B0z0dcl0wn/SignalSweep/README.md

<p align="center">
  SignalSweep: the app's Sweep, Survey and Settings tabs on a phone, a drone, a Flock probe and trackers in the live list
</p>

<p align="center">
  <strong>It beeps at the gear that's watching you.</strong><br>
  A pocket counter-surveillance scanner for cameras, body cams, drones, trackers and attack gear.<br>
  It tells you what's near by sound alone. No screen needed, no cloud, nothing to sign up for.
</p>

<p align="center">
  
  
  
</p>

<p align="center">
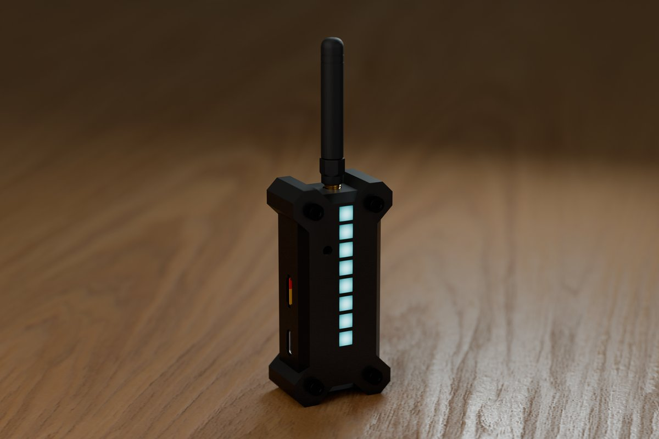
[picture p1: docs/img/hero-render.jpg]
Render of a SignalSweep in its black 3D-printed case standing on end on a wooden table, antenna up, LED bar lit cyan
  <br>
  <sub><b>Hardware</b> you carry · <b>open firmware</b> you flash from a browser · an <b>app</b> if you want one. It beeps without it.<br><i>Render from the production CAD; photos once the first batch is built.</i></sub>
</p>

> **But wait, there's more.** It decodes the drone **and where the pilot is
> standing**. It hunts a tracker by ear, beeping faster as you close in. It
> catches a fake-AirTag spam storm and **stops crying wolf**. It names your
> neighbour's pwnagotchi. And when you want it quiet, it stops advertising
> entirely, so the gear it's hunting can't hunt it back. One small board,
> flashed from a browser tab. No app store, no account, no cloud.

---

## Get one

|  | **SignalSweep** | **SignalSweep Kit** | **Build your own** |
|---|---|---|---|
| **What** | Assembled, flashed and tested, in a 3D-printed case. Plug in USB and go. | Every part plus the printed case. You put it together. | Bring a bare XIAO ESP32-C5. Flash it from your browser. |
| **Inside** | XIAO ESP32-C5, dual-band external antenna, buzzer, LED bar, microSD reader | Same parts, loose | Just the board. Add parts as you go |
| **Price** | $75 | $40 | About $13 for the board |
| **Status** | **[Reserve one](https://signalsweep.net)** | **[Reserve one](https://signalsweep.net)** | **[Available now](#build-your-own)** |

Kits and built units are at **[signalsweep.net](https://signalsweep.net)**: join the waitlist, no money down, US only for now. First batch is small.

## The app

<p align="center">
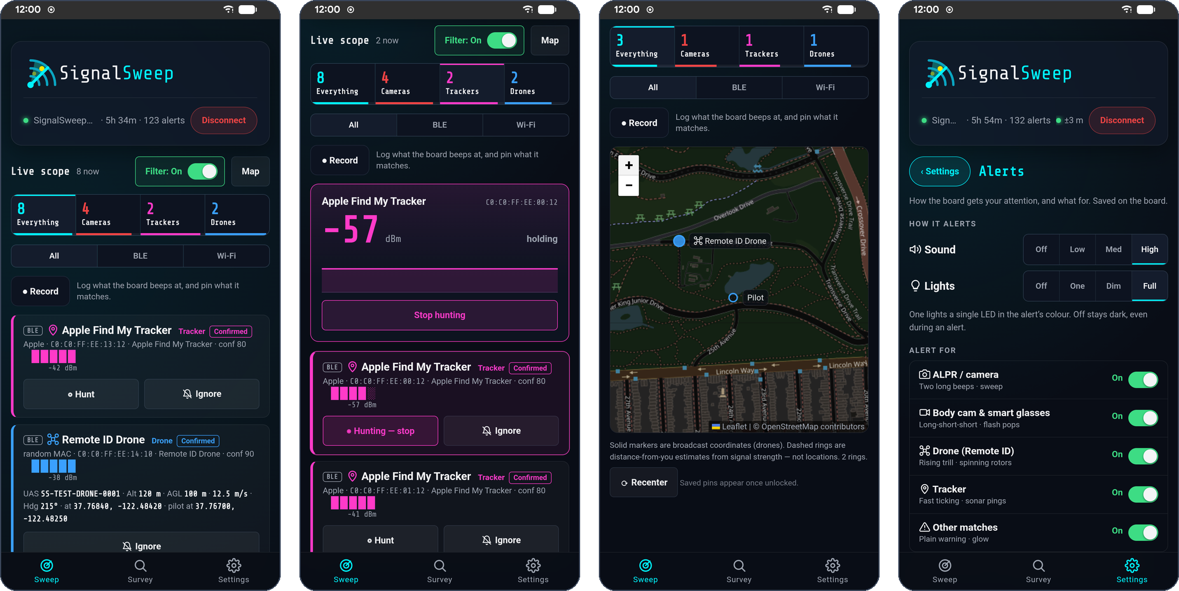
[picture p2: docs/img/strip.png]
The SignalSweep app: live scope, hunting a tracker, a drone and its pilot on the map, and the alert settings
  
</p>
<p align="center"><sub>Live scope · Hunt by ear · Drone + pilot · A sound per threat</sub></p>

One app, two ways to run it:

- **In your browser, nothing to install.** Open the
  **[web app](https://flash.signalsweep.net/app/)** in Chrome or Edge
  on a laptop or desktop and connect over Bluetooth or a USB cable.
- **On Android.** The same app as an APK, over Bluetooth or a USB cable. Grab
  it from [Releases](https://github.com/B0z0dcl0wn/SignalSweep/releases/latest)
  or let `install.py` put it on the phone.

And you don't need either one: the board beeps on its own.

## Getting started

### The fast way: flash it from your browser

<p align="center">
  
</p>

Chrome or Edge, a USB-C cable, one button. It works out which board is
plugged in (C5 or S3) and flashes the matching image. The app runs on the same
site at [`/app/`](https://flash.signalsweep.net/app/) and talks to the
board over Bluetooth, so a laptop needs nothing but the browser.

### The script: board and Android phone

```bash
git clone https://github.com/B0z0dcl0wn/SignalSweep.git
cd SignalSweep
pip install -U esptool pyserial

python install.py              # flash the board and install the app on the phone
python install.py --esp-only   # just the board
python install.py --apk-only   # just the phone
```

It downloads the latest release, checks every file's hash, asks which device if
more than one is plugged in, and makes you type the target's name back before
it writes a byte. The phone needs `adb` and USB debugging on. `--erase` wipes the board's saved settings
first, and `--help` has the rest.

## Hear it, don't read it

Every threat category has its own sound and its own light pattern, so the
device works face-down in a cupholder, a backpack or a jacket pocket.

| You hear | It means |
|---|---|
| 📷 Two long beeps | ALPR or camera |
| 🎥 Long, short, short | Body cam or smart glasses |
| 🛸 Rising trill | Drone broadcasting Remote ID |
| 📍 Fast ticking | Tracker: AirTag, Tile, SmartTag |

Mute any category you don't care about. It's still detected and listed, just quiet.

## What it does

**Detects**
- **Drones, in full.** ASTM F3411 Remote ID over Bluetooth, Wi-Fi beacons and Wi-Fi NAN: ID, altitude, speed, heading, and where the pilot is standing. Often before you hear the props.
- **Trackers.** Apple Find My, Google, Samsung and Tile. And when someone floods the area with fake ones, one row says what's going on. Tracker beeps are off out of the box, because in a crowd every passing AirTag sets it off. Turn them on in Settings > Alerts, and they stay on through a flood, because a real one hiding in the storm matters more than the noise.
- **Surveillance hardware.** Flock Safety gear when it's talking, Axon body cams, smart glasses, and anything else on a signature list you can edit from the app: OUI, company ID, name, service UUID or SSID. No recompile.
- **Cop-only gear, on sight.** Axon, Flock, SoundThinking (ShotSpotter), Genetec, Neology, WatchGuard Video and Digital Ally addresses beep on their own. Nobody but an agency buys that hardware, so hearing it is the news.
- **Attack gear** (opt-in). BLE popup spam, deauth bursts, Pineapple-style karma, Flipper Zero hints, and pwnagotchis by name.

**Built for the field**
- **Runs headless.** Battery bank, car USB port, or a phone on a cable. It scans and beeps with nothing connected.
- **Survives the plug-pull.** Mute, categories, hunt target, filter, name and rules all come back after a power cut. Yanking the cable is how you're supposed to use it.
- **Hunts by ear.** Lock one device and walk it down. The beeps speed up as you close in. Keyfob tags that advertise an alert service can be made to ring; the button only appears on those. (AirTags can't be rung by anything but their owner's phone.)
- **Both bands.** The C5 sweeps 2.4 and 5 GHz Wi-Fi, where a growing share of cameras and access points live. Every Wi-Fi row shows its band and channel, and a dual-band router is one row, not four.
- **Site Survey.** Park next to something suspicious, capture the raw air, and the app pulls out its signature. Snap a photo, and it's logged to an encrypted finds database you can export for DeFlock.
- **Ignore the neighbours.** Something you own keeps setting it off? Ignore that one device (fixed addresses only, up to 16). It stays listed, it just stops beeping, and the board remembers through a power cut.
- **Keeps a log.** What it beeped at and when, on its own flash and the SD card if one's fitted, for a drive with no phone along. You can turn it off. Never where.
- **Lights on your terms.** Off, one LED or the whole bar, three brightness levels and five themes, so a parked car doesn't glow like a beacon.

**Private by design**
- **Keeps its mouth shut.** Receive-only stops its Bluetooth advertising, so it isn't announcing itself to the gear it's hunting. It keeps listening and beeping.
- **No trail.** The app shows what's here right now and forgets it when you disconnect. Vendor names are looked up offline; no MAC ever leaves your phone.
- **Pins only when you say yes.** One device at a time, AES-GCM encrypted behind a PIN. Off by default, and detection never asks for the PIN.

## The full build

| Part | What you get |
|---|---|
| **Board** | Seeed Studio XIAO ESP32-C5 |
| **Radios** | Bluetooth LE + dual-band Wi-Fi (2.4 and 5 GHz), swept together, nonstop |
| **Antenna** | External dual-band, U.FL |
| **Alerts** | Passive buzzer (four patterns, three volumes) and an addressable LED bar |
| **Storage** | microSD for session logs and packet captures, plus an alert log on the board itself |
| **Power** | USB-C: a phone, a car port or any battery bank |
| **App** | Android (APK), or Chrome / Edge on a desktop |
| **Firmware** | Open source, GPL-3.0. Flashed and updated from a browser tab |

## What it won't do

> The only winning move is not to transmit.

No jamming. No deauth. No packet injection. No advert spoofing. No arbitrary
GATT writes. It's a receiver. Ringing a tracker is one fixed Immediate Alert
write, and its only parameter is a MAC.

No cloud, no telemetry, no accounts. The app keeps no history: what's in range
shows up, and it's wiped when you disconnect. The board logs what it beeped at
only if you switch that on, and never where. The one location anything keeps is
a pin you say yes to.

Listening to radio is legal in most places. Transmitting usually isn't, and this
barely does: a Bluetooth advert you can switch off, the scan requests that ask
nearby devices for their names, and the one write when you press Ring. Your
local law isn't everyone's. Go and read it.

---

## Build your own

### The shopping list

| Board | Hears | Price | How you flash it |
|---|---|---|---|
| Seeed Studio XIAO ESP32-C5 | 2.4 **and** 5 GHz | — | Web flasher, `install.py`, or source |
| [Seeed Studio XIAO ESP32-S3](https://www.seeedstudio.com/XIAO-ESP32S3-p-5627.html) | 2.4 GHz | ~$15 | Web flasher, `install.py`, or source |

Plus a USB-C cable. Both boards run the same detector and the same app; the C5
also sweeps the 5 GHz band, where a growing share of cameras and access points
live, and it can be told to watch one band or both.

Optional, and worth it: a **passive buzzer** and a **WS2812 LED bar** (it beeps
and blinks without them only if something else is listening). On the C5, use a
**dual-band U.FL antenna** so it hears 5 GHz as well as 2.4.
The C5 ships tuned to US Wi-Fi channels; elsewhere it still works, it just
skips channels 12–13.

Then flash it the same way as everyone else: see [Getting started](#getting-started).

## Getting your data off

The SD card stays in the case. Pull it over the cable instead: plug in, open the
[data pull page](https://flash.signalsweep.net/pull.html), hit
**Export**, pick a folder. You get `alerts.txt` (what it beeped at, readable),
`report.html` (the same, sortable), a `.pcap` per capture for Wireshark, and the
untouched originals in `raw/`. The page is one file, and its security policy
blocks all network access, so nothing leaves your machine. Don't trust hosted
pages? Same folder, no browser:

```bash
pip install pyserial
python pull.py              # same export into ./SignalSweep-<time>/
python pull.py --wipe       # then delete what copied intact (asks first)
python pull.py --phone      # also grab the app's files off the phone over adb
```

## Hardware and controls

The bare board works. A **passive buzzer** and a **WS2812 LED bar** are
add-ons — neither is required. Add a
**microSD card** and you get a richer session log (names, SSIDs, channels) and
captures started from the app over Bluetooth, no cable needed. Parts, pads
and pictures are in the **[Wiring Guide](firmware/WIRING.md)** and the
illustrated `firmware/wiring-diagram.html` page (one page, both boards).

| BOOT button | What it does |
|---|---|
| **Quick tap** | Gone quiet? Advertises for two minutes so the app can connect, then goes dark again. |
| **Hold 5 s** | Factory reset: settings and signatures wiped, then a reboot. Let go early to abort. |

## Contributing

SignalSweep is only as good as its signature list. Spotted a tracker, body cam
or ALPR it misses? Send a PR. See [CONTRIBUTING.md](CONTRIBUTING.md).

The deep end (threat model, serial protocol, building from source, and why
everything is the way it is) lives in
**[docs/README-full.md](docs/README-full.md)** and [CHANGELOG.md](CHANGELOG.md).

## Credits

- **[Colonel Panic](https://colonelpanic.tech)**: the
  [OUI Spy Unified Blue](https://github.com/colonelpanichacks/oui-spy-unified-blue)
  concept this hardware approach came from.
- **[OrdoOuroborous / @NitekryDPaul](https://github.com/nitekry)**: the Flock
  Safety OUI research the camera detection runs on.

Everyone else is in [CREDITS.md](CREDITS.md).

GPL-3.0-or-later. See [LICENSE](LICENSE). Some vendored components are Apache-2.0.

*Hack the planet.*
