B0z0dcl0wn/SignalSweep/docs/img/hero-pumpkin.jpg

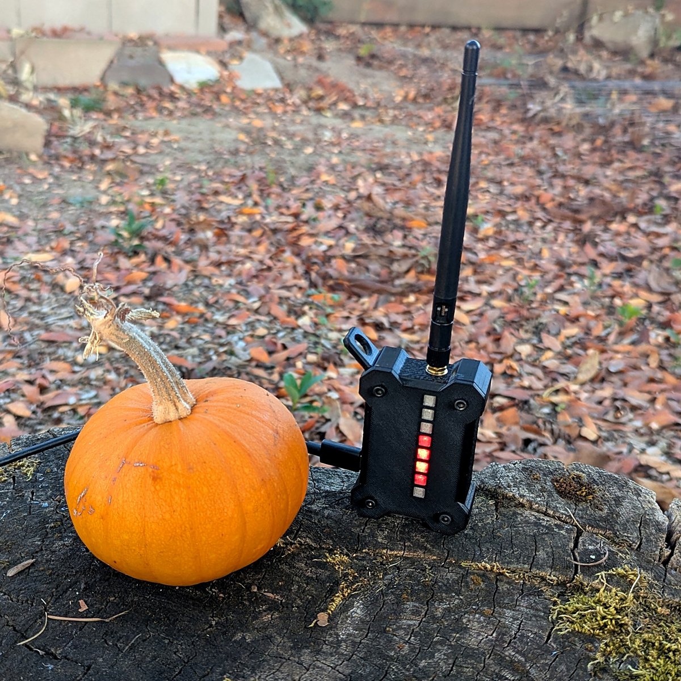
docs/img/hero-pumpkin.jpg
