B0z0dcl0wn/SignalSweep/hardware/case-v3/case-main.stl

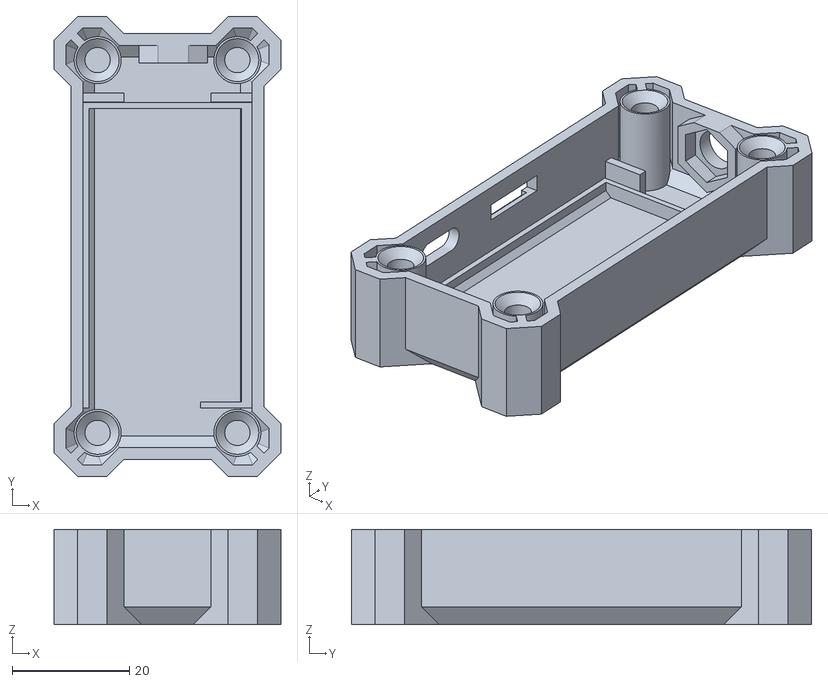
[picture p4: CAD file, 2026-11-04]
hardware/case-v3/case-main.stl
38.7 x 78.4 x 16.2
