B0z0dcl0wn/SignalSweep/hardware/case-v3/case-diffuser-57.stl

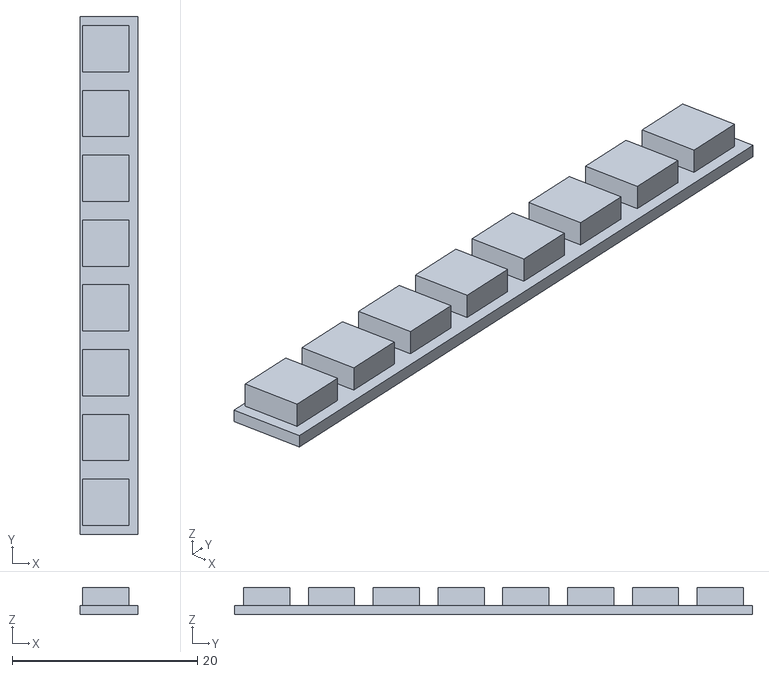
[picture p5: CAD file, 2026-11-13]
hardware/case-v3/case-diffuser-57.stl
6.30 x 56.0 x 2.95
