B0z0dcl0wn/SignalSweep/hardware/case-v3/case-lid-54.stl

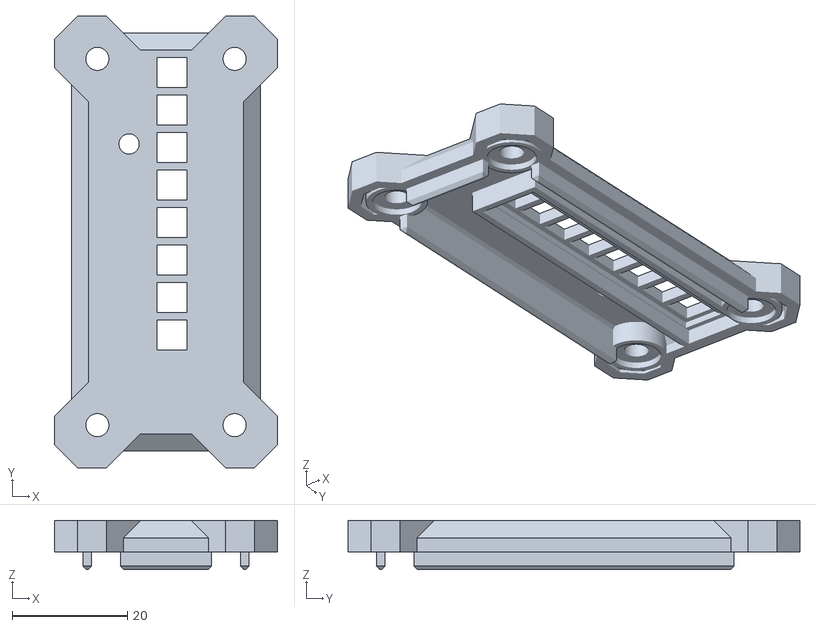
[picture p6: CAD file, 2026-11-13]
hardware/case-v3/case-lid-54.stl
38.7 x 78.4 x 8.50
