B0z0dcl0wn/SignalSweep/hardware/case-v1/Base.stl

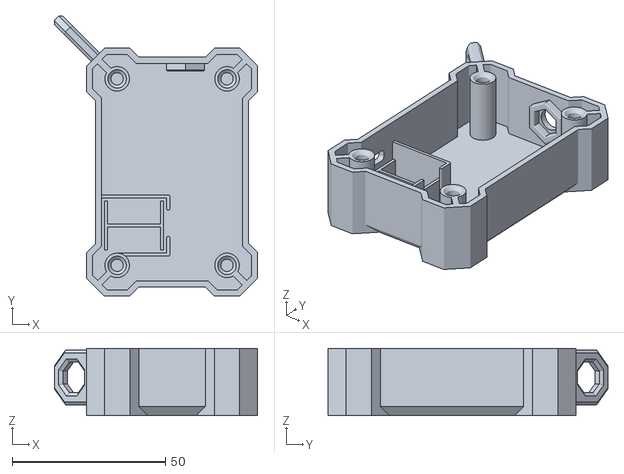
[picture p8: CAD file, 2026-10-17, an earlier design]
hardware/case-v1/Base.stl
66.4 x 91.4 x 22.0
