B0z0dcl0wn/SignalSweep/hardware/case-v1/LED Diffuser.stl

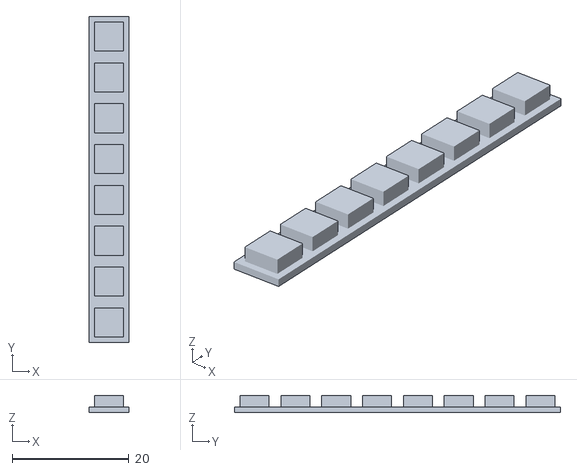
[picture p9: CAD file, 2026-10-17, an earlier design]
hardware/case-v1/LED Diffuser.stl
6.90 x 55.9 x 3.00
