B0z0dcl0wn/SignalSweep/hardware/case-v1/Lid.stl

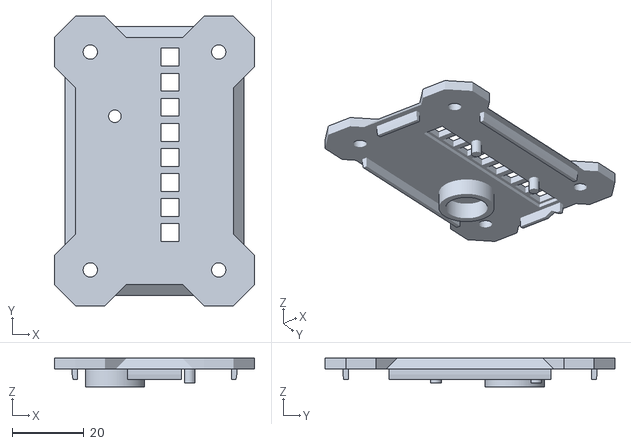
[picture p10: CAD file, 2026-10-17, an earlier design]
hardware/case-v1/Lid.stl
55.9 x 80.9 x 8.00
