B0z0dcl0wn/SignalSweep/firmware/wiring-diagram.html

SignalSweep · Hardware

# Wiring the detector

All you need is the board. A bare XIAO ESP32-S3 or ESP32-C5 with its U.FL antenna is a working detector: plug it into USB, connect the app, and it streams everything it hears. The buzzer, the LED bar and the microSD reader are optional add-ons. Both boards use the same pads and the same harness; only the GPIO numbers underneath differ, and the pin map lists both.

Seeed XIAO ESP32-S3 / ESP32-C5 · LED D1 · Buzzer D2 · microSD CS D3, MOSI D10, CLK D8, MISO D9

## Parts

Part | Needed? | What it adds | Without it
XIAO ESP32-S3 or ESP32-C5 + U.FL antenna (C5: dual-band) | REQUIRED | the detector | —
Passive buzzer | OPTIONAL | the headless "what is near" beep patterns, and Hunt's beeps | phone only
WS2812 8-LED bar | OPTIONAL | colour/animation per category, the hunt meter | phone only
microSD reader (3.3 V, 6 pins, no regulator) | OPTIONAL | a session log per boot and Site Survey captures on a card, started from the app | —
XIAO ESP32-C5 instead of the S3 | OPTIONAL | hears 5 GHz Wi-Fi too (same harness) | 2.4 GHz only

## Schematic

### Reading your board D# = GPIO#

- Seeed silk-screens the pads D0–D10; the firmware names the same pads by GPIO number. Wire by pad name and one harness fits both the S3 and the C5. The pin map below gives each pad's GPIO on both boards.
- One long edge has D0–D6; the other has 5V, GND, 3V3, D10, D9, D8, D7, with the power group next to the USB. The pad printed VUSB on the underside is the same 5V.

← scroll the drawing sideways →

Top view, USB-C up. Each XIAO pad carries one wire. Ground goes to the LED bar first; the buzzer − shares that bar pad, and the SD reader's ground comes off the bar's other GND pad. The SD reader's pins are drawn in the order printed on it.

5V · red5V pad → bar VCC

GND · blackXIAO → bar GND → SD GND

3V3 · white3V3 pad → SD 3v3 only

LED DATA · yellowD1 → bar IN

BUZZER · greenD2 → buzzer +

SD CS · blueD3 → SD CS

MOSI · yellowD10 → SD MOSI

CLK · greenD8 → SD CLK

MISO · blueSD MISO → D9

### ⚠ microSD reader: 3.3 V ONLY

Never connect this board to 5V. It has no regulator, and 5V can kill the card. Its 3v3 pin goes to the XIAO's 3V3 pad and nothing else.

## Power and ground

GND XIAO GND→bar GND pad 1═bar GND pad 2→SD GND The buzzer − also goes on bar GND pad 1, next to the wire from the XIAO. A bar pad is big enough for two wires; a XIAO pad is not. This assumes the common 4-pad bar (GND, IN, VCC, GND), whose two GND pads are joined on the bar. A 3-pad bar has one GND pad, which would need all three ground wires. No bar at all? Splice the buzzer − and SD GND wires together (solder + heat-shrink) and run one wire from the splice to the XIAO GND pad.

3V3 XIAO 3V3→SD 3v3 One wire. The SD reader is the only thing on 3V3.

5V XIAO 5V→LED bar VCC One wire. The LED bar is the only thing on 5V. Nothing on the SD reader goes to 5V.

→a wire you add═already joined inside the part. Skip any part you don't have.

## Pin map

XIAO pad | S3 | C5 | Net | Goes to | Part
D1 | GPIO2 | GPIO0 | Data | LED bar DIN (IN) | LED bar
D2 | GPIO3 | GPIO25 | Signal | buzzer + | buzzer
D3 | GPIO4 | GPIO7 | SPI chip select | SD CS | SD reader
D8 | GPIO7 | GPIO8 | SPI clock | SD CLK | SD reader
D9 | GPIO8 | GPIO9 | SPI MISO | from SD MISO (data into the XIAO) | SD reader
D10 | GPIO9 | GPIO10 | SPI MOSI | SD MOSI | SD reader
5V VUSB | — | — | Power | LED bar VCC | power
3V3 | — | — | Power | SD 3v3, the only 3V3 load | power
GND | — | — | Ground | LED bar GND pad 1 (buzzer − and SD GND continue from the bar) | power
BOOT | GPIO0 | GPIO28 | built in | tap = 2-minute advertising window · hold 5 s = factory reset | on the board

## Assembly

1. One wire per XIAO pad. The XIAO's holes are tiny: two wires shoved into one is how a joint cracks. So each XIAO pad gets exactly one wire. Where two wires have to meet (ground), they meet on a bigger LED-bar pad, never on the XIAO. Skip any part you don't have.
2. Antenna. Press the U.FL antenna onto the XIAO's small antenna socket until it clicks. No soldering. C5: use a dual-band antenna; the stock 2.4 GHz one throws away the 5 GHz the C5 is for.
3. LED bar (optional). Wire the IN end: the little arrows printed on the bar point away from it.
  - LED bar pad VCC → XIAO pad 5V
  - LED bar GND pad 1 (the GND beside IN) → XIAO pad GND
  - LED bar pad IN → XIAO pad D1.
4. Buzzer (optional). A small passive buzzer (<30 mA) runs straight off the pin.
  - Buzzer + → XIAO pad D2
  - Buzzer − → LED bar GND pad 1, next to the XIAO's ground wire (a bar pad takes two wires).
5. SD reader power (optional). 3.3 V ONLY. Never connect this board to 5V: it has no regulator and 5V can kill the card.
  - SD reader pin 3v3 → XIAO pad 3V3 (not 5V)
  - SD reader pin GND → LED bar GND pad 2 (the GND at the far end, beside VCC).
6. SD reader data (optional). Four wires, each to its own XIAO pad. Match by the label printed on the reader.
  - SD reader pin CS → XIAO pad D3
  - SD reader pin MOSI → XIAO pad D10
  - SD reader pin CLK → XIAO pad D8
  - SD reader pin MISO → XIAO pad D9: data comes back from the card on this one

Format the card FAT32; the board keeps its files in /SIGSWEEP/.

7. Check before you power it. Nothing on the SD reader touches 5V: follow its 3v3 wire and make sure it ends on the XIAO's 3V3 pad. Then count: one wire in each XIAO pad, and no stray strands bridging two pads.
8. Verify. Flash from the web flasher, or python flash.py --port COM3 (C5: python flash.py --board c5 --port COM5). On boot you get a short jingle and an LED blink (if fitted). Connect the app: Settings › Device identity › Clock shows the phone synced the time. Then trigger a match (an AirTag near it, or edit a signature): the bar flashes and the buzzer plays that category's pattern — ALPR / camera two long beeps, body cam long-short-short, drone a rising trill, tracker fast ticking.

## Watch for

### Power budget ≈480 mA

- 8× WS2812 at full white peaks near 480 mA. SignalSweep only flashes short colored bursts, so USB 5V is fine.
- An SD card adds a few mA idle and roughly 100 mA peaks on writes, all from the XIAO's 3V3. On a weak battery, budget for that.

### Gotchas clones

- SD reader on 5V kills the card. This reader has no regulator: 3V3 only.
- Other SD readers put their pins in a different order, and some want 5V (they have a regulator on board). The drawing is for the 6-pin 3v3, CS, MOSI, CLK, MISO, GND reader; with any other, match by label and check its power pin's marking.
- 3.3 V data into a 5 V-powered clone bar works over the short run to the bar. Keep the DIN wire short.
- Wrong end (wiring DOUT) lights nothing — flip to DIN.
- Active buzzer = one fixed pitch: you'll hear each pattern's rhythm but not its tones. Passive is the intended part.
- Two wires in one XIAO pad is how a joint cracks. Double up on a bar pad instead.
- C5: boots fine with the buzzer on D2. GPIO25 is sampled at power-up, but a passive buzzer straight to GND does not stop the XIAO C5 booting (bench-checked 2026-09-16 with the LED bar and buzzer wired as shown).
