B0z0dcl0wn/SignalSweep/firmware/wiring-diagram-c5.html

SignalSweep · Hardware

# Wiring the C5 detector

All you need is the board. A bare XIAO ESP32-C5 with its dual-band U.FL antenna is a working detector: plug it into USB, connect the app, and it streams everything it hears. The buzzer, the LED bar and the microSD reader are optional add-ons. The microSD wiring is final, but firmware support is coming: the board does not use the card yet.

Seeed XIAO ESP32-C5 · LED D1 / GPIO0 · Buzzer D2 / GPIO25 · microSD CS D3, MOSI D10, CLK D8, MISO D9

## Parts

Part | Needed? | What it adds | Without it
XIAO ESP32-C5 + dual-band U.FL antenna | REQUIRED | the detector | —
Passive buzzer | OPTIONAL | the headless "what is near" beep patterns, and Hunt's beeps | phone only
WS2812 8-LED bar | OPTIONAL | colour/animation per category, the hunt meter | phone only
microSD reader (3.3 V, 6 pins, no regulator) | OPTIONAL FIRMWARE SUPPORT COMING | (coming) alert log and Site Survey captures on a card | —
DS3231 clock module | OPTIONAL | not fitted on this build | the phone or PC sets the time at each connect

## Schematic

### Reading your board D# = GPIO#

- Seeed silk-screens the pads D0–D10; the firmware names the same pads by GPIO number. Wire by pad name and one harness fits both the S3 and the C5. On this board: D1 = GPIO0, D2 = GPIO25, D3 = GPIO7, D4 = GPIO23, D5 = GPIO24, D8 = GPIO8, D9 = GPIO9, D10 = GPIO10.
- One long edge has D0–D6; the other has 5V, GND, 3V3, D10, D9, D8, D7, with the power group next to the USB. The pad printed VUSB on the underside is the same 5V.

← scroll the drawing sideways →

Top view, USB-C up. Each XIAO pad carries one wire. Ground goes to the LED bar first; the buzzer − shares that bar pad, and the SD reader's ground comes off the bar's other GND pad. The SD reader's pins are drawn in the order printed on it.

5V5V pad → bar VCC

GNDXIAO → bar GND → SD GND

3V33V3 pad → SD 3v3 only

DATAD1 → bar IN

BUZZERD2 → buzzer +

CSD3 → SD CS

SPID10 → MOSI · D8 → CLK · MISO → D9

### ⚠ microSD reader: 3.3 V ONLY

Never connect this board to 5V. It has no regulator, and 5V can kill the card. Its 3v3 pin goes to the XIAO's 3V3 pad and nothing else.

### Optional clock (DS3231), not fitted parked

The phone or PC sets the time on every connect, which dates the log. D4 (SDA) / D5 (SCL) are reserved for it; leave them empty. See WIRING.md.

## Power and ground

GND XIAO GND→bar GND pad 1═bar GND pad 2→SD GND The buzzer − also goes on bar GND pad 1, next to the wire from the XIAO. A bar pad is big enough for two wires; a XIAO pad is not. This assumes the common 4-pad bar (GND, IN, VCC, GND), whose two GND pads are joined on the bar. A 3-pad bar has one GND pad, which would need all three ground wires. No bar at all? Splice the buzzer − and SD GND wires together (solder + heat-shrink) and run one wire from the splice to the XIAO GND pad.

3V3 XIAO 3V3→SD 3v3 One wire. The SD reader is the only thing on 3V3.

5V XIAO 5V→LED bar VCC One wire. The LED bar is the only thing on 5V. Nothing on the SD reader goes to 5V.

→a wire you add═already joined inside the part. Skip any part you don't have.

## Pin map

XIAO pad | Net | Goes to | Part
D1 GPIO0 | Data | LED bar DIN (IN) | LED bar
D2 GPIO25 | Signal | buzzer + | buzzer
D3 GPIO7 | SPI chip select | SD CS | SD reader
D4 GPIO23 | (I²C SDA) | nothing: reserved for the clock | not fitted
D5 GPIO24 | (I²C SCL) | nothing: reserved for the clock | not fitted
D8 GPIO8 | SPI clock | SD CLK | SD reader
D9 GPIO9 | SPI MISO | from SD MISO (data into the XIAO) | SD reader
D10 GPIO10 | SPI MOSI | SD MOSI | SD reader
5V VUSB | Power | LED bar VCC | power
3V3 | Power | SD 3v3, the only 3V3 load | power
GND | Ground | LED bar GND pad 1 (buzzer − and SD GND continue from the bar) | power
BOOT GPIO28 | built in | tap = 2-minute advertising window · hold 5 s = factory reset | on the board

## Assembly

1. One wire per XIAO pad. The XIAO's holes are tiny: two wires shoved into one is how a joint cracks. So each XIAO pad gets exactly one wire. Where two wires have to meet (ground), they meet on a bigger LED-bar pad, never on the XIAO. Skip any part you don't have.
2. Antenna. Swap the stock 2.4 GHz antenna for a dual-band U.FL one and press it onto the XIAO's antenna socket until it clicks. The C5's whole point is 5 GHz; the one in the box throws it away.
3. LED bar (optional). Wire the IN end: the little arrows printed on the bar point away from it.
  - LED bar pad VCC → XIAO pad 5V
  - LED bar GND pad 1 (the GND beside IN) → XIAO pad GND
  - LED bar pad IN → XIAO pad D1 (GPIO0). Optional: a 330–470 Ω resistor in this wire, right at the bar.
4. Buzzer (optional). A small passive buzzer (<30 mA) runs straight off the pin.
  - Buzzer + → XIAO pad D2 (GPIO25)
  - Buzzer − → LED bar GND pad 1, next to the XIAO's ground wire (a bar pad takes two wires).
5. SD reader power (optional). 3.3 V ONLY. Never connect this board to 5V: it has no regulator and 5V can kill the card.
  - SD reader pin 3v3 → XIAO pad 3V3 (not 5V)
  - SD reader pin GND → LED bar GND pad 2 (the GND at the far end, beside VCC).
6. SD reader data (optional). Four wires, each to its own XIAO pad. Match by the label printed on the reader.
  - SD reader pin CS → XIAO pad D3 (GPIO7)
  - SD reader pin MOSI → XIAO pad D10 (GPIO10)
  - SD reader pin CLK → XIAO pad D8 (GPIO8)
  - SD reader pin MISO → XIAO pad D9 (GPIO9): data comes back from the card on this one

The wiring is final; the firmware does not drive the card yet (support is coming), so a card in the slot does nothing for now. On the C5: if it won't start with the SD reader connected, unplug the CS wire (D3), power up, and tell us.

7. Check before you power it. Nothing on the SD reader touches 5V: follow its 3v3 wire and make sure it ends on the XIAO's 3V3 pad. Then count: one wire in each XIAO pad, no stray strands bridging two pads, and D4 / D5 left empty.
8. Verify. Flash from the web flasher, or python flash.py --board c5 --port COM5. On boot you get a short jingle and an LED blink (if fitted). With no clock fitted the serial log says [RTC] none fitted, waiting for a host, which is expected. Connect the app: Settings › Device identity › Clock shows the phone synced the time. Then trigger a match (an AirTag near it, or edit a signature): the bar flashes and the buzzer plays that category's pattern — ALPR / camera two long beeps, body cam long-short-short, drone a rising trill, tracker fast ticking. BOOT (GPIO28) is the onboard button: tap for a 2-minute advertising window, hold 5 s to factory-reset.

## Watch for

### Power budget ≈480 mA

- 8× WS2812 at full white peaks near 480 mA. SignalSweep only flashes short colored bursts, so USB 5V is fine.
- Add a 1000 µF cap across the bar's 5V↔GND to absorb inrush when all eight snap on.
- An SD card adds a few mA idle and roughly 100 mA peaks on writes, all from the XIAO's 3V3. On a weak battery, budget for that.

### Gotchas clones

- SD reader on 5V kills the card. This reader has no regulator: 3V3 only.
- Other SD readers put their pins in a different order, and some want 5V (they have a regulator on board). The drawing is for the 6-pin 3v3, CS, MOSI, CLK, MISO, GND reader; with any other, match by label and check its power pin's marking.
- 3.3 V data into a 5 V-powered clone bar usually works; if LED 1 flickers, add the 330–470 Ω series resistor at DIN.
- Wrong end (wiring DOUT) lights nothing — flip to DIN.
- Active buzzer = one fixed pitch: you'll hear each pattern's rhythm but not its tones. Passive is the intended part.
- Two wires in one XIAO pad is how a joint cracks. Double up on a bar pad instead.
- Boots fine with the buzzer on D2. GPIO25 is sampled at power-up, but a passive buzzer straight to GND does not stop the XIAO C5 booting (bench-checked 2026-09-16 with the LED bar and buzzer wired as shown). If a different buzzer ever does, feed it through a small NPN transistor or a 100 Ω+ series resistor.
- D3 (GPIO7) and the SD reader: not bench-checked yet. GPIO7 may be sampled at boot, and nobody has booted a C5 with the SD reader wired yet. If the C5 won't start with the SD reader connected, unplug the CS wire (D3), power up, and tell us.
