B0z0dcl0wn/SignalSweep/CHANGELOG.md

# Changelog

All notable changes to SignalSweep are recorded here.

## [Unreleased]

## [0.12.0] — 2026-11-12 — Dimmer switch

### Changed -- Signatures v23: a smartwatch is not a TASER, and fe6c needs a serial

From the 2026-11-09 upstream scan. Boards pick the new rules up on their next
boot.

**Fixes**

- **TASER company ID `0x034D` no longer flags cheap smartwatches.** IDO /
  VeryFit watches (IDW26, ID205...) send `0x034D` with their own address as the
  first six payload bytes, plus service `0x0AF0`, and the rule beeped at 70 on
  the ID alone. The matcher now drops a `0x034D` hit when the payload repeats
  the advertiser's address and the watch's `0x0AF0` service or an
  `ID<digits>` model name is present. Everything else keeps the 70. The check
  is a port of RF Sentinel's `isTaserIdSquatter()` (CIS-C0/RFSentinel 843c738,
  `SignatureEngine.kt:195-229`, GPL-3.0). It lives in `firmware/src/axon_checks.h`
  and is host-tested with their `DetectionTest.kt:56` watch ("IDW26" at
  `F4:FD:16:03:54:5B`) in `firmware/test/axon_checks_test.cpp`, which
  `selftest.js` runs. Because the check sits in the matcher, it also covers a
  pushed `0x034D` rule.
- **Axon `fe6c` beeps only on a serial.** "Axon Signal System" beeped on the bare
  UUID, which any phone app can advertise. The bare UUID now lists at 60, as
  "Axon service UUID (fe6c)". Only `fe6c` service data that carries an ASCII
  serial (a run of six or more uppercase letters and digits, the Signal trigger
  layout) beeps, as "Axon Signal trigger (fe6c serial)" at 70. AxonCadabra
  replays one captured trigger byte for byte, serial `X87002FP4`, so that serial
  is excluded explicitly: no Axon rule names it. With Attack on, it is reported
  as Hacking gear, "AxonCadabra (replayed Axon Signal)". The payload layout and
  the replay serial come from OVERWATCH (KaraZajac/OVERWATCH, BSD-3,
  `AxonSignatures.kt` and `HackerTargets.kt`).
- **`90:3A:E6` is Parrot, not ASTM.** The Wi-Fi Remote ID comment had the two
  OUIs backwards. `FA:0B:BC` is the ASD-STAN / ASTM OUI (as `odid_wifi.c`
  says), and `90:3A:E6` is Parrot's MA-L. The Parrot branch now also requires
  the Remote ID vendor type `0x0D`, so an unrelated Parrot vendor IE no longer
  scores as a drone. The Remote ID entry further down this file is corrected
  to match.

**Added**

- **Raven** `3101` and `3102` join the exact-match Raven UUID list at 60 (RF
  Sentinel 843c738 `SignatureEngine.kt:73`, GPL-3.0, crediting an
  all-cameras-are-beacons field capture).

**Reviewed and not added.** RF Sentinel ships about 110 more MAC prefixes we
lack: ALPR makers (Tattile, Quercus, Selea, Vitronic, Robot), police in-car
video, TETRA / P25 makers, tactical mesh radios, fleet gear, and more blocks
for vendors we already list. Every sub-block was re-checked against the IEEE
`mam.csv`, `oui36.csv` and `iab.csv`, and every one is registered to the vendor
it names. That proves who owns the block, not that the gear transmits Wi-Fi or
BLE, or that anyone has heard it. None has a field sighting. RF Sentinel itself
tags many of them "candidate". Most of the hardware is wired, or talks on its
own radio band, and Tattile alone is 48 blocks, several from the 1990s. A rule
set 60% larger, matched against every advert, for rules that would likely never
fire is the wrong trade, and a registry entry is not a detection. Any of them
can come back with a sighting.

Also not in v23: the Axon Fleet `axon<n>-5g` SSID and Meta `0x058E` +
`META_RB_GLASS` (both wait for a field capture); Cellebrite, GrayKey and
IMSI-catcher makers (skipped); the DJI DroneID IE `26:37:12`, the French
`6A:5C:35` beacon and the GhostLink BLE UUID (planned for v24).

**Bench-proven over the air** on the C5, from a Kali Pi sending crafted raw
HCI adverts and injected beacons, each case on its own address so a ratcheted
rule name can't leak between cases. Checked against the board's own alert log,
not just the counter. All ten came out as intended: the IDO-watch squatter
lists with no rule and logs nothing, while the same own-address payload without
a watch tell still beeps at 70 (the tell is load-bearing). A bare `fe6c` lists at
60, a serial beeps (100, Confirmed), and `X87002FP4` is silent with Attack off
and Hacking gear with it on. Parrot `90:3A:E6` decodes as a drone with type
`0x0D` and lists as nothing with `0x0E`, and the ASTM `FA:0B:BC` control still
decodes. Pushes stayed at 74 in 75 s.

### Changed -- Case v3 lids are named by LED stick length

- **`case-lid.stl` and `case-diffuser.stl` are now `case-lid-54` and
  `case-diffuser-54`, and a `-57` pair joins them.** Generic 8-LED WS2812
  sticks have no standard outline: three batches gave three boards (57 x 10.5
  at 7 mm pitch, 54 x 10 at 6.5 mm, and now 57.25 x 10.5 at 7 mm with the LEDs
  2.75 mm from the edge). Measure the stick you have and print the lid and
  diffuser that match its length; `case-main.stl` is unchanged (byte for byte)
  and takes either lid. A single lid for both was rejected because it would
  cost the diffuser its separator bars. The 57 pocket is 0.2 mm tighter than
  the 54's, after a jig printed with the 54's gaps came out loose on that stick.
  On the 57 the LEDs sit so close to the board edge that the diffuser's base
  is trimmed on that side (2.8 mm from the LED line, not 3.5) and the lid's
  slot stops flush with the pocket wall: the diffuser drops in through the
  stick pocket, and a full-width slot there would be an undercut that traps it.
- **The tube under the lid's buzzer hole is gone from both lids.** It made no
  audible difference; the hole through the top skin stays.

### Added -- The v3 case STLs

- **`hardware/case-v3/`** ships the printable case for the carrier v3 board
  (main body, lid, clear LED diffuser), next to the v1 case. Only the three
  STLs are published; the parametric source stays local. The body's corner
  posts take M3 heat-set inserts in a 4.3 mm bore, 10 mm deep, which seats them
  straight; close the lid with M3x10 screws (an M3x8 bites only ~2.5 mm). Print
  the lid top-down so it needs no supports. A short tube under the lid carries
  the buzzer to its hole, and the microSD slot is 2.8 mm tall so a card comes
  out by fingernail.

### Added -- Signatures v22: Fusus, a second Cradlepoint block, Luxottica Tristar

From the 2026-11-02 upstream review, every prefix checked against the IEEE
registry.

- **Fusus** `84:b3:86:5` and `7c:83:34:4` beep at 70 and sit under the Cameras
  tab. Fusus hubs feed real-time crime centers and no consumer owns one, the
  same test as Axon and SoundThinking. From OVERWATCH, which notes these are
  registry entries with no field sighting yet. Both are MA-M sub-blocks, so
  they match on nine hex digits only: the rest of each /24 belongs to others.
- **Cradlepoint** `00:e0:1c`, the second block registered to CradlePoint (via
  ouispy-detector), at the same weight as `00:30:44`.
- **Luxottica Tristar** `80:aa:1c` and `38:47:12`, the factory behind Ray-Ban /
  Oakley Meta glasses (via ouispy-detector), list at 60 under Smart glasses.
  The address proves the maker, not the product, so the rule says "device".

### Changed -- Brightness is its own setting

Lights was Off / One / Dim / Full, so how bright the bar was came bundled with
how much of it lit. Lights is now Off / One / Bar, and Brightness is a separate
row: Low (8/255, the old Dim), Med (20) and High (50, the old Full). Brightness
applies to every Lights option, One included; Night Ops still holds the bar at
Low, except under One. Because One now follows brightness, an old app that
picks Dim and then One gets a dim single LED, which it has no way to show.
With Night Ops and Lights on Bar, the note under Theme says the bar is held at
Low (at Dim on firmware with no `bri`), and on firmware with no `bri` the Lights
description names Dim and Full instead of Bar.
Requested in B0z0dcl0wn/SignalSweep#5.

Wire contract: `{"bri":0..2}` sets brightness only and is answered with
`CMD:CFG`. `{"led":2}` is Bar + Low and `{"led":3}` is Bar + High, so old apps'
Dim and Full act as before; `{"led":4}` is Bar at the current brightness, which
is what the new app sends (old firmware clamps it to Full). The reported `led`
stays 0..3 for old apps (Bar reports 2 at Low, 3 otherwise), and `bri` joins
`CMD:CFG` and the 1 Hz push (~8 B). The app shows the old four Lights buttons
and no Brightness row when the board reports no `bri`.

Persistence: new NVS key `bri` in `sweep-bz`, written with every Lights or
Brightness change; `led` stores Bar as 3. A board with no `bri` key loads a
stored Dim (2) as Bar + Low and Full (3) as Bar + High. `selftest.js` checks
that there are three levels and three Brightness buttons, and that the app
adopts `bri` from both frames.

Bench, both boards over a real Bluetooth link (2026-11-12): 14 of 14 `led`/`bri`
commands read back correctly from `CMD:CFG`, 60 of 60 pushes in a 60 s soak with
none torn, and no reboot. A board flashed over the old firmware loaded a stored
Dim as Bar + Low (S3) and a stored Full as Bar + High (C5), and Bar + Med and
One + Low both survived a reboot on the S3. On the bar, One looks much the same
at all three levels.

## [0.11.0] — 2026-10-30 — Quiet about trackers

### Changed -- A new board stays quiet about trackers and always keeps a log

Tracker beeps are now off on a new or factory-reset board (`beep_mask` default
`0x17`); turn them on in Settings > Alerts. In a crowd every passing AirTag
beeps, which is more noise than signal. Trackers are still detected
and listed, and the tag flood row goes quiet with them.

The flash alert log is now on by default. A new board with no SD card and no
Record tap used to record nothing, however much it beeped. It still logs only
what actually sounded, so a muted tracker leaves no record. A board that has
already saved its settings keeps them.

## [0.10.3] — 2026-10-27 — New address, same beeps

### Fixed -- The flasher showed version 0.9.1 between releases

The version ESP Web Tools shows in the install prompt was stamped into
`manifest.json` only on tagged releases. Every push to `main` republishes the
flasher with freshly built firmware, but kept the hand-typed version in
`site/manifest.json`, which had gone stale at 0.9.1, so the newest firmware
was offered as the oldest. CI now stamps `git describe --tags` on every run
(the checkout fetches tags for it): a release reads `0.10.3`, a build between
releases reads `0.10.2-9-g2a2965a`.

### Changed -- The flasher moves to flash.signalsweep.net

The web flasher and hosted app now live at `flash.signalsweep.net`, and the
landing page points hardware buyers at `signalsweep.net`. `site/assemble.sh`
writes the `CNAME` file into `_site/` on every build. The trap it avoids:
`gh-pages` is force-pushed each release, so a custom domain set only in the
repository settings would be wiped by the next push and the flasher would fall
back to the github.io address. GitHub redirects the old
`b0z0dcl0wn.github.io/SignalSweep/` links, so existing bookmarks and installer
copies keep working. What the redirect cannot carry is browser storage: it
belongs to the address, so pins, pin-prompt choices and the paired device saved
in the hosted web app stayed behind at github.io, where they can no longer be
reached, and Bluetooth must be paired again. The Android app is unaffected. The
README and the flasher header now link the kit and
built-unit waitlist at `signalsweep.net`.

### Changed -- Signatures v21: two more speed-camera makers, and the Flipper's colour

Sensys Traffic (`00:22:9f`, now Sensys Gatso) and Gatsometer (`00:18:29`)
make speed and red-light cameras and nothing a consumer buys, so both beep
and file under Cameras, like Redflex. Both prefixes are checked against the
IEEE registry; Sensys Traffic is not Sensys Networks, the US road-sensor
maker. Found reviewing RocketGod's wardrive-go. Boards pick them up on their
next boot.

A Flipper Zero advertises one service UUID per case colour, so its row now
says which: "Flipper Zero (black)" for `3081`, "(white)" for `3082`,
"(transparent)" for `3083` (Wall of Flippers and wardrive-go agree on the
mapping). Still Attack-only, still 80.

### Changed -- the app says when a card needs to be FAT32

A 64 GB card fresh from Windows reported plain "No card" on the first carrier
board. Windows formats anything over 32 GB as exFAT, and both Arduino cores
ship FatFs precompiled with `FF_FS_EXFAT 0` hard-coded in `ffconf.h`, so an
exFAT card fails the mount exactly like an empty slot. The board cannot tell
the two apart, so the Settings card status now says it: the card must be
FAT32, and cards over 32 GB come exFAT. Real exFAT support needs a rebuilt
framework or a different SD library, so reformat big cards FAT32 (guiformat
or the SD Association formatter) for now.

## [0.10.2] — 2026-10-21 — Out of sight, off the list

### Fixed -- the list let go of nothing you drove away from

Half a mile and five minutes past a "camera", it still sat near the top of the
list at the signal it had beside the car. The board reported every device it
was tracking until it pruned it at 2 minutes, carrying the last RSSI it heard,
and the app stamped each report "seen now", so its 8-second fade never fired.
Now the board stops reporting a device 30 seconds after it last heard it
(tracking still runs to 2 minutes, so a drive-by still beeps once) and sends
`age`, seconds since last heard, on anything older than 2 seconds. The app dates
each row from that: after 8 seconds a row dims, says "12 s ago" and sinks below
what is around you now, and at 30 seconds it is gone. The hunted row never
fades. Bench, C5 with the filter off: 61 devices over 50 s, oldest report 29 s.
`selftest.js` pins both halves.

### Changed -- Signatures v20: Flock name rules list instead of beeping

Hunting for more bugs like the driveway "Iteris" turned up the same flaw in
the Bluetooth name rules: `flock`, `pigvision` and `fs_` matched anywhere in a
device name and beeped on their own as an ALPR. `fs_` is three letters (the
Wi-Fi SSID path already learned that from a network called "Chiefs_Guest"), and
anyone can name a speaker "Flocker". Flock's Bluetooth names went quiet in
spring 2026, so the rules were all risk. `fs_` is gone (the `FS-<hex>` detector
from v18 covers the real form) and the other two list at 60 without beeping.
The bench emitter's Flock persona now lists rather than beeps.

### Fixed -- Bluetooth prefix rules matched random addresses

A car pulling out of a driveway beeped "ALPR": the C5 matched the Iteris
roadside-sensor prefix `00:14:7b` on a Bluetooth device at -60 dBm with no name
and no company ID, and it was gone on the way home. Bluetooth addresses are
mostly random, and a random address can start with any vendor's prefix by
chance, so every prefix rule (Axon, Flock, the police vendors) could do this.
Prefix rules now match public Bluetooth addresses only, the same rule the app's
vendor lookup already followed. Wi-Fi was never affected: a randomized Wi-Fi
address sets a bit no registered prefix has. Rules that match a company ID,
name or UUID are unchanged. `selftest.js` fails if the check goes.

### Changed -- Signatures v19: police gear from fourteen more projects

A second review, this time of fourteen detectors and attack tools we had not
watched before (alpr_detector, all-cameras-are-beacons, FlipDeFlock,
OVERWATCH, Flock-You, AirGuard, Bruce, GhostESP and others). Every MAC prefix
was checked against the IEEE's full registry, including the small MA-M, MA-S
and IAB sub-blocks most police vendors use, and every 16-bit UUID against the
Bluetooth SIG's member list. Boards pick the new defaults up on their next boot.

- **Removed `fe6d`.** We had it as an Axon UUID; the SIG registers it to the
  University of Tokyo. Axon keeps `fe6c`, `fc81`, `fe6b` and its company ID.
- **Removed the `feed` and `fd5a` UUID-list tracker rules.** Skullcandy
  headsets list FEED, and the built-in tracker detector already scores Tile and
  SmartTag service data at 80 (the bench Tile still lists at 80 without them).
- **Police body and in-car cameras (beep):** Utility Inc. (BodyWorn), VIEVU,
  Digital Barriers, Zepcam, PRO-VISION, L-3 Mobile-Vision.
- **Plate readers (beep, Cameras tab):** Redflex, ELSAG, Perceptics, Ekin, and
  Genetec's IAB block.
- **Traffic radar and lightbars (beep, All tab):** Stalker (Applied Concepts),
  Kustom Signals, Decatur, Federal Signal.
- **Listed without beeping (60):** Jenoptik, Kapsch, Elsag Datamat and Selex
  ES (their blocks also cover telecom, industrial and defence products); Havis
  and Gamber-Johnson patrol-car docks; Harris, EF Johnson, Tait, Sepura,
  Hytera and Codan radios (taxis and security firms buy them too); Skydio,
  Teal, AeroVironment and Shield AI drones; Motorola Solutions' Bluetooth
  company ID and its two SIG UUIDs; and `d8:1f:65`, a block the IEEE lists as
  "Private" that field captures tie to Axon body cams, named for exactly that.
- **Flock Raven's five service UUIDs are back, at 60.** They were dropped at v5
  when UUIDs were substring-matched and one hit beeped; matching is exact now.
- **Smart glasses:** the names Ray-Ban, RayNeo, Rokid and Spectacles, and the
  HeyCyan glasses SDK's 128-bit UUID (full match only: it shares Apple's
  notification service base), all listed without beeping.
- **Meta's `feb7` / `feb8` moved off the Cameras tab.** On the bench a
  neighbour's Quest 2 matched them and listed as smart glasses. They now list
  as "Meta device" under All.
- **Attack gear (Attack toggle only):** Bruce's other fixed APs (`BruceKarma`,
  `BruceShell`, `BRUCE-UDP`, `BruceSniffer`) and BLE names (`BruceSniffer`,
  `Bruce-Spammer`, `Bruce-Flooder`, `BRUCE-PN532-BLE`); GhostESP's portal APs
  `EvilPortal` and `EvilAP`.
- **The stored rule file drops empty fields.** Six empty strings per rule were
  half of the Settings > Signatures reply, which holds the Bluetooth link while
  it sends. With 181 rules it measured 16 KB, down from 24 KB with the empty
  fields kept, and smaller than v18's. The rules cost about 56 bytes of
  internal RAM each on the C5 (10 KB for all 181, measured).

### Changed -- Signatures v18: what the other detectors learned this month

A review of the projects we learn from (SquachWatch-CYD, OUI-Spy's new AXEOFF
mode, Fieldwatch, PorkChop, ESP32 Marauder), with every value checked against
the IEEE and Bluetooth SIG registries before it went in. Boards pick the new
defaults up on their next boot (the signature version is bumped).

- **Removed: Flipper Devices' company ID `0x0E29` and MAC block `0c:fa:22`.**
  SquachWatch-CYD flagged a user's BUSY Bar (Flipper's desk sign) as hacking
  gear: its Wi-Fi uses `0c:fa:22` and its unpaired advert carries `0x0E29`.
  Three real Flipper Zeros on their bench sent neither. A Zero is still caught
  by its three service UUIDs and its name; selftest fails if either value
  returns.
- **Axon over Bluetooth.** TASER International's company ID `0x034D` (beeps),
  Axon's other two SIG UUIDs `fc81` / `fe6b`, and a new built-in detector for
  the ASCII tag `BWCDEVICE` that Axon body cams put in their advert -- read
  both ways round, because in the field it rides inside a little-endian
  128-bit UUID. It survives address rotation, so it catches a body cam without
  Axon's OUI. Five owner-confirmed field captures (all-cameras-are-beacons).
- **More police body cams by name:** Utility's BodyWorn remote, Wolfcom,
  Reveal Media, Digital Ally FirstVu.
- **Flock:** a camera's own hotspot "Flock Camera net." (Flock-You issue #43),
  which the 12-character `Flock-XXXXXX` check never matched; the external
  battery's "FS Ext Battery" name; and a built-in detector for `FS-` plus 4-12
  hex digits, an accessory name seen at real Flock sites. That last one rests
  on a single source, so it lists without beeping.
- **Roadside Bluetooth sensors:** Iteris (BlueTOAD) `00:14:7b` and BLIP
  Systems (BlipTrack) `00:0e:a5`. They log every passing phone and car by
  address, and no consumer owns one, so they beep and sit on the Cameras tab.
- **Trackers:** Tile's third UUID `fd84`, Chipolo (`fe33`, `fe65`, company
  `0x08C3`), and `fcb2`, the cross-maker "unwanted tracker" UUID a tag
  announces when it is away from its owner.
- **UUID rules now match service data, not only the UUID list.** Most trackers
  put their UUID only in a service-data field, so a UUID rule never fired on
  them; Tile, Samsung and Google worked only because they have built-in
  detectors. Exact matching is unchanged.
- **Smart glasses:** real Ray-Ban Meta glasses send Meta Platforms' company ID
  `0x01AB` together with `fd5f` (two independent captures), so that pair is a
  rule now. Both are required, the same shape as the Luxottica rule; Quest
  headsets send a different Meta ID, which stays out. Meta's `feb7` / `feb8`
  list without beeping (any Meta hardware could carry them). Snap `fe45` and
  Vuzix `0x060C` beep -- those companies make no other hardware.
- **Attack gear:** PorkChop's web-remote AP default, `PORKCHOP`.

### Fixed -- A drone sending two IDs no longer flips its serial

- Remote ID allows more than one Basic ID, and EU drones commonly alternate
  the serial with a CAA registration. The decoder starts fresh for every frame,
  so the row took whichever ID arrived last: `uas_id`, and the brand read from
  it, flipped on every other frame. The row now keeps the best ID it has heard
  (serial, then registration, then anything else). Found while reading
  Marauder's Remote ID fixes; selftest pins it.

### Fixed -- `install.py` accepts ESP32-C5 module variants

- **`install.py` refused an ESP32-C5-N16R8 dev board** (issue #1): esptool
  reports the module variant as `ESP32-C5HR8`, and the chip check demanded the
  bare name `ESP32-C5` followed by a word break. The suffix is the package, not
  a different chip, so it is the same die and the same image. The check now
  accepts any suffix that does not start with a digit, so a genuinely different
  part such as the ESP32-S31 is still refused. `test_distribution.py` pins both.

### Added -- The v1 case STLs

- **`hardware/case-v1/`** ships the printable v1 case (base, lid, LED diffuser)
  for the XIAO board (issue #3). The rest of `hardware/` stays local. `*.stl` is
  marked binary in `.gitattributes`, because Windows line-ending normalisation
  rewrites `0D 0A` inside binary files on commit, the same damage that once
  corrupted every Android icon.

## [0.10.1] — 2026-10-17 — Drives all night

### Fixed -- The C5 no longer runs out of memory on a busy road

- **A C5 crashed on a drive about two minutes after power-up**: an alert
  sounded, then the 1 Hz task's alert-log write aborted creating the file
  lock (`lock_init_generic`). The file object it had just allocated sat in
  PSRAM, which a small allocation only falls back to once **internal** RAM is
  full. The cause was the tracked-device list: it had no limit, every device
  heard stays in it until it has been silent for two minutes, and each one
  costs about 50 B of internal RAM. On a road, with Bluetooth plus both Wi-Fi
  bands and phones probing on fresh random addresses, that adds up fast, and
  a C5 starts with only ~58 KB free.
- **Reproduced on the bench** with a flood of ~40 new fake devices a second
  (a bench-only emitter persona): 58 KB free at 100 devices fell to **0.2 KB**
  at 1,939, with serial output stalling. **The list is now capped at 400**
  (`WATCHERS_MAX_TARGETS`, both boards). A full list evicts the
  least-recently-heard device that matched nothing; the hunted target and any
  device with an unwritten log record are never evicted. Same flood with the
  cap: steady at 400 devices, 40-43 KB free, low point 26.3 KB, and a real
  Tile stayed listed in all 67 pushes while the flood churned around it. A
  quiet street holds about 100. `selftest.js` fails if any
  `trackedTargets.push_back` is not preceded by `makeRoomLocked()`.

### Fixed -- The S3's slow Bluetooth memory leak, and a crash when the scan pauses

- **The leak was NimBLE 1.4 holding devices that never sent a scan response.**
  With `setMaxResults(0)` a device is erased only after its callback fires, and
  for a scannable advert that waits for the scan response. One that never comes
  (weak, or rotating its address) stayed in the result vector for ever, because
  a scan that runs continuously never completes and never clears. Isolated by
  soaking one S3 per radio, then swapping the boards: the loss followed the
  radio, not the board (Bluetooth-only -1.2 and -1.9 KB/h, Wi-Fi-only flat),
  and NimBLE's own stored-device count climbed 5 -> 26 in 1.45 h, about 130 B
  each. **The S3 now scans in 30-second rounds**, restarted from NimBLE's
  round-end callback; the round's end clears the stuck devices on the host task.
  2.87 h soak of both S3s, Bluetooth only: +0.49 and -0.54 KB/h, stored-device
  count never above 12. A 1 Hz check restarts the scan if a round ever fails to,
  so a board cannot go Bluetooth-deaf in silence. The C5 (NimBLE 2.x) times
  those devices out itself and stays a continuous scan.
- **Trap: NimBLE's `stop()` deletes every stored device on the calling task.**
  With `maxResults == 0`, `stop()` runs `clearResults()` on whoever called it --
  `loop()` for a USB `CMD:BLE_SCAN:OFF`, the 1 Hz task for a Ring -- while the
  host task can be inside our scan callback reading one of those devices. A
  use-after-free: 300 scan off/on toggles over USB panicked an S3 on `main`
  about 8 times (`LoadProhibited` in `findAdvField`, `nimble_host`); with the
  fix, 0 of 300. Every start and stop now goes through `bleScanStart()` /
  `bleScanStop()` (`mode_manager.cpp`): stop raises the result limit first so
  nothing is deleted, and start clears the vector while nothing is scanning.
  `start(..., is_continue=false)` is not used -- 1.4 clears *after* the scan is
  already running, the same race in a smaller window. The C5 has the same
  `stop()` but a single core; it survived 300 toggles before the fix and 150
  after, and gets the same safe path.

### Fixed -- The Android splash icon is sharp

- **Android 12+ draws the launcher icon on its system splash, and ours is a
  raster PNG foreground, so the phone scaled it up and it looked fuzzy.** The
  splash now has its own vector drawable (`res/drawable/splash_icon.xml`, a copy
  of `assets/icon-foreground.svg`) via `windowSplashScreenAnimatedIcon`. The
  viewport is 1536 so the logo sits at the launcher's 16.7% inset, the same size
  as before. VectorDrawable has no blur, so the SVG's soft glow is not on the
  splash. The launcher icon itself is unchanged.

### Fixed -- Hunt is offered on any stable address, not just trackers

- **A field drive past a traffic stop listed an Axon body cam (public BLE
  address `00:25:df:…`, -92 dBm) with Ignore and no Hunt.** The app offered
  Hunt only on tracker rows, or on every row with the filter off, so whether
  the button appeared depended on the category and the filter switch rather
  than on whether the device could actually be walked down. The board never
  had that limit: `{"hunt":"<mac>"}` takes any MAC, BLE or Wi-Fi.
- **The test is now the address, the same `stableMac()` test Ignore uses**
  (public BLE, Wi-Fi with the locally-administered bit clear, BLE random
  static). Hunt follows one MAC, so it belongs wherever that MAC holds still.
  Trackers keep Hunt unconditionally (an AirTag away from its owner keeps its
  random address for about a day), and the filter-off "hunt anything" path is
  unchanged. A rotating random address still gets no Hunt. In-app checks
  `huntOnStableNonTracker` and `noHuntOnRotatingCam`.

### Added -- Attack-firmware default SSIDs (signatures v17)

- **Five factory SSIDs from popular ESP32 attack firmware, each read from the
  project's own source rather than a write-up:** Bruce's `BruceNet`
  (`config.h`), GhostESP's `GhostNet` (its `apcred` reset), Marauder's updater
  `MarauderOTA`, the Rick Roll beacon-spam list both Marauder and Bruce ship
  (`01 Never gonna give you up`), and Bruce's joke-SSID spam line `Yell BRUCE
  for Password`. All 70, "Hacking gear", matched only while Attack is on, All
  tab only. A renamed AP is not caught -- these catch the operator who never
  changed the default.
- **Deliberately left out:** Marauder's Evil Portal `PORTAL` (a placeholder; the
  portal will not start until it is given a name, usually a cloned nearby
  network) and the rest of the joke-SSID lists ("FBI Surveillance Van",
  "Pretty Fly for a Wi-Fi"), which people really do name home routers.

### Fixed -- The hunt gauge no longer flashes red when a target comes back

- **Re-locking a hunt seeds the clicker with the sample just heard, not
  -90 dBm.** When a hunted target was heard again after silence,
  `watchersPeriodicTask()` called `setGeigerTargetLock(true, -90)`, overwriting
  the RSSI the scan callback had written a moment before -- a "very far away"
  flash before the real level. It now seeds from `huntLastRssi` when that sample
  is inside `HUNT_SILENCE_MS`, else -90. Bench (S3 hunting the C5, target taken
  off air 14 s and back, three times): seeds -32, -33 and -8 dBm against the
  next hunt frames' -8, -33 and -32; never -90. 60 of 60 pushes after.

## [0.10.0] — 2026-10-15 — Pin it where you saw it

### Fixed -- Tag flood no longer trips on passing AirTags

- **A tag flood only counts addresses heard at -80 dBm or stronger**
  (`TAGFLOOD_MIN_RSSI`, the same floor BLE popup spam uses). Every field capture
  we hold (178) was replayed through the firmware's own `attack_detectors.h`:
  8 drives tripped the Apple Find My flood on real AirTags in passing cars, each
  heard a couple of times at -81 to -99 dBm, which looks exactly like a
  throwaway fake. With the floor, none trips; at -85 one still does, so the
  margin is one 5 dB step. Weak adverts still count as hits, so a real tag at
  the edge of range never looks short-lived. A spammer close enough to matter
  is well above the floor; no capture of a real one exists yet, so the floor is
  a tuning knob (`-D` overrides it for a bench build).
- **BLE popup spam held:** 0 of the same 178 captures trip it (peak 2 distinct
  addresses against a threshold of 8). Not changed.

### Added -- "Yes, always" pins, and pins land where the device was seen

- **The pin prompt has a fourth answer, "Yes -- always for <category>".** Every
  later match of that kind is pinned without asking. Undo is a chip row in
  Settings > Recording, beside the "stop asking" chips; a category is in one
  list or neither.
- **The location is taken when the device is first seen**, not when you tap Yes.
  At driving speed a fix taken after the tap put the pin a block past the camera.
  Still one-shot (never a track), shared for 10 s across a burst of matches, held
  only with the waiting prompt and dropped on No or disconnect.
- **Record asks for the PIN up front when any category auto-pins**, because an
  auto-pin writes to the encrypted store with no prompt to unlock it. Skip it and
  that drive simply asks as before. A fix vaguer than 50 m never auto-pins; it
  goes to the normal prompt, which asks before saving it.

### Changed -- A fitted SD card logs every alert

The card log used to follow the "Log alerts on the board" switch, which is off by
default, so a drive with a card in could come home with no log at all. Now a
fitted card records every alert the buzzer sounds (same rules: a muted category
or a hunt logs nothing); the switch controls only the copy in the board's own
memory. Settings says so when the switch is off and a card is in.

### Fixed -- A new boot no longer appends to an old card log

The card log was named by boot number (`LOG<boot>.CSV`). The boot counter lives
in NVS and can be reset below the card's files (a factory reset, a reflash), and
then each new boot appended to an old file: LOG00063 held both Sep 26 and Oct 10.
A boot's first write now takes the next free number (highest `LOGnnnnn.CSV` + 1,
the same rule capture files use); the CSV's `boot` column still says which boot.
A card swapped mid-boot gets a fresh file too. Bench: power-on boot 97 wrote
LOG00127 (the card's highest was LOG00126), and a phone connecting later dated it
with `#anchor` in the already-open file.

### Added -- Site Survey says what card the board has

Survey now shows the board's card under the capture controls: `SD card · N GB
free`, `No SD card`, `SD card full` or `SD card error` (a dash when nothing is
connected). Opening the tab asks the board again (`CMD:CFG`), so a card pulled or
filled since you connected doesn't show stale.

### Changed -- Band tabs only filter the view

The Everything / Cameras / Trackers / Drones tabs used to send a preset beep
mask to the board and set which category asked to be pinned. Nothing on screen
said so: on a drive, tapping Everything quietly turned tracker beeps back on
after they had been muted in Alerts. Tabs now filter the list and the map and
do nothing else. **Settings > Alerts is the only beep control**, and the
"No -- stop asking about X" chips are the only pin filter (the Record bar says
"pinning everything" or "pinning all but ..."). The board's mask no longer
moves the tab either.

### Changed -- A tag flood no longer mutes trackers

The tag-flood detector (fake-tracker spam) used to hold every tracker beep of
that type while it was tripped. Driving trips it: real AirTags passed in traffic
are heard a few times and gone, exactly like fakes. A real tracker muted by a
false flood is the worse failure, so the flood now only shows its row
("Tag flood · Apple Find My · N fake"); trackers beep as usual. The pin prompt
still skips trackers while a flood row is live, or every fake would ask.

### Fixed -- Site Survey froze on its timer when the board went quiet

A field capture sat at a full countdown with no error until the app was
force-quit and the board power-cycled. Bench stress (back-to-back captures on
the C5) found two board failures that both stop the 1 Hz `{"cap"}` frames:

- **The open C5 BT-controller assert** (`bt.c:562`), 1 start in 11 on a phone.
  Decoded: `r_ble_ll_task` -> `r_ble_lll_recycle_sch_in_task` -> `r_ll_assert`,
  the controller failing to re-insert a preempted scan event into its schedule.
  All Espressif ROM/closed code; the board reboots and resumes detecting.
- **A hang at the end of a capture** (1 in 137): no output, USB not even read,
  dead until power was pulled. Nothing fired because the C5 core's task
  watchdog watches no task of ours.

Fixes:
- **App:** any 6 s gap in the capture frames ends the capture and says so
  ("The board stopped answering mid-capture. What reached the card is kept.").
  It cannot tell a reboot from a hang, so it does not claim either.
- **C5:** `loop()` is under a 30 s task watchdog. A hang now panics, writes a
  coredump naming where it stuck and reboots (bench: `CMD:HANG` in a
  `SWEEP_CRASH_TEST` build fires at 30.0 s, `reset` 6, reason recorded). The
  longest legitimate `loop()` block is a bulk reply, ~3 s. `selftest.js` pins it.

### Added -- Drone brand names and a tap-to-open Remote ID card

**First real drone in the field (2026-10-14).** All three bench detectors (S3,
C5 and an OUI-Spy board running tier1) picked up a DJI over **Wi-Fi beacon
Remote ID** on channel 6 at -75..-79 dBm, rated Confirmed / 90, and decoded its
serial, position, altitude, speed, heading and operator position. That is the
first time the Wi-Fi beacon decode path has been proven on a real aircraft
rather than our own bench transmitter.

- **Brand from the serial.** Remote ID serials are ANSI/CTA-2063-A: a 4-char
  ICAO maker code, one length character (1-9, A-F = 10-15), then that many
  characters. `droneMaker()` names the maker only when the length character
  matches the rest of the string, so a CAA registration or session ID can't
  pass as a serial. Shipped codes: `1581` DJI (proven by the field serial),
  `1748` Autel. ICAO publishes no open list, so a code is added when a real
  serial proves it. Fallback: a DJI OUI on the drone's public Wi-Fi MAC
  (`60:60:1F` and friends). The row title reads "DJI drone" instead of the
  `RID-<serial>` SSID.
- **More of the decode reaches the app.** The firmware now also sends
  `ua_type`, `rid_status` (ground / airborne / emergency / Remote ID failure),
  `href`, `vspeed`, `eu_cat`/`eu_class` and `op_loc` (operator position is
  take-off, live GPS or fixed). Drone rows only, and each field only when the
  drone sent a real value, so an idle push does not grow.
- **Tap a drone row to open it.** Closed: status, aircraft type, height, speed.
  Open: climb rate, heading, MSL altitude, serial, operator ID, self ID, EU
  class, drone and pilot positions, and the drone-to-pilot distance. Emergency
  and Remote ID failure show in red. Open rows are memory only and cleared on
  disconnect, like the radio groups.

### Fixed -- Drone height was labelled AGL when it was over take-off

ODID's Height field is measured from either the ground or the take-off point,
and the message says which (`HeightType`). DJI sends take-off. The app labelled
it "AGL" regardless, which is wrong for a drone that launched from a hill. It
now reads "up" unless the drone says ground, then "AGL". The firmware keeps the
`agl` key for older apps and adds `href` beside it.

## [0.9.1] — 2026-10-13 — One logo, one palette, everywhere

### Changed -- One brand everywhere: SignalSweep brand kit v1.0

The app, the web flasher, the data-pull page and its `report.html` now follow
the SignalSweep brand kit.

- **Logo.** The header's old radar-in-a-circle icon (a full circle with a hand
  reads as a clock) and the hand-typed two-colour "Signal**Sweep**" wordmarks
  are gone; the app, flasher and pull page show the kit's outlined lockup. New
  favicon (the small mark) and home-screen icon on the app and site, inlined as
  a `data:` URI in `pull.html`. New Android launcher icon and splash screen.
- **Colour.** Every page carries the same `--ss-*` token block, and `app.js`
  reads category colours from it instead of hard-coding hex (canvas and Leaflet
  resolve the token at draw time, since they cannot take `var()`). Drift fixed:
  body cam `#ff5a1a` is now `#ff7a1a` like everywhere else, the flasher's
  tracker purple is now the app's pink, every green is `#3ddc84`, the older
  cyans and the purple background glow are gone.
- **Type.** Share Tech Mono for headings, labels and readouts (MACs, dBm);
  paragraphs and controls keep the system font. The font ships *with* the app
  and site (`share-tech-mono.woff2`, OFL licence beside it, credited in
  `CREDITS.md`) and is inlined into `pull.html` -- never a hosted font service.
  `pull.html`'s CSP now allows `img-src data:` and `font-src data:` for that;
  `connect-src` and `default-src` stay `'none'`.
- **`report.html`** is dark-only now, in brand colours. Its light-mode palette
  needed a second, darker green the brand does not have.
- **Name.** Page titles read just "SignalSweep". Machine identifiers are
  unchanged on purpose: the Android app id (changing it would orphan every
  encrypted pin store), release asset names, export filenames, NVS namespaces
  and the default BLE name `SignalSweep` the app searches for.
- Dead CSS from the old mode-selector UI (mode cards, radar blip, status badge)
  was deleted along the way; nothing referenced it.
- **README and flasher, rewritten loud.** The README opens on a new banner (the
  lockup over the Sweep, Survey and Settings tabs, shot on the bench with the
  emitter, so every row is staged) and gains Site Survey, per-device Ignore,
  one-row dual-band routers and "cop-only gear beeps on sight". The flasher page
  had not moved since the C5 landed; it now covers the same ground, plus a
  "Straight answers" block that says plainly what it can't hear (a deployed
  Flock camera on LTE, an AirTag beside its owner).
- **Connect modal.** Its heading spelled "Connect SignalSweep" in a white-to-cyan
  gradient in the logo's own typeface, a home-made wordmark. It reads "Connect
  your board" in plain text now.
- **Fixed: a sliver of the hidden toast showed at the top of the screen.** It
  was parked at `-150%` of its own height from `top: 2rem`, which left its
  bottom edge and glow on screen at all times. A screenshot caught it.

### Changed -- Brand pass, round two: one token file, line icons, cyan for "selected"

- **One token file.** The app and the flasher now link the kit's
  `signalsweep.css` byte for byte instead of carrying their own copies;
  `pull.html` and `report.html` (which load nothing) inline it verbatim.
  `test_distribution.py` fails if any copy drifts, and fails on any raw hex
  colour in the app outside two deliberate exceptions: the LED theme swatches
  (the bar's own colours) and the easter egg's phosphor terminal. Neutrals the
  kit doesn't name are mixed from its tokens (`color-mix`), never new hex.
- **No emoji in the UI.** Settings, the Alerts rows, category labels on rows,
  the map, Survey, toasts and the flasher's beep list use one set of line
  icons in the bottom tab bar's style (an inline SVG sprite, `ico(name)` in
  `app.js`). A category icon takes its category colour; everything else is
  muted grey, cyan when active.
- **Green means live or success, nothing else.** Primary buttons and
  selections (the Survey duration, Capture, theme chips, segmented pickers, an
  active Hunt) are cyan. On/Off switches, the connection dot and "OK" badges
  stay green. The Wi-Fi radio badge was green for no reason; it's grey now.
- **Header logo.** It drew about 25px of artwork because the lockup SVG carries
  its own clear space; the box is 58px now, so the logo itself is 36px+.
- **Logo files ship exactly as the kit has them**, including the signed
  content credential each SVG carries (Anthropic's, recording that Claude
  made the file). `.gitattributes` marks `*.svg` `-text` so a line-ending
  conversion can't rewrite those bytes. `favicon-32.png` joins the SVG favicon.

### Added -- Self-test refuses hosted font services

`node app/selftest.js` now fails if the app (`index.html`, `app.js`,
`src/main.js`) or the site (`index.html`, `pull.html`) references Google
Fonts, Typekit or Bunny Fonts. A hosted font is a third-party request every
time the page opens -- the same reason vendor names are looked up offline --
and `pull.html`'s CSP (`default-src 'none'`) would block it anyway. The coming
brand pass uses Share Tech Mono, and the brand kit's own guidelines page loads
it from Google; the app ships the font as a local file instead. Proven by
planting a Google Fonts line in `pull.html`: the self-test failed and named the
file.

## [0.9.0] — 2026-10-13 — If no one but a cop owns it, it beeps

### Changed — Surveillance vendors beep on their address alone

Field evidence: driving past a traffic stop, the C5 listed two Axon access
points on 5 GHz (channels 153 and 157, -79/-81 dBm, two distinct addresses, no
recognised SSID) and stayed silent, exactly as the old cap of 60 told it to.
The cap existed because Axon makes more than body cams -- but Tasers, docks,
in-car Fleet gear and Signal units are police equipment too, and this device
exists to tell you the watchers are near.

Every registry vendor hint now goes through one test: **could an ordinary
person own this?**

- **Beep (70):** Axon (`00:25:df`), Flock's IEEE-registered block
  (`b4:1e:52`), SoundThinking/ShotSpotter (`d4:11:d6`), Genetec AutoVu/Sharp
  plate readers (category now "Genetec ALPR", so they sit on the Cameras tab),
  and new rules for Neology (plate and toll readers, `00:17:3d`), WatchGuard
  Video (police in-car and body cameras, `00:1d:96` -- not WatchGuard
  Technologies, the firewall company) and Digital Ally (police cameras,
  `00:23:bd`).
- **List, no beep (60):** Motorola Solutions (police radios, but also every
  hotel and security firm's two-way radios; consumer Motorola phones are a
  different registrant), Verkada, Avigilon Alta, Axis (business security
  cameras and door readers) and Ubicquia streetlight nodes. Two more Motorola
  Solutions and two more Axis prefixes from the IEEE registry.
- **Unchanged (30):** the 35 community Flock prefixes (they overlap consumer
  Wi-Fi modules, so the address alone proves nothing) and the fleet routers --
  Cradlepoint, Peplink, Sierra Wireless ride in buses and pharmacies as often
  as patrol cars.

Expect beeps passing a police station; the category toggles and per-device
Ignore still silence them. Most of this hardware is wired and we have not
heard it on the air; a registered prefix costs nothing if it never transmits.
Signature defaults are now v16, so boards already in the field pick it up on
the next flash. The self-test pins every vendor's weight and the tab its
category routes to.

### Removed — The DS3231 clock, and the optional resistor and capacitor

SignalSweep's hardware is the XIAO, a passive buzzer, a WS2812 LED bar and a microSD reader. The
clock module, the 330-470 ohm DIN resistor and the 1000 uF bar capacitor were never part of the
build, so they are gone from the wiring guide, the illustrated diagram and the README.

- **The DS3231 driver is gone; the phone's time push stays.** `rtc_clock.{h,cpp}` is now
  `host_time.{h,cpp}`: `hostTimeSet()` takes `{"time":N}` from the app on every connect, with the
  same 2026..2038 range guard, and the alert log and SD log are dated exactly as before. The board
  forgets the date at power off, as it always did with no clock fitted.
- **`CMD:CFG` no longer reports `rtc`.** `epoch` stays, and Settings > Device identity > Clock now
  reads "synced · time from the phone until power off" from it alone.
- **D4 and D5 are simply unused** instead of reserved for a clock.
- **The "C5 + SD reader on D3 not bench-checked" warning is gone**: C5 boards have run with the
  reader on D3 (GPIO7) since the SD work landed, and boot fine.

## [0.8.2] — 2026-10-09 — The list holds still under your thumb

### Fixed — Hunt landed on the wrong row with the filter off

Foxhunting your own gear (a Govee light, filter off, a quiet house) was a race: every 1 Hz push
rebuilt the whole list, and a push landing between touchdown and the click put the tap on whatever
row had just slid into that slot. The 5 dB bucketing from earlier stops rows swapping on jitter; it
cannot stop new rows arriving or old ones ageing out, and a city adds both every second.

- **The list freezes while a finger is on it, and for 3 s after the finger lifts or a scroll stops**
  (`listTouching`/`listHoldUntil`, `LIST_HOLD_MS`). Only the row rebuild is skipped: the band counts
  and the hunt panel above still update every push, and the board's beeps and LED meter never pass
  through the app at all, so the hunt stays as analog as it was.
- **A row button clears the hold before acting**, so Hunt, Ring, Ignore and expand redraw at once
  instead of waiting out the 3 s they just started.
- Known cost: while you are touching the list, the hunted row's own dBm and bars freeze with it. The
  fox panel above does not, and Hunt scrolls you up to it.

## [0.8.1] — 2026-10-08 — What the camera caught

### Fixed — eight things a screenshot caught

Shooting marketing screens on the bench rig (filter on, emitter cycling, phone on a mock location)
put the app under a camera for an afternoon, and the camera found eight things the eye had stopped
seeing. Each one is now pinned by `node app/selftest.js`.

- **The hunt panel offered "Make it ring" on an AirTag.** The row buttons have obeyed the firmware's
  `ring:1` flag for a long time; the panel's own button was unconditional. It is now hidden unless the
  hunted row carries `ring`, and "Stop hunting" takes the full width.
- **`conf 90` wrapped mid-number** ("conf 9" / "0") on almost every row: `.scope-sub` used
  `word-break:break-all` so long MACs could wrap. It is `overflow-wrap:anywhere` now (a MAC still
  breaks when it must), and `conf` is joined to its number with a no-break space.
- **A tag flood's own row sank under its fakes.** Ninety fake trackers at the same RSSI outsorted the
  `Tag flood:` row that explains them, so the alert count froze with no visible reason. Summary rows
  (any MAC with a space) now sort first; a hunted row still takes the very top.
- **Map markers had no labels, and their popups could not be opened.** `renderMap()` rebuilds the
  layers on every 1 Hz push, which closed any popup within a second. The drone, the pilot and you now
  carry permanent labels.
- **The map's attribution painted over the bottom tab bar.** Leaflet's controls are `z-index:1000`
  and the bar is 900; `#map` now has `isolation:isolate`, so everything Leaflet draws stays in its box.
- **The Android app said "Web Bluetooth API: Not Supported" under a working Bluetooth button.** It
  uses the native plugin, not Web Bluetooth. The row is "Bluetooth" and reads **Native BLE** there, the
  same way USB already read "Native USB host".
- **The map note wrapped "9 ring(s)." onto the Recenter button's line.** The prose and the button are
  on separate lines now, with a real plural.
- **"Ignored devices" sat flush against the theme chips** in Settings > Alerts; it has the spacing every
  other heading there has.

### Fixed — Disconnect no longer reboots a USB-connected board

- **Pressing Disconnect on a cable (Web Serial) connection rebooted the board** — the tick was the
  boot sound, and `CMD:CFG` showed `reset:11` (USB reset, not a crash) with the boot counter one
  higher. The browser opens the port with DTR and RTS asserted and the OS drops them one at a time
  on close; the in-between RTS-high/DTR-low state is the ESP32 USB-Serial-JTAG reset. `disconnectDevice()`
  now drops RTS, then DTR, through `port.setSignals()` before `port.close()`, so the close changes no
  lines. Verified on both boards in Chrome and Firefox, repeated connect/disconnect, no reboot. Opening
  the port still resets the board — a page cannot set the lines before the port opens.

### Fixed — saving signature rules over Bluetooth

- **Settings › Signatures › Edit as JSON › Send to device never worked over Bluetooth.** The app
  sent the whole rule set (~11 KB) as one GATT write, and one write carries one attribute value,
  512 bytes at most. Measured on the bench from a PC at MTU 517: the single write fails outright and
  the board keeps its old rules. Over the USB cable it always worked, because a byte stream has no
  such cap, which is how it hid.
- **Splitting the write alone is not enough:** the board routed every write as a complete command,
  so 62 split writes went through cleanly and each was dropped as broken JSON (also measured).
- Now the app sends any command over 180 bytes as a series of acknowledged writes (180 fits one
  packet at any MTU of 183 or more; short commands still go as one write), and the board's
  `onWrite` reassembles them up to the newline every app command already ends with. A reassembled
  line over 512 bytes is routed from `loop()` instead of the NimBLE host task — the same rule as
  `CMD:SIGS`, keeping a multi-KB parse and a LittleFS write off that task's small stack. A half-sent
  command is dropped on disconnect so it cannot prefix the next peer's, and a buffer that grows past
  64 KB with no newline is discarded.
- Bench (S3, real BLE link): an 11,035-byte rule set in 62 writes, 10.3 s from a Windows PC; read
  back over Bluetooth in 1.6 s with the new rule present; short commands still answered; no reboot.
- For scale: the stored rule file is ~16 KB of a 1.94 MB filesystem (the alert log claims up to
  1.6 MB of it), so flash leaves room for roughly 20 times today's rule set.

### Added — OUI-Spy's mode-selector AP is a default Hacking-gear rule

- **SSID prefix `oui-spy`, weight 70, category Hacking gear** (signature schema v12, so deployed
  boards pick it up on their next boot). Colonel Panic's OUI-Spy Unified Blue boots into a mode
  selector that raises a WPA2 AP named `oui-spy` on channel 1; with Attack detection on it now lists
  and beeps under All. Low-hanging fruit on purpose: plenty of boards run with the default name,
  and catching the lazy ones is still catching them.
- **The SSID is the only handle.** The selector picks a fresh random (locally administered) AP MAC
  every boot, so no OUI or address rule can hold it, and a board renamed from its own selector page,
  or switched into one of its modes (each brings up its own AP or BLE name), is not caught by this rule.
- **Its modes' default APs too (schema v13), same weight and category:** `snoopuntothem` (Detector),
  `foxhunter` (Foxhunter) and the prefix `ouispy-` (PCAP's `ouispy-pcap`, BLE Sniff's
  `ouispy-blesniff`). Its recovery AP, `oui-spy-recovery`, already falls under the selector rule.
  Two modes stay invisible by design and no rule can change that: Flock-You WiFi (the DeFlock
  wildcard-probe detector) runs Wi-Fi in listen-only mode with no AP, and Sky Spy only listens on
  Wi-Fi and scans BLE; the "DroneID" name it gives its BLE stack is never advertised.
- Bench-proven on the S3: the real board, untouched, detected at 70 / Likely with the filter on, one
  alert. Bench trap from the same run: resetting that board by toggling its serial port's RTS line
  brought it back printing "AP started: SUCCESS" while radiating nothing, as neither the detector nor
  a separate Wi-Fi scanner could hear it. Only its hardware reset button brought the AP back on the
  air. Use the button, or a phone Wi-Fi scanner as a witness, before blaming the detector.

## [0.8.0] — 2026-10-06 — Get your data off without opening the case

### Added — a data export page beside the flasher, and `pull.py`

- **The SD card stays in the case.** `pull.html`, linked from the flasher,
  talks to the board over the USB cable (Web Serial). Tick what you want (the
  alert log, captures, session logs; grouped, sortable, long groups folded
  shut), then **Export to a folder…** or **Save to Downloads**. You get
  `alerts.txt` (counts per kind, then every alert in your local time),
  `report.html` (the same, sortable and filterable, opens offline), a `.pcap`
  per capture for Wireshark (Wi-Fi frames, radiotap channel and dBm), and the
  untouched originals in `raw/`. A **? Help** guide says what lives on the
  board, how each store fills up, and what each exported file is.
- **Nothing leaves the machine.** The page is one file with a
  `default-src 'none'; connect-src 'none'` policy and loads nothing external;
  `report.html` carries the same policy. `test_distribution.py` fails if either
  goes.
- **`pull.py`** makes the same folder with no browser (needs only pyserial),
  plus `--wipe` (typed confirm, then skips any file that grew since it was
  copied), `--phone` (adb pull of the app's Documents files) and `--pcap`. It is
  self-contained on purpose, so it can be read top to bottom before it runs.
  The page carries `pull.py`'s report template byte for byte, and the test
  checks it.
- **Reports come from the board's flash alert log, not the card's session
  logs.** Both record the same alerts, so reading both would count everything
  twice. The session logs' extra columns (name, SSID, channel, maker) ship in
  `raw/`.
- **Both save routes, side by side, and every failure in the log box.** A
  folder keeps an export in one place; plain downloads are the fallback. A
  picker or write error is printed under the buttons instead of being
  swallowed.
- **"Drive log" is now "session log"** (one per power-on) in the app and docs:
  not every outing is a drive.

### Fixed — card downloads over USB, and pcaps Wireshark can read cleanly

- **`CMD:SD:GET` over USB sends 64 lines (48 KB) a page instead of 8**; BLE
  stays 8. Timing one page on the bench showed `sdRead()` taking 1.94 s of the
  2.6 s: every call reopened the file and re-walked the FAT chain to the
  offset, ~30 ms per 768-byte line. A page is now one `sdRead()`, sliced into
  lines: 0.8 s a page, and a 3.8 MB card pull went from 234 s to 74 s (~50 KB/s).
  Most of what remains is the 5 ms per-line yield. A short read before the end
  of the file now answers `read failed` instead of promising more. selftest
  pins the single read.
- **Trap: ESP32 promiscuous frames end in 4 bytes that are not a valid FCS.**
  Written to a pcap as-is, 2,864 beacons in one capture ran their IE chain 4
  bytes past the end, so Wireshark would show a malformed IE on nearly every
  frame. Both converters drop those 4 bytes on whole frames and record the true
  `orig_len` on truncated ones; all 637 whole beacons then parse exactly.
- **The hosted app's SD Download on a desktop browser** (no Capacitor
  filesystem) toasted "File storage unavailable"; it now saves as a normal
  download.

### Changed — the Alerts page: one Sound row, switches for categories, less to read

- **Sound and Volume are one row: `Off` / `Low` / `Med` / `High`.** They were
  two pickers for one question. Off mutes; tapping a level while muted sends
  the unmute first and then the level, so the board's level-preview chirp is
  heard. The mute and the volume are still separate on the board and on the
  wire (`{"buzzer":bool}`, `{"vol":0..2}`), so nothing persisted changes.
  Firmware that reports no volume gets `Off` / `On`.
- **Each category is a sliding On/Off switch**, the same control as the rest of
  Settings, replacing the per-row chip that read 🔊 💡 / 💡 / 🔊 / Silent / Off.
  The chip existed so a row never read "On" while nothing could alert. Sound
  and Lights are global, so that is now one line above the list, shown only
  when both are off: "Sound and lights are both off, so nothing will alert."
- **Theme moved below the categories** (cosmetic, set least often), and the
  intro and the "still detected and listed" note are one line each.
- **Layout trap:** the Sound picker shows two or four buttons depending on the
  firmware, so it is `grid-auto-flow:column` rather than a fixed column count;
  a fixed two-column grid wrapped the four buttons into a 2x2 block.

### Fixed — a crowd of AirPods is no longer BLE popup spam

- **The popup-spam rule now ignores adverts weaker than -80 dBm**
  (`ATTACK_BLESPAM_MIN_RSSI` in `attack_detectors.h`). The rule counts distinct
  random addresses sending Apple Proximity Pairing (`0x07`) or Nearby Action
  (`0x0F`) and fires at 8 inside 5 s. On a drive on 2026-10-01 it fired in
  traffic beside a supermarket lot: a capture taken minutes later holds 52 such
  addresses in ten minutes, peaking at 12 in one window. They were ordinary
  AirPods status beacons, each a different model and address, nearly all at
  -90 to -97 dBm. With the floor the same capture peaks at 5.
- **Why a signal floor and not "new addresses only".** Counting only addresses
  first heard inside the window still peaked at 11 on that capture: driving
  past a crowd makes real earbuds look exactly as throwaway as a spammer's
  addresses. Signal strength is the difference that survives — a transmitter
  far enough away to read -90 is not the one raising popups on the phone in
  your hand. Filtering on Apple-style private addresses also cleared the
  capture, and was not taken, because it trusts an address the attacker
  chooses.
- **Measured against every capture we hold (164):** only that one trips the old
  rule, none trips the new one. Bench, both boards, emitter's `blespam`
  persona at -25 to -39 dBm: fires in under 5 s. A temporary S3 build with the
  floor at -20 stayed silent for 45 s against the same emitter, so the gate is
  proven in both directions on hardware.
- **The floor is a tuning knob, fitted to one capture.** It is wrapped in
  `#ifndef` so a bench build can move it with `-D`. No capture of real popup
  spam at a distance exists yet; if a field run shows spam being missed, this
  is the number to revisit. The host tests cover it
  (`test_blespam_weak_adverts_ignored`): weak adverts are not counted and do
  not pad a count that near adverts are building.

## [0.7.1] — 2026-10-01 — Every toggle is a sliding switch that says what it is set to

### Changed — one toggle standard: the row names the thing, the switch shows its state

- **Every on/off control in the app is now a sliding switch: knob right and
  green is On, knob left and grey is Off, with the word beside it.** The old
  buttons each spoke their own dialect. Sweep's filter read `Matches only` /
  `All devices` (a state that looked like an action you were about to take),
  the radios read `Scanning` / `Paused`, and Receive-only showed the *action*
  (`Go quiet` / `Advertise`) next to a separate "Currently: advertising" line.
  Now: `Filter: On` (matches only) / `Filter: Off` on Sweep, and plain On / Off
  for Bluetooth LE, Wi-Fi, Attack-gear detection, Receive-only, the alert log
  and the pin prompt. The Receive-only confirm, with its Bluetooth "this
  connection will drop" warning, is unchanged.
- **Off is grey, never red.** Off is a normal choice; a red Off made
  Attack-gear detection look like an error at its default.
- **`Filter: On` means filtering.** The filter was labelled "Filter: On/Off"
  once before and dropped because On meant the filter was *off* (`foxhuntMode`
  true). The label is back with the sense the right way round, and with no
  board connected it shows a plain dash with no switch, because the board's
  filter state is unknown.
- **The switch is CSS on the same `<button>`, not a checkbox.** A native
  checkbox flips itself on tap whether or not the write lands, which is how the
  app and the board drifted apart before. These still paint only from what the
  board reports. A `.set-toggle` with neither `on` nor `off` stays a plain
  button (SD card Download / Delete).

## [0.7.0] — 2026-09-28 — A tag flood is one alert, the buzzer has a volume knob, and Flock's battery has a name

### Added — buzzer volume: Low / Med / High

- **A persisted volume, `{"vol":0..2}`, for every sound the board makes** —
  alerts, the hunt beeps, chirps, the siren. High is the default and is exactly
  the old sound; Low and Med are for a quiet drive, indoors, or a foxhunt next
  to people. Idea from SquachWatch-CYD's buzzer levels. Saved in `sweep-bz`/`vol`,
  echoed in `CMD:CFG` and the 1 Hz push (the board is the authority, like the LED
  mode), and picked in Settings > Alerts under Sound, which paints only from the
  board. Picking a level plays the connect chirp at the new level (not while
  hunting; the mute still wins). The mute stays its own control.
- **Volume is PWM duty, so the buzzer no longer goes through Arduino `tone()`.**
  On both cores `tone()` queues each note to a background task that re-attaches
  the LEDC channel and writes a fixed 50 % duty, so a quieter duty written after
  it just races that task. `buzzerTone()`/`buzzerOff()` now own the channel:
  attached once at boot, `ledcWriteTone()` for the pitch, then the level's duty
  from `VOL_DUTY[]` (20 / 90 / 512 of 1024). **Trap: `ledcWriteTone()` writes 50 %
  duty itself, so the volume write must come after it** — `selftest.js` pins the
  order and fails if `tone()`/`noTone()` reappear. Owning the channel also retires
  the old lazy-attach trap (`noTone()` on a never-attached channel logged an error
  every call, 561 in 4 s on a board booted muted): bench, both boards, booted
  muted and stepped through all three levels with zero LEDC errors.
- Bench (S3 + C5): Low and Med confirmed by ear against High on both boards; the
  level survives a reboot; setting it from the phone over Bluetooth (the NimBLE
  host task) repaints the picker with no reboot; 60 of 60 pushes in 60 s with the
  extra field. Volume and theme pitch are independent (duty vs frequency); a piezo
  is louder at some pitches than others, and that is accepted rather than
  calibrated per theme.

### Added — a fake-tracker flood is one alert, not a hundred

- **A tag spammer (fake AirTags, Google Find My, Samsung SmartTags or Tiles on a
  fresh throwaway address every burst) now collapses into one "Tag flood · <type>"
  Tracker row per type, instead of one beep per fake.** Idea from SquachWatch-CYD,
  whose field logs show 91 fake AirTags in 22 minutes and later 170 fake Google
  tags; reimplemented here, nothing copied. Always on, not behind the Attack
  toggle: the alert storm happens whether Attack is on or not.
- **The evidence is address lifetime, not payload.** A real tag keeps one address
  for about 15 minutes and adverts every ~2 s; a spammer's address is heard a
  couple of times and never again. An address that goes quiet for 30 s having been
  heard 3 times or fewer is one piece of evidence; 6 inside 5 minutes trips that
  type, and 5 minutes with no new evidence releases it. A real tag passes 3 adverts
  in a few seconds, so it never counts, however long it sits beside the board
  (host test: an hour at 2 s, zero evidence).
- **Trap: a flood faster than the 32-address ring must still trip.** Evicting an
  address from a full ring counts as evidence when it was heard 3 times or fewer;
  otherwise a fast enough spammer pushes every fake out before it goes quiet, and
  the detector never trips (host test: 100 addresses in 10 s).
- **Trap: date the evidence when the address went quiet, not when it was noticed.**
  The sweep is lazy -- it runs on the next advert of that type -- so the fakes
  still in the ring when a flood stops get swept by whatever comes next, maybe
  hours later. Dated "now", they re-tripped the gate and muted the first real tag
  to show up. The first bench run caught it live: the real Tile keychain on the
  bench kept the Tile flood refreshing for minutes after the spammer stopped.
  Evidence is now stamped at last-heard + 30 s, and one address counts once per
  window, or a weak real tag heard every ~40 s counts on every gap and two real
  tags trip a false flood (host tests for both).
- **While a type is flooded its fakes stay listed but never beep or log, the same
  way Ignore works.** Their once-per-appearance `alerted` flag stays clear, so a
  real tag still present when the flood ends sounds then. Only the flood row itself
  beeps (tracker pattern) and logs, once. The app follows suit: with Record on it
  offers no pin for the flood row, nor for trackers while a flood row is live, so
  170 fakes are not 170 prompts.
- **Rows with no single transmitter -- "Tag flood: <type>" and "BLE popup spam" --
  now reach the flash log and the SD card**, under the reserved address
  `02:00:00:00:00:00` (locally administered, so no vendor lookup), named by the
  row. Their "MAC" is a name, and the log's MAC parser dropped them, so the one
  beep a flood makes was missing from the record.
- **Bench, both boards:** a transmitter sending one fake per second across all four
  types tripped every type in about 80 s on the S3 and the C5. Before it trips, each
  fake still beeps once (about 9-10 per type, because an address has to go quiet for
  30 s before it counts; the spec's cuts are starting values, to be tuned from field
  logs). After that the alert count stayed flat for the rest of the flood. When the
  spammer stopped, each type released 5 minutes after its last evidence; the steady
  fake AirTag, silent while muted, then beeped exactly once. All four flood rows
  landed in the flash log, once each. One stationary fake AirTag for 5 minutes
  produced no flood row. The flood rows have no Hunt, Ring or Ignore buttons in the
  app, because they have no real address to act on.

### Added — Flock's solar battery by its own GATT services (signatures v11)

- **Two exact 128-bit UUID rules, "Flock battery (auth service)"
  `e8ccbb38-9532-46a8-9fe5-1814df172e6f` and "(safety service)"
  `20c944c1-add2-42d7-a638-967ee9a26ff6`, category Flock Safety, strength 80
  (beeps).** They come from the Flock camera firmware dump: the pole's Nordic
  battery pack hosts them. Flock's own 128-bit UUIDs, matched in full, so nothing
  else carries them. Expect them rarely: the camera holds the battery's link
  open, and a connected battery normally stops advertising, so only one whose
  link has dropped will show up. 0 in 173 captures so far.
- **The first 128-bit rules in the defaults, so the full-UUID path of the
  matcher was proven on hardware before shipping:** a temporary rule for the
  Nordic UART UUID each board advertises matched the other board on both the S3
  (NimBLE 1.4) and the C5 (NimBLE 2.x), confidence 80. selftest pins both rules
  at full length, since a truncated UUID would fall into the 16-bit branch.
- **Not taken from the same source:** Wi-Fi module vendors' OUIs (Lite-On, USI,
  Silicon Labs, Espressif), the Raven 0x3100–0x3500 range and a bare 10-digit
  serial as a name. We removed all three as false-positive sources before
  (signatures v2, v5, v7); a bare serial is what an iPhone's Nearby Info advert
  sends as its placeholder name.

## [0.6.0] — 2026-09-28 — It hears the attack gear, keeps a card, knows the time, and says why it crashed

Field note: the three attack detectors had one grocery-store false-positive
soak. Karma and BLE spam were clean at their first-cut thresholds; deauth was
raised to 30 after it, and 30 has been bench-tested but not re-soaked in the
field. Attack detection stays off by default.

### Added — attack detectors: deauth burst, karma/PineAP, BLE popup spam; pwnagotchi gzip on the C5

- **Three rate-based detectors join the Attack toggle: deauth bursts, karma/PineAP
  APs and BLE popup-spam floods.** All three are behind `{"attack":bool}` like the
  Flipper/Pineapple signature rules, category "Hacking gear" (generic beep, All tab
  only, never a camera tab), and share the once-per-appearance beep via
  `noteAlertForTarget`. Rows surface through a common `upsertAttackTarget()` and
  read "Deauth burst · N frames · ch X", "Karma AP · N SSIDs" and "BLE popup spam ·
  N MACs". Karma and BLE spam held their first-cut thresholds through a
  grocery-store false-positive soak (zero hits); deauth did not, see below.
- **Deauth: per-transmitter sliding window, 30 frames / 5 s, broadcast counts
  double.** The first cut was 10: a store soak (2026-09-28) logged 11 false
  alarms from ordinary access points at 11-24 frames per 5 s (clients being
  moved between radios), so it is 30 now, above that peak and still far below a
  real flood. The timestamp ring grew from 24 to 64 with it, and a
  `static_assert` keeps it larger than the threshold: a ring that can hold fewer
  timestamps than the threshold can never reach it, and the detector goes
  silently dead. Frames are bucketed by the transmitter's own MAC (802.11 addr2), not
  globally, so one flooding AP or attacker trips it without every other AP's
  ordinary deauths adding up against it. A broadcast deauth (addr1 =
  `ff:ff:ff:ff:ff:ff`) hits every associated client at once, so it is counted
  twice against the sender to reflect the larger blast radius of one frame.
- **Karma/PineAP: one BSSID answering probe responses for 4 or more distinct
  SSIDs inside 60 s.** A rogue AP impersonating whatever SSID a client asks for is
  the PineAP/karma signature; a legitimate AP only ever answers for its own SSID
  (or a small handful on multi-SSID hardware), so 4 distinct answers from one
  BSSID is already well past ordinary Wi-Fi. **Evil twin was deliberately not
  shipped** — the honest RF-only test for "is this AP impersonating a real one"
  doesn't exist without a second radio or a client-side view, and every
  discriminator we tried also fires on a legitimate mesh AP or a public hotspot
  answering the same SSID from several BSSIDs. Shipping a rule that alarms on
  ordinary infrastructure is worse than shipping nothing.
- **BLE popup spam: 8 or more distinct random MACs sending Apple Proximity-Pairing
  (0x07) or Nearby-Action (0x0F) adverts inside 5 s.** This is the Flipper-Zero
  "BLE spam" attack — the same popup-flood payload from a rotating cast of fake
  senders. **Public and static-address Apple gear is excluded (`!pubAddr`)** —
  the real devices sending these types constantly (an iPhone announcing a nearby
  action, an AirPods case) use stable addresses, and gating on address type alone
  (never payload count from one device) is what keeps a room full of real Apple
  hardware silent while a burst of fresh random MACs still trips it.
- **The decision logic is a pure header, `firmware/src/attack_detectors.h`, proven
  by host-side C++ tests before it ever runs on a board.** No ESP/Arduino headers,
  `<stdint.h>`/`<string.h>` only, so `firmware/test/attack_detectors_test.cpp`
  (`firmware/test/run.sh`, wired into `node app/selftest.js`) runs the exact same
  sliding-window and LRU-eviction code the firmware links, rather than a
  reimplementation that could silently drift from it. The window helper is
  `millis()`-wrap-safe by construction (`(uint32_t)(now - ts) <= windowMs`), the
  same form used everywhere else in this codebase that measures elapsed time
  against a free-running clock; the tests include a deliberate backward-time case
  to pin that. The per-transmitter/per-BSSID LRU keeps the actual burster's slot
  under sustained load rather than evicting it for a quieter but more recent MAC.
- **Thread ownership: deauth and karma state are touched only from the Wi-Fi
  promiscuous callback, BLE-spam state only from the BLE scan callback — both
  lock-free, no mutex in `attack_detectors.h` at all.** Only `upsertAttackTarget()`
  crosses into shared state, and it takes `watchersMutex` itself, the same rule
  every other write to `trackedTargets` follows.
- **The C5 pwnagotchi path now inflates a real gzip'd pwngrid advert, via a
  vendored MIT-licensed `tinfl`** (`firmware/src/vendor/miniz_tinfl.{h,c}`,
  inflate-only, `#if defined(CONFIG_IDF_TARGET_ESP32C5)` only). The C5's IDF 5.x
  ROM has no `rom/miniz.h` — that header only exists on the S3 — so the C5 could
  only ever detect an uncompressed test beacon while a real pwnagotchi (which
  gzips whenever it shrinks the payload) went silent. The S3 is untouched: it
  keeps using the existing ROM `tinfl_decompress`, no vendored code, no dep added.
- **A bench-only BLE-spam emitter persona (`blespam`) exists to prove the
  detector against something, and it never ships.** It lives under the gitignored
  `firmware/src/bench/emitter_main.cpp`, walled off from every real tier the same
  way the drone/Flock/AirTag personas are — it is not a re-introduction of the
  cut `ble_spoof` primitive, only a fake signal for the two-board bench rig.

- **Signatures v10 add eight "Hacking gear" rules, each weighted by what its
  signal proves.** The Flipper Zero case-colour service UUIDs
  (`3081`/`3082`/`3083` — its firmware's own constants) beep at 80. Its
  Bluetooth SIG company ID `0x0E29` and IEEE MA-L `0c:fa:22` — both
  registered to Flipper Devices, checked against the registries we ship —
  beep at 70; the MA-L is unproven on the air (a Flipper Zero reportedly uses
  a different, chip-derived BLE address), so it is a registry hint until a
  capture shows it. A name containing "flipper" lists at 60 without beeping: it is
  the default name, but anyone can type it, and a real Flipper also carries
  the UUID and beeps from that. The WiFi Pineapple's default management AP
  (`Pineapple_XXXX`) beeps at 70; the ESP deauther's default control AP
  (`pwned`) lists at 60, because "pwned…" is also a common joke network name.
  These strengths are a first cut and are expected to move after real-world
  use. Values via SquachWatch-CYD, no code taken.
- **The Attack toggle now gates every rule filed under "Hacking gear", on all
  three rule paths.** `ruleGatedOff()` skips such a rule in the BLE matcher,
  the Wi-Fi OUI loop and the SSID-prefix pass while Attack is off, read live:
  new matches start or stop on the next advert (a device already listed stays
  listed until it goes stale, as pwnagotchi rows always have). The rules still
  load, persist and show in Settings > Signatures. One switch, one meaning —
  "tell me about attack tools" — because Flippers are common hobby gear, and
  an always-on beep would cry wolf at every conference and makerspace. The
  pwnagotchi detector uses the same `HACKING_GEAR_CATEGORY` constant. An
  operator who renames a rule's category makes it always-on; that is their
  call.
- **`80:E1:26`/`80:E1:27` list, but never as "Flipper".** These prefixes,
  which circulate between detectors as Flipper's, are ST's STM32WB address
  derivation — reportedly what a real Flipper Zero uses, but shared with other
  STM32WB hardware. They are in no IEEE registration, so they ship as
  "STM32WB address (Flipper Zero uses this)" at 60: listed, no beep, Attack
  on only. `selftest.js` allowlists exactly these two unregistered prefixes,
  with the reason, and fails if either is renamed "Flipper…" or raised to beep.
- **What was deliberately left out.** ESP32 Marauder's Flipper company ID
  `0x0FBA` belongs to a headset maker; and
  Hak5's `02:13:37`/`02:C0:CA` are locally administered, so anyone can set
  them (the loader rejects such OUIs by design). `selftest.js` refuses
  `0x0FBA`, and now pins every default company-ID rule to `bt-company.txt`
  by name (Flipper, Luxottica, Snap) — the same guard the OUI rules already
  had against the IEEE registry.

### Added — crash report: coredump partition, breadcrumb, CMD:CFG (idea from SquachWatch-CYD)

- **A new 64 KB `coredump` partition (`0x600000`) carves out of the end of
  `app0`, which shrinks from `0x600000` to `0x5F0000`.** `nvs`, `otadata`,
  and the LittleFS partition (`0x610000`/`0x1F0000`) are untouched. Both
  frameworks already build with `CONFIG_ESP_COREDUMP_ENABLE_TO_FLASH` + ELF +
  CRC32 and task-watchdog panic — the partition was the only missing piece,
  so this ships the storage IDF was already trying to use. Upgrading rewrites
  the partition table (the web flasher, `install.py`, and `pio run -t upload`
  all write `partitions.bin` at `0x8000`); bench-measured 2026-09-26: both
  boards kept their BLE name, beep mask, LED/theme, all 73 v9 signature
  rules, and the S3's alert log (345 records) across the upgrade with no
  erase needed.
- **`crash_report.{h,cpp}` keeps two independent pictures of the last crash:
  a no-init breadcrumb, and IDF's own core dump summary.** The breadcrumb
  (`__NOINIT_ATTR`, not `RTC_NOINIT_ATTR` — that section can expand to
  nothing on the C5) holds uptime, internal free heap, and target count,
  written once a second from the detector's 1 Hz tick and re-armed at boot.
  A magic value gates whether it's believed: a power-on leaves the section
  random, so `crashReportInit()` only trusts it after a panic/watchdog reset
  (`esp_reset_reason()` 4-7) and only when the fields are individually
  plausible (a half-surviving image can carry the magic with garbage behind
  it). The magic is written last, after a compiler barrier, so a crash
  between the field writes and the magic write can never pass the check with
  a torn breadcrumb; the target count is also clamped on the write side, for
  the same reason. A crash before the first tick reports "no breadcrumb"
  rather than fabricating up=0/heap=0 as if they'd been measured. The dump
  summary (task, PC, backtrace, ELF SHA) is read only when
  `esp_core_dump_image_check()` passes, and never on an RTC-watchdog reset
  — that dump belongs to an older crash, since an RTC-watchdog reset writes
  no new one. Known gaps: a panic whose dump write itself fails leaves the
  previous valid image in place, which then gets reported as this crash's;
  the breadcrumb freezes during a Site Survey capture (the 1 Hz task deletes
  itself for the duration); and the `[CRASH]` USB line can be lost to the
  S3's USB re-enumeration at boot (it came through cleanly on the C5) — so
  `CMD:CFG`'s `crash` field, not the USB line, is the reliable witness.
- **The backtrace is architecture-shaped, not padded to look symmetric.**
  The S3 (Xtensa) gets up to 4 on-device backtrace frames (a leading frame
  equal to PC is skipped, and the array is empty if IDF flags the backtrace
  corrupted); the C5 (RISC-V) cannot backtrace on device at all, so it
  reports only the return address (`ra`) as one frame. On an `abort()` or a
  failed assert (the C5's `bt.c:562` Bluetooth panic is one) both PC and
  `ra` land inside IDF's `panic_abort`, so the C5 also reports the panic
  message the dump carries, as `reason` (IDF 5 only; absent on the S3):
  bench-measured, `CMD:ABORT` gave "abort() was called at PC 0x4200884d",
  and that address decodes to the calling line while the saved PC decodes
  to `panic_abort`. An illegal instruction carries no message. `CMD:CFG`'s `crash`
  object carries `task`, `pc`, `bt` (frames, possibly empty), and — only
  when the breadcrumb was trusted — `up`/`heap`/`tgt`; `dump` says whether a
  usable core dump exists, and `same` compares the dump's stored ELF SHA
  against the running image's, truncated to however many hex chars the dump
  actually kept (8 on the C5, 16 on the S3 — comparing a fixed 16 would call
  every C5 crash "different firmware"). `same` is omitted, not false, when
  the dump carries no SHA at all. The whole `crash` key is present in
  `CMD:CFG` only after a crashing boot, and only until the next normal boot;
  absent means either "didn't crash" or "firmware too old to report it" —
  the app never tries to tell those apart.
- **App: Settings > Device identity shows "Last crash (`<reset reason>`): …"
  with a Copy button.** The line names the reset reason in words (panic /
  interrupt watchdog / task watchdog / RTC watchdog), then the task and a
  human uptime/heap summary when the breadcrumb was trusted, falling back to
  "no details" rather than printing `NaN`/`undefined` when it wasn't; it
  flags "no core dump" or "(older firmware)" as appropriate. Copy puts the
  full JSON — including the board name — on the clipboard for
  `addr2line`/`esp-coredump` against the matching ELF. `lastCrash` belongs
  to one board: it's cleared in `clearLiveState()` on disconnect, the same
  rule as the ignore list, so a board swap can't paint board A's crash onto
  board B's Device page.
- **Bench trap: a store to NULL does not fault on the ESP32-C5** — nothing
  guards address 0 there, so the first `CMD:CRASH` test on the C5 silently
  did nothing while the identical test panicked the S3 cleanly. The bench
  hook is `__builtin_trap()` (an illegal instruction) instead, which crashes
  both. Bench results (2026-09-26): S3 `CMD:CRASH` → reset 4, `crash` in
  `CMD:CFG`, PC decodes with `xtensa-esp32s3-elf-addr2line` to
  `sweepCrashTest()` in `main.cpp`, backtrace `loop()` → `loopTask`, dump
  27.8 KB of 64 KB. C5 → reset 4, `[CRASH]` line seen, PC → `sweepCrashTest()`,
  `ra` → `loop()`, dump 13.4 KB of 64 KB. A normal reset (SW 3, USB 11,
  esptool 0) clears the report, and a build without
  `CONFIG_ESP_COREDUMP_ENABLE_TO_FLASH` simply ignores `CMD:CRASH`.
- **The bench hook is bench-only, deliberately: `-DSWEEP_CRASH_TEST` gates
  `CMD:CRASH` (USB-only, routed in `loop()`), and it never ships.**
  `selftest.js` strips the `#ifdef` blocks across the four sources that use
  it and fails if `CMD:CRASH` survives that strip or if `platformio.ini`
  sets the flag for a shipping env.
- **Reading a full backtrace off a real crash needs the flash, not just
  `CMD:CFG`.** `python -m esptool --chip esp32c5 --port COMx read-flash
  0x600000 0x10000 cd.bin` (esptool 5 on the C5 toolchain; the S3's
  esptool.py 4.x uses `read_flash` with an underscore), then
  `esp-coredump info_corefile -t raw -c cd.bin firmware.elf`. Erase
  `0x600000` (`erase-region 0x600000 0x10000`) after a bench crash test and
  before a soak, so a failed real crash later can't be mistaken for the old
  bench test's dump.
- Idea credit: SquachWatch-CYD (already listed in `CREDITS.md` — this adds
  the crash breadcrumb to that entry's list of borrowed ideas).

### Added — per-device Ignore (idea from SquachWatch-CYD)

- **A device can now be silenced individually, on the board, without touching
  the shared signature rule that matched it.** Muting a whole category (the
  beep mask) was the only lever before this — turning off Trackers to stop
  your own Tile from beeping also silences every planted AirTag you're
  actually looking for. Ignore is per-MAC instead: `{"ignore":mac}` /
  `{"unignore":mac}` add or remove one entry in a fixed 16-slot NVS list
  (`sweep-st`/`ignore`, `IGNORE_MAX` = 16, `IgnoreEntry` = 6-byte MAC + 1-byte
  `AlertCategory`, `static_assert`'d to 7 bytes because `restoreWatchersState()`
  uses that size to validate the stored blob's length before trusting it as a
  whole number of entries — a mismatched length is dropped rather than read
  as garbage MACs). An ignored device is still detected, still listed, and
  still reported over BLE; it just never beeps, flashes, counts toward
  `alerts`, or writes an alert-log record — the same "still watching, just not
  telling you" shape as the beep mask and Hunt.
- **The gate is `isIgnoredLocked()`, called from the top of
  `noteAlertForTarget()` after the `CONF_ALERT_MIN` threshold and before
  `noteAlert()`, and it must not set `alerted`.** A plain early return would
  burn the once-per-appearance flag the same way a muted category must not —
  un-ignoring a device that's still in range has to sound it immediately,
  not wait for it to go stale and reappear. Checking after the confidence
  threshold means a sub-threshold advert never pays for the MAC parse (a
  stdio-free hex-pair parse shared with `alert_log.cpp`'s `alertLogParseMac()`
  — never `sscanf`, whose several-hundred-byte stack frame has no business on
  the scan/promiscuous callback paths this runs on). Every read and mutation
  of the list (`isIgnoredLocked()`, `addIgnore()`, `removeIgnore()`,
  `getIgnoreJson()`) runs under `watchersMutex`; the NVS write in
  `persistIgnore()` takes a snapshot under that same lock and writes it after
  releasing it, so a USB command in `loop()` and a BLE command on the NimBLE
  host task can't race each other into flash. A 17th add is refused outright
  (`addIgnore()` returns -1) rather than evicting the oldest entry — a device
  you deliberately chose to silence must not silently start beeping again
  because something newer pushed it out.
- **`CMD:CFG`'s `ignore` array is present only when the board actually got its
  lock, never an authoritative empty list on a timeout.** This is the same
  rule as `buzzerEnabled`/`sdState`: a timed-out read must never be able to
  report a false state. `getIgnoreJson()` returns `false` (and adds nothing
  to the doc) on a 50 ms lock timeout instead of writing `"ignore":[]`, and
  the app treats an absent key as "unknown" and keeps whatever it last
  painted. `ignore_full:true` rides the same CFG reply, once, only on the add
  that hit the 17th-entry refusal, and is distinct from the lock-timeout
  code — the app must be able to tell "list is full" from "couldn't check."
  The list itself does **not** ride the 1 Hz push (CFG-only), so unlike
  `beep_mask`/`led`/`theme` it cannot self-heal from the next push if a reply
  is lost — a lock timeout just leaves the phone's copy stale until the next
  successful `CMD:CFG`.
- **App: the Ignore/Unignore button is offered only on a stable address** —
  `stableMac()`: a BLE public address, a Wi-Fi MAC with the locally-
  administered bit clear, or a BLE random *static* address (top two bits
  `11`, which a Tile keeps for days) — never a rotating private address,
  because an ignore that silently expires when the address rotates out from
  under it is a lie. The button lives in `actionRow()` alongside Hunt/Ring,
  independent of the tracker/foxhunt gate that controls those (Ignore is a
  per-device opt-out, not a foxhunt tool), and is painted only from the
  `CMD:CFG` echo — never optimistically on the tap, the same rule as the
  sound toggles. Tapping it goes through a deliberate `confirm()`, not a
  bare click, and an ignored row dims (`.scope-row.ignored:not(.hunted)`,
  ordered after the hunted-row rule so a hunted-and-ignored row still reads
  as hunted) with an "ignored" chip beside its name. Settings > Alerts lists
  every ignored device (`Ignored devices (n/16)`) as one button per entry
  (`<category> <mac> ✕`) that unignores on tap, usable even while the device
  is out of range, and `ignore_full` shows a toast.
- **`ignoredMacs` is cleared on disconnect, unlike `beep_mask`/`led`/`theme`.**
  Those three ride every 1 Hz push, so a lost write self-heals within a
  second against whichever board is now connected. The ignore list is
  `CMD:CFG`-only and may be legitimately omitted on a lock timeout, so it has
  no such self-correction — leaving it set across a disconnect risked
  painting board A's ignored devices onto board B the instant B's first CFG
  reply happened to omit the key. `onDeviceDisconnected()` now resets it
  alongside the rest of `clearLiveState()`'s live session data.
- Idea credit: SquachWatch-CYD (already listed in `CREDITS.md` from the
  signatures v9 / sigs-audit work — this reuses that entry rather than adding
  a second one).

### Fixed — Settings > Signatures loads over Bluetooth on the S3

- **A bulk reply now waits as long as the link needs, not 300 ms.** The rule
  list (~10 KB, about 20 notifications) arrived as exactly its first 12 x 512
  bytes -- the S3's mbuf pool -- and the app discarded it as torn, so the
  Signatures page sat on "Reading the rules..." over Bluetooth while working
  over USB and on the C5. Measured on the bench: the S3 on a phone link frees
  roughly one 512-byte notification every 300 ms, with single waits up to
  493 ms, so `notifyChunk()`'s 300 ms give-up fired on every bulk reply.
- **The short bound stays where it is needed.** On the NimBLE host task (a
  reply sent from inside the write callback) the wait can never be satisfied,
  because that task is the one that frees the pool; there it still gives up
  after 300 ms. Everywhere else it waits up to 2 s (about 4x the worst wait
  measured). `onWrite` records the host task so `notifyChunk()` can tell.
- Cost: a bulk reply holds the send lock for its whole transfer (~3 s for the
  rule list), so the 1 Hz push waits behind it -- delayed, not lost (57 of 60
  pushes in a 60 s soak with one rule-list load; 3 of 3 loads complete on
  both boards).

### Changed — signatures v9: per-rule strength, SSID prefixes, exact UUID matching

- **A rule can now carry its own `weight` (1-100), replacing the per-condition
  sum for that rule on both the BLE and Wi-Fi OUI paths.** Before this, every
  condition on a rule added its own fixed weight (`W_OUI`, `W_NAME`, etc.), so
  a rule that matched on OUI *and* name scored higher than one that only had
  an OUI to go on, with no way to say "this OUI alone is enough" or "this OUI
  alone is not." A registered-maker OUI with no other tell now lists at 60
  without ever beeping (`CONF_ALERT_MIN` is above it), while a rule the
  operator trusts can be set to beep on the OUI alone. Both `weight` and the
  new `ssid_prefix` (below) survive a rule set pushed from the app
  (`updateWatchersSignaturesJson()`). **On Wi-Fi, a rule's own `weight` only
  ever replaces the OUI/SSID-prefix weight when the rule has no other
  condition** (`mfg_id`/`device_name`/`service_uuid` are BLE-only fields the
  Wi-Fi callback cannot evaluate) — a rule stating one of those got its full
  `weight` from an OUI or SSID-prefix hit alone for a while, which is a
  partial match scoring as if every condition had matched; a rule with an
  `oui` is also now required to match on the SSID-prefix pass, not just the
  prefix.
- **`ssid_prefix` matches the start of a beacon or probe-response SSID, is
  case-sensitive, and is Wi-Fi only.** A rule that sets it is never checked
  against BLE. Default weight is `W_WIFI_SSID` (80) unless the rule overrides
  it. This is how the Axon body-cam pairing SSIDs (`AB2-`/`AB3-`/`AB4-`/
  `AXON-`) are detected — they're prefixes on a name that includes a random
  suffix, which a plain `device_name`/`ssid` exact match can't express.
- **Service UUIDs match exactly, never as a substring — the v5 Raven "3100"
  lesson.** `uuidMatches()` accepts a 4-hex rule against that 16-bit UUID or
  its Bluetooth SIG base 128-bit expansion, and a longer rule only against an
  equal full UUID. The old substring match meant a short UUID rule could fire
  on any longer UUID that happened to contain those hex digits anywhere in
  it — a false-positive class that looked like "this rule sometimes fires
  on the wrong device" with nothing wrong in the rule itself.
- **`SIG_SCHEMA_VERSION` bumped to 9.** New default rules: `b4:1e:52` (Flock
  Safety, now its own named rule rather than living only in the community
  `flockOuis[]` loop — it stays in the app's `FLOCK_OUIS` too, so the
  selftest parity pin covers literal "Flock Safety" rules as well),
  `d4:11:d6` (ShotSpotter/SoundThinking) and `00:25:df` ("Axon Enterprise
  device") list at weight 60 without beeping; the four Axon pairing SSID
  prefixes beep at 80; smart glasses score 70 under a new "Smart glasses"
  category — Ray-Ban/Oakley Meta requires Luxottica company ID `0x0D53` AND
  Meta's service UUID `fd5f` together (an upstream detector found either
  signal alone is a false-positive magnet: `fd5f` is plausibly on Meta's own
  Quest headsets too), Snap `0x03C2` alone stays as-is — routed to the
  body-cam alert pattern through the
  `glasses` keyword in both `alertCategoryFromName()` (firmware) and
  `categoryOf()` (app) — Meta's own `0x01AB`/`0x058E` are deliberately left
  out, because those are Quest headsets, not glasses anyone is wearing while
  walking around recording. Label-only (30, never beeps) additions: Motorola
  Solutions (five blocks), Verkada, Avigilon Alta, Axis (two blocks).
- **Trap: three of our own "Sierra Wireless" OUIs were never Sierra
  Wireless.** A registry check (below) turned up that the three prefixes
  filed under that name actually belong to Fiberblaze, Bitworks and an
  unregistered block; replaced with the six IEEE-registered "Sierra
  Wireless, ULC" blocks. Also annotated in the community list: `b8:35:32`
  is unregistered and `48:27:ea` is Samsung, not whatever it was assumed to
  be — both are now labelled honestly rather than silently wrong.
- **Every literal default OUI rule is now checked against the IEEE registry
  at build/test time.** `app/selftest.js` resolves each default rule's OUI in
  `app/public/oui.txt` and fails if the registrant doesn't match the rule's
  own name (24 rules covered, `OUI_OWNER`). This is what caught the Sierra
  Wireless mislabelling above, and it's the mechanism intended to keep the
  next hand-added rule from drifting the same way — a wrong vendor name on
  a real OUI is worse than no name, because it tells the operator the wrong
  thing about hardware they're standing next to.
- Credit: the idea of grading a signature by its registered owner, the Axon
  pairing SSIDs and the smart-glasses IDs came from SquachWatch-CYD (see
  `CREDITS.md`) — re-verified against the registries rather than taken as
  code, which is what surfaced two of *their* Axon OUIs being wrong (one
  unregistered, one a module maker's block) as well as our own Sierra
  mistake.
- Settings > Signatures now shows both new fields per rule: "SSID starts
  `<prefix>`" in place of the old exact-SSID line, and a strength readable on
  every rule, not only ones with an explicit `weight` — `ruleStrength()`
  computes it the same way the firmware would (explicit `weight`, else 80 for
  `ssid_prefix`, else the summed per-condition weights, capped 100), labelled
  "strength N (beeps)" / "(listed, no beep)" / "(label only)" for the
  70/60/below-60 bands, so the 60-vs-80 distinction above is readable on the
  phone instead of only in the JSON.
- `#beep-bodycam` in Settings > Alerts is relabelled "Body cam & smart
  glasses" to match the new category routing.

### Added — an optional SD card: a richer log, and captures without the cable

- **A microSD reader is now an optional accessory, like the buzzer, LED bar
  and RTC.** `sd_store.{h,cpp}` probes SPI (`SPI.begin(D8, D9, D10, D3)`,
  `SD.begin(D3, SPI, 4000000)`) once in `setup()`, after `alertLogInit()` and
  `rtcInit()`; absent means `SD_NONE` and nothing else changes. `CMD:CFG`
  gains `sd` (0 none, 1 ok, 2 error, 3 full) and `sd_free` (MB); neither
  rides the 1 Hz push. Everything lives in `/SIGSWEEP/`.
- **Trap: card files are 8.3 upper-case names, not because the core can't do
  long names.** Long-filename support is on in both cores
  (`CONFIG_FATFS_LFN_STACK`), but a long name silently failed to write on
  the first card we tried (a Raspberry Pi-partitioned SDHC) — no error, the
  file just never appeared. `LOGnnnnn.CSV` / `CAPnnnnn.SSC`, validated
  against `^[A-Z0-9]{1,8}\.[A-Z0-9]{1,3}$` and always resolved inside
  `/SIGSWEEP/`, sidesteps it entirely.
- **Trap: card I/O never runs on the NimBLE host task, and capture start
  moved off it too.** `processIncomingCommand()` already can't afford a
  >few-hundred-byte local or a bulk reply (see the two traps below it in
  this file); a card write is tens of milliseconds on top of that. `CMD:SD:*`
  only set flags in the router; `bleSerialTick()` (from `loop()`) does the
  actual mount, list, read and delete. `requestCapture()` had the same
  problem one layer up — starting a capture stops the detector, allocates
  PSRAM rings and spawns an 8192-byte-stack drain task, all far too heavy for
  the host task — so `CMD:CAP:START` (BLE or USB) now only queues the
  request, and `captureTick()` in `loop()` starts it. `sdState()`/`sdFreeMB()`
  are the one deliberate exception: they're lock-free single-word reads so
  `CMD:CFG` can read them from the host task without ever waiting behind a
  slow card write.
- **The card log is a CSV, one file per boot, with no coordinate column —
  ever.** `boot,secs,utc,mac,category,rule,name,ssid,channel,role,vendor_id,
  confidence,rssi`. It's the same events as the flash alert log (what the
  buzzer sounded, respecting `beep_mask`; hunt and the easter egg suppress it
  the same way), just with room for the fields the flash log's fixed 16
  bytes can't hold. No user position, no drone or operator position — a
  drone within about a kilometre is close enough to be the user's position,
  and this device's whole point is not logging where it's been. `utc` is
  blank until the board's clock is known, then dated from an `#anchor,<epoch>`
  line appended when the time arrives, the same idea as the flash log's
  epoch anchor. **The flash log is unchanged** — the card is additive only;
  every existing behaviour with no card fitted stays exactly as it was.
- **Captures can now be started from the app with no cable.**
  `CMD:CAP:START:<secs>:SD` writes to `/SIGSWEEP/CAPnnnnn.SSC` in exactly
  today's `.sscap` format (the same `#SSCAP v1 ...` header and base64 record
  stream), so `analyze-capture.py` and the app's analyzer read a card
  capture unchanged. A BLE-started capture needs a card — there is no BLE
  bulk-stream fallback, the same reasoning that keeps `CMD:LOG:READ` off the
  router. A card pulled or filled mid-capture stops the capture, keeps what
  was written and resumes the detector; the error frame is terminal (no
  trailing `done`), so an app watching for the finish doesn't quietly delete
  a good partial file. **Trap: FatFs writes a file's size to its directory
  entry only on sync or close,** so an unsynced capture read back as 0 bytes
  after a power cut or a pull however much had been written; the drain task
  now calls `sdStreamSync()` once a second (the data itself stays batched),
  which is what makes "keeps the partial file" true. The file being written
  is not readable or deletable until it closes: `CMD:SD:GET` answers
  `{"sdget":{"err":"busy"}}` and `CMD:SD:RM` `{"sdrm":{"err":"busy"}}`.
  A link lost mid card-capture tells you the board is still capturing,
  rather than claiming the capture stopped.
- **Never format a card, never delete a file on its own, never retry a
  failing card in a loop.** A write failure marks the card errored (or full)
  and every later call is refused until the next probe. It is "full" only
  if the card still reports a real size with no room left: a pulled card
  reads a total of 0, and calling that full sent people looking for space
  on a card that was gone, so it reports an error and `sd_free` keeps the
  last value the card gave. Getting a card back
  after an error is a deliberate re-probe (a fresh `CMD:SD:LS`, or a capture
  about to start), never automatic background retrying.
- Settings > Recording gets an SD card block: status, a file list (newest
  first), download (a BLE download of a large capture warns first — USB is
  fast, BLE is not) and delete. Downloaded captures land in the Survey list
  like any other `.sscap`; a downloaded log keeps the card's boot number in
  its name. Site Survey's Investigate offers "save to card instead" on USB
  when a card is present. A delete that fails answers on its own key,
  `{"sdrm":{"err":...}}` (bad name, busy, no such file, card error), and
  the app says so; a successful one answers with a fresh listing.
- **Trap: a card download trusts no page it can't add up.** BLE
  notifications are unacknowledged, so one `SDF:` line lost or garbled left
  a silent hole while the `next` offset carried on. Each `CMD:SD:GET` page
  now counts the bytes that actually decoded; if they don't equal
  `next - offset` the page is thrown away and asked for again (three tries,
  then "try USB"), and the file is saved only when the total equals the
  size the board reported. A page whose done frame never arrives is the
  same case: after 5 s the page is asked for again, not failed.
- **Root cause: BLE notifications were dropped silently in our own host,
  and sending now waits for room.** Link-layer delivery is reliable once a
  notification is queued; the loss was before that. `notify()` in
  NimBLE-Arduino (1.4.3 on the S3, 2.5.1 on the C5) ignores a failed mbuf
  allocation, and the S3's pool is 12 blocks, held by anything the
  controller can't take yet. A bulk reply beside the 1 Hz push emptied it
  and the rest of the burst vanished with no error. Pacing did not fix it:
  at 25 ms per line, a 3.9 KB log download on the phone still lost lines
  and every done frame. `sendBleSerial()` now sends each chunk with
  `ble_hs_mbuf_from_flat()` + `ble_gattc_notify_custom()`. On a full pool
  (`BLE_HS_ENOMEM`/`BLE_HS_EBUSY`) it waits 5 ms and resends the same
  chunk, for up to 300 ms. If it gives up, it drops the rest of that
  message, because a torn message is useless. Over BLE, a card or log line
  is sized to fit one notification (`(MTU-8)/4*3` raw bytes, clamped to
  48–768; whole 16-byte records for the log), so a lost line is lost whole.
  A card page is 8 lines, and USB lines stay 768 B. The done frame echoes
  its request offset (`"off"`), and the app ignores a header or done frame
  that belongs to a request it has already replaced. This is also the
  likely cause of the long-standing "an oversized push is lost" limitation.
  Measured so far: USB only (60 of 60 pushes in 60 s, a USB capture
  streams). BLE delivery with the fix is not yet measured on a phone, so
  that limitation stands until it is.
- **Fixed: the line size must also cap at the BLE attribute maximum (512
  bytes), not just the MTU.** At MTU 517 the raw formula produced a 513-byte
  `SDF:` line, one byte over what a single notification can ever carry, so
  the trailing `\n` went out as its own bare notification and a push landing
  in that gap tore the page; the line size now clamps to `min(MTU-3, 512)`
  before deriving the base64 length.
- `CMD:SD:GET` answers `{"sdget":{"err":"busy"}}` while a USB capture runs,
  because that stream owns the port. The capture's `CAP:` lines, its
  status frames and the `[ALERT]` line now go through the USB line mutex
  too.
- **Fixed: a pulled card listed as a healthy empty one** ("29.7 GB free,
  no files"). A failed open of the card's own directory (or of a file when
  the directory has gone too) now marks the card failed, and `CMD:SD:LS`
  re-probes once after a listing that failed, so a missing card reports
  "no card".
- **Trap: a torn message glues onto the next one unless the reassembler
  resyncs.** A push that lost a chunk had no newline, so the app's line
  buffer joined it to the reply after it and threw both away. Over BLE every
  message starts on a fresh notification, so a notification that opens a
  known message now drops the stale partial first (counted as a lost
  update). BLE only: a USB byte stream splits anywhere.
- **Trap: the USB mirror interleaved lines across tasks.** The 1 Hz push
  landed inside a 1 KB `SDF:` line, and a USB download came back 72 bytes
  long with the push's letters decoded as file data. Replies, the push and
  the hunt frame now write the USB mirror through one mutex
  (`sendUsbLine()`).
- **Bench-measured, not yet proven with a real phone in hand:** a 30 GB
  FAT32 card mounts in ~13 ms; SPI at 4 MHz writes ~360 KB/s; the capture
  drain task (8192-byte stack) had 5764 bytes free at the SD stop path. The
  BLE download-time estimate in the app is a guess pending a real timed
  download, the C5 hasn't been bench-tested with a card yet (its CS pad is
  D3/GPIO7, a boot-strapping pin — untested whether a reader on it changes
  boot behaviour), and whether a BLE-started capture holds the phone's GATT
  link on the one shared radio for the whole capture is still open.
- **Trap found during bring-up: a card inserted or disturbed while the board
  was already powered answered nothing to `CMD0`** (`Card Failed! cmd: 0x00`)
  until a full power cycle — a soft reset or reflash was not enough. If a
  freshly reinserted card doesn't mount, power-cycle the board before
  suspecting the wiring or the card.

### Added — an optional clock, and dates on the alert log

- **A DS3231 RTC is now an optional accessory, like the buzzer and LED bar.**
  `rtc_clock.{h,cpp}` probes I2C address `0x68` on D4/D5 (SDA/SCL, the same
  pads on both boards) once in `setup()`; absent means today's behaviour
  unchanged. `CMD:CFG` reports `rtc` (0 absent, 1 ok, 2 fitted but its
  oscillator stopped — the coin cell died, present but untrusted) and `epoch`
  (the board's current UTC, 0 until something has set it). Neither rides the
  1 Hz push.
- **The host is always the authority.** The app sends `{"time":<unix seconds>}`
  on every connect, and the board simply overwrites its system clock and the
  RTC — no comparison, no "whichever is newer." The one guard is a range
  check (2026-01-01..2038-01-19 UTC): a phone with a dead clock must not
  stamp 1970 over a good RTC. The upper bound is 2038, not some later year —
  the S3 Arduino toolchain builds with a 32-bit `time_t`, so anything past
  2038-01-19T03:14:07Z wraps in `settimeofday`/`mktime`/`gmtime_r` regardless
  of what the wire epoch holds. `rtcSetEpoch()` rejects anything outside that
  window and leaves the clock untouched.
- **Trap: the time push rides every `CMD:CFG` retry, not just the first.**
  Opening a USB port resets the board, so a single `{"time"}` sent once can
  land mid-boot and vanish with nothing to show for it. `requestConfig()`
  now queues `{"time":...}` immediately before `CMD:CFG` on each of its three
  retries (400 ms / 1.5 s / 4 s) — the CFG reply itself proves whichever push
  landed.
- **Trap: the board keeps UTC only, on purpose.** TZ is never set, so
  `mktime()` on the DS3231's registers is UTC by construction; the app
  renders local time from the epoch it already gets. If anything ever calls
  `setenv("TZ", ...)` the RTC read needs a `timegm`-equivalent instead.
- **The alert log gets real dates without changing its 16-byte record.**
  `alert_log.cpp` now writes one 8-byte anchor per boot to `/log/epochs.bin`
  (`boot` u16, pad, `epoch` u32) — `epoch_at_secs0 = time(nullptr) -
  secsSinceBoot` — whenever time becomes known this boot: from the RTC at
  boot, or from a host push. A later push overwrites that boot's own anchor,
  so earlier records in the same boot re-date correctly. This helps even
  with no RTC fitted: any phone that ever connects before power is lost
  dates that whole boot, and the anchor lives on the board, so a *different*
  phone (or `read-log.py`) can read it back later. Capped at 1024 boots
  (years of engine-starts); the oldest half drops when full.
- **Trap: the anchor write is deliberately never on the NimBLE host task.**
  `alertLogAnchorSoon()` only sets a flag; `alertLogTick()` (called from the
  1 Hz task, same as the alert-record write) does the actual LittleFS write.
  Anchoring straight from `rtcSetEpoch()` — which runs on the `onWrite`
  callback — would be the stack-overrun trap all over again.
- `CMD:LOG:READ`'s `logrd` header now carries `epochs` (one `{boot: epoch}`
  entry per boot present on that page) alongside `names`, so a boot the
  connected phone never witnessed still comes back dated.
  `firmware/tools/read-log.py` prints a `when (local)` column from it.
  `app.js`'s log-to-file path prefers the *current read's* board anchors over
  its own `logBootEpochs` guesses, falling back to the guess only for a boot
  this read has no anchor for (older firmware with no `epochs` header, or a
  boot the board itself never dated either). The board anchors are kept only
  in memory, per read, and never merged into `logBootEpochs` — that map is
  global and keyed on boot number alone, so persisting one board's anchors
  into it would silently mis-date the next board's records sharing a boot
  number.
- Settings › device identity gets a **Clock** line ("RTC fitted · synced" /
  "RTC fitted, lost power · synced · time from the phone until power off" /
  "No RTC · synced · time from the phone until power off"), painted from
  `rtc`/`epoch` in `CMD:CFG`.

### Fixed — a Flock SSID rule that beeped at ordinary networks

- **The Flock SSID rule is now exactly `Flock-` + 6 characters** (12 in all,
  case-insensitive). That is the only network name Flock's firmware builds
  (`WifiApService`: `"Flock-"` + the last 6 characters of the MAC). The rule
  also matched `fs_` and `pigvision` anywhere in a name. Those were Bluetooth
  *device-name* patterns, never network names, and as substrings they fire on
  ordinary SSIDs: lowercased, "Chiefs_Guest" contains `fs_`. On a real drive a
  Ubiquiti access point broadcasting three networks was logged as an ALPR.
  `app/selftest.js` fails if the rule matches a substring again.

### Fixed — Disconnect over Web Serial releases the port

- **Disconnect on the desktop Serial transport left the COM port open until the
  tab closed.** Nothing else could open the board (`read-log.py`, a flash, a
  second app) — `Access is denied` — and the board's goodbye chirp only came
  when the tab went away. Two faults. The port's streams are locked by the two
  `pipeTo()` pipes until they settle, and `port.close()` was called without
  waiting for them, so it threw "locked streams" into an empty `catch`. And
  cancelling the reader ends `readSerialLoop()`, whose `finally` nulls
  `serialPort` — racing the close line into a no-op. `disconnectDevice()` now
  takes its own references first, cancels the reader, closes the writer, awaits
  both pipes (kept in `serialPipes`), then closes the port. Verified on the
  bench: Disconnect with the tab still open, and COM3 opened from Python.

### Added — the board says why it last restarted

- **`CMD:CFG` carries `reset`, the chip's `esp_reset_reason()`** (4 panic,
  5-7 watchdog, 9 brownout, 11 USB). A board that restarts unattended leaves no
  other witness: the boot banner is lost while the USB port re-enumerates, and
  a crash backtrace only exists if something was logging the whole stream. The
  app raises one toast per boot when it connects to a board whose last restart
  was a panic, watchdog or brownout.
- **Trap: closing a serial port can reset the board.** pyserial raises DTR and
  RTS on open by default; when the holding process dies, Windows drops both, and
  the ESP32's USB-Serial-JTAG reads that as a reset request. A killed bench
  logger rebooted the C5 one second later, which looked exactly like the C5's
  known controller crash until `reset` read 11 instead of 4. Bench tools open
  with `dtr=False, rts=False` set before `open()`.

### Added — Flock's battery, and label-only hints for Flock's competitors

- **The Flock solar battery ("Penguin") is detected in code, not by a rule.** A
  published Falcon firmware dump (2026-09-21) settled what a deployed camera
  sends: nothing we can hear. Wi-Fi stays off on LTE, the camera never
  advertises BLE, and it holds a permanent link to its battery. The battery is
  the only radio on the pole, and it advertises only when that link drops.
  `blePenguin()` demands two facts: the full `Penguin-<10 digits>` name, or
  manufacturer ID `0x09C8` *plus* a 10-digit name or a `TN<digits>` serial in
  the payload. Scores `W_PENGUIN` (80) under Flock Safety. **Trap: a bare
  10-digit name is not enough.** Apple Nearby Info adverts carry the placeholder
  name `0102000000` (two in our own captures). Neither is `0x09C8` alone.
- **The standalone `0x09C8` rule is gone (schema v7).** At `W_MFG` it could not
  beep on its own, but it listed any XUNTONG device as Flock.
- **Flock SSIDs match the `flock-` prefix, not the substring.** The Falcon's
  hotspot is `Flock-` + the MAC's last six characters, and a substring match
  beeped for a TP-Link home router named "FlockNation" in our captures.
- **Genetec and Ubicquia ship as label-only hints (schema v8).** Genetec
  (AutoVu/Sharp ALPR: `00:0a:b1`, `00:bf:15`, `0c:bf:15`) and Ubicquia
  (streetlight camera/sensor nodes: `94:7b:be`) come from the IEEE registry,
  not from field captures. So they are vendor-prefix-only rules: `W_OUI` 30 sits
  under both the list gate (60) and the beep gate (70). They never beep, and
  they only name a row while the filter shows all devices. Their categories
  carry no routing keyword, so they sit under All, never the Cameras tab. They
  get promoted only when a Site Survey capture proves the hardware transmits.
  After Flock turned out to be RF-silent, an unproven prefix is a question, not
  a detection. `selftest.js` fails if either rule gains a non-OUI condition or a
  category that routes to a camera tab.
- Verified on all three bench boards (two S3, one C5): each reports schema 8
  with 55 rules, and each holds 30 pushes in 30 s after the flash.

## [0.5.0] — 2026-09-20 — Three tabs, an alert log on the board, and an LED scene that forgets itself

### Fixed — Bulk replies never arrived over BLE

- The Signatures page loaded nothing over Bluetooth, on the phone and in the
  hosted web app alike, while working perfectly over the USB cable. **Trap: the
  command router runs on the NimBLE host task (the `onWrite` callback), and that
  task cannot drain its own notification queue while it is blocked inside our
  callback.** A short reply like `CMD:CFG` fits in a notification or two and
  slips through; the `CMD:SIGS` readback is several KB — roughly twenty chunks
  with a yield between each — so the mbuf pool ran dry partway and the rest of
  the reply was simply dropped. Nothing errored, on either side. It hid for the
  life of the feature because over USB the same command runs on `loop()`, which
  is the transport the bench uses.
- `CMD:SIGS` and `CMD:LOG:READ` now set a flag that `bleSerialTick()` acts on
  from `loop()`. That also moves their work off that small stack: the signature
  reply built a `JsonDocument` plus a multi-KB `String` there, and the log read
  does LittleFS reads and two allocations. **Anything answering with more than a
  couple of notifications belongs on `loop()`, not in the router** — and it must
  be tested with a real BLE connect, because USB cannot reproduce the failure.
- **Second bug, found on the way out: `sendBleSerial()` had no lock.** Moving a
  bulk reply onto `loop()` put it in a race with the detector's 1 Hz push from
  its own task, and because the app reassembles pushes on newlines, interleaved
  chunks would hand it two half-JSONs and it discards both — the same silent
  "the device found nothing" symptom an oversized push produces. One mutex
  around the chunk loop, so there is one writer at a time whoever calls it.
- Verified over serial on both boards: the signature readback returns 52 rules
  with zero corrupt lines, and the log readback answers its header and `done`
  frames cleanly. The multi-line log case is not yet exercised on hardware.

### Changed — Transient device state, and two bench traps

- Added a device command that is deliberately the **opposite** of every other
  piece of operator state: it writes no NVS, is absent from `CMD:CFG` and from
  the 1 Hz push, and expires itself after five minutes, with the app refreshing
  it while it is in use. Everything an operator sets must survive a power
  cycle; this must not. A board wired into a car that came back from an
  engine-stop still in this state would be the headless rule exactly inverted,
  and the firmware's own timeout — not the app — is what makes that impossible.
  It is therefore the one control the app paints optimistically, because the
  device is deliberately not the authority on it.
- It takes over the LED bar while set: it outranks the whole render chain,
  bypasses the LED-mode block, and bails out of `applyTheme()` **from inside
  the function rather than at the call site**, because `selftest.js` pins the
  literal `if (!flashActive) applyTheme(now)`. `noteAlert()` returns false
  throughout, beside the identical line the hunt target uses, so the beep, the
  animation, the alert count and the log record stop together and the alert log
  keeps matching what you actually heard. Nothing is recorded, so the `alerted`
  flag stays clear and a device still nearby sounds again the moment it ends.
- **Bench trap: a XIAO S3 enumerates as native USB CDC, so toggling DTR/RTS
  does not reset it.** A script that "reboots the stimulus board" that way
  silently does nothing and the run still prints a clean-looking zero, which
  reads as a passing test. Reboot a board by writing `{"ble_name":...}`
  (`requestReboot()` is unconditional) or by pulling power.
- **Second trap from the same run: a stimulus rule filed under a category the
  board's `beep_mask` has muted measures the mute, not the code.** A muted
  category is fully silent by design — the board was on mask 23, which has the
  tracker bit clear, so a tracker-category rule produced zero alerts and looked
  exactly like a broken detector.

### Fixed — Terminal green was blue-green

- The Terminal theme was `{20, 255, 60}` — three times as much blue as red,
  which is spring green heading for teal, not phosphor. Balanced to
  `{30, 255, 30}`, and the app's matching CSS carried the identical skew
  (`#33ff66`, blue double red) and now agrees with the bar.
- Worth recording because of what it is *not*: a colour-order mismatch. If the
  bar were secretly RGB rather than `NEO_GRB`, green would come out **red**,
  not teal. Blue-green means blue in the numbers.

### Fixed — Back left the app instead of leaving the page

- Back minimized from anywhere, so backing out of Settings › Recording put you
  on the home screen. As far as the hardware button was concerned the app had
  one screen; the tabs and sub-pages it grew were invisible to it.
- `handleBack()` answers in the order a person means it: dismiss what is on
  top, then leave the sub-page, then leave the tab, and only then return false
  so the caller may background. The consent prompt is handled by name rather
  than as a generic overlay, because it owns a queue — hiding its card without
  shifting it would strand every device behind it. Escape on the desktop runs
  the same chain, so the two agree.
- It still never `exitApp()`s: that killed the page but not the process, so the
  BLE link and the USB port outlived the UI that owned them.
- The on-screen back control is now a pill the shape and colour of the header's
  Connect button, placed *before* the page title so it reads as a breadcrumb
  (`‹ Settings   Recording`). It was a small right-aligned text link, which did
  not read as the way out — presumably why the hardware button got used for it.

### Added — Answer the pin prompt for a whole category

- The prompt was Yes or No, one device at a time. The moment you know you do
  not care about a whole category *is* that prompt, and making it a dead end
  sent you to Settings to say what you had already decided. A third answer —
  **"No — and stop asking about trackers"** — names the category and silences
  it there.
- `pinMute` composes with `pinLens` rather than replacing it: the band tab
  picks *one* category to ask about, this subtracts categories from Everything.
  Muting drops every queued device of that kind too, or you tap through the
  backlog you just refused. The button's noun comes from a fixed per-key table,
  never `cat.label` — `other` labels itself with whatever vendor string tripped
  it ("Hacking gear"), and a button reading "stop asking about Hacking gear"
  would quietly mute every unrecognised category with it.
- The test sits *before* `handledMacs`, so un-muting brings devices back rather
  than skipping them for the rest of the session, and **Settings › Recording
  lists what is muted with a tap to undo** — a one-tap field decision has to be
  visible somewhere, or it is a prompt that mysteriously stopped working weeks
  later. The mute silences the prompt only: the category is still detected,
  still listed, still beeped.

### Fixed — Settings › Signatures showed nothing, and its one button threw

- The page was a sentence and an "Edit signature rules" button opening a raw
  JSON textarea. The button still called `getElementById('settings-modal')`,
  which stopped existing when Settings became a tab, so tapping it threw.
- It now lists the rules read off the board — name, category, and which field
  actually matches — fetched when the page opens, which is what "on demand"
  means for a reply too large to send on connect.
- **It also lists the protocol detectors first.** Drone Remote ID, Apple Find
  My, Tile, Pwnagotchi and the Flock wildcard probe are compiled in and match
  no rule at all, so a page showing only `signatures.json` implied the board
  cannot see a drone or an AirTag. That list is prose describing firmware
  behaviour: if the detectors change, it has to change with them.

### Changed — Three tabs, one Record button: the app's navigation rebuilt

- **Features had outgrown the navigation.** The main screen stacked six
  horizontal bands of chrome before a single result row (status strip, toolbar,
  scope head, band tabs, radio tabs, Wi-Fi role tabs), the header carried four
  icons, and ten overlays sat on top. Two of those overlays — the pin sheet and
  Site Survey — both started *recording sessions*, both held encrypted
  geolocated data behind the same PIN, and both exported, so which one you
  wanted was no longer obvious.
- **This was an information-architecture problem, not a framework one, and a
  rewrite was explicitly rejected.** `app.js` is behaviour — three transports
  and one line reassembler, the AES-GCM store, the capture analyzer, Leaflet,
  the hunt fast path, the device-authority paint rules — almost none of which a
  framework would delete; and `selftest.js` cross-checks every id-anchored
  selector in `app.js` against `index.html`, which a rewrite throws away. It
  earned its keep during this work: it caught two stale ids on the first run.
- **Three panels under one shared header, switched by a fixed bottom bar.**
  **Sweep** is live and moving; **Survey** is standing still and saving;
  **Settings** is what you set before you go. Every screen is one thumb-tap from
  every other, which is also the "back out" that a scrolling overlay with a
  small × never gave you. `showTab()` invalidates Leaflet's size when returning
  to a map that was `display:none` — it measures a hidden container as 0×0.
- **Recording is now one act.** There were two record mechanisms with two
  switches in one sheet, so "am I recording?" had two answers and you could
  easily be half on. One **Record** button on Sweep brackets an outing: Start
  turns the board's alert log on and arms the pin prompt; Stop reads the log
  back, writes the `.txt`, shows "what you passed" and disarms the prompt —
  unless it was already on beforehand, which the session remembers so Stop does
  not switch off something the operator set themselves. Stopping still never
  turns the board's own log off: the car case wants it logging after the phone
  is away. While running, the bar reads elapsed, alerts logged, pins dropped and
  which category is being pinned, ticking off the 1 Hz push rather than a timer
  of its own.
- **The separate "Pin which" picker is deleted.** It was a second control for a
  state the band tab already set (its own note said so), and two controls for
  one state only ever disagree. `pinLens` survives as a variable driven by the
  band tab; the Record bar states it.
- **Settings is an index of seven short screens, not one long scroll.** Alerts,
  Recording, Radios, Detection, Emissions, Device identity and Signatures each
  open their own page with a back link and the top bar naming it; Opsec is prose
  with no controls, so it stays a footnote on the index. This costs one extra
  tap to reach a control, accepted deliberately — these are set before you go
  out, and hunting down an eight-section scroll for one row was the worse trade.
  The live Alerts summary sits on its index row, so what is muted still reads at
  a glance without opening anything.
- **Alerts (sound, lights, theme, the five categories) moved into Settings.**
  These are set once before a hunt so you are not fiddling in the field, which
  makes them settings. The previous rule — that silencing a category must not be
  three taps deep — assumed Settings was a gear-icon modal; with a bottom bar it
  is one tap. The markup moved verbatim, so the ids and the device-only painting
  are untouched. **Accepted cost, decided deliberately:** there is no longer a
  sub-3-tap way to silence a beeping board, and BOOT is factory-reset, not mute.
- **Saved pins moved into Survey, beside the logged finds.** Same encrypted
  store, same PIN, same kind of record — the only difference is that one came
  from driving past and the other from standing at the pole with a camera. One
  unlock now serves both lists and one wipe covers the one store (it always took
  the finds and their photos with it — now it says so). Opening Survey still
  never prompts for the PIN. **Deliberately not merged: the exports.** A find is
  a photographed confirmation, a pin is a drive-by guess, and one export button
  would put guesses in `cameras.osm`. We never tag a guess onto OpenStreetMap.
- **The radio tabs and Wi-Fi role tabs became one row**, three chips at rest
  (All / BLE / Wi-Fi) and five once Wi-Fi is the chosen radio — AP and Client
  mean nothing under All or BLE, and five chips at rest was simply too many to
  read. They appear *in* the same row, never a second one: the old sub-row
  appeared and vanished with the Wi-Fi tab and moved every result below it by a
  row mid-scan. The strip's height is pinned (`#radios .radio-tab`
  `min-height`) because the five-up chips take a smaller face to fit 412 px and
  a smaller face is a shorter line box — 1.3 px of drift before it was pinned,
  0 px after. The row is `.radios.five`, an explicit modifier: `.radios` is a
  three-column grid shared with the segmented pickers, and redefining it would
  have stretched those — the same class reuse that once stretched the channel
  chips while the node self-test passed.
- **The three-cell status strip folded into the header's connection line**, and
  the GPS readout appears only when there is something to say (it read
  "Location: Off" approximately always and owned a third of that card). The
  transport shortens to BLE/USB/Serial, and the **name** is what gives when the
  line is tight, never the numbers: a default board name is 19 characters
  ("OUI-SPY-SIGNALSWEEP") and letting both shrink cut the alert count mid-word
  on the phone, which is the one thing there you cannot guess the rest of.
- **`scan_all` reads its state instead of a toggle name** — "Matches only" /
  "All devices", in the scope head beside Map. It was "Filter: On/Off", which
  meant the opposite of what it said (`foxhuntMode === true` means the filter is
  *off*) and collided with the radio chips for the word "filter". With Alerts
  moved out, the toolbar row is gone entirely.
- **The two connect buttons are adjacent.** The "tap BOOT to make it visible"
  hint sat between them, putting troubleshooting in the way of the button you
  came to press; it is read once and remembered, so it moved down to the
  support block beside the USB note.
- **The Help modal is deleted.** Its content was duplicated everywhere it
  mattered — the beep legend in the Alerts rows, opsec in Settings, pins in
  Record — and its one unique line ("it still beeps without the phone") already
  sits in the disconnected empty state.

### Fixed — A recording bookmarked the board's clock as of *connect*, not as of Start

- `log_boot`/`log_secs` arrive only in the `CMD:CFG` reply, and the app asks for
  that exactly once per connection — the 1 Hz push carries only `log` (a bool).
  So the session bookmark was frozen at connect time: starting a recording an
  hour into a drive bookmarked an hour ago, and Stop read back every alert since
  then, including everything from before the tap. Survivable while Start was a
  button buried in a sheet; not once Record is the primary control.
- `log_secs` is seconds since boot, which is exactly what `bootAt` (from
  `cfg.uptime`) already tracks, so the bookmark is recomputed at Start with no
  extra round trip and **no new field on the push** — telemetry is the tightest
  budget on the device and this costs it nothing. Confirmed against hardware,
  where a fresh board reported `log_secs: 11` against `uptime: 12`.

### Fixed — "Connecting…" was written to an element nobody could see

- Six call sites wrote `CONNECTING BLE...` / `RECONNECTING (Ns)...` into
  `#connStatusText`, inside a status badge that was markup-level `hidden`. A
  slow BLE connect therefore looked like a frozen app. Those states now paint
  the header's own connection line, and the badge is deleted.

### Fixed — The BLE command handler was overflowing the NimBLE host task stack

- **A phone connecting to the board could boot-loop it.** The BLE write callback
  (`onWrite` → `processIncomingCommand`) runs on the NimBLE host task, whose stack
  defaults to 4096 bytes, and the `CMD:CFG` reply builds JSON while doing several
  NVS flash reads — already close to that limit. Adding the alert-log command
  parsing enlarged the handler's stack frame (the compiler reserves space for
  every branch's locals, even the `CMD:CFG` path that uses none of them), which
  tipped it past the canary: the phone connects, the board panics
  (`Stack canary watchpoint triggered (nimble_host)`), reboots, the phone
  reconnects, and it loops. It was invisible until now because the board had only
  ever been driven over USB, where commands are processed on `loop()`, not the
  host-task callback.
- **The NimBLE host task stack is now 8192** (`CONFIG_BT_NIMBLE_HOST_TASK_STACK_SIZE`,
  both S3 and C5), and `sendAlertLog()`'s ~1 KB base64 buffer moved from the stack
  to the heap so a log readback — which also runs on that callback — cannot
  overflow it either. Verified on hardware: a phone connects and holds, a full
  Start→alerts→Stop session reads back 6 alerts (3 drone, 3 camera) and writes the
  `.txt` with no panic.

### Added — An alert log on the board's own flash, read back by the phone

- **The device now keeps a record of what its buzzer sounded — with no phone
  required.** The detector is headless and often unattended: wired into a car it
  runs whether or not a phone is present, and driving, you cannot look at the
  screen. Off by default, `{"log":bool}` / `CMD:LOG:ON|OFF` (persisted in
  `sweep-st`, echoed in `CMD:CFG` and the push, adopted by the app) makes it
  write every alert to LittleFS: a 16-byte record of time-since-boot, MAC,
  category and RSSI, plus a per-log rule-name table so the log carries its own
  names and editing the signature list later cannot mislabel an old log.
  **No position is recorded, by design** — the app's whole opsec property is that
  it keeps no passive trail, and times-and-MACs is the most that can be logged
  without rebuilding the `sightStore` that was removed.
- **It had to be the board, not the phone.** Android cannot auto-launch an app on
  a BLE GATT connection (that belongs to paired Bluetooth Classic devices like
  headphones), and keeping a backgrounded WebView alive with the screen off needs
  a foreground service with a permanent notification — which collides with this
  app posting none. A log on the board works with the phone dead, absent, or in a
  pocket, and it collapses the walk/bike case and the car case into one feature.
- **The ring has no stored write pointer, and that is the load-bearing trick.**
  A pointer would mean an NVS write per alert (flash wear on a device meant to run
  for months) and could still disagree with the data after a power cut, which
  this device suffers every time the engine stops. Instead a boot counter (one
  NVS write per boot) makes each record's `(boot, seconds)` key monotonic across
  power cycles, so the ring is a rotated sorted array and its head is found by
  binary search (~17 reads) at startup. When full it **wraps**, overwriting the
  oldest — losing old history beats missing the next device. Proven on hardware:
  a bench harness shrinks the ring and overruns it (27/27 checks — wrap
  boundaries, no gaps or duplicates, head recovered after reboot), and a real
  mid-write USB power-pull left the log intact with its ordering monotonic and at
  most the one in-flight record lost.
- **The write never happens on a radio callback.** `noteAlertForTarget()` runs on
  both the BLE scan and Wi-Fi promiscuous callbacks and only flags the target; the
  1 Hz task collects flagged targets under the mutex and writes them to flash
  *after releasing it*, because a LittleFS write is tens of milliseconds and the
  BLE callback takes that same mutex. The flag is set only when the alert actually
  sounded, so a muted `beep_mask` category and an active hunt write nothing — the
  log is a faithful record of what you heard. Telemetry stayed healthy through it:
  123 pushes in a 120 s soak with logging on.
- **The app reads it back over the existing pipe.** A ranged, chunked,
  resumable `CMD:LOG:READ:<boot>:<secs>:<skip>` streams base64 records the same
  way capture streams `CAP:` lines — a walk or a drive is tens to a few hundred
  records, seconds over BLE. Start/Stop in the Record sheet is an **app-side
  bookmark**, not a board mode: the board logs continuously either way, and Stop
  reads back the bookmarked stretch, writes a plaintext `.txt` to Documents
  (wall-clock times derived from the board's uptime, vendor names from the
  offline OUI tables), and shows a "what you passed" summary. Every field decodes
  faithfully — the 16-byte layout is pinned between firmware and `app.js` by
  `selftest.js`, because a byte-off record would be the Remote ID offset bug all
  over again: every field wrong, nothing visibly broken.

### Added — Pwnagotchi (pwngrid) detection, behind an off-by-default toggle

- **The detector now flags a nearby Pwnagotchi.** A pwnagotchi advertises itself
  to other units over pwngrid: Wi-Fi beacons from the fixed source
  `de:ad:be:ef:de:ad` carrying its advertisement (name, pwned count, grid
  version) in vendor information elements. A match lists under **All** as a
  "Hacking gear" row titled `Pwnagotchi '<name>' - <N> pwned` and sounds the
  generic alert. It is **not** a camera or tracker, so it never appears on those
  tabs.
- **It rides a new persisted toggle, off by default.** `{"attack":bool}` /
  `CMD:ATTACK:ON|OFF`, stored in `sweep-st`, echoed in `CMD:CFG` and the 1 Hz
  push, adopted by the app (Settings → Detection). Off by default because attack
  detection is attack-adjacent and its future rate-based detectors (deauth,
  karma) trip in busy places; the toggle gates them all.
- **The wire format was read from pwngrid v1.10.3 source, and it is
  gzip-compressed.** The advertisement rides IE 222 (`IDWhisperPayload`, chunked
  at 0xFF); IE 223 (`IDWhisperCompression`) = 1 means the payload is gzip, which
  a real advertisement is, because it shrinks. A first cut that parsed IE 222 as
  raw JSON would have detected only an uncompressed test beacon and **missed
  every real pwnagotchi** — the kind of gap that looks like a working feature on
  the bench and silence in the field. The S3 now inflates the payload with the
  ROM's `tinfl_decompress` (exported in `esp32s3.rom.ld` via `rom/miniz.h`) — no
  new dependency, no vendored code — with a file-static decompressor and output
  buffer kept off the promiscuous-callback stack. Verified end to end: a
  byte-faithful gzip beacon was detected in 41 of 41 telemetry pushes at
  confidence 100.
- **The C5 cannot gunzip yet, deliberately.** Its ROM (IDF 5.x) dropped miniz, so
  `rom/miniz.h` does not exist there; the gzip path is gated behind
  `PWN_HAS_GUNZIP` (`#if !defined(CONFIG_IDF_TARGET_ESP32C5)`). The C5 detects an
  uncompressed pwngrid advertisement but skips a compressed one until a portable
  inflate is vendored. Both build environments compile.

### Changed — The camera tab is strictly ALPR and mass surveillance

- **The Surveillance/camera tab now shows only ALPRs and mass-surveillance
  cameras (Flock, SoundThinking) plus body cams (Axon) — nothing else.** Before
  this, any device whose category the app did not recognise fell into the
  catch-all `other` bucket, which `inLens()` counted under the camera tab, and
  `LENS_MASK.alpr` even included the generic beep bit. So a police-car router
  (Cradlepoint / Peplink / Sierra), or any future unlabelled match, was listed
  under Cameras and could beep while you were on that tab — the `bandOf()` class
  of mistake, a weak or wrong hint being worse than none. The tab is now exactly
  the `alpr` + `bodycam` categories; everything else (fleet routers, and any
  category with no keyword) lives under **All** only, in the list and in the
  tab's beep preset.
- **SoundThinking / ShotSpotter is now named explicitly** in both
  `categoryOf()` (app) and `alertCategoryFromName()` (firmware) so it routes to
  the ALPR category and stays on the camera tab, rather than falling through the
  catch-all it no longer has. A new `selftest.js` check fails if the two keyword
  lists drift, since a mismatch would file a vendor under Cameras in the app
  while the firmware beeps it as generic — a silent camera on the camera tab.
- Body cams (Axon) stay on the tab (counted as mass surveillance here); fleet
  routers move to All-only, which falls out of the same change.

### Fixed — Connect tells you when Bluetooth is off

- **Tapping Connect on Android with Bluetooth off used to open an empty picker**
  with no hint why: the scan simply found nothing. The app now checks the radio
  first and raises Android's own "turn on Bluetooth" dialog; Allow goes
  straight on to the device picker. Deny opens the system Bluetooth settings
  page and stops, rather than scanning a radio that is off. Verified on the
  OnePlus with Bluetooth disabled over `adb`: both branches behave as described.
- **Location switched off no longer reads as a slow GPS lock.** `getFix()` used
  to show "Locating…" then "No fix", which sends you outside to wait for a fix
  that can never arrive. It now checks the system switch first, shows
  "Location is off" in the status strip, and opens the location settings page.
- **A refused Nearby devices permission points you at the fix.** After one
  refusal Android stops asking, so every Connect ended in a raw
  "Permission denied." toast. The app now says which permission it needs and
  opens its own App info page, where it can be allowed again.
- **Closing the device picker is not an error.** It used to raise a red
  "Native BLE Connect Failed: requestDevice cancelled." toast; it now just
  closes. All three verified on the OnePlus (location off via `adb`, the
  permission revoked and marked don't-ask-again with `pm set-permission-flags`).
- **The Connect sheet says why a board can be missing from the picker.** A
  board in receive-only does not advertise, and one still connected to another
  phone has stopped advertising, so both are simply absent from the list, and
  the Android picker cannot say whether it found anything at all. A standing
  line under the Bluetooth button points at the BOOT tap (2 minutes visible)
  and the other-phone case, so it is there when you need it and never nags.
- **Connect and send errors say what to do, not what the plugin said.**
  "Native BLE Connect Failed: Connection failed with GATT_ERROR." and
  "USB Connect Failed: IO_ERROR" were developer text. `friendlyError()` maps
  the known plugin and browser errors (BLE timeouts and GATT failures, a lost
  link, USB permission and I/O errors, a busy serial port) to a next step, and
  keeps the raw text for anything it does not recognise so an odd failure can
  still be reported. Verified on the OnePlus by parking the S3 in its ROM
  bootloader (`esptool --after no-reset`) between the picker listing it and
  the tap: "Can't reach the board. Check it has power and is close by, then
  tap Connect." The in-app self-test pins the mapping (`friendlyErrors`).

### Fixed — The tracker category means something again

- **A Find My hit now requires the 25-byte payload.** Apple sends message type
  `0x12` in two shapes: a 2-byte status ping that *every* iPhone, iPad and Mac
  emits constantly, and the 25-byte offline-finding payload carrying the
  rotating public key — i.e. an item findable while **separated from its
  owner**. Matching on the type byte alone called both a tracker. Measured
  across 18 bench and field captures: **1095 distinct MACs sent the short form,
  64 sent the long one**, so a rural convenience store reported 22 AirTags that
  were the customers' phones. A category that fires on every phone in the room
  is worse than no category at all. Accepted tradeoff: an AirTag sitting beside
  its owner advertises the short form and is not flagged — but that is the case
  where the owner is standing next to you anyway. A planted tracker is
  separated by definition.

### Added — Trackers beyond Apple

- **Tile, Samsung SmartTag and Google Find My Device are detected too.** Apple
  was the only finding network the detector knew, so a stalker using a Tile was
  invisible to a device whose whole purpose is finding planted trackers. These
  three need no length trick like Apple's: no phone advertises them, so the
  service is the detection — Tile `0xFEED`, Samsung `0xFD5A` (registered in
  offline finding) and `0xFD59` (still in setup).
- **Google FMDN announces its own unwanted-tracking mode.** `0xFEAA` service
  data with frame byte `0x40` is a finding beacon; **`0x41` means the tracker
  has entered unwanted-tracking-protection mode** — it is signalling that it may
  be following someone. Eddystone shares `0xFEAA` with frame types
  `0x00`/`0x10`/`0x20`/`0x30`, so the frame byte is what separates a finding
  beacon from a shop beacon; those are not flagged.
- **Measured against our own captures:** the Tile arm fires on the bench Tile
  keychain (61 adverts across six captures on three days, up to -40 dBm) plus
  two more Tiles in the field, and one real FMDN tag appeared at -89 dBm with
  frame `0x40`. **The Samsung arm is spec-only** — no SmartTag has ever crossed
  a capture, and the code says so rather than implying it is proven.
- **What a Tile looks like, from 149 captures** (checked against lesleyxyz's
  node-tile protocol research). Every Tile advertises the `0xFEED` service
  UUID plus `0xFEED` service data: `02 00` and 8 bytes that change. The bench
  Tile, set up on an account and now separated from its owner, sent 2231
  adverts over three days on **one static address** at about one every 4 s.
  Field Tiles showed a new address every time. node-tile says a Tile that was
  never activated advertises `0xFEEC` instead; none of the 149 captures
  contains `0xFEEC`, so there is nothing to test that on yet, and the detector
  still alerts on any `0xFEED`. Skullcandy headsets with Tile built in (Crusher
  Evo, company ID `0x07C9`) advertise `0xFEED` too, and they list as Tile
  Tracker, which is correct: they can be found on the Tile network.
- **A Tile cannot be rung.** Ring needs an authkey that only the owner's Tile
  account hands out (a cloud login, then an HMAC-authenticated channel over the
  `9d410018`/`9d410019` characteristics). A tracker planted on you is on
  someone else's account, and SignalSweep will not log in to any cloud
  service, so there is no Ring button for Tiles and none is planned.

### Added — Apple devices say what they are

- **Continuity message types are decoded into a plain-language label**:
  "Apple: AirPlay target (TV/HomePod/Mac)", "Apple: AirPrint (printer)",
  "Apple: Handoff", "Apple: Watch (Magic Switch)", "Apple: tethering source
  (hotspot)". Nearby Info (`0x10`) goes further and reports the activity nibble:
  active with the screen on, idle, just used, video playing, audio while
  locked, on a call, driving.
- **It is a label, not a detection.** No confidence, no category — so these rows
  never beep, never appear while the filter is on, and never count toward
  Surveillance. Any real signature rule wins the name. The point is that the
  filter-off view stops being a wall of anonymous random MACs.
- **Unknown stays unknown.** Message types `0x01`, `0x13` and `0x16` are live in
  our captures (120, 11 and 196 distinct MACs) but appear in no published table,
  so they read "Apple device" rather than a guess. Likewise the Nearby Info
  activity codes outside the documented set.
- **Lid open/closed is deliberately NOT reported.** macOS stops advertising
  Nearby messages when the lid shuts, which is indistinguishable from powered
  off, asleep or out of range — presence is not a state field, and a badge built
  on it would be a guess.
- Field meanings come from the furiousMAC Continuity project (GPL-2.0, so no
  code was taken — see `CREDITS.md`) and every value was cross-checked against
  our own captures.

### Fixed — The screen stays on for the whole cable connection

- **The wake lock now covers the entire USB/serial connection, not just a
  capture.** It is taken when the cable connects (the same place the `CMD:HOST`
  keepalive starts) and released on disconnect; a capture ending no longer drops
  it while the cable is still in. With the screen off the USB stream stalls and
  the live list goes stale, capture or not.
- **The lock is re-requested after the screen has been off.** Android releases a
  screen wake lock when the page hides, without telling the page, and the old
  code still held that dead object — so `!capWakeLock` blocked every re-request
  and, after one screen-off, the phone timed out mid-capture. The page now forgets
  the lock on hide. Measured on the OnePlus 7T (60 s screen timeout): a 180 s
  capture left untouched stayed awake throughout, 7157 records, zero sequence
  gaps; a 90 s capture with the screen forced off from 20 s to 50 s kept a flat
  380–465 records per 10 s with zero gaps, and re-took the lock on wake.

### Fixed — Neither board leaks heap while it scans

- **The S3 had the same leak, and worse: `setMaxResults(0)` now applies to both
  boards.** The fix first landed inside the `CONFIG_IDF_TARGET_ESP32C5` branch,
  which meant the S3 never got it — and NimBLE 1.4 has the identical `0xFF`
  default and the same clear-on-completion behaviour. A 17 h 35 min S3 soak:
  internal heap 187.6 KB → 78.1 KB, **-6.25 KB/h**, dead straight, with the
  tracked-target count flat at 41–44 throughout. At that rate an S3 wired into a
  vehicle exhausts its internal heap in about 29 hours. It never crashed during
  the run, which is the point: a leak this steady fails silently and late.
  With the fix, a 10 h 35 min soak of both boards measured **+0.04 KB/h on the
  C5** (flat) and **-0.78 KB/h on the S3** — an 8x improvement, zero restarts on
  either board. The S3's remaining drift is small and steady (191.2 → 182.9 KB
  while the target count *fell* 34 → 29), which is roughly nine days to
  exhaustion rather than 29 hours; the rest is a known, tracked follow-up rather
  than a mystery. Only the shared scan setup is common, so the C5's
  bench-measured interval/window stay inside the `#if`.
- **`setMaxResults(0)` on the C5 scan.** NimBLE 2.x keeps every scan result by
  default (`0xFF`), and the results are only cleared when a scan *completes* —
  the detector's scan never does, because it runs continuously. Every rotating
  random MAC therefore added an entry that was never freed. Measured over a
  5 h 20 min soak logging `heap_caps_get_free_size(MALLOC_CAP_INTERNAL)` once a
  minute: internal heap fell 96.0 KB → 71.0 KB, still falling in a straight
  line, while the tracked-target count stayed 57–88 throughout — so it was not
  target churn. With the fix, 94.1 KB free at 18 min with 65 targets, against
  91.2 KB for the old build at the same point. `0` means callbacks only; a
  scannable device is still held until its scan response arrives, so the names
  the signature rules match on are unaffected.
- **The measurement only works on `MALLOC_CAP_INTERNAL`.** `esp_get_free_heap_size()`
  includes 8 MB of PSRAM and hid the leak completely — an earlier 16-minute run
  read the wrong number and concluded nothing.
- **Still open: an unexplained reboot.** The C5 has restarted on its own twice
  (`esp_reset_reason()` = 4, a panic) with ~85–89 KB free, so it is not
  exhaustion. Longer soaks logging the full serial output are needed to catch
  the backtrace.

### Changed — Ring shows up only where it can work

- **Ring is offered only on devices that advertise Immediate Alert (`0x1802`)
  or Link Loss (`0x1803`).** Ring writes the standard Alert Level
  characteristic, which only Find Me / Proximity keyfobs have. AirTags need the
  owner's key to play a sound, Tiles speak their own protocol and phones ignore
  it, so the button that sat on every Bluetooth row almost never did anything.
  The detector remembers the flag per device and sends `"ring":1` on those rows
  only. A tag that has the service but does not advertise it gets no button.
- **Ring connects with the address type it heard.** It always connected as a
  random address, so every keyfob with a public address failed before the
  write was attempted.
- **The toast reports what happened.** The board answers
  `{"ring":"<mac>","ok":true|false}` after the attempt, and the app says
  "Ring landed" or "Ring failed" instead of an unconditional "Ring sent".

## [0.4.0] — 2026-09-16 — Every Wi-Fi row says where, and a router is one row

### Fixed — Hunting over the cable

- **The hunt meter updates as fast on USB as on Bluetooth.** The 3-per-second
  hunt frame went out over Bluetooth only, so a phone or laptop on the cable
  saw the target's signal once a second. It is now mirrored to USB like the
  1 Hz push. Measured on the bench: 0 hunt frames over USB before, 2.1/s on the
  ESP32-S3 and 1.3/s on the C5 after.

### Added — Band badges, and one row per box

- **Every Wi-Fi row says where it was heard:** `2.4G · ch 6` or `5G · ch 36`.
  The board reports the last channel per target (`"ch"`, Wi-Fi rows only, a few
  bytes each), so the XIAO ESP32-C5's 5 GHz coverage is readable at a glance.
- **A dual-band box is one row.** Wi-Fi transmitters whose MACs share the first
  five octets with last octets within 4 fold into one row that shows every band
  it was heard on and how many radios; tap to see each radio with its own Hunt.
  On C5 field captures about a third of 5 GHz-only transmitters were the second
  radio of a box already heard on 2.4 GHz. Rows are never joined on network
  name: mesh networks and hotspots share SSIDs across unrelated hardware.
- **A router's extra networks fold in too.** Guest, IoT and hotspot SSIDs on one
  radio use MACs whose last five octets match and whose first octet differs with
  the locally-administered bit set; they join the row when their channels agree.
  On six C5 field drives that rule found 941 groups, all with at most one
  non-local MAC, and 3 channel mismatches (refused). Both rules together took
  6886 transmitters down to 3665 rows; next to one router on the bench, 33 radios
  became 12 rows.

### Changed — Install tidy-ups

- `install.py` speaks esptool 5's `chip-id` / `write-flash` (the old spellings still
  work on esptool 4), so installs no longer print a deprecation warning.
- `install.py --from-dir _site/firmware` reads the version from the site's
  `manifest.json` one level up instead of titling the run "local build local".
- `site/assemble.sh` finds `boot_app0.bin` with `find -print -quit`: a
  `| head -1` under `pipefail` could fail a clean build on SIGPIPE.
- **"Updates lost" means lost telemetry again.** Opening the cable resets the
  board, and its boot banner counted as dropped pushes, so the badge read "29% of
  updates lost" after a clean connect. Only a line that looks like JSON counts
  now, and the counters reset with each link.
- The app links its favicon; every cold start used to 404 on `favicon.ico`.
- The C5's "5 GHz channel rejected" warning fires once per detector run instead
  of once per boot, so it speaks up again after a Site Survey capture.
- `analyze-capture.py` counts per-band MACs from management and data frames only,
  skipping multicast senders and out-of-range channels. With 5% of payloads torn
  it reported 52/23 MACs; it now reports 43/14, matching the clean capture.
- `install.py`'s missing-APK error names the folder you gave it.

## [0.3.0] — 2026-09-16 — The C5 hears 5 GHz, and installs like the S3

### Added — Install the C5 like the S3

- **One Install button, both boards.** The flasher manifest carries an ESP32-C5
  build beside the S3 one and ESP Web Tools picks by the chip it finds. The C5
  bootloader sits at `0x2000`, not `0`; `test_distribution.py` pins every offset
  to `partitions.csv` so the two can never drift.
- **`install.py` asks the chip.** Both boards share Espressif's USB id, so the
  port cannot tell them apart and the wrong image bricks the board. esptool reads
  the chip; `--board s3|c5` overrides and a mismatch aborts. `--from-dir` installs
  a local build or CI artifact. Releases before v0.3.0 have no C5 files, and the
  installer says so before touching hardware.
- **CI builds the C5 from the tagged commit**, in its own PlatformIO core dir (the
  two frameworks share a package name), with the Seeed platform pinned to the
  bench-proven commit and ESP Web Tools pinned to 10.4.0.
- `flash.py --board c5` sets the core dir and the UTF-8 output encoding for you.

### Fixed — Connecting and capturing recover on their own

- **One tap on OK now connects over USB.** The USB plugin's `requestPermission`
  always answers `granted:false` on Android 12+: its PendingIntent is
  `FLAG_IMMUTABLE`, which strips the `EXTRA_PERMISSION_GRANTED` extra it reads.
  Measured on a OnePlus 7T (API 36): tap OK, get `granted:false`, and
  `hasPermission` is true a moment later. The app believed the flag, toasted
  "USB permission denied" and stopped, so every first connect needed a second
  tap. It now asks the USB manager (`UsbSerial.hasPermission`) instead.
- **Back no longer strands the connection.** Back called `App.exitApp()`, which
  finishes the Activity but not the process: the BLE link and the USB port
  outlived the page. The reopened app showed "disconnected", the board (still
  connected, so no longer advertising) never appeared in the picker, and only a
  force stop got you out. Back now calls `App.minimizeApp()`, the same as Home.
- **A still-open BLE link is re-adopted.** `reconcileConnection()` queried
  connected devices before `BleClient.initialize()`, so on every fresh page it
  threw "Bluetooth LE not initialized" and gave up. It now initializes first,
  connects through the fresh plugin instance (already-connected is success)
  and resubscribes, so a recreated page comes back connected with no tap.
  It only does this on a phone that has connected over BLE before, so a first
  launch never raises the Nearby-devices prompt.
- **A capture that never starts gives up.** One Site Survey capture sat at a full
  countdown with zero counters and a header-only file, because nothing on the
  phone ever stopped waiting. If no `{"cap"}` frame arrives within 5 s of Start,
  the app resends `CMD:CAP:START` once, then stops, deletes the empty file and
  says so. Repeated captures could not be made to stall on the bench (three
  back-to-back from a PC, two from the phone), so this guards the symptom; the
  original trigger is still unidentified.
- **A dead USB link is a disconnect.** The plugin discards its reader on a stream
  error; the app only logged it and kept showing "connected". It now disconnects,
  and a disconnect mid-capture ends the capture and keeps the partial file
  instead of leaving the countdown frozen.
- **The USB drain keeps up with the screen off.** It ran on
  `requestAnimationFrame`, which never fires on a hidden page, so a phone on the
  cable in a pocket queued every chunk unread (340 in a short doze on the bench)
  and then decoded the lot in one frame on wake, the same main-thread flood that
  once crashed a capture. A hidden page now drains on a timer; the queue held at
  5–6 chunks through 40 s of screen-off while pushes kept landing.
- **A disconnected strip stays cleared.** Chunks still queued from the closed port
  drained after the disconnect and repainted "Alerts since boot" with the old
  board's count. Closing the port now drops them.
- **The Site Survey no longer says 5 GHz is unhearable.** A miss is "cellular,
  which no SignalSweep board hears, or 5 GHz, which only the XIAO ESP32-C5 hears".

### Added — XIAO ESP32-C5 support (dual-band detector)

- **The detector runs on the XIAO ESP32-C5** (`pio run -e c5`), the first board
  that hears 5 GHz. Same pads as the S3 harness (LED bar on D1, buzzer on D2),
  BOOT on GPIO28. The S3 tiers are byte-identical: every C5 difference is behind
  `CONFIG_IDF_TARGET_ESP32C5`, gated by a preprocessed-source and image compare.
- **Radio settings are measured, not borrowed.** Side-by-side captures against a
  known transmitter picked: 2.4 GHz 1–11 plus the non-DFS 5 GHz channels at
  120 ms (DFS channels cost every other channel listening time); BLE scanning
  25 ms of every 50 (40/100 left three times the silent stretches on a 2-second
  AirTag; bursts left a 118-second blind spot); frames the C5 driver reports as
  failed are dropped (they were random bytes posing as thousands of devices).
- **Wi-Fi band select** (`{"band":0|1|2}`, Settings → Radios on the C5): both,
  2.4 GHz only or 5 GHz only, persisted on the device. The comparison numbers come
  from paired 10-minute field drives with the *capture* build (C5 and S3 recording
  side by side, torn records dropped): the C5 heard ~82% as many 2.4 GHz
  transmitters as the S3 — it spends time on 5 GHz — while finding ~35% more
  distinct transmitters overall across both bands and BLE. About a third of the
  5 GHz-only transmitters are the second radio of a device already seen on 2.4 GHz,
  so in physical devices the gain is nearer a quarter. The detector build's own
  field evidence is one 10-minute band-1 drive: zero frames above channel 14 in
  15,292 records, which is what proves the switch actually takes effect. A
  both-bands drive on the detector build has not been run yet. 2.4-only mode is
  there for when 2.4 GHz is all you care about.
- **Build trap:** the C5's Arduino 3.x framework package has the same name as the
  S3's 2.0.17 one. Build the C5 with its own `PLATFORMIO_CORE_DIR`, or the first C5
  build replaces the S3 framework for every checkout.

### Added — Themes: one pick sets the bar's colour and the buzzer's pitch

The Alerts sheet has a Theme strip under Lights: **Classic** (the default, and
exactly today's look and sound), **Night Ops** (deep red, held at Dim
brightness, half pitch — easy on dark-adapted eyes), **Terminal** (green
phosphor, double pitch), **Glacier** (cool blue, 1.5× pitch) and **Party**
(rainbow everything, a drifting rainbow idle bar, its own fanfare and
connect/disconnect arpeggios). Party gives up the quiet one-pixel heartbeat on
purpose, and the app says so under the picker. The board stores the theme
(`sweep-bz`/`theme`), takes `{"theme":0..4}`, and reports it in `CMD:CFG` and
unconditionally in the 1 Hz push, like the LED mode; the chips paint only from
those reports. Picking a new theme plays the boot sweep and chirp in it, so the
tap visibly does something.

How it stays an instrument and not a toy:

- **Under a theme, the animation's shape is the ID** (sweep, flash pops,
  rotors, sonar), and the jingle's rhythm is the ID by ear. Only colour and
  frequency change. The category rows now name shapes, not colours, so they
  stay true in every theme.
- **The recolour runs on the finished frame** (`applyTheme()`, after the frame
  is built and before the LED-mode step). Each pixel keeps its brightest channel
  and takes the theme's hue, so animation shape and hunt-meter length survive
  and no draw routine knows themes exist — new animations inherit them for free.
  It edits the brightness-scaled NeoPixel buffer directly, in GRB order.
- **Pitch lives in `buzzerTone()`**, the one door every sound goes through, so
  jingles, the hunt clicker and the siren all follow and no rhythm can change.
  Classic skips the scaling entirely; notes are clamped to 200–6000 Hz; rests
  never reach it.
- **One LED mode ignores the theme.** A single pixel has no shape, only colour,
  so it keeps Classic colours and the normal green/blue heartbeat. The final
  review caught Party under One painting a steady white dot instead (the Party
  idle fill was not gated), and Night Ops dimming it; both are now exempt.
- **Flashes stay Classic.** The BOOT-hold factory-reset warning is red on
  purpose and the siren strobe alternates; recolouring them turned "about to
  wipe" green under Terminal. `applyTheme` is skipped on `flashActive` frames.

Known edges, accepted: the preview is suppressed while a hunt target is being
heard (`geigerLocked`), not for the whole hunt, because the LED code cannot see
the hunt target; a preview interrupts an alert already playing, but only on an
operator tap; the Party fanfare plays as a preview, not at power-on (no theme
plays a power-on jingle). Night Ops' half pitch puts the hunt clicker at
250–1250 Hz, below a typical piezo's sweet spot — tune the multiplier if it
reads too quiet. Receive-only's blue heartbeat is a Classic-only cue.

`selftest.js` pins the `ThemeId` order to the app's `THEMES`, the push field,
that the chips are buttons, that `drawAnimation`/`drawHuntMeter` never mention
themes, that `applyTheme` runs before the LED-mode step and skips One and
flashes, that `buzzerTone` skips Classic, and the picker's notes. Bench: flashed
to the LED board and the phone, every theme picked and previewed on the bar.

### Fixed — Bluetooth Remote ID decoded a byte off, and the bench could not see it

A real Bluetooth 4 Remote ID advert carries UUID `0xFFFA`, the app code `0x0D`,
a **1-byte message counter**, then the 25-byte ASTM message — exactly 31 bytes.
`bleDecodeRemoteId()` skipped the app code but decoded from the counter, so every
field of a real drone came out shifted by a byte: junk serial, junk coordinates on
the map. Presence still alerted (a malformed decode still means "a drone is
broadcasting here"), which is why the beep looked healthy. The bench emitter hid
it: it sent the bare message with no app code and no counter, which took the
other branch. The emitter now uses real framing, and `selftest.js` fails if the
decode offset moves back onto the counter.

The two Wi-Fi paths (beacon vendor IE, NAN action frames) had never seen a frame
on hardware. The emitter gained `dronewifi` and `dronenan` personas built with
the upstream `odid_wifi.c` encoder, so the detector is tested against the
reference implementation rather than our reading of the spec. Bench, two boards:
all three paths decode `SS-TEST-DRONE-0001` at 37.33182 / -122.03118 with
altitude, speed, heading and operator position intact; Wi-Fi caught 5 of ~87
beacons and 10 of ~105 NAN frames across 25 s (the hopper is elsewhere most of
the time — a real drone sends ~10/s); 59 pushes in 60 s.

The channel hopper also grants a channel that just carried Remote ID one extra
dwell — never two in a row, so a drone overhead cannot park the hopper and blind
the other channels. Still out of reach on this hardware: 5.8 GHz Remote ID (the
S3 is 2.4 GHz only) and BT5 long-range adverts (`CONFIG_BT_NIMBLE_EXT_ADV` off).

### Changed — while hunting, only the hunt makes noise

Lock onto one device and it is now the only thing the board beeps or lights for:
the Geiger clicker owns the buzzer and the hunt meter owns the bar. Before, every
other match that walked into range still played its category jingle and
animation, and both outrank the hunt — the jingle stomped the clicker and the
animation covered the meter, on exactly the walk where you are listening to one
signal. `noteAlert()` now declines every category alert while a hunt target is
set, including the hunted device's own (the clicker already is its sound), and
`setHuntTarget()` drops an alert queued in the second before the lock.

Detection and listing carry on untouched, and a declined alert is not recorded,
so a target's once-per-appearance flag stays clear: stop hunting and anything
still nearby sounds once, which tells you what was around while you were busy.
Bench-verified with two boards and a name rule matching the target at -8 dBm:
39 pushes while hunting with `alerts` = 0, then 0 → 1 on the first push after
the hunt was cleared.

### Added — the Site Survey page (find signatures, build a database)

Capture, log-a-device and evidence export were scattered across Settings and the
Pins sheet; they are now one **full-screen Site Survey page** (🔎 header icon; first called "Device Finder", renamed because it read like Hunt) with a
top-to-bottom workflow: **1) Investigate** an environment (the capture, USB only),
**2)** the app **analyzes the `.sscap` on the phone** and surfaces the suspect —
it says Flock only under the detector's own rule, never on the IE alone (see below) — then
**3) Log this device**: a photo + the detected signature + the raw capture, into
an encrypted **finds database** listed right on the page. **Export evidence
bundle** decrypts it all (photos + OSM/CSV with the signature + the raw captures)
for DeFlock.

The on-phone analyzer is a JS port of `analyze-capture.py`'s core (self-test
`analyzerFlock` checks it against a hand-built Flock frame). The encrypted store
is now `{ pins, finds }` under one PIN, with transparent migration from the old
pins-only array (`v1Migration` self-test). Pins keep only "ask to pin matches"
and simple auto-pins; Site Survey owns the investigation side. The log is
**Survey log**; while it's locked the count reads 🔒, not a misleading 0. Export
lands in `Documents/signalsweep-evidence-<date>/` (Files app, USB, or `adb pull`),
and the page says so.

**Android can kill the app while the camera is up.** When that happens the shot
comes back through `appRestoredResult` to a freshly booted page that has lost the
PIN key and the analysis. `logDevice()` stashes the signature + capture name
before launching the camera, and the restored result goes through the same
`saveFindFromShot()` after an unlock, so the photo lands instead of vanishing.

**Photos were silently dropped until `b64()` was chunked.** Base64-encoding the
encrypted photo spread the whole byte array into `String.fromCharCode(...)`,
which overflows the JS call stack from about 0.5 MB up, and every real camera
shot is bigger than that. The save threw, and the log stayed empty. `b64()` now
converts in 32 KB chunks, and `photoRoundTrip` round-trips a 3 MB buffer, so a
regression fails the self-test instead of a field survey. Export shared the
same helper and is fixed with it.

**Every survey is in the Survey log.** The list reads the `.sscap` files straight
off the phone, newest first, so viewing needs no PIN and nothing new is stored.
Tap a survey to analyze it again and log a photo against it. Once the log is
unlocked, photos and locations appear under the survey they belong to, and ✕
deletes a capture from the phone.

**Log this device asks what it is.** Three buttons: Flock / ALPR camera, Other
camera, Not sure. Only a confirmed camera with a GPS fix becomes a node in
`cameras.osm` (`surveillance:type=ALPR` or `camera`). A Not sure photo stays in
the CSV and the log, so a guess never lands on OpenStreetMap. The choice rides
the camera-restart stash, and falls back to Not sure, never to a camera.
`findOsmTags` in the self-test holds the line. The app's `categoryOf()` now
tests ALPR before body cam, the same order the firmware relies on: "ALPR /
Camera" contains "cam", and those finds had been painting as body cams.

**Trap — the capture crashed the app until the USB stream was batched.** A
capture floods the app with USB `data` events, and the listener decoded + parsed
each one synchronously on the main thread. Under the flood that saturated the
thread and intermittently OOM-crashed the WebView renderer mid-capture — the
capture died, `capFinish` never ran, and nothing saved ("the capture didn't
save"). Fix: the listener now does O(1) work — push the raw base64 to a queue —
and a single `requestAnimationFrame` drain decodes the whole batch once per
frame, paced to the display so the thread breathes and the screen keeps painting.
Belt-and-suspenders: a screen wake-lock during capture (a screen-off would
otherwise background and kill it) and a 60k-record cap on the analyzer.

**Photo-survives-GPS:** logging a device now saves the photo and the find FIRST,
then fills in GPS in the background — a slow fix in the field never throws away a
good shot (the old flow aborted the whole log, photo included, if GPS was slow,
which is why three field cameras logged zero photos). A find with no fix yet still
lists and still exports its photo, signature and capture.

### Changed — field notes: we fingerprinted the Flock IE, then tried to break it

A parking-lot survey at three Flock cameras (2026-09-12) turned up random-MAC
probe requests at 0 to +5 dBm carrying vendor IE `50:6f:9a:16:03:01:03`, and home
captures had none. It looked like the modern Flock tell, so for one commit the
detector alerted on that IE alone, on any MAC. Then we did what separates a
signature from a superstition: we attacked it with every capture we had.

- **The loudest "camera" was our own survey phone.** Disconnected Android probes
  for WiFi on a fresh random MAC every scan. The OnePlus running the app sends a
  14-tag probe fingerprint (`0,1,50,3,45,127,191,221:0050f208…,255,127,255,`
  `221:506f9a16…,221:8cfdf0…,0`). **9 of the 10** strongest lot devices matched
  it tag for tag. On the bench, disconnected, it rotated through 13 random MACs in
  two minutes. At home it was connected and quiet, which is why the negative
  control looked clean.
- **The 7-byte IE isn't Flock's.** `50:6f:9a` is the Wi-Fi Alliance OUI, and
  `16 03 01 03` reads as the MBO cellular-capability attribute. An exact-bytes
  sweep of every capture found it on AzureWave, China Dragon and Guangzhou
  Shiyuan WiFi modules at -83 to -92 dBm: a neighbour's gadget, which a bench
  survey promptly called a camera.
- **Nothing camera-strength survived the diff.** Lot minus home minus bench,
  with the phone taken out, leaves -56 to -74 dBm passers-by. Whatever those
  cameras speak at that range, it isn't 2.4 GHz WiFi.

What ships:

- **The IE is a tightener again**, the way upstream (DeFlockJoplin) uses it.
  Listed Flock OUI + wildcard probe + IE scores `W_WIFI_IE_SIG` (rule "Flock
  probe + IE"); OUI + wildcard alone stays `W_WIFI_PROBE`. `selftest.js` fails if
  a standalone `if (liteonSig)` gate ever comes back.
- **Know thy own emissions.** Before a capture, Site Survey asks whether WiFi
  and Bluetooth are off on every phone you're carrying. It asks about Bluetooth
  alone if the phone is on WiFi (`navigator.connection.type`), because the phones'
  own Google BLE adverts (`FEF3`/`FCF1`) turn up in every capture, home and lot
  alike. Android won't let an app switch a radio off, so it asks. Each capture
  header records `phone_net=`.
- **No verdict the detector wouldn't give.** The on-phone analyzer calls a
  capture Flock only under the detector's own rule, a listed Flock OUI sending
  wildcard probes with the IE. Its OUI list is pinned to the firmware's by the
  self-test. A bench survey had flagged a China Dragon Technology module (public
  MAC, -77 dBm, wildcard probes carrying the IE) as a possible Flock; it now
  reads as nothing, and `analyzerFlock` holds both cases. `analyze-capture.py`
  keeps the IE as a labelled hint for digging on a PC.
- **A bar for the next tell.** Capture at the pole with every phone's radio off,
  plus a capture about 100 m away. A candidate has to be absent from every home
  and bench capture, and its full tag order must not match a phone. Random-MAC
  Flock detection stays open until something clears that bar.

### Added — environment capture (raw packet logging for the unknown)

The detector only reports what it already judged interesting, which is useless
when the signature is unknown — a modern Flock camera, for instance, that
rotates its MAC every few seconds and carries only the weak Lite-On IE, so it
never clears the alert gate and shows up (if at all) as one of dozens of
"Lite-On Vendor IE (weak)" rows. Field screenshots next to a known camera showed
exactly that: the strongest signals in the environment were random-MAC clients
carrying `50:6F:9A`, invisible to an OUI-based detector.

So there is now a **stationary capture mode**. Settings → Diagnostics → *Capture
environment* (USB cable only — the raw stream is far too much for BLE NUS). You
pick a duration, stand next to the suspect device, and the board logs **every**
WiFi frame (all types, all channels) and **every** BLE advertisement to a file
on the phone (`signalsweep-capture-*.sscap`), which you pull to a PC and run
through `firmware/tools/analyze-capture.py`. The analyzer ranks devices by RSSI
with offline vendor lookup, flags random MACs and the Lite-On IE, and — the key
view — **groups probe/beacon frames by their IE fingerprint**, so many random
MACs sharing one fingerprint reveal a single device rotating its MAC. It also
exports the WiFi frames to a radiotap pcap for Wireshark, and has a `--minus`
diff mode to subtract a "walked away" capture from a "next to it" one.

Design honesty, baked in: the ESP32-S3 hears **only 2.4 GHz WiFi and BLE**. If a
full all-channel capture next to a camera shows nothing that tracks it, that is
the finding — the camera is on 5 GHz or cellular, which this hardware cannot
hear. The tool makes that provable instead of a guess.

**Camera evidence, tied to the capture.** The capture-done screen now has *Log
this camera*: take a photo (`@capacitor/camera`), drop a one-shot GPS pin, and
save both **encrypted behind the same PIN as the pins** — the photo as its own
AES-GCM file (`signalsweep-photos/*.enc`, since a photo is far too big for the
localStorage pin blob), the pin linked to the `.sscap` you just took at that
camera. *Export evidence bundle* (in Pins, PIN required) decrypts it all to one
folder: photos, coordinates as OSM (DeFlock-ready) + CSV, and the linked
captures — a complete package for someone to come back, verify the camera is
real, and submit it. The photo crypto round-trip is covered by `selftest.js`
(`photoRoundTrip`). Honest limit surfaced in the UI: the OS camera keeps its own
temp copy of the shot; we encrypt what we store, we can't scrub the OS cache.

Implementation: `mode_capture.cpp` pauses the detector (a single promiscuous rx
callback can't be shared), copies frames into two lock-free PSRAM ring buffers
from the radio callbacks (no malloc/lock/Serial there, same rule as the
detector), and a drain task base64-streams them over USB. Ring overflow bumps a
drop counter that is reported every second, so "lose no packets" is honest:
nothing is lost silently, and you see the exact count if the air out-ran USB.

**Trap (cost a bench cycle):** the S3 time-slices ONE radio between BLE and WiFi,
so the BLE scan *window* is stolen directly from WiFi promiscuous time. The first
build set the BLE scan to a near-100% window and WiFi came back with **zero**
frames while BLE flooded. The scan window is now 40 % (`setWindow(40)`,
`setInterval(100)`), favouring WiFi as the priority target. Anything that runs
both radios at once lives under this constraint.

### Fixed — the detector could no longer beep at a Flock camera

The headline capability had gone silently dead, and nothing in the UI could show
it. Flock's detectable surface collapsed twice: the cameras' management AP was
deactivated around December 2025 (which killed the SSID path — our only Wi-Fi
signal strong enough to alert, `W_WIFI_SSID` 80), and BLE stopped working in
spring 2026 (killing the `flock` / `pigvision` / `fs_` name rules and the mfg-ID
rule). What a current camera still does is spam **wildcard 802.11 probe
requests** — a probe with a zero-length SSID IE, "any AP, answer me" — roughly
every 125 ms on every channel. We already parsed those frames and matched the
OUI, but an OUI on its own scores `W_WIFI_OUI` (30), below `CONF_LIST_MIN` (60):
the camera was tracked, never listed, and never sounded.

The fix combines the OUI with the *behaviour*, research from **DeFlockJoplin**
(via colonelpanichacks/flock-you, drive-tested in Joplin at 11 of 12 cameras with
2 false positives). A wildcard probe **from a listed Flock OUI** is two
independent facts at once, and now scores `W_WIFI_PROBE` (70) — enough to clear
`CONF_ALERT_MIN` on its own, which is the whole point. When the frame also
carries the Flock stack's exact Lite-On vendor IE payload (tag 221, length 7,
`50:6f:9a:16:03:01:03`) it scores `W_WIFI_IE_SIG` (80).

Two traps kept as comments in `mode_watchers_watch.cpp`, repeated here because
they are the ways this path silently breaks:

- **The wildcard signal is gated on the OUI's category being `Flock Safety`,
  specifically.** A wildcard probe alone is meaningless — *every phone in range
  sends them* — so without the gate the buzzer would fire on the whole street.
  And it must be the *Flock* category, not just any listed OUI: a Cradlepoint or
  Sierra router on a listed prefix sending a wildcard probe is not a camera, and
  scoring it as one is the same failure as the `bandOf()` bug that once reported a
  TV as a camera. A hint that names the wrong vendor is worse than no hint.
- **The FCS is already stripped** by `body_len = length - offset - 4` before the
  IE walk, which is why this needs none of upstream's retry-with-`(len-4)` dance.
  Don't "simplify" that subtraction away.

Deliberately **not** taken from upstream: its ~200-line IE-fingerprint builder
(TLV resync, phantom-overflow recovery, a signature string compared against one
hardcoded allowlist entry tied to a single camera firmware revision) — the seven
Lite-On bytes above are its discriminating core; and its **addr1 echo** path
(catch a sleeping camera via a nearby AP's reply), which upstream itself rates
tier 1 and false-positive prone. Our confidence model is a sum with no tier to
demote a noisy path into, so it would only poison the vendor label.

The default Flock OUI list was synced to @NitekryDPaul's 2026-07-16 revision:
added `14:b5:cd`, removed `f8:a2:d6` (he field-demoted it — it hits a Sony Media
Player, not a Flock device). `SIG_SCHEMA_VERSION` bumped to 6 so already-deployed
boards regenerate rather than keeping the stale set for ever.

## [0.2.0] — 2026-09-11 — Lights, a cleaner top, and tabs that choose what alerts

### Changed: a band tab picks what alerts, and what asks to be pinned

Picking **Cameras**, **Trackers** or **Drones** now makes the device beep and
flash for that category only; **Everything** (or tapping the selected tab again)
turns them all back on. A tab is a preset `beep_mask`, the same persisted mask
the Alerts sheet edits, so it survives a power cycle and the board keeps it
headless. Cameras covers ALPR, body cams and the generic vendor categories,
the same umbrella the list uses. The device still detects and lists every
category, and every band still counts what it hears. Only the beep and the
light are narrowed. When the app connects it opens on the tab that matches
the board's mask. A custom mix set in the Alerts sheet leaves the tab where it
is, and the toolbar shows it as "n/5".

The tab also sets which matches ask to be pinned, so looking for Flock cameras
no longer asks about every AirTag. The Pins sheet has its own picker to
override it. The pin filter is stored in the app, like the pins themselves.

### Changed — the top of the screen says which board, and the toolbar is two buttons

The header now names the board you are connected to and the link type
("SignalSweep666 · USB"). The name comes from `CMD:CFG`'s `ble_name`, so it
works over a cable too, where you would otherwise see only a port. The status
strip shows **Uptime** and **Alerts since boot** next to Location. Uptime comes
from a new `uptime` field (seconds) in `CMD:CFG`: the app asks once and counts
on from there. The alert count (`alerts`, the same counter `CMD:CFG` already
had) now rides the 1 Hz push so it ticks live. The idle push measured 132 B,
and a 60 s soak got 60 of 60 pushes. CPU, heap and chip temperature were left
out. CPU usage needs FreeRTOS run-time stats, which cost time on every context
switch. Heap never moves. The S3's die temperature is uncalibrated.

The toolbar is down to **Alerts** and **Filter**. The filter button used to
read "Filter: matches" unlit in its normal state and lit up when the filter was
*off*, which is backwards. It now reads **Filter: On**, lit green while it is
filtering, and **Filter: Off**, unlit, while showing everything. "Recording" is
now **Ask to pin matches**, a switch in the Pins sheet behind a new 📍 header
icon. The icon lights green while the switch is on, so an armed prompt is still
visible from the main screen. The sheet opens without the PIN; only viewing
saved pins asks for it. Signatures moved into Settings.

Connection gets its own bar inside the header card: the board and link on the
left ("SignalSweep666 · Bluetooth"), and a labelled button on the right. The
button is a red-outlined **Disconnect**, which asks first, or a cyan
**Connect**. It replaces a lone Disconnect button that sat on a row of its own
outside the card. An earlier draft made the name line itself tappable, with a ⏏
glyph, and nobody would have found it. The amber "Device disconnected" banner
is gone. Its Connect Now button duplicated the header's Connect, and its
message ("it still beeps on its own") is already what the empty list says.

### Fixed — turning the filter back on left the whole list up

After Filter went back on, every unmatched row stayed listed, with Hunt
buttons, until it aged out 8 s later. There were two causes. `liveRows()`
relied on the device no longer reporting those rows instead of hiding them
itself. And a push sent before the board applied the command still carried
`scan_all:true`: the app drew that push under the old mode and adopted the
state only *after* drawing. The list now drops unmatched rows at once while
the filter is on, the device's state is adopted before rendering, and a
disagreeing echo is ignored for 1.5 s after your own tap. After that the
device is the authority again, so a write that never landed still repaints
the truth.

While nothing is connected, Filter now reads "Filter: —", unlit, like Alerts,
instead of a confident "On" for a board the app cannot see. Tapping it says to
connect first, instead of flipping a setting no board would receive.

### Added — lights: off, one LED, dim, or full

The toolbar's Sounds sheet is now **Alerts**, in two sections: *How* (Sound
on/off and a four-way Lights picker) and *What* (the five categories). Lights:
**Off** (the bar never lights, boot sweep and BOOT-hold flash included),
**One** (only the first LED lights, in the frame's brightest colour, so the hunt
meter still reads red/yellow/green and each alert keeps its category colour),
**Dim** (the whole bar at about a sixth of normal brightness) and **Full**. It
is one post-processing step on the finished frame in `HardwareManagerTask`, so
every animation obeys it without knowing it exists. Set with `{"led":0..3}`,
saved in NVS (`sweep-bz`/`led`) so it survives power loss, and reported in
`CMD:CFG` and the 1 Hz push for the same reason as the buzzer mute: the app
paints the picker only from the device, so a lost write self-heals within a
second.

It is called Alerts, not Notifications, because on Android "notifications"
means the phone's notification shade, and this app posts none. The old Buzzer
row billed itself as a master mute that "silences everything below", and with
it off, the five rows under it still read ON. Both were half true: the buzzer
mute is sound only, while a category switch gates its beep *and* its light. So
each category row now shows what its alert will actually do given the two
outputs: 🔊 💡, 💡 (sound off), 🔊 (lights off), Silent (both off) or Off.
That label comes from `alertChip()`, which the selftest covers.

### Added — the cable chirps like the Bluetooth link

Connecting and disconnecting over USB serial (Android USB host or desktop
WebSerial) now plays the same rising and falling chirps as a BLE connect.
Plugging in a cable does not. The board cannot tell those apart by itself: the
USB-Serial-JTAG stack's "connected" only means a host is sending frames, which
is true the moment the cable goes in, and opening the port resets the board
anyway. So the app announces itself. It sends `CMD:HOST` every 2 s while it
holds the port (the first one chirps) and `CMD:HOST:BYE` on a deliberate
disconnect. If the keepalive just stops (cable yanked, app killed), the board
plays the disconnect chirp after 6 s. Other serial traffic, such as a terminal
or a bench script, never chirps. `node app/selftest.js` fails if either side
renames the two commands.

### Added — who made it, and which end of the Wi-Fi link it is

The detector always listed both Wi-Fi access points (beacons, probe responses)
and clients (probe requests), but the app drew both as the same "Wi‑Fi" chip.
The push now carries `"ap":1|0` for Wi-Fi rows and the chip reads **📡 AP** or
**📱 Client**; rows from older firmware keep the plain chip. Selecting the
Wi‑Fi tab opens a second strip, **All Wi‑Fi · 📡 APs · 📱 Clients**. It filters
only while Wi‑Fi is selected, so a choice left behind cannot silently hide rows
under Both or Bluetooth.

Rows also name their manufacturer, two ways. A globally-unique MAC is looked
up in the IEEE OUI registry. For BLE the push adds `"cid"`, the company ID from
the advert's manufacturer data (Apple is `0x004C`), plus `"pub":1` when the
address is public. The company ID is what makes BLE work at all: most BLE
addresses, and most modern phones' Wi-Fi probes, are randomized. A random
address has no vendor, and running it through the OUI table anyway gives a
confident wrong answer. Such rows say "random MAC" instead. Where both lookups
apply, the IEEE registry wins, because a company ID is self-declared. Govee's
Telink thermometers send `0x0001` (Nokia) on public Telink addresses, so the
company ID is only used for random addresses and "Private" registrations.

Both lists ship with the app (`app/public/oui.txt`, `app/public/bt-company.txt`,
refreshed by `app/tools/fetch-vendors.mjs`) and are looked up offline. **Never
switch this to an online OUI API.** That would send every MAC the device hears
to a third party, which is the passive trail this project exists not to leave.

### Changed — the LED bar speaks, and stops shouting when idle

Every indicator used to `fill()` the whole 8-LED bar with one colour, a holdover
from a single status pixel. Idle, that meant all eight LEDs blinking every
0.8 s: obnoxious on a desk, and on a counter-surveillance tool in a parked car
a beacon. Idle is now **one dim pixel** that glows up and down once every 4 s
(green, or blue in receive-only) -- enough to tell alive from unpowered.

The full bar is reserved for detections, and each category gets its own
animation, because like the buzzer pattern the shape *is* the ID and must read
with the buzzer muted: ALPR a red comet sweeping end to end twice, body cam
three camera-flash pops in the long-short-short rhythm, drone a rising fill
then two "rotor blades" chasing round, tracker four alternating ticks then two
sonar pings from the centre, unknown match an amber breath. While hunting the
bar is a steady RSSI meter read like a phone's signal bars -- the count is the
strength, and the whole meter goes red (below ~-71 dBm), yellow, then green
(above ~-50, about a metre from a BLE tag) -- replacing a 25 ms full-bar
magenta flash on every Geiger click. Power-on is a rainbow wipe. The meter was
first coloured by position like a heat gauge, green first and red last, which
painted a weak -76 dBm lock as four green bars: "good signal". The
meter first flared on each click too, and at 2-3 clicks a second that was hard
to look at -- the ear already has the clicks. It also hopped a whole LED on
every advert, because RSSI jitters several dB packet to packet, so the level is
smoothed over about a second and the top LED lit in proportion: it glides.

Frames are drawn every task tick and pushed to the strip only when the pixel
buffer changed (`memcmp` against the last frame), so a static idle costs
nothing on the data line. Measured on the two-board bench: 30 pushes in 30 s,
unchanged. The bar these boards use is RGB (WS2812B, `NEO_GRB`) -- verified
clean on hardware; a true RGBW bar would need `NEO_GRBW` or every colour and
position comes out scrambled.

## [0.1.1] — 2026-09-06 — A signed APK, and an installer that checks first

### Added — the Android app is published

There was no distribution path for the app: no signing config, so a release
build produced an unsigned APK, which Android refuses to install. It is
sideload-only and will stay that way -- there is no Play Store listing -- so
the release asset has to be a properly signed APK. CI now builds and attaches
one on `v*` tags, signing it from a keystore held in repo secrets and running
`apksigner verify` before publishing. `versionCode` is derived from the tag
(`major*10000 + minor*100 + patch`), because Android requires it to strictly
increase on every upload and deriving it means that cannot be forgotten.

Local and fork builds are unaffected: without the keystore they produce an
*unsigned* APK rather than a debug-signed one. That is deliberate. A debug key
is generated per machine, so the next build would sign with a different one and
the upgrade would fail with `INSTALL_FAILED_UPDATE_INCOMPATIBLE`, whose only
fix -- uninstalling -- destroys the user's encrypted pin store.

### Added — `install.py`

Downloads a published release and puts it on hardware: firmware, app, or both.
Separate from `flash.py`, which builds from source and needs a toolchain.

Because it points destructive tools at devices, it refuses to guess. More than
one board or phone attached means it lists them and makes you choose; it prints
exactly what it is about to do and waits for the target's name to be typed
back. Every download is verified against the sha256 GitHub publishes for that
asset before anything is flashed -- a truncated image bricks a board until it
is reflashed. `--erase` is opt-in and says first that it wipes the mute, beep
mask, hunt target, BLE name and signature rules. An install signed with a
different key is explained in plain language instead of an adb error code.

### Fixed — every PNG in the Android project was committed corrupt

There was no `.gitattributes`, `core.autocrlf=true` on Windows, and git
normalised CRLF->LF *inside* the binaries on commit. All 26 were stored with
the signature `89 50 4E 47 0A 1A 0A` -- missing the `
` that PNG puts there
precisely so this is detectable -- and every other `0D0A` in the image data
stripped too. Not reversible.

`aapt2` rejects them ("file failed to compile"), so **no APK could be built
from a clean checkout**. It went unnoticed because local builds reused cached
compiled resources from before the corruption. `.gitattributes` now marks
binaries, and the icons are regenerated from `app/assets/*.svg` -- the app's
own brand mark, so the launcher icon finally matches the app.

### Verified

Signing proved end to end with a throwaway keystore: `apksigner` reports a V2
signer, `versionCode` 101 from `versionName` 0.1.1, the installed package shows
`flags=0x0` (not debuggable), and it launches. A clean `assembleRelease` now
succeeds where it previously failed on resources. `install.py` was tested
against the live v0.1.0 release: four sha256 digests verified, two attached
boards forced a choice, a wrong confirmation aborted without touching anything,
settings survived a flash without `--erase` and were reset by one with it, and
the signature-mismatch path was caught live against a phone's existing build.

One bug found by that testing and fixed: `--erase-all` was placed before the
`write_flash` subcommand, so esptool rejected it and the erase never happened.

## [0.1.0] — 2026-09-06 — Sounds you can find, and that stay in sync

### Fixed — overlapping BLE writes silently dropped commands

GATT permits one write in flight; a second is rejected with `InvalidStateError`
and, because nothing awaits `sendCommand()`, the command was simply lost behind
a "BLE Transmit Error" toast. Ordinary use reached this: the five per-category
sound toggles each fired their own command, so muting a few categories quickly
raced the writes against each other. `sendCommand()` is now a one-deep promise
chain over `sendCommandNow()`, with the same handler on both arms so a failed
write cannot strand everything queued behind it. Bench-verified: five rows
tapped as fast as `adb` can issue taps, zero transmit errors.

### Fixed — the app and the device drifted apart with no way back

`beep_mask` and `buzzer` were reachable only through the `CMD:CFG` reply, which
the app requests three times on connect and then never again. One dropped write
or one dropped notification left the phone painting a mask the board did not
have, for the rest of the session — recoverable only by a five-second factory
reset and a force stop of the app. Both fields now ride the 1 Hz push
(unconditionally: "absent" must not mean both "the default" and "old
firmware"), and `syncDeviceState()` adopts them, so a lost write self-heals
within a second. Measured cost: idle push 84 → 113 B, still 60 pushes in 60 s.

Verified on the bench by changing the mask over USB behind the app's back — the
phone repainted itself, including reverting a mute the app itself had set, with
no interaction.

### Fixed — the toggles owned state the device was supposed to own

They were `<input type="checkbox">`. A checkbox flips on tap, before the write
is attempted and regardless of whether it lands, so the box could show a mask
that never reached the board. They are now buttons painted solely by
`setBeepUi()`/`setBuzzerUi()` from device frames, and `app/selftest.js` fails
if an `id="beep-*"` element becomes a checkbox again.

`toggleBeep()` chains off `pendingMask` — the mask last *asked for* while still
in flight — rather than the last confirmed one. Computing every tap from the
confirmed value made taps inside the echo window overwrite each other: five
quick taps that should have muted everything left two categories sounding
(measured). Intent expires after `PENDING_TTL_MS` so a write that never lands
leaves no phantom for later taps to build on.

### Changed — the sound controls moved out of Settings

The five category toggles were three taps deep in the Settings modal, below a
scroll. They now live in a **Sounds** sheet opened from the toolbar, which also
carries the master mute and reads its own state at a glance
(`🔊 Sounds: 4/5`, `🔇 Sounds: off`). Silencing a category is a field action.

### Fixed — the firmware could report a mute it was not honouring

`isBuzzerEnabled()` returned `true` when it could not take `hwMutex` in 50 ms,
so a muted board reported itself audible — and `setBuzzerEnabled()` set the RAM
flag inside the mutex while writing NVS outside it, so a timeout left a board
that beeps now and boots silent later. The audio task takes that mutex every
loop, so neither was hypothetical. `buzzerEnabled` is now `volatile` and lives
outside the lock; only `buzzerOff()` still takes it.

### Fixed — "Surveillance Camera" sounded the body-cam pattern

`alertCategoryFromName()` tested `"cam"` before the ALPR terms, so any category
naming both resolved to `ALERT_BODYCAM` and was silenced by the wrong toggle —
indistinguishable from the mute not working. The shipped defaults dodge it; the
signature list is operator-editable and the UI labels that bucket
"ALPR / camera".

### Verified on the two-board rig

60 pushes in 60.3 s with the echo added. Mask and mute both survived a reboot.
With every category muted the alert counter did not move in 25 s while the
test transmitter broadcast; un-muting drone made it climb. Recorded audio confirms the
patterns are distinct and that muting is real silence: 0 bursts with mask 0, four
2000 Hz ticks for tracker, two 1200 Hz bursts 390 ms apart for ALPR (the piezo's
3rd harmonic dominates the spectrum, the fundamental measures 1200.0 Hz), and a
rising sweep ending at 2297 Hz for drone against a coded 2300 Hz.

## [0.1.0] — 2026-09-03 — The device is the authority on its own state

### Fixed — the buzzer mute never survived a power cycle

`hardware_manager.cpp` read `sweep-bz`/`on` at boot and **nothing anywhere ever
wrote it**, so `{"buzzer":false}` lived only in RAM. A detector muted in the
field came back beeping at the next ignition cycle — the one operator setting
that broke the rule every other setting follows. `setBuzzerEnabled()` now
persists it, outside `hwMutex` (the audio task takes that mutex every loop and
an NVS write must not be held against it).

### Fixed — the app guessed at the mute instead of asking

The mute was absent from `CMD:CFG`, so `app.js` shipped `let buzzerOn = true`
and a hardcoded `🔊 Buzzer: ON` button. Connect to a board that had been muted
headless — or to the second board on the bench — and the app confidently showed
the wrong state. `CMD:CFG` now reports `buzzer`, the `{"buzzer":…}` command
answers with a fresh config (as `beep_mask` and the radio toggles already did),
and the button paints `—` until the device says otherwise. `toggleBuzzer()` no
longer paints optimistically: if the command never lands, the button must not
claim it did. Both controls reset on disconnect, so one board's settings are
never shown as another's.

`app/selftest.js` now fails if the firmware reports a `CMD:CFG` field the app
never reads. A field the device reports and the phone ignores is state the phone
then invents; `buzzer` had been exactly that for the life of the project.

### Added — `CMD:SIGS`, so the signature editor stops overwriting rules blind

`getWatchersSignaturesJson()` existed with **zero callers** — no command reached
it. The editor opened blank against any board, and saving replaced a rule set
nobody had ever seen. It is now readable: the modal requests the rules on open,
shows what the board is actually carrying, and keeps Save disabled until they
arrive. On demand only, never on connect — the reply is multi-KB and the 1 Hz
push is the tightest budget on the device.

### Fixed — replies were lost on every transport except BLE

`sendBleSerial()` returns early when no BLE client is subscribed, so a reply sent
through it alone simply vanished on a board reached over the USB cable — one of
the app's three transports, and the one used on the bench. Replies now go
through `sendReply()`, which mirrors to `Serial` the way `sendConfigReply()`
always had.

### Fixed — a muted boot flooded the telemetry mirror with LEDC errors

Making the mute persist made a muted boot possible for the first time, which
exposed an old latent bug: Arduino attaches the LEDC channel lazily on the first
`tone()`, and `noTone()` on a channel that was never attached logs an error on
every call. A board that boots muted never calls `tone()` at all. Measured on
COM3: **561 LEDC errors in 4 s booted muted, 0 booted audible.** All buzzer audio
now goes through `buzzerTone()`/`buzzerOff()`; `buzzerOff()` no-ops until a
`tone()` has actually run, and `buzzerTone()` sets that flag *after* `tone()`
returns (setting it first left a race worth one stray error per mute
transition).

### Changed — the config handshake survives a dropped notification

BLE notifications are unacknowledged and the app asked for the config exactly
once, 400 ms after connect. One dropped reply left every settings control
painting a stale or default value for the whole session, silently. It now asks
at 400 ms / 1.5 s / 4 s until one lands, then stops.

Bench (two boards, COM3 + COM4, both tier1): mute survived a power cycle in both
directions; the two boards held independently different state across reboots
(A muted + filter on, B audible + filter off); `CMD:SIGS` returned 52 rules at
schema v5; a 60 s soak measured 60 pushes, 0 LEDC errors and `alerts=8` against
a bench transmitter.

## [0.1.0] — 2026-09-03 — Choose which categories are worth a beep

### Added — detection verified against a controlled signal

Detection is now tested against a bench transmitter we control rather than
whatever happens to be in the air, so "the detector works" stops being an
unfalsifiable claim. The transmitter is a local test fixture and is not part of
this repository.

Bench result: with the beep mask set to drone-only, the detector listed the
Flock and the AirTag but sounded only the drone — the two features verified
together on real hardware.

### Added — a per-category beep mask, in Settings and in NVS

Driving with the detector on, every AirTag in traffic earned the tracker
pattern. Correct behaviour, useless to listen to. Settings now has a **What
beeps** section: five checkboxes, one per buzzer "word" (ALPR/camera, body cam,
drone, tracker, other matches).

The choice lives on the device, not in the app — the whole point is headless
operation — as one bitmask over the existing `AlertCategory` enum
(`{"beep_mask":N}`, echoed by `CMD:CFG`), persisted in `sweep-st`/`beepmask`
next to the hunt target and the report filter, so a board wired into a car comes
back from every ignition cycle still muting what it was told to mute.

A muted category is fully silent: no beep, no LED flash, and no increment of the
`alerts` counter that proves the headless path works. It is still detected,
still tracked and still listed in the app — the mask is about the noise, never
about what the detector watches for.

`noteAlertForTarget()` now only burns its once-per-appearance flag when the
alert actually sounded. Otherwise un-muting trackers while the AirTag was still
in range would have stayed silent until the target aged out.

`app/selftest.js` cross-checks `BEEP_BITS` in `app.js` against the
`AlertCategory` enum in `hardware_manager.h` — a shared bit order that drifts
would mute body cams when you unticked trackers, with nothing at runtime to say
so.

Bench (two boards, COM3 detector / COM4 transmitter, rule matched on device name):
mask = drone-only with a Tracker-category rule → board listed, zero `[ALERT]`
lines, `alerts` 0; same mask with the rule recategorised as Drone → `[ALERT]
category=2 weight=70`, `alerts` 1 (proving the muted pass had not burned the
flag); `beep_mask` still 4 after a reboot.

## [0.1.0] — 2026-09-03 — A Settings page you can reach the bottom of

### Fixed — modals were not scrollable at all

`.modal-overlay` is a fixed 100vh flexbox and `.modal-card` had no `max-height`
and no `overflow`, so any modal taller than the screen spilled off both ends
with nothing to scroll. Settings is the tallest and showed it first, but Help
and Signature Rules had the same bug on a phone.

The overlay is now the scroller, not the card — the close button is absolutely
positioned *inside* the card, so scrolling the card would have pinned the x over
the content. `align-items:flex-start` plus `margin:auto 0` on the card keeps a
short modal centred and lets a tall one scroll, with safe-area padding top and
bottom. Escape and a backdrop click now close any open modal: the x can scroll
off the top, and a modal you have to scroll needs a way out that does not depend
on scrolling back up.

### Changed — Settings reads as one page instead of four inline-styled fragments

The body was wrapped in `.modal-actions` (`flex-direction:column; gap:1rem`), so
every element got a gap *plus* its own margin and no two sections agreed on
spacing. Each row and button carried its own duplicated inline style blob. All of
that is now five small classes — `.set-label`, `.set-note`, `.set-row`,
`.set-toggle`, `.set-text` — and one spacing rule. The header subtitle said
"Radios" while the modal also held Emissions, Identity and Opsec. Every id is
unchanged; `app/selftest.js` cross-checks them against `app.js`.

### Added — the radios report their own state

The BLE and WiFi ON/OFF button pairs were fire-and-forget: nothing anywhere said
whether a radio was actually paused, so both buttons always looked identical and
the modal could never show what the device was doing.

`CMD:CFG` now carries `ble_scan` / `wifi_scan`, and each `CMD:BLE_SCAN:*` /
`CMD:WIFI_SCAN:*` answers with a fresh config reply, so the app shows one
state-bearing toggle per radio painted from the device — the same
device-is-the-authority rule as `hunt`, `scan_all` and `rx_only`.

The flag is set in the command handlers, deliberately **not** inside
`pauseBle()`: `performRing()` pauses the BLE scan for the length of a ring, and
reading the state from there would report the scanner as off every time you rang
a tracker. Bench-verified on COM3 — 342 `CMD:CFG` samples taken across a ring
with `ble_scan` true throughout, both radios back to scanning after a reset.

### Fixed — the `scan_all` documentation was backwards

`CLAUDE.md` claimed the foxhunt filter was not persisted and that "a reboot
always comes back quiet". `setScanAll()` has always called `persistState()`, and
`restoreWatchersState()` reads it back. The code is right — the foxhunt workflow
is unplug-and-walk-away, and a filter that reset on a battery swap would only be
usable while tethered to the laptop you were leaving. The docs now say so, along
with the consequence: a board can come back still unfiltered, which is why the
filter-off list is capped at 18 rather than 40.

---

## [0.1.0] — 2026-09-03 — The phone can drive the device over USB

### Added — native USB serial on Android

Receive-only had a hole in it: silencing the device from the phone severed the
only link the phone had. The cable was not an option, because **Android has no
WebSerial** — the API is absent from the platform, not gated behind a flag —
and tapping the USB option on a phone did nothing but raise an alert.

That was the wrong conclusion to draw. The browser API is missing; the
capability is not. Android has USB host, the board is a CDC/ACM device
(`ARDUINO_USB_CDC_ON_BOOT=1`, Espressif VID `0x303A`), and
`usb-serial-for-android` has driven that class for years. The app now reaches it
through `@leeskies/capacitor-usb-serial`.

Plug the device into the phone with a USB-C cable, accept Android's permission
prompt, and you get full telemetry and full command control **with the radio
completely quiet**. That is what the emissions work was for.

Verified on the bench: with board A on the phone in receive-only, the witness
board saw it in 0 of 43 pushes while 99 telemetry events arrived over the cable
in the same window.

No firmware change was needed — `loop()` already read USB serial commands and
the detector already mirrored every 1 Hz push to `Serial`.

### Changed — receive-only is a toggle, not a one-way door

Over Bluetooth, going quiet severs the link that carried the command, so the
only way back is the BOOT button. Over a cable **nothing is severed**: the radio
goes quiet and the wire keeps working. A control that could only ever silence
would strand the operator in the one situation where recovery is trivial, so the
button now reads **Go quiet** or **Advertise** depending on what the device last
reported, and the warning text only threatens to drop the connection when the
connection is actually Bluetooth.

### Fixed — connecting over USB could silence the device without asking

The first cut asked "turn advertising off while you are on the cable?" the
instant the port opened. On Android that put a dialog in the same screen region
as the system USB-permission dialog, milliseconds after it — so the tap that
granted permission carried straight through onto its OK. Measured on the bench:
`{"rx_only":true}` went out 100 ms after connect with no human input, and the
detector went silent because someone plugged in a cable.

Silencing the detector is a deliberate act and it now lives only behind the
deliberate control in Settings. Connecting says so in a toast instead.

### Fixed — the USB option is offered where it can work

The button was hidden wherever `'serial' in navigator` was false, which is every
Android build. It is now shown wherever *any* USB transport exists — WebSerial
in a desktop browser, the USB host stack on Android — and the badge says which.

## [0.1.0] — 2026-09-03 — Receive-only: the detector stops announcing itself

### Added — receive-only mode

A counter-surveillance tool that advertises "SignalSweep" on the air announces
its presence to anyone else running a scanner, including the hardware it exists
to find. Receive-only stops advertising and drops the connection, leaving the
BLE radio doing nothing but listening.

The driver is emissions, not airtime. The scanner already runs a 50% duty cycle
and the real contention is Wi-Fi promiscuous against the BLE scan on one shared
radio, so shutting down the GATT server buys very little there. It buys the
whole answer to "does this thing broadcast?"

**It is not the buzzer mute, and it is not deaf.** "Silent" already means
`{"buzzer":false}`, which is untouched: the detector keeps scanning, keeps
matching, keeps sounding its per-category patterns, and keeps mirroring
telemetry to USB. Active scanning stays on too — scan responses carry device
names and the name-matching rules depend on them, so going fully passive would
blind the detector to save one packet.

Turn it on from **Settings → Emissions → Go quiet**, or with `{"rx_only":true}`
/ `CMD:RXONLY:ON` over serial. The setting survives a power cycle, so a board
left quiet comes back quiet.

### Added — three ways back in, so lockout is impossible

- **Tap BOOT** on the device: advertises for two minutes, then goes quiet again
  on its own if nothing connected. An accidental press in a pocket must not
  leave the board broadcasting all afternoon. Connecting inside the window
  un-quiets it properly.
- **`CMD:RXONLY:OFF`** over USB serial.
- **Hold BOOT for 5 seconds**, the existing factory reset, unchanged.

This is also why there is no Android USB-serial control path: Web Serial does
not exist on Android, and the button removes the need for a cable.

### Added — connecting over USB asks whether to go quiet

On the cable there is no reason to keep broadcasting, but it is the operator's
call rather than an automatic one. Quieting on any attached USB host would make
a board on a bench port permanently unreachable by phone.

### Added — you can see that it is quiet

Receive-only is invisible by definition, and a device that appears broken is
worse than one that is. The idle blink goes dim blue instead of green, with the
existing chirps on entering and leaving.

### Fixed — going quiet would have re-advertised immediately

`ServerCallbacks::onDisconnect` restarted advertising unconditionally, so
dropping the client on the way into receive-only would have put the device
straight back on the air — broken in the one way nothing in the interface could
have shown you. It is now gated. Proven on the two-board bench: with board A
quiet, board B saw zero of 63 pushes containing A, while A went on detecting B
and beeping headless.

## [0.1.0] — 2026-09-02 — SSIDs, a radio filter, and Wi-Fi foxhunting

### Added — network names

Wi-Fi rows now carry the SSID the device is announcing, and are titled by it
when they have no other name. A network name is the one field that lets a person
recognise their own hardware; a vendor prefix does not. Captured from beacons
and probe responses only — a probe *request* names the network a client is
looking for, which says nothing about the device sending it.

### Added — radio filter

Both radios / Bluetooth / Wi-Fi, shown only while the report filter is off,
where most of the list is access points and picking one radio actually matters.
A device heard on both counts as either.

### Added — foxhunting works over Wi-Fi

Two things the Bluetooth path got for free had to be built:

- The clicker cannot be driven from the promiscuous callback, which must never
  block on the hardware mutex. The sample is parked in a volatile and the 1 Hz
  task applies it.
- More importantly, the channel hopper meant hearing a given access point about
  one dwell in thirteen, so the clicker went quiet every time it moved on. While
  a Wi-Fi target is hunted the hopper parks on its channel. Detection of
  everything else pauses for the duration, which is the deal you accept when you
  lock onto one target.

### Changed — Ring is hidden on Wi-Fi-only devices

Ring is a GATT write to a Bluetooth characteristic. On a device only ever heard
over Wi-Fi there is nothing to connect to, so the button was a guaranteed
failure dressed up as an option.

### Fixed — a weak Lite-On hint was being counted as a camera

Reported from the field: two "Cameras" in a house with no ALPR. The Lite-On
vendor IE (50:6F:9A) scores 30 and deliberately sets *no* vendor category,
because that prefix is in countless consumer Wi-Fi chips. But the app derived a
row's band from `type || rule`, so a hit with no type fell through to the generic
bucket, which the Surveillance band includes. Confirmed on the bench: the two
devices carrying it here are a T-Mobile gateway (`TMOBILE-B430`) and a Sony
television (`DIRECT-ss-BRAVIA`).

Rows are now placed by `bandOf()`, which separates three states the old code
conflated: matched nothing, matched a rule the firmware refuses to attribute
("weak hint"), and matched a real vendor category. Only the last counts toward a
category band.

## [0.1.0] — 2026-09-02 — The band tabs were dead, and filter-off pushes were too big to arrive

### Fixed — clicking a band tab did nothing

The delegated click listener still matched `#lens-row .lens-tab` after the tabs
were rebuilt as `#bands .band` in the interface pass. Nothing threw and nothing
logged; the tabs simply did not respond, so the list was permanently stuck on
Everything. `node app/selftest.js` now cross-checks every id-anchored selector in
`app.js` against the ids in `index.html` before running anything else, and that
check fails on exactly this bug when reintroduced.

### Fixed — with the filter off, the app showed nothing at all

A filter-off push was ~4.4 KB, which is about 19 BLE notifications. Those are
unacknowledged and a push is reassembled from all of them, so losing any single
chunk truncates the JSON and the app discards that whole second — which looks
precisely like "the device is finding nothing".

Two changes bring it to ~1.4 KB and 6 notifications:

- Unmatched rows no longer carry `count`, `confidence` and `tier`. The app
  renders none of those for a device that matched nothing; they were tripling
  the size of the row that dominates a filter-off push.
- The per-push cap drops from 40 to 18 while the filter is off. Selection stays
  round-robin by staleness, never by RSSI, so nothing is starved — every device
  still comes round, over about two seconds instead of one.

The app now also counts pushes it failed to parse and says so on screen once
more than one in ten is being lost, rather than logging to a console nobody has
open on a phone. A render error in the foxhunt panel can no longer take the
device list down with it.

## [0.1.0] — 2026-09-02 — Everything the operator sets now survives a power cycle

The device is headless and unattended. Wired into a car it loses power every
time the engine stops; the foxhunt workflow is unplug from the laptop, move to a
USB battery, and walk away from the phone — also a power cycle. State that
evaporated on reboot could only be used while tethered to the thing you were
trying to leave behind.

### Fixed — the hunt target and the report filter are persisted

Both now live in NVS (`sweep-st`) and are restored by `startWatchersWatch()`.
The filter had been deliberately session-only on the grounds that it floods the
telemetry budget; that argument protected a budget that isn't being spent, since
`sendBleSerial()` returns early with no client subscribed. Verified across real
power cycles: set, reboot, still set; cleared, reboot, still cleared.

Already persisted and unaffected: signature rules, buzzer mute, BLE name and
random-address flag, hardware tier. `pendingRingMac` stays transient — it is a
one-shot action, not a setting.

### Fixed — a detection could be listed without ever sounding the buzzer

The alert call lived only on the "new target" path. A BLE device splits its data
between the advertisement and the scan response, and the name — the strongest
signal most rules have — frequently arrives only in the second one. The target
was therefore created unmatched by the first packet, and the packet that
actually identified it took the "already tracking" path, which never alerted:
drive past a camera, watch it appear in the list, hear nothing. Any rule pushed
after a device was first seen had the same problem.

`noteAlertForTarget()` now owns the decision and records it on the target, so a
device beeps once per appearance rather than once per advert. The flag clears
when the target goes stale and is pruned, so something you drive past twice
beeps twice. Applies to both radios and to the drone path.

### Added — the clicker goes quiet when the hunted target is out of earshot

The hunt stays armed across silence and across reboots; what stops is the noise.
Without this, a board restored from NVS — or one whose target has gone out of
range — would tick in your pocket at the "very far away" rate indefinitely,
which reads as "still tracking it" when it means nothing of the sort. Eight
seconds of silence stops the clicking; hearing the target again resumes it.

### Added — evidence that the headless path actually works

With nothing connected, the buzzer's only witness is a noise in another room,
and a serial print made seconds after boot is lost while the USB CDC port
re-enumerates — exactly when a freshly powered detector does its alerting.
`getAlertCount()` counts alerts since boot and `CMD:CFG` reports it, along with
the hunt target and filter state so a phone connecting to a board that has been
running headless adopts what it was already doing.

Bench result: rule pushed, power cycled, left alone, then read back — one alert
fired after the power cycle with no phone and no USB host listening.

## [0.1.0] — 2026-09-02 — Foxhunting, a location readout, and an interface that looks like an instrument

### Added — the filter switch and the foxhunt readout

The old Beacon Bandit's best trick is back: turn the filter off, find something
interesting, lock onto it, and physically walk it down.

- `{"scan_all":bool}` reports every tracked device instead of only signature
  matches. It lifts the *listing* gate only — `CONF_ALERT_MIN` still governs the
  buzzer, so the filter can be off in a crowded room without a single beep.
  Measured on the bench: 39-44 devices listed, none at or above the alert
  threshold. Not persisted; a reboot always comes back quiet.
- Hunt is offered on every row while the filter is off, and on trackers always.
- A locked target gets a full instrument rather than a row: the signal in
  numerals large enough to read at arm's length on a dash mount, a rolling trace
  of the last 40 samples, and a warmer / holding / colder call taken from the
  last few samples against the ones before them (3 dB, below which the reading
  is multipath noise rather than movement). The trace is signal strength only —
  there is no position in it — and it is dropped when the hunt stops.
- Both `hunt` and `scan_all` are echoed in the 1 Hz push and the app adopts what
  the device says. Neither survives a reboot, so after a reconnect the app must
  not keep believing it is hunting something the board has forgotten.

### Added — location status

Restores the GPS badge from the geospatial era, rebuilt around the one-shot fix
model that replaced `watchPosition`. Off, Locating, ±N m, or ±N m with "too
vague to pin" past 50 m; a refused permission reads differently from a cold lock
that timed out, because one is a settings problem and the other is worth
standing still outside for another few seconds. Confirming a pin on a fix that
vague now asks first — a pin is evidence of where a camera is, and one saved at
±200 m points at the wrong building.

### Changed — the interface

- The four tabs are now four channels of a receiver. Each carries its own count
  and a live meter of the strongest signal in that band, so a band going hot is
  visible while you are reading a different one. Colour is load-bearing and
  matches the buzzer's four words: red camera, orange body cam, blue drone,
  magenta tracker.
- Device, location and recording are three separate cells that fail
  independently, replacing the single status badge that only reported one of
  them. The old badge is hidden rather than deleted, since `updateConnectionUI`
  still writes to it.
- Monospace is now used for measured values only — addresses, dBm, coordinates,
  IDs — where columns have to align and 0 must not read as O. No webfont
  anywhere, deliberately: a detector is most needed where there is no network to
  fetch one.

### Fixed

- **A device that matched nothing was displayed as a match.** With the filter
  off, `categoryOf('')` fell through to the generic bucket, so every unnamed
  phone in range was titled "Match" behind a warning triangle — and counted in
  the Surveillance band, which read 5 cameras in a room containing one. No-match
  is now its own category: grey, tagged "no match", no confidence, no tier, and
  counted only under Everything. A detector that cries wolf in its own UI is the
  same failure as one that cries wolf with its buzzer.
- **The map showed "API KEY REQUIRED" across every tile.** CARTO's dark basemap
  is keyed now. Switched to plain OSM tiles darkened by a CSS filter on the tile
  pane, so markers and rings keep their real colours and nothing depends on a
  keyed service to draw a map.
- `showNextConsent()` threw on a missing modal element. It is called from inside
  the ingest loop, so that abandoned the rest of the telemetry batch and left
  the live list half-populated.
- Recording consent is no longer offered for unmatched devices. With the filter
  off it would otherwise ask permission to pin every phone on the street.

## [0.1.0] — 2026-09-02 — Put back what we missed, not what was wrong

The previous pass was right about the two things that hurt — a passive location
trail on a seizable phone, and a signature list that cried wolf — and wrong
about how much it had to delete to fix them. This restores the map, the
category tabs, the per-target detail and the full Remote ID decoder, without
restoring the trail, the false positives, or the mode state machine.

The old build was resurrected into `SingalSweep_OLD/` as a reference for this
merge. Nothing was copied from it unexamined; the "Kept dead" section below is
the point of the exercise.

### Added — full ASTM F3411 Remote ID decode

- The drone check was presence-only ("a drone is broadcasting near you"). It now
  **decodes**: UAS serial, operator ID, self-ID text, the aircraft's own
  latitude/longitude/altitude/AGL/speed/heading, and the **operator's**
  position. Remote ID is a broadcast standard whose whole purpose is to be
  readable, so this is all handed to us in the clear.
- Three paths: BLE service data `0xFFFA`, Wi-Fi beacon vendor IE (`FA:0B:BC`,
  the ASD-STAN / ASTM OUI, or `90:3A:E6`, Parrot's MA-L, which early Parrot
  beacons used; corrected in v23, this line once called `90:3A:E6` "ASTM"),
  and Wi-Fi NAN action frames to `51:6F:9A:01:00:00`. The
  vendored upstream `opendroneid.c` + `odid_wifi.c` are back, unmodified.
- **Fixed a buffer over-read while porting it.** Sky Sweeper computed the
  beacon IE payload length as "everything to the end of the frame", which fed
  the decoder every subsequent information element plus the FCS as if it were
  drone payload. The length now comes from the element's own `elen`.
- `ODID_UAS_Data` is ~1 KB and both detection paths run on tight callback
  stacks, so the decode buffers are file-static, one per radio.
- Telemetry cost is contained: the drone block ships only on targets that
  actually decoded one, each field is emitted once (Sky Sweeper sent every
  value twice under two names), and any field still holding an ODID "unknown"
  sentinel — 0/0 for a position, -1000 m, 361° — is dropped rather than sent.

### Added — Hunt and Ring

- `{"hunt":"<mac>"}` points the buzzer's Geiger clicker at one MAC: the click
  rate rises as you close on it, so a planted tracker can be walked down by
  ear. `{"hunt":""}` clears it. The clicker itself already existed in
  `hardware_manager.cpp` with zero callers; this wires it up rather than
  rewriting it. **Detection never stops** — every other category keeps
  beeping normally while you hunt.
- `{"ring":"<mac>"}` makes a suspected tracker announce itself: one GATT write
  to Immediate Alert (`0x1802` / `0x2A06` / `0x02`). **The MAC is the only
  parameter** — service, characteristic and value are fixed in the firmware.
  The old build exposed arbitrary service/characteristic/hex writes next to an
  advertisement spoofer; that shape is what made it an offensive tool, and it
  is not coming back through this door.
- Ring runs on the 1 Hz task, never on the NimBLE write callback that requested
  it, and is bracketed by `pauseBle(true/false)` so a failed connect can't
  leave the detector deaf.

### Added — lens tabs, richer cards, live map

- Four tabs (All / Surveillance / Trackers / Drones) replace the old mode
  selector. Critically they are a **filter over what the detector already
  reported**, not modes: switching one sends nothing to the device, so the
  detector can never stop watching a category because the UI is looking
  elsewhere. That was the real content of the old five modes — one detector
  wearing different filters — minus the state machine.
- Cards now show the confidence tier badge, and drones render their decoded
  serial, operator, altitude, speed, heading and coordinates. Tracker cards get
  Hunt and Ring buttons. Every device-supplied string goes through `esc()`, and
  MACs ride in `data-mac` attributes read by a delegated listener — never
  interpolated into an `onclick`.
- The Leaflet map is back, live-only. Drones get a **solid marker at their
  broadcast coordinate**, because that number is real. Everything else gets a
  **dashed, unfilled ring of RSSI-estimated radius centred on you** — we know
  roughly how far, never where, and a pin would be a lie. Saved pins overlay
  only when the store is already unlocked; opening the map never prompts for
  the PIN.

### Fixed

- **`liveMatches` was never actually cleared on disconnect.** It was documented
  as cleared and behaved as if it were — rows aged out of the view after 8 s —
  but the object retained every MAC, name and RSSI for the life of the tab, and
  would now also have held decoded drone and operator coordinates. Nothing was
  ever written to disk, but a session-long list in a live tab is still a list.
  `onDeviceDisconnected()` now calls `clearLiveState()`. `handledMacs` is
  deliberately not cleared, or a flapping link re-prompts for recording consent
  on every reconnect.

### Removed — signature defaults v5

Two more rules of the same class as the `mfg_id 0x01` entry that labelled Govee
bulbs "Flock Safety". Both scored at or above `CONF_ALERT_MIN` (70), meaning
either could sound the alarm entirely on its own:

- **Device names `raven` and `penguin`** — ordinary product words, matched as
  case-insensitive substrings, at `W_NAME` 70. Enough to beep at someone's
  bluetooth speaker.
- **Service UUIDs `3100` / `3200` / `3300` / `3400` / `3500`** — four hex
  digits, substring-matched against every UUID a device advertises, at
  `W_UUID` 70. A UUID rule has to be specific enough to stand alone, because
  `CONF_ALERT_MIN` is exactly what lets it.

`SIG_SCHEMA_VERSION` bumped to 5 so already-deployed boards actually pick this
up — the file survives a flash, which is the whole reason the version exists.
Either rule can be pushed back from the app's signature editor if wanted;
removing them from the *defaults* removes the misfire, not the capability.

### Kept dead — deliberately not restored from the old build

- The 40-entry "GoFlockYourself" OUI list's four worst members: `a4:cf:12` and
  `3c:71:bf` (Espressif — this board's own vendor block), `cc:cc:cc` (not an
  assigned OUI), `82:6b:f2` (locally-administered bit set, i.e. a randomized
  phone MAC). The load-time rejection of locally-administered prefixes stays.
- `mfg_id 0x01` "Flock XUNTONG" — Bluetooth Company ID `0x0001` is Nokia's.
- `ble_spoof` and arbitrary GATT writes. GATT interrogation was also left out.
- The `sightStore`, the geospatial classifier, the OSM ALPR cross-check,
  passive `watchPosition`, and the breadcrumb polyline.
- `leaflet.offline` and its tile cache — cached tiles persist on disk and
  record which areas you downloaded. Dependency dropped from `package.json`.
- The firmware mode state machine: `modeChangeQueue`, `MODE_SELECTOR`,
  per-mode NVS, the BOOT-button-to-selector.
- `CONFIG_BT_NIMBLE_EXT_ADV`, still off, still warned about.
- The canvas radar view. The live map does the same job with real coordinates;
  the old radar placed most blips at a random per-MAC angle, which reads as a
  bearing but isn't.

### Note for the next port

`odid_wifi.c` (the old tree's `wifi.c`) looks like the unused upstream Wi-Fi
helper and is not: it implements both `odid_message_process_pack()` and
`odid_wifi_receive_message_pack_nan_action_frame()`. Omitting it fails at link,
not at compile.

## [0.1.0] — 2026-09-01 — Peel back to a simple beeper

A deliberate reversal of the geospatial direction below, on two grounds: opsec
(the passive location history was a liability if the phone was ever found) and
simplicity (five modes were one behaviour — "match a known signature, beep" —
wearing different filters).

### Removed — the passive trail

- **Deleted the geospatial `sightStore`, the Leaflet map, the OSM history
  export, and all passive `watchPosition` logging.** The app kept a record of
  everywhere the device had been; a found phone betrayed the owner's movements.
  It now keeps **no history** — a live scope of what's matching right now,
  cleared on disconnect.
- **Collapsed five firmware modes into one always-on detector.** Removed the
  mode selector, the FreeRTOS mode queue, per-mode NVS, and the
  `mode_shadow` / `mode_beacon_bandit` / `mode_sky_sweeper` files plus the
  vendored `opendroneid.c` / `wifi.c` ODID decoder (~2,100 lines). The app
  bundle dropped from 179 kB to 19 kB (Leaflet gone).

### Changed — hardware

- **NeoPixel moved to an external 8-LED strip on GPIO2** (`NEOPIXEL_PIN 2`,
  `NEOPIXEL_COUNT 8` in `hardware_manager.h`), up from the single onboard LED on
  GPIO21. Buzzer stays on GPIO3. Category alert colours now light the whole
  strip.

### Added — headless identification + consented evidence

- **The buzzer pattern is the identification.** One detector runs BLE + WiFi
  concurrently and matches Flock/ALPR/camera, Axon body cams, drone Remote ID
  (BLE `0xFFFA` / WiFi vendor IE), and Apple Find My / Tile / SmartTag trackers.
  Each category sounds a distinct pattern (`triggerCategoryAlert`): ALPR two
  long beeps, body cam long-short-short, drone rising trill, tracker fast
  ticking — so a dash-mounted device tells you *what* is near with no screen.
- **The firmware confidence gate now governs the beep and the reported list.**
  With the phone classifier gone, the `W_*` weights are the anti-false-alarm
  gate (this inverts the old "never gate in firmware" rule, which existed only
  to feed the classifier).
- **Opt-in, per-device, encrypted location pins.** Recording defaults OFF. When
  on and a known device is detected, the phone asks — per device — whether to
  drop a pin. A Yes captures one GPS fix (never a track) and stores it as
  AES-GCM ciphertext behind a PIN (Web Crypto, no dependency). Detecting/beeping
  never needs the PIN; it gates only viewing/export. OSM export survives, scoped
  to those consented camera pins (that's DeFlock, not a movement leak).

## [Superseded] — 2026-09-01

### Changed — detection methodology

- **Watcher's Watch now finds cameras it has never heard of.** Detection was
  100% vendor fingerprinting, gated in firmware at `CONF_LIST_MIN 60`, so an
  ALPR whose OUI wasn't on the list never even reached the phone. The firmware
  is now a harvester — it reports everything it hears, with the signature
  confidence riding along as an annotation instead of a filter — and the phone
  classifies on **geospatial persistence**: a radio pinned to one place across
  repeat visits is bolted to something, whoever made it. Signature matches now
  only *label* what the geospatial test already found.
- **One shared sighting store.** Shadow's "seen in many places = a tail" and
  Watcher's Watch's "seen in one place across visits = infrastructure" are two
  queries against the same `sightStore`, which now **persists to localStorage**
  and survives restarts and mode switches (Shadow used to wipe its store on
  every mode entry, so confirming anything that takes days was impossible).
  Pruned aggressively — records still at one sighting after 24 h, anything
  unseen for 30 d — which is affordable because randomized MACs never earn a
  second visit and evaporate on their own.
- **A "visit" means you left and came back**, not that you lingered. Tracked by
  the phone's own travel (an epoch ticks each time *you* move >200 m), so an
  hour in a café counts once rather than confirming every radio in the building.
- **GPS accuracy is now respected.** Fixes vaguer than 50 m no longer place a
  device at all, and cluster centroids re-centre as a running mean — previously
  a cluster was a seed point that never moved, so one bad early fix anchored a
  camera to the wrong corner permanently, and that was the coordinate the
  export would publish.
- **Report caps are round-robin by staleness, not by RSSI.** Shadow sorted its
  40-device report by signal strength, so a crowd of loud stationary devices
  could permanently crowd out the persistent distant one the whole mode exists
  to catch. Both modes now report least-recently-seen first; Watcher's Watch
  pins signature hits so the alarm stays live on them.
- **Passive scanning where it costs nothing.** Sky Sweeper and Shadow no longer
  transmit `SCAN_REQ` at everything in range — Remote ID and sighting
  harvesting need only the advertisement. Watcher's Watch and Beacon Bandit stay
  active, where scan-response device names drive the rules.
- **Sky Sweeper keys on the UAS ID, not the MAC.** Remote ID transmitters rotate
  their MAC, so one aircraft used to become a new target — and a fresh alarm —
  on every rotation.
- **BT5 extended advertising / Coded PHY was attempted and backed out.**
  Remote ID is permitted over it and those transmitters are invisible without
  it, and enabling `CONFIG_BT_NIMBLE_EXT_ADV` gets the scan for free (NimBLE
  switches to `ble_gap_ext_disc()` with params for both PHYs, no Sky Sweeper
  change needed). But it also swaps `NimBLEDevice::getAdvertising()` to
  `NimBLEExtAdvertising`, and the reworked advertising path did not come up
  discoverable — the app could not connect at all. Losing the control link to
  the whole device to gain a minority of drone transmitters is a bad trade, so
  the flag is off. `startNusAdvertising()` is still written against both APIs,
  so re-enabling is a one-line change in `platformio.ini` once someone can test
  it against a real BT5 transmitter.
- **Wi-Fi channel dwell** cut from 250 ms to 150 ms (a 2.75 s → 1.65 s cycle),
  with an extra dwell granted to any channel that just yielded an ODID frame.
  `esp_wifi_set_promiscuous_filter(MGMT)` is now set in all three Wi-Fi modes —
  it never was, so every frame in the air reached the ISR only to be dropped in
  software.
- **Signature defaults are versioned and self-heal on flash**
  (`SIG_SCHEMA_VERSION`). `/data/signatures.json` lives on LittleFS and survives
  a firmware upload, and `ensureSignaturesFileExists()` only wrote defaults when
  the file was *missing* — so every already-booted device would have silently
  kept the old rule set below for ever. The file now carries a `version` and is
  regenerated when the defaults move ahead of it.
- **The signature list no longer contains entries that cannot mean "Flock".**
  Removed `a4:cf:12` and `3c:71:bf` (Espressif — this board's own vendor block,
  so every ESP32 in range matched), `cc:cc:cc` (not an assigned OUI), and
  `82:6b:f2` (locally-administered bit set, i.e. a randomized-MAC prefix that
  matches phones). Rules with the locally-administered bit are now rejected at
  load, including ones pushed from the app.
- Wi-Fi hits are labelled by **the rule that actually matched**. Every Wi-Fi
  detection used to be stamped `"Flock Safety"` regardless — so a Cradlepoint
  router or a stray ESP32 was reported as a Flock camera. The Lite-On vendor IE
  deliberately asserts no vendor at all.

### Fixed — the app gave up on the device, and the buzzer cried wolf

Both found by instrumenting a real field session rather than by reading code.
A 2 h 17 m drive produced **8.1 seconds** of data: 37 devices, all `candidate`,
all at one cluster (the driveway). Two independent faults, and between them they
explain every previous "hundreds of miles, nothing found" trip.

- **A dropped BLE link was terminal.** `onDeviceDisconnected()` set a banner,
  toasted, and stopped — there was no reconnect anywhere in the app.
  `reconcileConnection()` only re-syncs the UI on resume; it never re-establishes
  a dead link. Forensics on the phone: `localStorage` last written 12:44:26, the
  GATT client still *registered* until 15:01:54, no data in between. The link
  died 25 s after connecting and nobody was looking at the banner, because the
  phone was mounted on a dashboard. There is now a capped-backoff reconnect loop
  (2 s doubling to 30 s, forever) driven off a persisted `deviceId` — a
  `requestDevice()` chooser is useless to a driver, but a remembered id
  reconnects silently. A deliberate disconnect cancels it, so the button still
  means what it says.
- **The buzzer alerted on the sum of vague hints.** Confidence accumulates, so a
  consumer device on a listed OUI (30) that also carries the Lite-On vendor IE
  (30) landed on exactly `CONF_LIST_MIN` (60) and sounded the alarm. Confirmed in
  the field: it fired repeatedly on a route with no ALPR anywhere near it — the
  Lite-On OUI `50:6F:9A` rides countless consumer Wi-Fi chips. Alerting now tests
  the **strongest single signal** (`bestWeight >= CONF_ALERT_MIN`, 70), so it
  takes one signal that identifies something on its own — an SSID (80), device
  name (70) or service UUID (70) — never a pile of generic ones. The summed score
  still drives the list and the tier, where being generous costs nothing.

### Added — the buzzer follows the geospatial verdict

- **`{"alert": 0-100}` over NUS**, handled by `processIncomingCommand()` and
  backed by `watchersNoteExternalAlert()`. Detection moved to the phone because
  only the phone has GPS, but the *alert* stayed in the firmware bolted to the
  signature list — so the device could only ever shout about brands it already
  knew, which is exactly the blindness the geospatial classifier exists to fix.
  The app now fires this the moment `classify()` promotes a device out of
  `candidate`: 90 (alarm) for a confirmed fixed installation, 70 (warning) for a
  possible tail. Edge-triggered per device and rate-limited to one every 5 s, so
  driving into a cluster of cameras does not turn the buzzer into a siren.

### Fixed — the sight store was deleting confirmed detections

Confirming a fixed installation takes repeat visits across days, so weeks of
history *is* the detector. Two storage rules were quietly throwing that history
away, which un-detects cameras the classifier had already paid for.

- **Quota eviction kept chatty noise and deleted cameras.** When `localStorage`
  filled, `sightStoreSave()` sorted by `count` and dropped the weakest half. But
  `count` measures how *talkative* a radio is, not how *interesting*: a
  slow-beaconing ALPR caught on two drive-bys sits at ~6 sightings while a
  neighbour's smart TV sits at 4000 — so the eviction reliably kept the TV and
  binned the camera. This is the same mistake the firmware's report cap is
  already forbidden from making with RSSI, one layer up. Eviction now orders by
  what a record *is* (`classify()`): unclassified candidates go first, stalest
  first, and confirmed findings go last. If a finding ever does have to go, the
  user is told rather than losing it silently.
- **The 30-day stale prune expired confirmed installations.** A camera confirmed
  in March that you didn't drive past in April was deleted in May and had to
  re-earn its two visits from scratch. Confirmed `fixed` records are the output
  of the whole system and there are only ever a handful — they are now exempt.
  Pruning of one-hit randomized MACs is unchanged; that is what keeps the store
  small enough for `localStorage` to remain the right call.

### Added

- **Back up / restore detection history** (Settings). Weeks of visit history
  lived in exactly one `localStorage` key on one phone, so Android "Clear data",
  a reinstall or a new handset erased every confirmed detection. Export writes
  one JSON file carrying the sighting store *and* the whitelist — the whitelist
  is equally unrecoverable, and restoring sightings without it re-floods both
  lists with the user's own gear. Import **merges** rather than replaces, taking
  the max (never the sum) of every counter, so a restore cannot clobber
  sightings made since the backup and re-importing the same file twice cannot
  inflate a device into a false `fixed`.
- **OSM cross-check for confirmed installations** ("Check vs. OSM", War
  Flocking). OpenStreetMap already carries crowd-mapped ALPRs
  (`man_made=surveillance` + `surveillance:type=ALPR`) — the dataset DeFlock
  renders — and the geospatial classifier had no independent check against it.
  The map now shows three outcomes, and the third is the point of the whole
  project: **corroborated** (you confirmed a radio where OSM says a camera
  stands), **mapped only** (OSM knows it, you never heard it), and **unmapped**
  — a fixed installation you confirmed that nobody has mapped. Corroboration is
  a *label* and never feeds `classify()`; letting OSM promote or demote a
  detection would re-introduce exactly the list-shaped blindness the geospatial
  test exists to avoid, same rule that already governs signature matches.

  The query runs **only on the button press**, never on map pan or app start:
  asking Overpass about a bounding box tells a third party which patch of the
  world you are looking at, and for this tool's users that is a real disclosure.
  Results are cached in `localStorage` and merged by node id, so panning builds
  an area up rather than replacing it and a field trip can run off a prefetch
  made at home — the same offline story as the saved map tiles. Falls through to
  a second Overpass mirror on 5xx (the public endpoint rate-limits at 2 slots),
  then to the cache.

  Confirmed detections were also never actually drawn on the map, despite a
  comment claiming they were — only the GPS trail was. They are now, which is
  what makes the comparison visible at all.
- **`app/selftest.js`** — the sight-store self-check's comment claimed
  `node app.js` ran it headless; it never did (`window is not defined`). A ~25
  line DOM stub makes `node app/selftest.js` real, and the check now also covers
  eviction order, the prune exemption, and backup round-tripping. Verified by
  reverting both fixes and confirming the new assertions fail.

Both of these came out of a three-way comparison against two sibling projects.
The other project's SQLite/Drift session database was deliberately *not* copied:
it earns its keep there on many mesh nodes and many concurrent engines, and buys
zero detections for a few hundred records on one phone. Its real advantage was
that its store was a file you could copy, which is what the backup takes. Its
DeFlock/OSM overlay was worth taking outright.

### Changed — telemetry cost

Measured, not guessed: a 60 s soak showed the "1 Hz" push actually running at
0.77 Hz (46 pushes in 60 s) at ~33 devices, with 5.5 KB per push. Removing the
confidence gate took Watcher's Watch from 0-3 reported devices to as many as 40,
which made the telemetry path the dominant cost in the loop. After these three
changes the same soak gives **59 pushes in 60 s at ~2.8 KB** — cadence restored,
payload roughly halved.

- **Don't notify a characteristic nobody is subscribed to.** `sendBleSerial()`
  chunked and slept its way through the whole payload even with no BLE client
  connected. With no peer there is also no negotiated MTU, so a ~3 KB push
  fragmented into ~146 twenty-byte notifications with a yield between each —
  ~300 ms of every telemetry period spent talking to nobody. This was the actual
  cause of the slipped cadence; the other two below are real savings but did not
  move it on their own.
- **Chunk to the negotiated MTU instead of a fixed 180 bytes.** `onMTUChange`
  records what the peer agreed and `NimBLEDevice::setMTU(517)` raises the
  ceiling; at a typical 247-byte MTU that is 244 bytes per notification instead
  of 180. Falls back to 20 (the 23-byte BLE default minus 3) when nothing has
  been negotiated, which is correct rather than merely lucky.
- **Inter-chunk delay 10 ms -> 2 ms.** At ~32 chunks the old value was 320 ms of
  pure sleeping per cycle.
- **Dropped `first_seen_ms` / `last_seen_ms` / `duration_ms` from the wire** in
  all four modes. The app reads none of them — it keeps its own wall-clock
  timing in `sightStore` — and they were roughly a quarter of the payload.
  `durMs` still feeds the Beacon Bandit stalking score internally; it just isn't
  transmitted.
- **The USB serial mirror is gated on a host actually being attached**
  (`if (Serial)`), instead of pushing the same kilobytes out CDC unconditionally.

### Added

- **The buzzer now fires from the Wi-Fi path, not just BLE.** With no phone
  connected the buzzer is the whole user interface, and the strongest Flock
  signal in the system — an SSID match, weight 80 — exists only on the Wi-Fi
  side and made no sound whatsoever, because the only `triggerAlarm()` calls
  lived in the BLE callback. Both paths now record the hit and the 1 Hz task
  sounds it: >= 75 alarms, 60-74 warns, below 60 stays silent. Routing it
  through the task keeps the Wi-Fi promiscuous callback non-blocking (the
  trigger functions take a 10 ms mutex) and rate-limits a dense area to one
  alert per second instead of a continuous tone.
  Note this is inherently a *signature* alarm: the geospatial "is it bolted
  down" test needs GPS, which lives in the phone until Tier 3, so headless can
  only ever shout about brands it already knows.
- **`CMD:SIGS:RESET`** — restore the built-in signature rules. Once a rule set
  had been pushed there was no way back short of a full factory reset, which
  also wipes the mode and target lock.
- **The pilot's location on the map (Sky Sweeper).** Remote ID broadcasts where
  the *operator* is standing, and the firmware was already decoding and
  transmitting `operator_latitude`/`operator_longitude` — the app read the
  operator's ID string and threw the coordinates away. Drone and pilot now each
  get a marker, joined by a line.
- `window.__sightStoreSelfTest()` — runnable check for the store, visit logic,
  classifier, pruning and escaping. Also runs headless.
- `window.__sightDump([kind])` — console table of what the store currently
  believes: per device its classification, places, visits, hits, signature match
  and cluster centroid, plus the current visit epoch and GPS fix. The main
  field-debugging tool.
- The map is now shown in Sky Sweeper as well as War Flocking (it carries the
  drone/pilot markers); the `.osm` export button is hidden outside War Flocking,
  where it has no meaning.
- The "mark as mine" whitelist now suppresses a device in **both** branches. Your
  home router sits at one place you keep returning to, so it would otherwise
  confirm as fixed infrastructure, exactly as your phone would score as a tail.

### Fixed

- **LittleFS was never mounted, so the entire signature database has never
  loaded — on any build, ever.** Nothing called `LittleFS.begin()`. Every
  `LittleFS.exists()` therefore returned false and every `open()` failed, so
  `ensureSignaturesFileExists()` could not write the defaults and
  `loadWatchersSignatures()` bailed out leaving `loadedSignatures` empty. Every
  OUI, device-name, service-UUID and manufacturer-ID rule was dead code; the
  only Watcher's Watch detections that could ever fire were the two hardcoded
  checks in the Wi-Fi callback (the Lite-On vendor IE and the SSID keyword
  test), neither of which consults the rule list. Mounting it immediately
  brought the rules to life on the bench — and immediately exposed the next
  item.
- **Removed the `mfg_id: "0x01"` "Flock XUNTONG" default rule.** Bluetooth
  Company ID `0x0001` is Nokia's, not Flock's. Within seconds of the rules
  actually loading it was labelling Govee smart bulbs `"Flock Safety"`, tier
  `"Likely"`, at confidence 45. Same class of junk as the Espressif OUIs, and
  invisible until the filesystem worked. (Schema v3.)
- **Pushing a rule set with `{"signatures":[...]}` was a silent no-op.**
  `updateWatchersSignaturesJson()` wrote the file and then called
  `loadWatchersSignatures()`, which calls `ensureSignaturesFileExists()`, which
  saw no `version` field, judged the file stale against the new
  `SIG_SCHEMA_VERSION`, and deleted it. Pushed rules now carry the current
  version stamp.

- **Removed `restoreBleSerialAdvertising()`** — it had no callers anywhere in
  the tree, and it carried a latent bug worth recording because it bit during
  development of this very change set. It called `setAdvertisementData()` with
  an empty `NimBLEAdvertisementData` to "clear any custom payload", but that
  call pushes its payload to the controller *and* sets NimBLE's
  `m_customAdvData`, after which `start()` skips building the advertisement
  from `addServiceUUID()`/name (`NimBLEAdvertising.cpp`:
  `if (!m_customAdvData && !m_advDataSet)`). Anything calling it would have
  advertised an empty payload — no service UUID, no name — leaving the device
  undiscoverable to an app that filters on exactly those. The clear only ever
  made sense as a way to undo the `ble_spoof` custom payload, and `ble_spoof`
  was removed in 7d55f51. Advertising is now started from one place,
  `startNusAdvertising()`, which is documented never to do this.
- **`exportOSM` has never worked and now does.** It read a `trackedTargets`
  variable that doesn't exist in the app, so every click threw
  `ReferenceError`. Even had it run, it stamped every node with one coordinate
  (the phone's last position), read field names no telemetry emits, labelled
  everything a Flock ALPR, and did no XML escaping. It now emits one node per
  **confirmed fixed** device at **its own cluster centroid**, tags
  `man_made=surveillance` always, and adds a vendor claim only where a
  signature actually matched at Confirmed level — publishing a wrong
  manufacturer against a real location to a shared map is worse than
  publishing nothing.
- **Hostile device names could execute script.** Everything rendered via
  `innerHTML` string concatenation with unescaped device-supplied `name` /
  `value_ascii`, and MACs were interpolated into `onclick` handler strings. A
  BLE device chooses its own advertised name, and this app exists to be pointed
  at hostile hardware. All interpolation now goes through `esc()`; row actions
  use `data-mac` with delegated listeners.
- **Watcher's Watch leaked promiscuous mode.** `stopWatchersWatch()` never
  called `esp_wifi_set_promiscuous(false)` or cleared the rx callback.
- **Watcher's Watch never pruned its target list** — the only mode that didn't,
  so `trackedTargets` grew for the entire session. Now expires at 120 s.
- **Sky Sweeper's Wi-Fi beacon parser over-read.** `dataLen` was
  `length - dataStart` (everything to end-of-frame) instead of the vendor IE's
  own length byte, so the ODID decoder was fed the bytes of every subsequent IE
  plus the FCS as if they were drone data.
- Geolocation now falls back to `navigator.geolocation`. `window.Geolocation`
  only exists in the Capacitor build, so every geo feature — map trail,
  classifier, true-bearing radar — was silently inert during `npm run dev`.
- The Ring/Find button never appeared: it compared bare 16-bit UUIDs
  (`1802`/`2a06`) against the 128-bit strings NimBLE actually reports.
- `warFlockingPath` grew without bound — a stationary phone with jittery GPS
  appended every fix. Now gated on 10 m of movement.
- Removed dead code: `warFlockingMarkers`, `handleDeviceData`, `setupGeiger`
  (which called an undefined `updateGeigerUI`), the write-only `lastDeviceId`
  key, and four `{"get":"status"}` sends that matched no firmware branch.

### Added
- **Factory reset via the BOOT button** — hold BOOT for 5 s to erase all
  persisted state (NVS namespaces + LittleFS `/data/signatures.json`) and
  reboot as if freshly flashed. Red LED flash + a warning tone each second
  while held; release early to abort. A tap still resets to the mode selector,
  now firing on release so a tap and a hold can be told apart.
- **"Clear Target" button (Beacon Bandit)** — deselects the locked target from
  anywhere, appearing whenever the firmware reports a `locked_mac`. Previously
  the only way out was tapping the locked card, which is impossible once the
  locked device stops advertising and drops off the list (the lock persists in
  NVS).
- **Shadow mode** (mode 4) — tail / pursuit detection. The firmware harvests
  every BLE + Wi-Fi device it hears; the phone correlates each against its GPS
  trail and flags any that reappear near you across multiple distinct places
  (>200 m apart). Ranks devices "Watching" → "⚠ Following you" by how many
  separate places they've shadowed you.
  - **Whitelist** — tap a tail row to mark it as your own gear (car AP, phone,
    earbuds); it's hidden from scoring and persisted on the phone, so what
    remains flagged is genuinely foreign.
- **Watcher's Watch confidence scoring** — surveillance detections now carry a
  0–100 confidence and a Confirmed / Likely / Possible tier instead of a plain
  yes/no, with corroboration when a device is seen on both BLE and Wi-Fi.
- **Beacon Bandit stalking detection** — reads the Apple Find My
  "separated/offline" state and computes a per-device stalking score from
  persistence, sightings, and proximity; a "⚠ Stalking" badge surfaces likely
  trackers, and the locked-on target is pinned to the top of the list.
- **Tiered build system** — one codebase, one PlatformIO env per hardware tier
  (`tier1` ships today; `tier2`/`tier3` reserve seams for a screen/battery/second
  radio, then GPS/buttons). `flash.py --tier N` wraps the build+upload;
  `capabilities.h` gates hardware features; the compiled tier is stored in NVS.

### Changed
- **One radar, not two** — removed the generic List/Radar view toggle and its
  canvas radar, which placed blips at random angles and duplicated the real
  Sky Sweeper radar (sweep animation + true GPS bearing).
- **"Ring / Find" replaces the offensive path** — removed the BLE
  advertisement-spoofing engine (`ble_spoof`) entirely; the retained GATT write
  is reframed as a defensive action that rings a suspected tracker (Immediate
  Alert Service) so you can physically locate it. Arbitrary-hex GATT writes
  removed.
- **Fewer false positives in Watcher's Watch** — the Lite-On vendor IE
  (`50:6F:9A`) is treated as a weak, non-Flock-specific hint, and the listing
  floor was raised so a single weak signal no longer reports a device; a match
  needs a Flock/Axon-specific signal or two corroborating ones.
- **Sky Sweeper** and the Wi-Fi hoppers now sweep all 2.4 GHz channels (1–11)
  instead of just 1/6/11.
- Watcher's Watch and Sky Sweeper live-target lists now render in the app (they
  previously never populated); confidence/stalking badges added to target cards.
- The dashboard's ~1000-line inline script was extracted from `index.html` into
  `app/public/app.js` (no behavior change); unused React/Vite-plugin deps and
  dead patch scripts removed.

### Fixed
- **App/BLE state desync after backgrounding** — the app could show
  "disconnected" while the native BLE link was still live (and then fail to
  reconnect). It now reconciles against the real connection on resume and
  reattaches to an existing link instead of scanning.
- **`ble_write` spuriously re-locking the target** — a `ble_write`/`ble_spoof`
  command also fired the target-lock as a side effect; the lock is now gated on
  there being no `action`.
- **Bare-digit mode commands ("0"–"3") ignored** — a bare digit parses as valid
  JSON, so it bypassed the raw-text handler and did nothing; now handled.
- Firmware documentation corrected (there is no HTTP/REST server — everything is
  BLE NUS) and the app is documented as plain HTML/JS, not React.

---

Dates are ISO (YYYY-MM-DD). The app is pre-1.0 (`0.0.0`); this is the first
recorded changelog and covers work to date.
