B0z0dcl0wn/SignalSweep/firmware/src/main.cpp

// SPDX-License-Identifier: GPL-3.0-or-later
// Copyright (C) 2026 B0z0dcl0wn and the SignalSweep contributors

#include <Arduino.h>
#include "hardware_manager.h"
#include "ble_serial.h"
#include "mode_manager.h"
#include "mode_capture.h"
#include <NimBLEDevice.h>
#include <nvs_flash.h>
#include <LittleFS.h>
#include "alert_log.h"
#include "rtc_clock.h"
#include "sd_store.h"
#include "crash_report.h"

#if CONFIG_IDF_TARGET_ESP32C5
#define BOOT_BUTTON_PIN BOOT_PIN   // GPIO28 on the XIAO ESP32-C5 (esp32-hal.h)
#else
#define BOOT_BUTTON_PIN 0
#endif

void setup() {
    Serial.begin(115200);
    delay(500);
    Serial.println("\n=================================");
    Serial.println("   SignalSweep Firmware Booting   ");
    Serial.println("=================================");

    // Before anything allocates: read the last crash out of no-init RAM and the
    // coredump partition, then re-arm the breadcrumb for this boot.
    crashReportInit();

    pinMode(BOOT_BUTTON_PIN, INPUT_PULLUP);

    // 0. Initialize Hardware Manager (NeoPixel GPIO 21 & Buzzer GPIO 3)
    hardwareInit();

    // Initialize NVS properly before Bluetooth
    esp_err_t ret = nvs_flash_init();
    if (ret == ESP_ERR_NVS_NO_FREE_PAGES || ret == ESP_ERR_NVS_NEW_VERSION_FOUND) {
        nvs_flash_erase();
        nvs_flash_init();
    }

    // Mount LittleFS. Without this NOTHING filesystem-backed works: every
    // LittleFS.exists() returns false and every open() fails, so
    // ensureSignaturesFileExists() cannot write the defaults and
    // loadWatchersSignatures() bails out leaving loadedSignatures empty. That
    // silently disabled the entire Watcher's Watch signature database — every
    // OUI / device-name / service-UUID / manufacturer-ID rule was dead, and the
    // only detections that could fire were the two hardcoded checks in the
    // Wi-Fi callback. `true` formats on failure so a fresh board self-heals.
    if (!LittleFS.begin(true)) {
        Serial.println("[FS] LittleFS mount FAILED — signature rules unavailable.");
    } else {
        Serial.println("[FS] LittleFS mounted.");
    }

    // Must follow the mount: it bumps the boot counter that makes the alert
    // log's ordering key monotonic across power cycles, and derives the ring's
    // write head from the data rather than from a stored pointer.
    alertLogInit();

    // Optional DS3231. After alertLogInit() because a good RTC anchors this
    // boot in the log; the anchor is written on the first alertLogTick().
    rtcInit();
    Serial.printf("[RTC] %s\n", rtcState() == RTC_OK ? "DS3231 ok, clock set"
                              : rtcState() == RTC_LOST ? "DS3231 lost power, waiting for a host"
                              : "none fitted, waiting for a host");

    // Optional microSD card (sd_store.h). No card = no change anywhere.
    sdProbe();
    Serial.printf("[SD] %s\n", sdState() == SD_OK ? "card ok" : sdState() == SD_NONE ? "none fitted" : "card error");

    // Initialize BLE stack under whatever identity is stored. Both the name
    // and the address have to be settled before init/advertising, which is why
    // changing either from the app reboots the board.
    String bleName = getBleDeviceName();
    NimBLEDevice::init(bleName.c_str());
    if (getRandomMacEnabled()) applyRandomMac();
    Serial.printf("[BLE] Advertising as '%s'%s\n", bleName.c_str(),
                  getRandomMacEnabled() ? " (random address this boot)" : "");

    // 1. Initialize Nordic UART Service (NUS) over NimBLE
    bleSerialInit();

    // 2. Persist hardware tier and start the always-on detector.
    modeManagerInit();
}

// Hold BOOT for this long to wipe the device back to factory defaults.
#define FACTORY_RESET_HOLD_MS 5000

/**
 * @brief Erase all persisted state (NVS namespaces + LittleFS) and reboot.
 *
 * Wipes the mode, the bandit target lock, the buzzer preference, the stored
 * tier, and /data/signatures.json. The tier is rewritten from the compile-time
 * flag on the next boot and signatures.json is recreated with defaults, so the
 * device comes back up as if freshly flashed.
 */
static void factoryReset() {
    Serial.println("[FACTORY RESET] Erasing NVS + LittleFS...");
    triggerLedFlash(255, 0, 0, 1500);
    nvs_flash_erase();
    LittleFS.format();
    Serial.println("[FACTORY RESET] Done. Rebooting.");
    Serial.flush();
    delay(200);
    ESP.restart();
}

#ifdef SWEEP_CRASH_TEST
// Bench only (build with PLATFORMIO_BUILD_FLAGS=-DSWEEP_CRASH_TEST). Never ships.
__attribute__((noinline)) static void sweepCrashTest() {
    // An illegal instruction: a clean panic whose PC addr2line resolves here.
    // Not a store to NULL -- that traps on the S3 but is silently accepted on
    // the C5 (nothing guards address 0 there), so the C5 never crashed.
    __builtin_trap();
}
#endif

void loop() {
    // BOOT button: hold 5s wipes to factory defaults (there is no selector to
    // tap back to anymore — one always-on detector). Red flash + warning tone
    // every second while held is the "let go now" signal; releasing early
    // aborts.
    if (rebootDue()) {
        Serial.println("[BLE] Identity changed — restarting.");
        Serial.flush();
        ESP.restart();
    }

    static uint32_t pressStartMs = 0;
    static uint32_t lastWarnSec = 0;

    if (digitalRead(BOOT_BUTTON_PIN) == LOW) {
        if (pressStartMs == 0) {
            pressStartMs = millis();
            lastWarnSec = 0;
        }
        uint32_t heldMs = millis() - pressStartMs;

        if (heldMs >= FACTORY_RESET_HOLD_MS) {
            factoryReset();  // never returns
        }

        uint32_t heldSec = heldMs / 1000;
        if (heldSec > lastWarnSec) {
            lastWarnSec = heldSec;
            triggerLedFlash(255, 0, 0, 150);
            triggerWarning();
        }
    } else if (pressStartMs != 0) {
        uint32_t heldMs = millis() - pressStartMs;
        pressStartMs = 0;
        // A short tap is the way back in from receive-only with no cable at
        // all, which is the whole reason that mode needs no USB stack. Bounded
        // at 1 s so an aborted factory-reset hold isn't read as a tap, and it
        // never touches the long-press path above. No-op when already
        // advertising.
        if (heldMs < 1000) openAdvertisingWindow();
    }

    bleSerialTick();

    // Resume the detector after a capture ends. The capture task deletes itself,
    // so it can't restart the detector from inside; it flags this instead.
    captureTick();

    // USB host session, chirped like the BLE link. A plugged-in cable is not a
    // connection: the USB-Serial-JTAG stack's idea of "connected" is a host
    // sending SOFs (i.e. merely plugged in), and nothing reports the port being
    // opened -- opening it resets the board anyway. So the app says it is there:
    // CMD:HOST every ~2 s while it holds the port, CMD:HOST:BYE on a deliberate
    // disconnect. Silence past the timeout is a yanked cable or a killed app.
    // Other serial traffic (bench scripts, a terminal) never chirps.
    static const uint32_t SERIAL_HOST_TIMEOUT_MS = 6000;
    // A separate flag, not a "0 = none" timestamp: the first version stored
    // millis() | 1 to dodge zero, which on an even millisecond is 1 ms in the
    // future -- millis() - that underflows to ~4e9 and the session timed out
    // the instant it opened (bench: "connected" and "gone" in the same ms).
    static bool serialHost = false;
    static uint32_t serialHostMs = 0;

    // Process incoming commands from USB Hardware Serial
    while (Serial.available()) {
        String cmd = Serial.readStringUntil('\n');
        cmd.trim();
        // The printlns are the bench witness: nothing else shows a chirp
        // without someone in the room to hear it.
        if (cmd == "CMD:HOST") {
            if (!serialHost) { playConnectionChirp(); Serial.println("[USB] host connected"); }
            serialHost = true;
            serialHostMs = millis();
        } else if (cmd == "CMD:HOST:BYE") {
            if (serialHost) { playDisconnectionChirp(); Serial.println("[USB] host closed"); }
            serialHost = false;
#ifdef SWEEP_CRASH_TEST
        } else if (cmd == "CMD:CRASH") {
            sweepCrashTest();
        } else if (cmd == "CMD:ABORT") {
            // The shape of the C5's bt.c:562 panic: an abort() carries a panic
            // message (crash "reason"); an illegal instruction does not.
            abort();
#endif
        } else if (cmd.length() > 0) {
            processIncomingCommand(cmd);
        }
    }
    if (serialHost && millis() - serialHostMs > SERIAL_HOST_TIMEOUT_MS) {
        serialHost = false;
        playDisconnectionChirp();
        Serial.println("[USB] host gone");
    }

    // Yield to free CPU resources for background tasks
    vTaskDelay(pdMS_TO_TICKS(10));
}
