B0z0dcl0wn/SignalSweep/firmware/src/mode_watchers_watch.cpp

// SPDX-License-Identifier: GPL-3.0-or-later
// Copyright (C) 2026 B0z0dcl0wn and the SignalSweep contributors

#include "mode_watchers_watch.h"
#include "ble_serial.h"
#include <NimBLEDevice.h>
#include <NimBLEScan.h>
#include <NimBLEAdvertisedDevice.h>
#include <WiFi.h>
#include <esp_wifi.h>
// The S3 ROM exports tinfl_decompress (esp32s3.rom.ld), so we gunzip a compressed
// pwngrid advertisement for free. The C5 ROM (IDF 5.x) dropped miniz, so there is
// no rom/miniz.h there.
#if defined(CONFIG_IDF_TARGET_ESP32C5)
  // Vendor the MIT tinfl (inflate only) -- one-way compatible into GPL-3.0,
  // header intact. Same symbols the S3 gets from ROM, so the gzip code below
  // is identical on both boards.
  #include "vendor/miniz_tinfl.h"
  #define PWN_HAS_GUNZIP 1
#else
  #include "rom/miniz.h"
  #define PWN_HAS_GUNZIP 1
#endif
#include "alert_log.h"
#include "sd_log.h"
#include "crash_report.h"
#include <ArduinoJson.h>
#include <LittleFS.h>
#include <Preferences.h>
#include <esp_log.h>
#include <freertos/FreeRTOS.h>
#include <freertos/semphr.h>
#include <freertos/task.h>
#include <vector>
#include "attack_detectors.h"
#include "axon_checks.h"
#include <algorithm>
#include "hardware_manager.h"
#include "capabilities.h"
#include "mode_manager.h"
#include "c5_radio.h"
extern "C" {
#include "opendroneid.h"
#include "odid_wifi.h"
}

#if CONFIG_IDF_TARGET_ESP32C5
// NimBLE-Arduino 2.x hands scan results out as const; 1.x (the S3) does not.
// A macro rather than a typedef so the S3's preprocessed source stays
// token-identical (the S3 byte-identical gate).
#define SWEEP_ADV const NimBLEAdvertisedDevice
#else
#define SWEEP_ADV NimBLEAdvertisedDevice
#endif

static const char *TAG = "WatchersWatch";
static const char *SIG_FILE_PATH = "/data/signatures.json";

// Bump whenever the DEFAULT rule set changes meaningfully. The file lives on
// LittleFS and survives a firmware flash, so without this an already-deployed
// device keeps its old rules for ever — which is how the purged Espressif /
// unassigned / locally-administered OUIs would have quietly stayed in service
// on every board that had already booted once.
//   v2: removed a4:cf:12 + 3c:71:bf (Espressif, i.e. this very board's vendor
//       block), cc:cc:cc (unassigned), 82:6b:f2 (locally-administered).
//   v3: removed mfg_id 0x01 ("Flock XUNTONG"). 0x0001 is Nokia's assigned
//       Bluetooth Company ID; on the bench it matched Govee bulbs.
//   v4: added Tracker category (Tile / Samsung SmartTag service UUIDs). AirTag
//       "offline finding" is matched in code, not here (needs a payload type
//       byte the rule schema can't express). Feeds the Tracker buzzer word.
//   v5: removed the Raven rules — device names "raven"/"penguin" and service
//       UUIDs 3100/3200/3300/3400/3500. Both scored at or above CONF_ALERT_MIN
//       (W_NAME/W_UUID = 70), so a single one could fire the buzzer on its own,
//       and both are far too generic to carry that: "raven" and "penguin" are
//       ordinary product words matched as substrings, and a four-hex-digit UUID
//       is substring-matched against every UUID a device advertises. Same
//       failure shape as the mfg 0x01 rule that labelled Govee bulbs "Flock".
//   v6: added 14:b5:cd (upstream's 2026-07-16 addition) and removed f8:a2:d6,
//       which @NitekryDPaul field-demoted in that same revision — it hits a Sony
//       Media Player, not a Flock device. Same class of false positive as the
//       Espressif prefixes purged at v2 and the mfg 0x01 rule purged at v3.
//   v7: removed the standalone mfg 0x09C8 (XUNTONG) rule. At W_MFG it did not
//       beep alone, but it listed any 0x09C8 device as Flock. The Flock battery
//       ("Penguin") is now matched in code (blePenguin), which demands 0x09C8
//       PLUS a serial, or the full "Penguin-<10 digits>" name.
//   v8: label-only OUI hints for Genetec (AutoVu/Sharp ALPR) and Ubicquia
//       (streetlight camera/sensor nodes). OUI-only, so they never beep.
//   v9: SquachWatch-CYD extraction (registry-checked). Registered-maker OUIs
//       (b4:1e:52 Flock, d4:11:d6 ShotSpotter, 00:25:df Axon) list at 60
//       without beeping; Axon body-cam pairing SSIDs; smart glasses route to
//       body cam -- Ray-Ban/Oakley Meta requires Luxottica 0x0D53 AND fd5f
//       together (either alone also appears on other hardware), Snap 0x03C2
//       alone is fine; label-only
//       Motorola Solutions / Verkada / Avigilon Alta / Axis; the three
//       "Sierra" OUIs were Fiberblaze, Bitworks and unregistered -- replaced
//       with the six blocks the IEEE gives Sierra Wireless.
//   v10: Attack gear (SquachWatch-CYD values, registry-checked): Flipper Zero
//        service UUIDs 3081/3082/3083 (80), Flipper Devices company ID
//        0x0E29 and OUI 0c:fa:22 (70), a "flipper" name (60, listed only),
//        the STM32WB-derived 80:e1:26/27 addresses a Flipper Zero uses (60),
//        Pineapple_ management AP SSID (70) and the ESP deauther's "pwned"
//        SSID (60). All "Hacking gear", matched only while Attack is on.
//   v11: Flock's solar battery GATT services as exact 128-bit UUIDs (80):
//        auth e8ccbb38-... and safety 20c944c1-..., from the Flock firmware
//        dump. The first 128-bit UUID rules in the defaults.
//   v12: OUI-Spy's mode-selector AP, SSID prefix "oui-spy" (70, Hacking
//        gear). Its MAC is random per boot, so the default name is the only
//        handle; a renamed board is not caught.
//   v13: OUI-Spy's mode APs: "snoopuntothem" (Detector), "foxhunter"
//        (Foxhunter), "ouispy-" (PCAP + BLE Sniff), all 70, Hacking gear.
//   v14: Axon OUI 00:25:df raised 60 -> 70, so it beeps alone. Axon gear is
//        police gear; two of its 5 GHz APs at a traffic stop stayed silent.
//   v15: same rule for Flock's registered block b4:1e:52 and SoundThinking
//        d4:11:d6 (60 -> 70): no consumer owns either company's hardware.
//   v16: same test for the registry hints. Beep (70): Genetec (now "Genetec
//        ALPR"), Neology, WatchGuard Video, Digital Ally. List only (60):
//        Motorola Solutions (+2 prefixes), Verkada, Avigilon Alta, Axis
//        (+2), Ubicquia. Fleet routers stay at 30.
//   v17: attack-firmware default SSIDs, each read from the tool's own source
//        (70, Hacking gear): Bruce "BruceNet", GhostESP "GhostNet", Marauder's
//        updater "MarauderOTA", and the beacon-spam lists "01 Never gonna give
//        you up" (Marauder + Bruce Rick Roll) and "Yell BRUCE for Password".
//   v18: upstream review 2026-10-19 (SquachWatch-CYD, OUI-Spy AXEOFF,
//        Fieldwatch; every ID registry-checked). Removed Flipper Devices
//        0x0E29 + 0c:fa:22: they are the BUSY Bar desk sign's, and real
//        Zeros send neither. Added: Axon company 0x034D + UUIDs fc81/fe6b,
//        BodyWorn / Wolfcom / Reveal Media / FirstVu body-cam names, Flock's
//        "Flock Camera" hotspot SSID and "FS Ext Battery" name, Iteris
//        (BlueTOAD) + BLIP Systems roadside Bluetooth sensors, Tile fd84,
//        Chipolo, the DULT unwanted-tracker UUID fcb2, Meta glasses 0x01AB
//        AND fd5f, Meta feb7/feb8 (listed only), Snap fe45, Vuzix 0x060C,
//        PorkChop's "PORKCHOP" web-remote AP. UUID rules now also match
//        service data.
//   v19: second pass, 14 more upstreams (alpr_detector, all-cameras-are-beacons,
//        FlipDeFlock, Bruce, GhostESP...), every prefix checked against the
//        IEEE MA-L/MA-M/MA-S/IAB files and every 16-bit UUID against the SIG.
//        Removed: fe6d (the SIG gives it to the University of Tokyo, not
//        Axon), and the feed / fd5a UUID-list tracker rules (Skullcandy
//        headsets advertise FEED; bleTrackerNetwork already scores Tile and
//        SmartTag service data at 80). Added police vendors: body cams
//        (Utility, VIEVU, Digital Barriers, Zepcam, PRO-VISION, L-3
//        Mobile-Vision), plate readers (Redflex, ELSAG, Perceptics, Ekin,
//        Genetec IAB) and radar / lightbars (Applied Concepts-Stalker, Kustom,
//        Decatur, Federal Signal) at 70; Jenoptik, Kapsch, Elsag Datamat,
//        Selex ES, Havis, Gamber-Johnson, public-safety radio makers, police
//        drone makers and Motorola Solutions' BLE IDs at 60. Raven 3100-3500
//        back, exact-match, at 60. Glasses names + the HeyCyan UUID at 60.
//        Bruce and GhostESP default SSIDs / BLE names (Attack only).
//   v20: "Flock BLE Name" no longer beeps alone: "flock" and "pigvision"
//        drop to 60, and "fs_" is gone (any name containing it, the BLE
//        twin of "Chiefs_Guest"; bleFlockFsName covers FS-<hex> properly).
//   v21: speed / red-light camera makers from wardrive-go, IEEE-checked:
//        Sensys Traffic 00:22:9f and Gatsometer 00:18:29 at 70, filed like
//        Redflex. (Sensys Traffic AB, now Sensys Gatso -- not Sensys
//        Networks, the US road-sensor company.) Flipper Zero UUID rules
//        name the case colour: 3081 black, 3082 white, 3083 transparent.
//   v22: IEEE-checked. Fusus (Axon's real-time crime center hubs) MA-M blocks
//        84:b3:86:5 and 7c:83:34:4 at 70, filed so they route to the Cameras
//        tab (from OVERWATCH). Cradlepoint's second block 00:e0:1c, same weight
//        as 00:30:44. Luxottica Tristar 80:aa:1c and 38:47:12, the maker of
//        Ray-Ban / Oakley Meta glasses, listed at 60 (from ouispy-detector).
//   v23: upstream scan 2026-11-09. Fixes: 0x034D no longer flags IDO /
//        VeryFit watches that put their own address in the payload
//        (bleTaserIdSquatter, from RF Sentinel, GPL-3.0); a bare fe6c lists
//        at 60 and only fe6c service data with a serial beeps (bleAxonSignal),
//        AxonCadabra's X87002FP4 excluded (OVERWATCH, BSD-3); Wi-Fi Remote ID
//        on Parrot's 90:3A:E6 requires vendor type 0x0D. Added Raven
//        3101/3102 (60). RF Sentinel's ~110 registry-only prefixes were
//        reviewed and NOT added: no field sighting, and most of that gear
//        never transmits Wi-Fi or BLE.
#define SIG_SCHEMA_VERSION 23

static SemaphoreHandle_t watchersMutex = NULL;
static bool watchersRunning = false;
static std::vector<WatcherSignature> loadedSignatures;
static std::vector<WatcherTargetInfo> trackedTargets;
static TaskHandle_t watchersTaskHandle = NULL;

// Hunt: the one opt-in behaviour change on an otherwise always-on detector.
// While a MAC is hunted, its RSSI drives the Geiger clicker so you can walk a
// planted tracker down by ear. Everything else keeps detecting and beeping
// normally — this is a single variable, not a mode: no queue, no NVS, no
// selector, none of the state machine the last pass deleted.
// Persisted. The whole point of hunting is to unplug the board from the laptop,
// put it on a USB battery, and walk away from the phone — which is a power
// cycle. A lock that evaporated on reboot could only ever be used while
// tethered to the thing you were trying to walk away from.
static String huntMac = "";
// Ring is requested from the BLE write callback but performed on the 1 Hz task:
// a GATT connect must not run on the NimBLE callback stack, and it has to stop
// the scan first.
static String pendingRingMac = "";

// Foxhunt / "filter off": report every tracked device, not just signature
// matches. This is the old Beacon Bandit behaviour — turn the filter off, find
// something interesting, lock it, walk it down — and it is the one case where
// the reported list deliberately ignores CONF_LIST_MIN.
//
// It must never touch the ALERT gate. CONF_ALERT_MIN still governs the buzzer,
// so foxhunting shows you every phone in the room without beeping at any of
// them. Reporting everything is cheap; beeping at everything is the failure
// mode this whole design exists to avoid.
//
// Persisted, like everything else the operator sets. The extra payload only
// costs anything while a phone is subscribed — sendBleSerial() returns early
// with no client — so the earlier "always boot quiet" argument was protecting
// a budget that isn't being spent when nobody is listening.
static bool scanAll = false;
// Attack-gear detection (pwnagotchi, and later deauth/karma). Off by default:
// it is attack-adjacent and, unlike a signature match, some of its detectors
// are rate-based and prone to false alarms in busy places. Persisted, echoed.
static bool attackDetect = false;

// Rules filed under this category (Flipper, Pineapple, deauther SSIDs) are
// matched only while Attack is on; the pwnagotchi detector uses it too.
#define HACKING_GEAR_CATEGORY "Hacking gear"

// True while a rule must be skipped: it is attack gear and the operator has
// Attack off. Read live on every advert/frame, so flipping the toggle takes
// effect immediately. A plain bool read: safe in the radio callbacks.
static inline bool ruleGatedOff(const WatcherSignature& sig) {
    return !attackDetect && sig.category == HACKING_GEAR_CATEGORY;
}

// Per-device Ignore (idea from SquachWatch-CYD). MAC + the AlertCategory it
// sounded as, so the list still says what it was after the device is gone.
// Guarded by watchersMutex: read from noteAlertForTarget() (always called with
// it held), written by the command handlers on the NimBLE host task.
struct IgnoreEntry { uint8_t mac[6]; uint8_t cat; };
static_assert(sizeof(IgnoreEntry) == 7, "IgnoreEntry must be 7 bytes -- the NVS blob length check in restoreWatchersState() depends on it");
static IgnoreEntry ignoreList[IGNORE_MAX];
static uint8_t ignoreCount = 0;

// Caller holds watchersMutex. Bytes already parsed -- no re-parse per check.
static bool isIgnoredBytesLocked(const uint8_t m[6]) {
    for (uint8_t i = 0; i < ignoreCount; i++)
        if (memcmp(ignoreList[i].mac, m, 6) == 0) return true;
    return false;
}

// Caller holds watchersMutex.
static bool isIgnoredLocked(const String& mac) {
    if (ignoreCount == 0) return false;
    uint8_t m[6];
    if (!alertLogParseMac(mac.c_str(), m)) return false;
    return isIgnoredBytesLocked(m);
}

// Whether the clicker is currently sounding. Tracked separately from huntMac so
// the hunt can stay armed while the target is out of earshot.
static bool huntAudible = false;

// Hunting a Wi-Fi device needs two things the BLE path gets for free.
//
// First, the RSSI cannot be handed to the clicker from the promiscuous
// callback: updateGeigerRssi() takes the hardware mutex, and that callback must
// never block. So the sample is parked in a volatile here and the 1 Hz task
// applies it.
//
// Second, and more importantly, the channel hopper means we only hear a given
// access point while parked on its channel -- roughly one dwell in thirteen.
// That is fine for sweeping and useless for walking a signal down, so while a
// Wi-Fi target is being hunted the hopper stops and stays on its channel.
static volatile int huntWifiRssi = 0;
static volatile uint32_t huntWifiRssiMs = 0;
static volatile int huntChannel = 0;
#if CONFIG_IDF_TARGET_ESP32C5
// Which Wi-Fi band(s) the hopper covers (SweepBand). Written by setBand() on the
// command path, read by the hop task each dwell -- a byte, so volatile suffices.
static volatile uint8_t sweepBand = BAND_BOTH;
uint8_t getBand() { return sweepBand; }
#endif
// Set by the promiscuous callback on any Remote ID frame; the hopper reads and
// clears it to grant that channel one extra dwell.
static volatile bool odidHeard = false;

// Freshest RSSI for the hunted target, from whichever radio heard it. Written
// from both callbacks (volatile only -- the promiscuous handler must not take a
// mutex) and read by the 4 Hz hunt frame, which is what keeps the phone's meter
// in step with the clicker instead of a second behind it.
static volatile int      huntLastRssi = 0;
static volatile uint32_t huntLastRssiMs = 0;
/**
 * @brief Ensure /data/signatures.json exists on LittleFS, creating default rules if missing
 */
static void ensureSignaturesFileExists() {
    // Regenerate a file written by an older default rule set.
    if (LittleFS.exists(SIG_FILE_PATH)) {
        int fileVersion = 0;
        File existing = LittleFS.open(SIG_FILE_PATH, "r");
        if (existing) {
            JsonDocument probe;
            if (!deserializeJson(probe, existing)) {
                fileVersion = probe["version"] | 0;
            }
            existing.close();
        }
        if (fileVersion < SIG_SCHEMA_VERSION) {
            ESP_LOGW(TAG, "signatures.json is v%d, defaults are v%d — regenerating.",
                     fileVersion, SIG_SCHEMA_VERSION);
            LittleFS.remove(SIG_FILE_PATH);
        }
    }

    if (!LittleFS.exists(SIG_FILE_PATH)) {
        ESP_LOGI(TAG, "%s not found. Creating default signatures file...", SIG_FILE_PATH);
        if (!LittleFS.exists("/data")) {
            LittleFS.mkdir("/data");
        }
        File file = LittleFS.open(SIG_FILE_PATH, "w");
        if (file) {
            JsonDocument doc;
            doc["version"] = SIG_SCHEMA_VERSION;
            JsonArray sigs = doc["signatures"].to<JsonArray>();

            auto addRule = [&](const char* name, const char* cat, const char* oui, const char* mfg,
                               const char* dev, const char* uuid, int weight = 0, const char* ssid = "") {
                JsonObject s = sigs.add<JsonObject>();
                s["name"] = name;
                s["category"] = cat;
                // Matchers are written only when set (the loader and the app
                // read a missing one as empty): six empty strings per rule were
                // half the CMD:SIGS reply, which holds the BLE link while it sends.
                if (oui[0]) s["oui"] = oui;
                if (mfg[0]) s["mfg_id"] = mfg;
                if (dev[0]) s["device_name"] = dev;
                if (uuid[0]) s["service_uuid"] = uuid;
                if (weight > 0) s["weight"] = weight;
                if (ssid[0]) s["ssid_prefix"] = ssid;
            };

            // Flock Safety OUI prefixes.
            //
            // This list is not ours. It is the promiscuous-mode set compiled by
            // OrdoOuroborous / @NitekryDPaul (https://github.com/nitekry) and
            // circulated as the "GoFlockYourself" extended OUIs. Compiling it
            // meant physically finding cameras and confirming their prefixes.
            // Everything this detector knows about Flock hardware, it knows
            // because of that work. See CREDITS.md.
            //
            // Four entries from that original list are deliberately absent
            // here, because they cannot mean "Flock" and only generate false
            // positives:
            //   a4:cf:12, 3c:71:bf  Espressif — this board's own vendor block,
            //                       so every ESP32 in range matched. Upstream
            //                       itself flags a4:cf:12 as low confidence.
            //   cc:cc:cc            not an assigned OUI at all.
            //   82:6b:f2            locally-administered bit set (0x02) — that
            //                       is a randomized-MAC prefix, i.e. phones.
            //                       Upstream keeps it deliberately (it is
            //                       DeFlockJoplin's 12th camera) and warns
            //                       against filtering it; we cannot, because
            //                       loadWatchersSignatures() rejects
            //                       locally-administered prefixes at load time
            //                       so a pushed rule set can't reintroduce
            //                       them. Accepted cost: we miss that camera.
            //
            // f8:a2:d6 was dropped at v6 — upstream field-demoted it in the
            // 2026-07-16 revision after it was observed hitting a Sony Media
            // Player. 14:b5:cd was added in that same revision.
            // Annotated, not removed (it is the community's published list):
            // b8:35:32 is not in the IEEE registry; 48:27:ea is Samsung.
            const char* flockOuis[] = {
                "70:c9:4e", "3c:91:80", "d8:f3:bc", "80:30:49", "b8:35:32",
                "14:5a:fc", "74:4c:a1", "08:3a:88", "9c:2f:9d", "c0:35:32", "94:08:53",
                "e4:aa:ea", "f4:6a:dd", "24:b2:b9", "00:f4:8d", "d0:39:57",
                "e8:d0:fc", "e0:4f:43", "b8:1e:a4", "70:08:94", "58:8e:81", "ec:1b:bd",
                "58:00:e3", "90:35:ea", "5c:93:a2", "64:6e:69", "48:27:ea", "14:b5:cd",
                "04:0d:84", "1c:34:f1", "38:5b:44", "94:34:69",
                "b4:e3:f9", "f0:82:c0", "e0:0a:f6"
            };
            for (const char* oui : flockOuis) {
                addRule("Flock Safety MAC", "Flock Safety", oui, "", "", "");
            }
            // The one block the IEEE registers to Flock Safety itself. Beeps on
            // its own (70, v15): no consumer owns Flock hardware, so the address
            // alone is enough. The category keeps flockOui true, so the probe
            // path still sees it. (The flockOuis[] loop above stays at W_OUI:
            // those prefixes are shared with consumer Wi-Fi modules.)
            addRule("Flock Safety MAC (registered block)", "Flock Safety", "b4:1e:52", "", "", "", 70);

            // SoundThinking / ShotSpotter: sells only to police and cities, so
            // its registered address beeps alone (70, v15).
            addRule("SoundThinking", "SoundThinking", "d4:11:d6", "", "", "", 70);

            // Fusus: real-time crime center hubs, sold to police and the
            // businesses feeding them. No consumer owns one, so it beeps alone
            // (70, v22). MA-M sub-blocks, checked in the IEEE file by hand.
            addRule("Fusus device", "Fusus", "84:b3:86:5", "", "", "", 70);
            addRule("Fusus device", "Fusus", "7c:83:34:4", "", "", "", 70);

            // NOTE: the Raven service-UUID rules (3100/3200/3300/3400/3500)
            // were removed at v5, when service_uuid was substring-matched
            // against every UUID a device advertises, so a four-hex-digit
            // needle hit constantly — and at W_UUID (70) a single hit was
            // enough to beep. service_uuid is exact-matched now (uuidMatches),
            // but a UUID rule still has to be specific enough to stand alone,
            // because that is exactly what CONF_ALERT_MIN lets it do.

            // Flock's solar battery ("Penguin") GATT services, from the Flock
            // camera firmware dump (the Flock-You project, MIT; also in
            // SquachWatch-CYD). Full 128-bit, Flock's own -- exact-matched, so
            // nothing else carries them. The battery only shows these if its
            // link to the camera has dropped (the camera holds it open): 0 in
            // 173 captures so far. A sighting is a Flock pole, so it beeps.
            // v19: back, at 60 (listed, never beeps alone). Exact match fixed
            // the v5 problem; the values are field captures of Raven units
            // (all-cameras-are-beacons, Flock-You), not a registry.
            // v23: 3101 and 3102 (both GPS, like 3100), from RF Sentinel
            // (CIS-C0/RFSentinel 843c738, SignatureEngine.kt:73, GPL-3.0), which
            // credits an all-cameras-are-beacons field capture.
            for (const char* u : {"3100", "3101", "3102", "3200", "3300", "3400", "3500"})
                addRule("Flock Raven service UUID", "Flock Safety", "", "", "", u, 60);

            addRule("Flock battery (auth service)", "Flock Safety", "", "", "",
                    "e8ccbb38-9532-46a8-9fe5-1814df172e6f", 80);
            addRule("Flock battery (safety service)", "Flock Safety", "", "", "",
                    "20c944c1-add2-42d7-a638-967ee9a26ff6", 80);

            // Device Name Keywords. "raven" and "penguin" were dropped at v5:
            // ordinary words, matched as substrings, scoring W_NAME (70) — i.e.
            // self-sufficient to sound the alarm on someone's bluetooth speaker.
            // v20: substrings anyone can type, so listed, not beeped; "fs_"
            // dropped (bleFlockFsName matches the real FS-<hex> form).
            addRule("Flock BLE Name", "Flock Safety", "", "", "flock", "", 60);
            addRule("Flock BLE Name", "Flock Safety", "", "", "pigvision", "", 60);
            // Flock's external battery by name, and a camera's own hotspot,
            // "Flock Camera net." (Flock-You issue #43), which the 12-char
            // "Flock-XXXXXX" check misses. "FS-<hex>" names are matched in
            // code (bleFlockFsName).
            addRule("Flock external battery", "Flock Safety", "", "", "fs ext battery", "");
            addRule("Flock camera hotspot", "Flock Safety", "", "", "", "", 0, "Flock Camera");
            
            // NOTE: a rule matching manufacturer ID 0x01 was removed here.
            // Bluetooth Company ID 0x0001 is Nokia's, not Flock's, and once the
            // signature file actually started loading it immediately labelled
            // Govee smart bulbs as "Flock Safety / Likely" on the bench. Same
            // class of junk as the Espressif OUIs above.

            // Pre-existing SignalSweep Rules
            // 00:25:df is registered to Axon Enterprise. Axon makes more than
            // body cams (Tasers, docks, in-car Fleet, Signal units), so the
            // name says "device" -- but nearly all of it is police gear, so it
            // beeps on the OUI alone (70, v14). Field 2026-10-12: two Axon
            // 5 GHz APs at a traffic stop listed at 60 and stayed silent.
            addRule("Axon Enterprise device", "Axon", "00:25:df", "", "", "", 70);
            // Body cams broadcast these while pairing (Axon's own admin docs).
            // Vendor-documented, so they beep at the default W_WIFI_SSID (80).
            addRule("Axon Body 2 camera (pairing)", "Axon", "", "", "", "", 0, "AB2-");
            addRule("Axon Body 3 camera (pairing)", "Axon", "", "", "", "", 0, "AB3-");
            addRule("Axon Body 4 camera (pairing)", "Axon", "", "", "", "", 0, "AB4-");
            addRule("Axon device hotspot", "Axon", "", "", "", "", 0, "AXON-");
            // fe6c is TASER International's member UUID. Until v23 it beeped
            // as "Axon Signal System" on the bare UUID, which any replay tool
            // or phone app can advertise. Now the bare UUID lists (60) and
            // names only what it proves; fe6c service data carrying a serial
            // (the Signal trigger layout) beeps in code (bleAxonSignal), and
            // AxonCadabra's replayed serial X87002FP4 is excluded there and
            // in the matcher (OVERWATCH, BSD-3).
            addRule("Axon service UUID (fe6c)", "Axon", "", "", "", "fe6c", 60);
            // fe6d was here too until v19: the SIG registers it to the
            // University of Tokyo.
            // TASER International (= Axon) company ID and Axon's other two
            // SIG UUIDs (OUI-Spy AXEOFF 2026-10-09, SquachWatch-CYD). The
            // "BWCDEVICE" advert tag is matched in code (bleAxonBwc).
            // v23: IDO / VeryFit smartwatches squat on 0x034D; the matcher
            // drops those (bleTaserIdSquatter, from RF Sentinel), so the
            // rule keeps its 70 for everything else.
            addRule("Axon (TASER company ID)", "Axon", "", "0x034D", "", "", 70);
            addRule("Axon service UUID", "Axon", "", "", "", "fc81");
            addRule("Axon service UUID", "Axon", "", "", "", "fe6b");
            // Other police body cams, by the names their gear advertises
            // (Fieldwatch catalog; BodyWorn is Utility Inc.'s activation remote,
            // field-captured). Specific product names, so they beep (W_NAME).
            addRule("Utility BodyWorn body cam", "BodyWorn body cam", "", "", "bodyworn", "");
            addRule("Wolfcom body cam", "Wolfcom body cam", "", "", "wolfcom", "");
            addRule("Reveal Media body cam", "Reveal Media body cam", "", "", "reveal media", "");
            addRule("Digital Ally FirstVu body cam", "Digital Ally body cam", "", "", "firstvu", "");
            addRule("Cradlepoint Router", "Fleet / Infrastructure", "00:30:44", "", "", "");
            addRule("Cradlepoint Router", "Fleet / Infrastructure", "00:e0:1c", "", "", "");
            addRule("Peplink Router", "Fleet / Infrastructure", "00:1a:dd", "", "", "");
            // The six MA-L blocks the IEEE registers to "Sierra Wireless, ULC".
            // The old three were Fiberblaze (00:21:b2), Bitworks (00:07:e2) and
            // an unregistered prefix (00:f0:8a).
            addRule("Sierra Wireless Infrastructure", "Fleet / Infrastructure", "00:a0:d5", "", "", "");
            addRule("Sierra Wireless Infrastructure", "Fleet / Infrastructure", "28:a3:31", "", "", "");
            addRule("Sierra Wireless Infrastructure", "Fleet / Infrastructure", "50:13:9d", "", "", "");
            addRule("Sierra Wireless Infrastructure", "Fleet / Infrastructure", "64:ce:6e", "", "", "");
            addRule("Sierra Wireless Infrastructure", "Fleet / Infrastructure", "84:db:2f", "", "", "");
            addRule("Sierra Wireless Infrastructure", "Fleet / Infrastructure", "cc:93:4a", "", "", "");

            // Surveillance vendors from the IEEE registry, mostly NOT yet heard
            // on the air (much of this gear is wired). The test since v16 is
            // "could an ordinary person own this?" (user decision 2026-10-12):
            //   - police/ALPR-only makers beep on the address alone (70);
            //   - business security makers whose beep would also mean a hotel
            //     radio or an office door reader list without beeping (60).
            // A registered prefix costs nothing if it is never heard.
            // Genetec AutoVu/Sharp are plate readers: "ALPR" routes the row to
            // the Cameras tab and the ALPR beep.
            addRule("Genetec (AutoVu / Sharp)", "Genetec ALPR", "00:0a:b1", "", "", "", 70);
            addRule("Genetec (AutoVu / Sharp)", "Genetec ALPR", "00:bf:15", "", "", "", 70);
            addRule("Genetec (AutoVu / Sharp)", "Genetec ALPR", "0c:bf:15", "", "", "", 70);
            // Neology: plate readers and toll/registration RFID readers.
            addRule("Neology (ALPR / tolling)", "Neology ALPR", "00:17:3d", "", "", "", 70);
            // Police in-car and body cameras. WatchGuard *Video* (now Motorola),
            // never WatchGuard Technologies (00:01:21, 00:90:7f) -- that is the
            // firewall company.
            addRule("WatchGuard Video camera", "WatchGuard body cam", "00:1d:96", "", "", "", 70);
            addRule("Digital Ally camera", "Digital Ally body cam", "00:23:bd", "", "", "", 70);
            // Roadside Bluetooth travel-time sensors: they log passing phones
            // and cars by address. Road agencies own them, consumers do not.
            addRule("Iteris (BlueTOAD roadside sensor)", "Roadside surveillance", "00:14:7b", "", "", "", 70);
            addRule("BLIP Systems (BlipTrack sensor)", "Roadside surveillance", "00:0e:a5", "", "", "", 70);
            // v19, from datafx/alpr_detector's police-vendor table (GPL-3.0),
            // re-checked against the IEEE files. A prefix may be a sub-block
            // (MA-M 7 hex digits, MA-S/IAB 9): the matcher compares hex digits,
            // so "1c:82:59:d" matches only that /28.
            // Police body / in-car cameras (no consumer line): beep.
            addRule("Utility Inc. (BodyWorn) camera", "Utility body cam", "00:09:bc", "", "", "", 70);
            addRule("Utility Inc. (BodyWorn) camera", "Utility body cam", "00:16:ed", "", "", "", 70);
            addRule("VIEVU camera", "VIEVU body cam", "fc:01:9e", "", "", "", 70);
            addRule("Digital Barriers camera", "Digital Barriers body cam", "00:24:39", "", "", "", 70);
            addRule("Zepcam camera", "Zepcam body cam", "48:46:8d", "", "", "", 70);
            addRule("PRO-VISION camera", "PRO-VISION body cam", "9c:83:bf", "", "", "", 70);
            addRule("L-3 Mobile-Vision camera", "Mobile-Vision body cam", "38:73:ea:0", "", "", "", 70);
            // Plate-reader makers whose registered block is the ALPR business.
            addRule("Redflex (traffic enforcement)", "Redflex ALPR", "00:30:7e", "", "", "", 70);
            addRule("Sensys Traffic (traffic enforcement)", "Sensys ALPR", "00:22:9f", "", "", "", 70);
            addRule("Gatsometer (traffic enforcement)", "Gatso ALPR", "00:18:29", "", "", "", 70);
            addRule("ELSAG (plate reader)", "ELSAG ALPR", "70:b3:d5:1c:5", "", "", "", 70);
            addRule("Perceptics (plate reader)", "Perceptics ALPR", "70:b3:d5:88:a", "", "", "", 70);
            addRule("Ekin (plate reader / traffic)", "Ekin ALPR", "04:c3:e6:9", "", "", "", 70);
            addRule("Genetec (AutoVu / Sharp)", "Genetec ALPR", "00:50:c2:be:7", "", "", "", 70);
            // Police traffic radar and lightbars. All tab, generic beep.
            addRule("Stalker radar (Applied Concepts)", "Police radar", "1c:82:59:d", "", "", "", 70);
            addRule("Kustom Signals radar", "Police radar", "58:e8:76:c", "", "", "", 70);
            addRule("Decatur Electronics radar", "Police radar", "6c:18:11", "", "", "", 70);
            addRule("Federal Signal (lightbar / siren)", "Police lightbar", "08:3c:03:0", "", "", "", 70);

            // Listed, never beeping (60). The categories avoid every routing
            // keyword ("cam" would file Verkada under body cams), so these sit
            // under All only. Motorola Solutions owns Vigilant ALPR and makes
            // police radios, but also sells two-way radios to every hotel and
            // security firm; consumer "Motorola" phones are Motorola Mobility
            // (Lenovo), a different registrant.
            addRule("Ubicquia (streetlight node)", "Ubicquia", "94:7b:be", "", "", "", 60);
            addRule("Motorola Solutions device", "Motorola Solutions", "00:04:7d", "", "", "", 60);
            addRule("Motorola Solutions device", "Motorola Solutions", "00:18:85", "", "", "", 60);
            addRule("Motorola Solutions device", "Motorola Solutions", "00:1f:92", "", "", "", 60);
            addRule("Motorola Solutions device", "Motorola Solutions", "4c:cc:34", "", "", "", 60);
            addRule("Motorola Solutions device", "Motorola Solutions", "b8:e2:8c", "", "", "", 60);
            addRule("Motorola Solutions device", "Motorola Solutions", "10:74:6f", "", "", "", 60);
            addRule("Motorola Solutions device", "Motorola Solutions", "9c:86:2b", "", "", "", 60);
            addRule("Verkada camera", "Verkada", "e0:a7:00", "", "", "", 60);
            addRule("Avigilon Alta device", "Avigilon Alta", "70:1a:d5", "", "", "", 60);
            addRule("Axis Communications camera", "Axis Communications", "00:40:8c", "", "", "", 60);
            addRule("Axis Communications camera", "Axis Communications", "b8:a4:4f", "", "", "", 60);
            addRule("Axis Communications camera", "Axis Communications", "ac:cc:8e", "", "", "", 60);
            addRule("Axis Communications camera", "Axis Communications", "e8:27:25", "", "", "", 60);
            // v19. Traffic-tech makers whose blocks also cover industrial,
            // telecom or defence products: a hit names the maker, not an ALPR.
            addRule("Jenoptik device", "Jenoptik", "00:04:4c", "", "", "", 60);
            addRule("Jenoptik device", "Jenoptik", "48:e3:c3", "", "", "", 60);
            addRule("Kapsch device", "Kapsch", "00:e0:6a", "", "", "", 60);
            addRule("Elsag Datamat device", "Elsag Datamat", "00:40:de", "", "", "", 60);
            addRule("Selex ES device", "Selex ES", "70:b3:d5:52:1", "", "", "", 60);
            addRule("Selex ES device", "Selex ES", "70:b3:d5:f5:e", "", "", "", 60);
            // Patrol-car mounts and docks; also in utility and delivery fleets.
            addRule("Havis (vehicle dock)", "Police vehicle gear", "00:1f:9c", "", "", "", 60);
            addRule("Gamber-Johnson (vehicle dock)", "Police vehicle gear", "68:da:73:b", "", "", "", 60);
            // Public-safety radio makers; taxis, utilities and security firms
            // buy the same radios.
            addRule("Harris radio", "Two-way radio", "00:00:c3", "", "", "", 60);
            addRule("Harris radio", "Two-way radio", "00:06:ec", "", "", "", 60);
            addRule("Harris radio", "Two-way radio", "00:17:f3", "", "", "", 60);
            addRule("EF Johnson radio", "Two-way radio", "00:08:b8", "", "", "", 60);
            addRule("Tait radio", "Two-way radio", "00:0d:ca", "", "", "", 60);
            addRule("Sepura radio", "Two-way radio", "00:1e:96", "", "", "", 60);
            addRule("Hytera radio", "Two-way radio", "64:69:bc", "", "", "", 60);
            addRule("Hytera radio", "Two-way radio", "9c:06:6e", "", "", "", 60);
            addRule("Codan radio", "Two-way radio", "00:12:e0", "", "", "", 60);
            addRule("Codan (Daniels) radio", "Two-way radio", "00:14:91", "", "", "", 60);
            // Motorola Solutions over Bluetooth (company ID + its two SIG UUIDs).
            addRule("Motorola Solutions device", "Motorola Solutions", "", "0x04EC", "", "", 60);
            addRule("Motorola Solutions device", "Motorola Solutions", "", "", "", "fd8e", 60);
            addRule("Motorola Solutions device", "Motorola Solutions", "", "", "", "fe04", 60);
            // Police / first-responder drone makers. Remote ID still does the
            // real work; this names the maker when a unit is heard without it.
            addRule("Skydio drone", "Drone maker", "38:1d:14", "", "", "", 60);
            addRule("Teal drone", "Drone maker", "b0:30:c8", "", "", "", 60);
            addRule("AeroVironment drone", "Drone maker", "00:1a:f9", "", "", "", 60);
            addRule("AeroVironment drone", "Drone maker", "8c:1f:64:b0:7", "", "", "", 60);
            addRule("Shield AI drone", "Drone maker", "14:dd:48", "", "", "", 60);
            // IEEE says "Private"; field-attributed to Axon body cams (9 MACs,
            // 8 also carrying BWCDEVICE, all-cameras-are-beacons). Unverified,
            // so listed only and named for what it proves.
            addRule("Private block seen on Axon cams", "Axon", "d8:1f:65", "", "", "", 60);

            // Smart glasses: a camera on someone's face, counted like a body
            // cam (category keyword "glasses" routes to it on both sides).
            // Meta Platforms' own company IDs are deliberately absent: Quest
            // headsets carry them too. (Don't write their hex values here:
            // selftest.js fails on them anywhere in this block.)
            // Ray-Ban/Oakley Meta requires BOTH signals, not either alone: an
            // upstream detector found each one is a false-positive magnet on
            // its own (Meta's fd5f service UUID is plausibly on Quest headsets
            // too; the Luxottica company ID alone is weak). A rule ANDs every
            // condition it states, so this scores W_MFG+W_UUID (capped) then
            // the rule's own weight 70 -- only when both are present.
            addRule("Ray-Ban / Oakley Meta glasses", "Smart glasses", "", "0x0D53", "", "fd5f", 70);
            addRule("Snap Spectacles", "Smart glasses", "", "0x03C2", "", "", 70);
            // v18: two independent captures (SquachWatch-CYD) show real Ray-Ban
            // Meta sending Meta Platforms' ID WITH fd5f; Quest headsets send a
            // different Meta ID (still never a rule). Both required, as above.
            addRule("Ray-Ban / Oakley Meta glasses (Meta ID)", "Smart glasses", "", "0x01AB", "", "fd5f", 70);
            // Meta's other two UUIDs could be on any Meta hardware: listed only,
            // All tab only (v19: a Quest 2 headset matched them on the bench).
            addRule("Meta device (glasses or headset)", "Meta device", "", "", "", "feb7", 60);
            addRule("Meta device (glasses or headset)", "Meta device", "", "", "", "feb8", 60);
            // Snap's and Vuzix's only hardware is glasses.
            addRule("Snap Spectacles", "Smart glasses", "", "", "", "fe45", 70);
            addRule("Vuzix smart glasses", "Smart glasses", "", "0x060C", "", "", 70);
            // v22: the factory behind Ray-Ban / Oakley Meta. The address proves
            // the maker, not the product, so it lists and the name says so.
            addRule("Luxottica Tristar device", "Smart glasses", "80:aa:1c", "", "", "", 60);
            addRule("Luxottica Tristar device", "Smart glasses", "38:47:12", "", "", "", 60);
            // v19: product names (OVERWATCH, NearbyGlasses) and the HeyCyan
            // SDK service (Nilox and other rebrands; shares Apple ANCS's base,
            // so exact 128-bit only). Names can be typed by anyone: listed.
            for (const char* n : {"ray-ban", "rayneo", "rokid", "spectacles"})
                addRule("Smart glasses (by name)", "Smart glasses", "", "", n, "", 60);
            addRule("HeyCyan smart glasses", "Smart glasses", "", "", "",
                    "7905fff0-b5ce-4e99-a40f-4b1e122d00d0", 60);

            // Attack gear. Category HACKING_GEAR_CATEGORY: matched only while
            // Attack is on (ruleGatedOff), All tab only, generic beep.
            // Flipper Zero advertises one 16-bit service UUID per case colour
            // (its firmware's own constants -- there is no registry for them).
            addRule("Flipper Zero (black)", HACKING_GEAR_CATEGORY, "", "", "", "3081", 80);
            addRule("Flipper Zero (white)", HACKING_GEAR_CATEGORY, "", "", "", "3082", 80);
            addRule("Flipper Zero (transparent)", HACKING_GEAR_CATEGORY, "", "", "", "3083", 80);
            // Flipper Devices' own company ID and MAC block were removed at
            // v18: they are what the BUSY Bar (Flipper's desk sign) sends, and
            // three real Zeros on SquachWatch-CYD's bench sent neither. A Zero
            // builds its BLE address from ST's STM32WB derivation
            // (80:E1:26/27...), which is shared with other STM32WB hardware --
            // so those two are listed-only (60) hints named for what they
            // prove, not "Flipper". In no IEEE registry (selftest allowlists
            // them). Marauder's "Flipper" company ID 0x0FBA is a headset maker.
            addRule("STM32WB address (Flipper Zero uses this)", HACKING_GEAR_CATEGORY, "80:e1:26", "", "", "", 60);
            addRule("STM32WB address (Flipper Zero uses this)", HACKING_GEAR_CATEGORY, "80:e1:27", "", "", "", 60);
            // The default name, but anyone can type it: listed, never beeps
            // alone (a real Flipper also carries the UUID and beeps from that).
            addRule("Name contains Flipper", HACKING_GEAR_CATEGORY, "", "", "flipper", "", 60);
            // Vendor-default control APs. Pineapple_XXXX is specific; "pwned"
            // is also a common joke network name, so it lists without beeping.
            addRule("Pineapple management AP", HACKING_GEAR_CATEGORY, "", "", "", "", 70, "Pineapple_");
            // OUI-Spy (Colonel Panic) boot selector. Default SSID, bench-proven
            // 2026-10-06; the board randomizes its AP MAC every boot.
            addRule("OUI-Spy selector AP", HACKING_GEAR_CATEGORY, "", "", "", "", 70, "oui-spy");
            // Its modes' default APs. Flock-You WiFi and Sky Spy are passive (no
            // AP, no BLE advertising) and cannot be heard at all.
            addRule("OUI-Spy Detector AP", HACKING_GEAR_CATEGORY, "", "", "", "", 70, "snoopuntothem");
            addRule("OUI-Spy Foxhunter AP", HACKING_GEAR_CATEGORY, "", "", "", "", 70, "foxhunter");
            addRule("OUI-Spy capture AP (PCAP / BLE Sniff)", HACKING_GEAR_CATEGORY, "", "", "", "", 70, "ouispy-");
            addRule("'pwned' SSID (ESP deauther default)", HACKING_GEAR_CATEGORY, "", "", "", "", 60, "pwned");
            // Attack-firmware factory SSIDs, from each project's source. Only
            // the defaults: a renamed AP is not caught. The joke-SSID spam
            // lists are skipped except one line no home router carries.
            addRule("Bruce default AP", HACKING_GEAR_CATEGORY, "", "", "", "", 70, "BruceNet");
            addRule("GhostESP default AP", HACKING_GEAR_CATEGORY, "", "", "", "", 70, "GhostNet");
            addRule("Marauder OTA updater AP", HACKING_GEAR_CATEGORY, "", "", "", "", 70, "MarauderOTA");
            addRule("Rick Roll beacon spam (Marauder / Bruce)", HACKING_GEAR_CATEGORY, "", "", "", "", 70, "01 Never gonna give you up");
            addRule("Bruce joke-SSID beacon spam", HACKING_GEAR_CATEGORY, "", "", "", "", 70, "Yell BRUCE for Password");
            // PorkChop (M5PORKCHOP and its CYD port): the web-remote AP default.
            addRule("PorkChop web-remote AP", HACKING_GEAR_CATEGORY, "", "", "", "", 70, "PORKCHOP");
            // v19: Bruce's other fixed APs and BLE names, GhostESP's portals.
            addRule("Bruce attack-mode AP", HACKING_GEAR_CATEGORY, "", "", "", "", 70, "BruceKarma");
            addRule("Bruce attack-mode AP", HACKING_GEAR_CATEGORY, "", "", "", "", 70, "BruceShell");
            addRule("Bruce attack-mode AP", HACKING_GEAR_CATEGORY, "", "", "", "", 70, "BRUCE-UDP");
            addRule("Bruce attack-mode AP", HACKING_GEAR_CATEGORY, "", "", "", "", 70, "BruceSniffer");
            addRule("Bruce BLE attack mode", HACKING_GEAR_CATEGORY, "", "", "brucesniffer", "", 70);
            addRule("Bruce BLE attack mode", HACKING_GEAR_CATEGORY, "", "", "bruce-spammer", "", 70);
            addRule("Bruce BLE attack mode", HACKING_GEAR_CATEGORY, "", "", "bruce-flooder", "", 70);
            addRule("Bruce BLE attack mode", HACKING_GEAR_CATEGORY, "", "", "bruce-pn532-ble", "", 70);
            addRule("GhostESP evil portal AP", HACKING_GEAR_CATEGORY, "", "", "", "", 70, "EvilPortal");
            addRule("GhostESP evil portal AP", HACKING_GEAR_CATEGORY, "", "", "", "", 70, "EvilAP");

            // Trackers (planted-on-you category). Keyed on service UUID, which
            // the matcher already handles. AirTag is matched in code (its Find
            // My advert carries no service UUID — just Apple mfr data + a type
            // byte the rule schema can't express). Headless can only say "a
            // tracker is near", not "it's following you" — that needed the
            // geospatial history removed for opsec. Still worth the beep.
            // feed (Tile) and fd5a (SmartTag) were rules here until v19:
            // Skullcandy headsets list FEED, and bleTrackerNetwork already
            // scores both as service data (W_TRACKER).
            addRule("Tile Tracker", "Tracker", "", "", "", "feec");
            // v18 (SquachWatch-CYD / AirGuard, SIG-assigned): Tile's third
            // UUID; Chipolo, who make only trackers; and DULT fcb2, the
            // cross-maker "unwanted tracker" UUID a tag announces when it is
            // away from its owner.
            addRule("Tile Tracker", "Tracker", "", "", "", "fd84");
            addRule("Chipolo Tracker", "Tracker", "", "", "", "fe33");
            addRule("Chipolo Tracker", "Tracker", "", "", "", "fe65");
            addRule("Chipolo Tracker", "Tracker", "", "0x08C3", "", "", 70);
            addRule("Unwanted-tracker alert (DULT)", "Tracker", "", "", "", "fcb2");

            serializeJsonPretty(doc, file);
            file.close();
            ESP_LOGI(TAG, "Default signatures created successfully.");
        } else {
            ESP_LOGE(TAG, "Failed to open %s for writing!", SIG_FILE_PATH);
        }
    }
}

/**
 * @brief Confidence weights per signal type. An OUI prefix is weak (shared
 * across a vendor's whole catalogue and easily randomized); a matching mfg ID
 * is medium; a device-name substring or service UUID is strong. WiFi vendor-IE
 * and SSID weights live in the promiscuous callback.
 * ponytail: tune these against field false-positive rates.
 */
#define W_OUI    30
#define W_MFG    45
#define W_NAME   70
#define W_UUID   70
#define W_WIFI_OUI 30
// ponytail: Lite-On vendor IE (50:6F:9A) is only a weak hint — 50:6F:9A is
// Lite-On Technology's general OUI, present in many consumer WiFi chips, not
// Flock-specific. Bench testing flagged 3 random nearby devices as "Confirmed"
// when this was 80. Keep it weak; real confidence needs the SSID or corroboration.
#define W_WIFI_IE  30
#define W_WIFI_SSID 80
// A wildcard probe request (SSID IE tag 0, length 0) is worthless on its own --
// every phone in range sends them constantly, which is exactly why this is
// gated on the OUI having matched a *Flock* rule. The two together are two
// independent facts at once, and it is the only signal a current camera still
// emits: the management AP was deactivated ~Dec 2025 (taking W_WIFI_SSID with
// it) and BLE stopped working in spring 2026 (taking the name and mfg rules).
// Before this, a camera scored W_WIFI_OUI alone = 30 -- under CONF_LIST_MIN, so
// not even listed, let alone sounded. At 70 it clears CONF_ALERT_MIN on its
// own, which is the whole point: anything lower and the detector stays silent
// in front of the hardware it is named after.
// Research: DeFlockJoplin, via colonelpanichacks/flock-you. Drive-tested in
// Joplin at 11 of 12 cameras caught with 2 false positives.
#define W_WIFI_PROBE   70
// The same, plus the exact vendor IE payload (221, len 7, 50:6f:9a:16:03:01:03).
// Only ever a tightener on that path, never standalone: consumer WiFi sends it
// too (see the scoring block). This is the discriminating core of
// upstream's FLOCK_PROBE_IE_SIG_PRIMARY; their full ~200-line fingerprint
// builder (TLV resync, phantom-overflow recovery, a signature string compared
// against one hardcoded allowlist entry) buys very little over these 7 bytes
// and is tied to a single camera firmware revision.
#define W_WIFI_IE_SIG  80
#define W_CORROBORATION 15   // same MAC seen on both BLE and WiFi
// Protocol matches are unambiguous: an ASTM Remote-ID beacon IS a drone, an
// Apple Find My "offline finding" advert IS a tracker. Presence alone is the
// detection — no need to decode operator GPS just to sound the buzzer.
#define W_DRONE      90
#define W_TRACKER    80
// Flock's solar battery pack. Two facts at once (0x09C8 + a serial, or the full
// "Penguin-<10 digits>" name), so it identifies on its own. See blePenguin().
#define W_PENGUIN    80
// Axon's "BWCDEVICE" advert tag (bleAxonBwc): police-only, so it beeps.
#define W_AXON_BWC   80
// v23: fe6c service data carrying an ASCII serial, the Axon Signal trigger
// layout (bleAxonSignal). Police-only, so it beeps; the bare fe6c UUID lists.
#define W_AXON_SIGNAL 70
// v23: AxonCadabra's replay of one captured trigger (serial X87002FP4).
// Hacking gear, reported only while Attack is on, like the attack-SSID rules.
#define W_AXONCADABRA 70
// Flock "FS-<hex>" accessory name (bleFlockFsName): one source, lists only.
#define W_FLOCK_FS   60
// Pwnagotchi (pwngrid) presence: a beacon from the fixed source MAC
// de:ad:be:ef:de:ad carrying JSON in vendor IE id 222. The JSON fields
// (pwnd_tot/pwnd_run/grid_version) are the real tell — the MAC is trivially
// editable, so it is only corroboration. Strong: it identifies on its own.
#define W_PWNGRID    90
#define W_ATTACK 90   // attack-detector rows: above CONF_ALERT_MIN, generic beep
// A single weak, non-Flock-specific signal (a broad OUI prefix, or the Lite-On
// vendor IE that rides countless consumer WiFi chips) is noise on its own. Only
// list a device that clears 60 — i.e. one specific signal (SSID/UUID/name at
// 70-80) or two corroborating weak ones (OUI 30 + IE 30, or +15 cross-protocol).
// ponytail: this is the noise floor; lower it if real devices are being missed.
// Overridable at build time (-D CONF_LIST_MIN=0) so a bench test can see the
// full unfiltered harvest -- e.g. comparing antennas across two boards.
#ifndef CONF_LIST_MIN
#define CONF_LIST_MIN   60
#endif

// Listing and alerting are different questions and must not share a threshold.
// Confidence is a SUM, so two individually-meaningless hints add up to a
// specific-looking score: a consumer device on a listed OUI (30) that also
// carries the Lite-On vendor IE (30) lands on exactly 60 and used to sound the
// buzzer. Field-confirmed: the alarm fired repeatedly on a route with no ALPR
// anywhere near it. So the buzzer now tests the STRONGEST SINGLE signal
// (`bestWeight`), not the sum — it must be one signal that identifies something
// on its own (SSID 80, device name 70, service UUID 70), never a pile of
// generic ones. The sum still drives the list and the tier, where being
// generous is free.
#define CONF_ALERT_MIN  70

// Now that the mode harvests everything rather than only signature hits, the
// target list needs the same lifecycle every other mode already had.
#define WATCHERS_STALE_MS    120000  // drop devices unheard for 2 min
// Stop REPORTING a device unheard this long. It stays tracked to the 2 min
// above (so a drive-by still beeps once), but listing it was the phone showing
// a camera half a mile back at the RSSI it had beside it.
#define WATCHERS_REPORT_FRESH_MS 30000

// Hard cap on the tracked list. Every device heard is held until it has been
// silent for WATCHERS_STALE_MS, and each one costs ~50 B of INTERNAL heap (its
// Strings; the vector itself is in PSRAM past 4 KB on the C5). A C5 on a busy
// road ran out of internal heap ~2 min into a boot (2026-10-16: abort in the
// alert-log fopen lock); the bench flood took it from 58 KB free to 0.2 KB at
// ~1,900 devices. 400 bounds that at ~20 KB, far above a quiet street (~100).
#ifndef WATCHERS_MAX_TARGETS
#define WATCHERS_MAX_TARGETS 400
#endif

// Caller holds watchersMutex and is about to push_back one target. Evicts the
// least-recently-heard UNMATCHED target; never the hunted one, never one with
// an unwritten log record. ponytail: a full list of 400 matches evicts the
// oldest match instead -- not a real case; add a skip-the-newcomer path at the
// four call sites if one ever is.
static void makeRoomLocked() {
    if (trackedTargets.size() < WATCHERS_MAX_TARGETS) return;
    uint32_t now = millis();
    int victim = -1, victimMatched = 2;
    uint32_t victimAge = 0;
    for (size_t i = 0; i < trackedTargets.size(); i++) {
        const WatcherTargetInfo& t = trackedTargets[i];
        if (t.logPending || (huntMac.length() > 0 && t.mac.equalsIgnoreCase(huntMac))) continue;
        int matched = t.confidence >= CONF_LIST_MIN ? 1 : 0;
        uint32_t age = now - t.lastSeenMs;
        if (matched < victimMatched || (matched == victimMatched && age > victimAge)) {
            victim = (int)i; victimMatched = matched; victimAge = age;
        }
    }
    if (victim >= 0) trackedTargets.erase(trackedTargets.begin() + victim);
}

// How long the hunted target may go unheard before the clicker falls silent.
// Long enough to survive a few missed advertising intervals while you turn a
// corner; short enough that walking out of range stops the noise promptly.
#define HUNT_SILENCE_MS 8000
#define WATCHERS_MAX_REPORT  40      // per-push cap; selection is round-robin
#define WATCHERS_MAX_REPORT_ALL 18   // per-push cap while the filter is off

static String tierForConfidence(int confidence) {
    if (confidence >= 75) return "Confirmed";
    if (confidence >= 45) return "Likely";
    return "Possible";
}

// Headless alerting.
//
// With no phone connected the buzzer is the entire user interface, so it has to
// work off both radios — the strongest Flock signal there is (an SSID match,
// weight 80) exists only on the Wi-Fi side, and used to make no sound at all
// because the only triggerAlarm() calls lived in the BLE callback.
//
// Detections record the alert here instead of buzzing directly, and the 1 Hz
// task acts on it. Two reasons: the Wi-Fi promiscuous callback must never block
// (triggerAlarm takes a 10 ms mutex), and draining it once per tick naturally
// rate-limits a dense area to one alert per second instead of a continuous
// scream. Highest confidence seen in the interval wins.
//
// NOTE: this is inherently a *signature* alarm. The geospatial "is it bolted
// down" test needs GPS, which lives in the phone until Tier 3, so headless can
// only ever shout about brands it already knows. That's the deal, and it's
// still worth having.
static volatile int pendingAlertConf = 0;
// Buzzer alerts sounded since boot. Read back via CMD:CFG so the headless path
// can be verified after the fact -- see the comment in getAlertCount().
static volatile uint32_t alertsFired = 0;
// Which buzzer "word" the winning signal earns. The strongest single signal in
// the interval sets both the confidence and the category, so the sound matches
// what actually tripped the alarm.
static volatile AlertCategory pendingAlertCat = ALERT_GENERIC;

// Which categories are allowed to make a noise, one bit per AlertCategory
// (1<<ALERT_ALPR .. 1<<ALERT_GENERIC). Default: all of them. Every AirTag in
// traffic tripping the tracker pattern is correct behaviour and still useless to
// listen to, so the operator picks the words worth hearing. A muted category is
// fully silent — no beep, no LED flash, and it does not count in getAlertCount()
// — but it is still tracked and still reported to the app.
// Persisted (sweep-st/beepmask): headless means a power cycle must not undo it.
static uint8_t beepMask = BEEP_MASK_DEFAULT;

// Write every sounded alert to flash (alert_log.h). On by default, so a board
// with no card still keeps a record, and persisted (sweep-st/log) -- headless
// means a power cycle must not undo it.
static bool alertLogOn = true;

// Returns true if the alert was recorded (i.e. it will actually sound).
static bool noteAlert(int weight, const char* category) {
    if (weight < CONF_ALERT_MIN) return false;
    // Hunting: the clicker and the hunt meter are the only sound and light. A
    // category jingle would stomp the clicker and its animation would cover the
    // meter, on the one walk where you are listening to a single device. Not
    // recorded, so the target's alerted flag stays clear and it sounds once the
    // hunt ends if it is still around.
    if (huntMac.length() > 0) return false;
    // Easter egg: the bar is a flashlight or a party trick and nobody holding
    // it is looking for anything. Same contract as hunting -- not recorded, so
    // nothing is logged that you did not hear, the alerted flag stays clear,
    // and a device still around when the egg closes sounds then.
    if (getEggScene() != EGG_OFF) return false;
    AlertCategory cat = alertCategoryFromName(category);
    if (!(beepMask & (1 << cat))) return false;
    if (weight > pendingAlertConf) {
        pendingAlertConf = weight;
        pendingAlertCat = cat;
    }
    return true;
}

// Sound for a target the first time it proves itself, whether or not we had
// already started tracking it.
//
// This used to live only on the "new target" path, which silently lost real
// detections: a BLE device usually splits its data across the advertisement and
// the scan response, and the name — the strongest signal most rules have — often
// arrives only in the second one. The target was therefore created unmatched by
// the first packet, and the packet that actually identified it took the
// "already tracking" path, which never alerted. Drive past a camera, watch it
// appear in the list, hear nothing. Same for any device matched by a rule
// pushed after it was first seen.
//
// The flag lives on the target, so a device beeps once per appearance rather
// than once per advert; it clears naturally when the target goes stale and is
// pruned (WATCHERS_STALE_MS), so something you drive past twice beeps twice.
static void noteAlertForTarget(WatcherTargetInfo& t, int bestWeight, const String& category) {
    if (t.alerted) return;
    if (bestWeight < CONF_ALERT_MIN) return;
    // Ignored: stay quiet, and leave alerted clear so un-ignoring a device that
    // is still here sounds it (the beep-mask contract). Checked after the
    // weight threshold so a sub-threshold advert never pays the parse.
    if (isIgnoredLocked(t.mac)) return;
    // Only burn the once-per-appearance flag if the alert really sounded. A
    // muted category must stay un-flagged, or un-muting it mid-appearance would
    // be silent until the target went stale — the AirTag in your hand would
    // never beep.
    if (noteAlert(bestWeight, category.c_str())) {
        t.alerted = true;
        // The log follows the buzzer exactly: noteAlert() has already said no
        // for a muted category and during a hunt, so what reaches flash is what
        // you actually heard. Only the flag is set here -- this runs on both
        // radio callbacks, and a LittleFS write is tens of milliseconds. The
        // 1 Hz task does the I/O. Always flagged: a fitted card logs every
        // alert (user decision 2026-10-14); `log` gates only the flash ring.
        t.logPending = true;
    }
}

// Exact service-UUID match. A 4-hex-digit rule is a 16-bit SIG UUID: it
// matches that 16-bit UUID, or its 128-bit expansion on the Bluetooth base
// (0000xxxx-0000-1000-8000-00805f9b34fb), and nothing else. A longer rule must
// equal the whole UUID. Never a substring: that is how "3100" once matched
// every UUID with those digits in it and beeped (v5, the Raven rules).
static bool uuidMatches(const NimBLEUUID& u, const String& ruleUuid) {
    String want = ruleUuid;
    want.trim();
    want.toLowerCase();
    if (want.startsWith("0x")) want = want.substring(2);
    if (want.length() == 4) {
        uint16_t v = (uint16_t)strtoul(want.c_str(), NULL, 16);
        if (u.bitSize() == 16) return u == NimBLEUUID(v);
        String full = String(u.toString().c_str());
        full.toLowerCase();
        return full == ("0000" + want + "-0000-1000-8000-00805f9b34fb");
    }
    String have = String(u.toString().c_str());
    have.toLowerCase();
    return have == want;
}

// Axon payload checks (v23), defined beside bleAxonBwc().
static bool bleTaserIdSquatter(SWEEP_ADV* dev);
static AxonSignalKind bleAxonSignal(SWEEP_ADV* dev);

/**
 * @brief Match a device against one signature rule. Returns an accumulated
 * confidence weight (0 = no match). A rule ANDs its non-empty conditions; the
 * returned weight is the sum of the matched conditions' weights (capped 100).
 * A rule's own `weight`, when set, replaces that sum outright.
 */
static int matchDeviceAgainstRule(SWEEP_ADV* dev, const WatcherSignature& sig, String& outMatchedRule, String& outCategory) {
    // SSID rules are Wi-Fi-only; the promiscuous callback scores them.
    if (sig.ssidPrefix.length() > 0) return 0;
    if (ruleGatedOff(sig)) return 0;   // attack gear, Attack off

    int weight = 0;

    // 1. Check OUI (MAC Prefix). Public addresses only: a random BLE address
    // can start with any vendor's prefix by chance (a driveway "Iteris" on
    // 2026-10-21), the same reason the app's vendorOf() skips random ones.
    if (sig.oui.length() > 0) {
        if (dev->getAddress().getType() != BLE_ADDR_PUBLIC) return 0;
        String mac = String(dev->getAddress().toString().c_str());
        String cleanMac = "";
        for (size_t i = 0; i < mac.length(); i++) {
            char c = mac[i];
            if (c != ':' && c != '-') cleanMac += (char)toupper(c);
        }
        String cleanOui = "";
        for (size_t i = 0; i < sig.oui.length(); i++) {
            char c = sig.oui[i];
            if (c != ':' && c != '-') cleanOui += (char)toupper(c);
        }

        if (!cleanMac.startsWith(cleanOui)) {
            return 0;
        }
        weight += W_OUI;
    }

    // 2. Check Manufacturer ID
    if (sig.mfgId.length() > 0) {
        if (!dev->haveManufacturerData()) {
            return 0;
        }
        std::string mfg = dev->getManufacturerData();
        if (mfg.length() < 2) {
            return 0;
        }
        uint16_t devMfgId = static_cast<uint8_t>(mfg[0]) | (static_cast<uint8_t>(mfg[1]) << 8);

        String mfgStr = sig.mfgId;
        mfgStr.trim();
        uint16_t targetMfgId = 0;
        if (mfgStr.startsWith("0x") || mfgStr.startsWith("0X")) {
            targetMfgId = static_cast<uint16_t>(strtoul(mfgStr.c_str(), NULL, 16));
        } else {
            targetMfgId = static_cast<uint16_t>(strtoul(mfgStr.c_str(), NULL, 0));
        }

        if (devMfgId != targetMfgId) {
            return 0;
        }
        // v23: an IDO / VeryFit watch borrowing TASER's ID is not Axon. Checked
        // here, not per rule, so a pushed 0x034D rule is covered too.
        if (targetMfgId == TASER_COMPANY_ID && bleTaserIdSquatter(dev)) {
            return 0;
        }
        weight += W_MFG;
    }

    // 3. Check Device Name Substring
    if (sig.deviceName.length() > 0) {
        if (!dev->haveName()) {
            return 0;
        }
        String devName = String(dev->getName().c_str());
        devName.toLowerCase();
        String targetName = sig.deviceName;
        targetName.toLowerCase();

        if (devName.indexOf(targetName) < 0) {
            return 0;
        }
        weight += W_NAME;
    }

    // 4. Check Service UUID
    // A UUID counts in the UUID list OR as the key of a service-data AD
    // (0x16/0x20/0x21): most trackers advertise only the latter, so a rule
    // that read the list alone never fired on them (v18, after SquachWatch-CYD).
    if (sig.serviceUuid.length() > 0) {
        bool uuidMatched = false;
        size_t count = dev->haveServiceUUID() ? dev->getServiceUUIDCount() : 0;
        for (size_t i = 0; i < count && !uuidMatched; i++)
            uuidMatched = uuidMatches(dev->getServiceUUID(i), sig.serviceUuid);
        size_t sdCount = dev->getServiceDataCount();
        for (size_t i = 0; i < sdCount && !uuidMatched; i++)
            uuidMatched = uuidMatches(dev->getServiceDataUUID(i), sig.serviceUuid);
        if (!uuidMatched) {
            return 0;
        }
        // v23: AxonCadabra's replayed trigger is the tool, not Axon gear, so no
        // fe6c rule names it (the Attack detector reports it instead).
        if (uuidMatches(NimBLEUUID((uint16_t)0xFE6C), sig.serviceUuid) &&
            bleAxonSignal(dev) == AXON_SIG_CADABRA) {
            return 0;
        }
        weight += W_UUID;
    }

    if (weight == 0) {
        return 0;  // rule had no conditions
    }
    // A rule that states its own strength replaces the per-condition sum.
    if (sig.weight > 0) weight = sig.weight;

    outMatchedRule = sig.name.length() > 0 ? sig.name : "Matched Signature";
    outCategory = sig.category.length() > 0 ? sig.category : "Surveillance";
    return weight > 100 ? 100 : weight;
}

// Protocol detectors. The tracker check is presence-only (an AirTag's payload
// is a rotating public key; there is nothing to decode). The drone check is a
// full ASTM F3411 decode via the stock opendroneid reference implementation —
// Remote ID is a broadcast standard whose whole point is to be readable, so a
// drone hands us its serial, its position and the operator's position for free.
//
// ODID_UAS_Data is ~1 KB. Both callbacks run on tight stacks (the NimBLE scan
// task and the Wi-Fi promiscuous callback), so these are file-static rather
// than locals. bleUas is only touched inside the watchersMutex block; wifiUas
// only from the single-threaded promiscuous callback. Do not cross them.
static ODID_UAS_Data bleUas;
static ODID_UAS_Data wifiUas;
// Pwnagotchi IE-222 reassembly buffer. File-static for the same reason as
// wifiUas: touched only from the single-threaded promiscuous callback, and
// too big to want on that tight callback stack.
static char pwngridBuf[513];
// gunzip scratch for a compressed pwngrid advertisement (S3 only). The
// decompressor state is ~11 KB, far too big for the promiscuous callback stack;
// both are file-static and touched only from that single-threaded callback, like
// wifiUas/pwngridBuf.
#ifdef PWN_HAS_GUNZIP
static tinfl_decompressor pwnInflator;
static char pwnJson[1024];
#endif

// True if a decode produced anything worth reporting.
static bool odidUseful(const ODID_UAS_Data& d) {
    return d.BasicIDValid[0] || d.LocationValid || d.SystemValid ||
           d.OperatorIDValid || d.SelfIDValid;
}

// Feed one ODID payload to the decoder, picking packed vs single message.
static void odidDecodeInto(ODID_UAS_Data& out, const uint8_t* data, size_t len) {
    if (len == 0) return;
    if ((data[0] & 0xF0) == (ODID_MESSAGETYPE_PACKED << 4)) {
        odid_message_process_pack(&out, (uint8_t*)data, len);
    } else {
        decodeOpenDroneID(&out, (uint8_t*)data);
    }
}

// Which Basic ID to keep when a drone sends more than one (see applyDroneData).
// 0 (none stored yet) ranks below everything.
static uint8_t basicIdRank(uint8_t idType) {
    if (idType == ODID_IDTYPE_SERIAL_NUMBER) return 3;
    if (idType == ODID_IDTYPE_CAA_REGISTRATION_ID) return 2;
    return idType == ODID_IDTYPE_NONE ? 0 : 1;
}

// Copy a decoded frame onto a target. Fields are only overwritten when this
// frame actually carried them — Remote ID arrives as a stream of different
// message types, so a Location-only frame must not blank the serial we learned
// from an earlier Basic ID frame.
static void applyDroneData(WatcherTargetInfo& t, const ODID_UAS_Data& d) {
    t.hasDrone = true;
    // ASTM allows several Basic IDs, and EU drones commonly alternate the
    // serial with a CAA registration. The decode buffer is cleared per frame,
    // so taking whichever arrived last flipped uas_id (and droneMaker()'s
    // brand, which reads the serial) on every other frame. Keep the best
    // kind heard: serial > CAA registration > anything else.
    for (int i = 0; i < ODID_BASIC_ID_MAX_MESSAGES; i++) {
        if (!d.BasicIDValid[i] || !d.BasicID[i].UASID[0]) continue;
        uint8_t ty = (uint8_t)d.BasicID[i].IDType;
        if (basicIdRank(ty) < basicIdRank(t.uasIdType)) continue;
        t.uasId = String(d.BasicID[i].UASID);
        t.uasIdType = ty;
        if (d.BasicID[i].UAType) t.uaType = d.BasicID[i].UAType;
    }
    if (d.OperatorIDValid && d.OperatorID.OperatorId[0])  t.operatorId = String(d.OperatorID.OperatorId);
    if (d.SelfIDValid && d.SelfID.Desc[0])                t.selfId = String(d.SelfID.Desc);
    if (d.LocationValid) {
        t.droneLat  = d.Location.Latitude;
        t.droneLng  = d.Location.Longitude;
        t.altMsl    = d.Location.AltitudeGeo;
        t.heightAgl = d.Location.Height;
        t.heightRef = d.Location.HeightType;
        t.speed     = d.Location.SpeedHorizontal;
        t.vSpeed    = d.Location.SpeedVertical;
        t.heading   = d.Location.Direction;
        t.ridStatus = d.Location.Status;
    }
    if (d.SystemValid) {
        t.opLat = d.System.OperatorLatitude;
        t.opLng = d.System.OperatorLongitude;
        t.opLocType = d.System.OperatorLocationType;
        if (d.System.ClassificationType == ODID_CLASSIFICATION_TYPE_EU) {
            t.euCat   = d.System.CategoryEU;
            t.euClass = d.System.ClassEU;
        }
    }
}

// Decode ASTM Remote ID out of a BLE advert (UUID 0xFFFA in AD type 0x16,
// Service Data - 16-bit UUID). Returns true and fills `out` on a useful decode.
static bool bleDecodeRemoteId(SWEEP_ADV* dev, ODID_UAS_Data& out) {
#if CONFIG_IDF_TARGET_ESP32C5
    const std::vector<uint8_t>& raw = dev->getPayload();   // NimBLE 2.x: a reference, no copy
    const uint8_t* payload = raw.data();
    size_t len = raw.size();
#else
    uint8_t* payload = dev->getPayload();
    size_t len = dev->getPayloadLength();
#endif
    if (!payload || len < 4) return false;
    size_t offset = 0;
    while (offset + 1 < len) {
        uint8_t adLen = payload[offset];
        if (adLen == 0 || offset + 1 + adLen > len) break;
        uint8_t adType = payload[offset + 1];
        if (adType == 0x16 && adLen >= 3) {
            uint16_t uuid = payload[offset + 2] | (payload[offset + 3] << 8);
            if (uuid == 0xFFFA) {
                // ASTM F3411 BT4 framing: UUID, app code 0x0D, a 1-byte message
                // counter, THEN the 25-byte message (1+2+1+1+25 = adLen 30).
                // This used to skip the app code and decode from the counter,
                // shifting every field by a byte; the bench emitter sent no
                // app code or counter at all, so the bench never showed it.
                memset(&out, 0, sizeof(out));
                if (adLen >= 5 + ODID_MESSAGE_SIZE && payload[offset + 4] == 0x0D) {
                    odidDecodeInto(out, &payload[offset + 6], adLen - 5);
                }
                // A malformed or unsupported frame still means "a drone is
                // broadcasting Remote ID here", which is the alert-worthy fact.
                // Report presence either way; the decoded detail is a bonus.
                return true;
            }
        }
        offset += (adLen + 1);
    }
    return false;
}

// True if a BLE advert is an Apple "Find My" offline-finding beacon (an AirTag
// or other Find My tracker). Apple manufacturer data (company 0x004C) with
// message type 0x12. Deliberately NOT a bare 0x004C match — that is every
// iPhone/AirPod in range.
// The message LENGTH is the discriminator, and it is load-bearing. Apple sends
// type 0x12 in two shapes: a 2-byte status ping (`4c 00 12 02 00 02`) that every
// iPhone, iPad and Mac emits constantly, and the 25-byte offline-finding payload
// that carries the rotating public key — i.e. an item that is findable while
// SEPARATED from its owner. Measured across 18 bench/field captures: 1095
// distinct MACs sent the short form, 64 sent the long one. Matching on the type
// byte alone called all 1155 of them trackers, which is how a rural convenience
// store reported 22 AirTags (they were the customers' phones). A category that
// fires on every phone in the room is worse than no category at all.
//
// Tradeoff, accepted: an AirTag still beside its owner advertises the short form
// and is not flagged — but that is the case where the owner is standing next to
// you anyway. A planted tracker is separated by definition, so it sends 0x19.
static bool bleIsAirtag(SWEEP_ADV* dev) {
    if (!dev->haveManufacturerData()) return false;
    std::string mfg = dev->getManufacturerData();
    if (mfg.length() < 4) return false;
    uint16_t company = static_cast<uint8_t>(mfg[0]) | (static_cast<uint8_t>(mfg[1]) << 8);
    return company == 0x004C && static_cast<uint8_t>(mfg[2]) == 0x12
                             && static_cast<uint8_t>(mfg[3]) == 0x19;
}

// Flock's solar battery pack, codename "Penguin" (Nordic; the camera's own app
// calls it ExternalBattery). A Falcon itself never advertises BLE and keeps its
// Wi-Fi off on LTE, so this battery is the only radio on the pole -- and the
// camera holds a permanent link to it, so a healthy install is usually silent.
// It advertises when that link is down (camera rebooting, dead, or unpaired).
// Source: a published Falcon firmware dump (2026-09-21) for the codename and
// the held link; upstream oui-spy notes for the advert (facts only, no code):
//   before ~March 2025  name "Penguin-" + 10-digit serial
//   after               name is the bare 10-digit serial, mfg 0x09C8 (XUNTONG),
//                       "TN<digits>" in the manufacturer payload
// A bare 10-digit name is NOT enough: Apple Nearby Info adverts carry the
// placeholder name "0102000000" (two in our own captures). Nor is 0x09C8 alone.
static bool isTenDigits(const std::string& s, size_t from) {
    if (s.length() != from + 10) return false;
    for (size_t i = from; i < s.length(); i++) if (s[i] < '0' || s[i] > '9') return false;
    return true;
}

static bool blePenguin(SWEEP_ADV* dev) {
    std::string name = dev->haveName() ? dev->getName() : std::string();
    if (isTenDigits(name, 8) && strncasecmp(name.c_str(), "penguin-", 8) == 0) return true;
    if (!dev->haveManufacturerData()) return false;
    std::string mfg = dev->getManufacturerData();
    if (mfg.length() < 2 || static_cast<uint8_t>(mfg[0]) != 0xC8 || static_cast<uint8_t>(mfg[1]) != 0x09) return false;
    if (isTenDigits(name, 0)) return true;
    for (size_t i = 2; i + 2 < mfg.length(); i++)
        if (mfg[i] == 'T' && mfg[i + 1] == 'N' && mfg[i + 2] >= '0' && mfg[i + 2] <= '9') return true;
    return false;
}

// An Axon body cam puts ASCII "BWCDEVICE" in its advert, usually inside a
// 128-bit UUID (little-endian on air, so it reads "ECIVEDCWB"). It survives
// address rotation, so it is the BLE tell that does not need Axon's OUI.
// Five owner-confirmed field captures (all-cameras-are-beacons, via
// SquachWatch-CYD 2026-10-14). Searched in the raw payload, both orders.
static bool bleAxonBwc(SWEEP_ADV* dev) {
#if CONFIG_IDF_TARGET_ESP32C5
    const std::vector<uint8_t>& raw = dev->getPayload();
    const uint8_t* p = raw.data();
    size_t len = raw.size();
#else
    const uint8_t* p = dev->getPayload();
    size_t len = dev->getPayloadLength();
#endif
    static const char F[] = "BWCDEVICE";
    const size_t n = 9;
    if (!p) return false;
    for (size_t i = 0; i + n <= len; i++) {
        bool fw = true, bw = true;
        for (size_t k = 0; k < n && (fw || bw); k++) {
            if (p[i + k] != (uint8_t)F[k]) fw = false;
            if (p[i + k] != (uint8_t)F[n - 1 - k]) bw = false;
        }
        if (fw || bw) return true;
    }
    return false;
}

// v23: an IDO / VeryFit smartwatch (IDW26, ID205...) sends TASER's company ID
// 0x034D with its own address as the first 6 payload bytes, plus service
// 0x0AF0 or an "ID<digits>" model name. Axon gear never repeats its address.
// Ported from RF Sentinel's isTaserIdSquatter() (CIS-C0/RFSentinel 843c738,
// SignatureEngine.kt:195-229, GPL-3.0); the byte test is taserIdSquatter() in
// axon_checks.h, host-tested in firmware/test/axon_checks_test.cpp.
static bool bleTaserIdSquatter(SWEEP_ADV* dev) {
    if (!dev->haveManufacturerData()) return false;
    std::string mfg = dev->getManufacturerData();
    if (mfg.length() < 8) return false;
    // The address in display order (the order it prints). Parsed from the
    // string so it reads the same on NimBLE 1.x (S3) and 2.x (C5).
    std::string a = dev->getAddress().toString();
    if (a.length() < 17) return false;
    uint8_t addr[6];
    for (int i = 0; i < 6; i++) {
        char hex[3] = {a[i * 3], a[i * 3 + 1], 0};
        addr[i] = (uint8_t)strtoul(hex, NULL, 16);
    }
    const NimBLEUUID ido((uint16_t)IDO_WATCH_SERVICE);
    bool hasIdo = false;
    size_t count = dev->haveServiceUUID() ? dev->getServiceUUIDCount() : 0;
    for (size_t i = 0; i < count && !hasIdo; i++) hasIdo = dev->getServiceUUID(i) == ido;
    size_t sdCount = dev->getServiceDataCount();
    for (size_t i = 0; i < sdCount && !hasIdo; i++) hasIdo = dev->getServiceDataUUID(i) == ido;
    std::string name = dev->haveName() ? dev->getName() : std::string();
    return taserIdSquatter((const uint8_t*)mfg.data(), mfg.length(), addr, hasIdo, name.c_str());
}

// v23: what the fe6c service data says. A serial-shaped payload is the Axon
// Signal trigger layout and beeps (W_AXON_SIGNAL); AxonCadabra's replayed
// serial X87002FP4 is the tool and is told apart. KaraZajac/OVERWATCH
// (BSD-3), AxonSignatures.kt + HackerTargets.kt; the byte test is
// axonSignalKind() in axon_checks.h.
static AxonSignalKind bleAxonSignal(SWEEP_ADV* dev) {
    if (dev->getServiceDataCount() == 0) return AXON_SIG_NONE;
    std::string d = dev->getServiceData(NimBLEUUID((uint16_t)0xFE6C));
    return axonSignalKind((const uint8_t*)d.data(), d.length());
}

// "FS-" plus 4-12 hex digits and nothing else (e.g. FS-BEC46A): a Flock
// accessory name seen at real Flock sites (all-cameras-are-beacons, 2026-06).
// One source, and a short hex name is not unthinkable elsewhere, so it lists
// at W_FLOCK_FS (60) without beeping. "FS-Living Room" is not one.
static bool bleFlockFsName(SWEEP_ADV* dev) {
    if (!dev->haveName()) return false;
    std::string name = dev->getName();
    if (name.length() < 7 || name.length() > 15 || name.compare(0, 3, "FS-") != 0) return false;
    for (size_t i = 3; i < name.length(); i++) if (!isxdigit((unsigned char)name[i])) return false;
    return true;
}

// What an Apple device is DOING, from the Continuity message type — or nullptr
// when this is not Apple manufacturer data. Not a category and not a detection:
// it adds no confidence, so these rows stay out of the filtered list and never
// beep. It exists so that the filter-off view says "Apple: iPhone/iPad/Mac (in
// use)" instead of an anonymous random MAC, which is what made the tracker
// category look like it was firing on everything.
//
// Types are Apple's published-by-observation Continuity set; the ones here are
// every type seen across 18 bench/field captures, counted by distinct MAC:
// 0x10 Nearby Info (685), 0x16 (196), 0x02 iBeacon (126), 0x09 AirPlay (110),
// 0x0C Handoff (45), 0x03 AirPrint (16), 0x13 (11), 0x0F Nearby Action (7).
// Which crowd-sourced finding network this advert belongs to, or "" for none.
// Apple is handled separately (bleIsAirtag) because only Apple shares one
// message type between trackers and ordinary phones. These three do not: a
// phone never advertises them, so the service UUID alone is the detection.
//
//   Tile       0xFEED — the only thing that sends it is a Tile. Verified: 3
//                       distinct Tiles across our own captures.
//   Samsung    0xFD5A registered (enrolled in offline finding, i.e. findable by
//                       any Galaxy nearby) / 0xFD59 unregistered, still in setup.
//   Google FMDN 0xFEAA service data, frame byte 0x40 normal / 0x41 "unwanted
//                       tracking protection" — the tracker itself signalling it
//                       may be following someone. Eddystone shares 0xFEAA with
//                       frame types 0x00/0x10/0x20/0x30, so the frame byte is
//                       what separates a finding beacon from a shop beacon.
//
// Spec sources: Google Find Hub / FMDN accessory spec; Samsung offline-finding
// analysis (arXiv 2210.14702). Checked against our own captures: the Tile arm
// fires on the bench Tile keychain (`d5:95:0b:0a:22:e1`, 61 adverts across six
// captures on three days, up to -40 dBm) plus two Tiles in the field, and one
// real FMDN tag turned up at -89 dBm with frame byte 0x40. **Samsung is the one
// arm no capture has exercised** — it is written from the spec and unproven.
static String bleTrackerNetwork(SWEEP_ADV* dev) {
    if (dev->getServiceDataCount() == 0) return String();

    std::string fmdn = dev->getServiceData(NimBLEUUID((uint16_t)0xFEAA));
    if (fmdn.length() >= 1) {
        uint8_t frame = static_cast<uint8_t>(fmdn[0]);
        if (frame == 0x41) return "Google Find My Tracker (unwanted-tracking mode)";
        if (frame == 0x40) return "Google Find My Tracker";
        return String();   // an ordinary Eddystone beacon, not a tracker
    }
    if (dev->getServiceData(NimBLEUUID((uint16_t)0xFEED)).length() > 0) return "Tile Tracker";
    if (dev->getServiceData(NimBLEUUID((uint16_t)0xFD5A)).length() > 0) return "Samsung SmartTag";
    if (dev->getServiceData(NimBLEUUID((uint16_t)0xFD59)).length() > 0) return "Samsung SmartTag (setup)";
    return String();
}

//
// Nearby Info (0x10) carries one more byte worth decoding: high nibble status
// flags, low nibble an activity code. Field meanings are documented by the
// furiousMAC Continuity project (GPL-2.0 — facts used, no code taken; see
// CREDITS.md). Cross-checked against our own captures, where the packed byte
// lands on 0x31 (reporting disabled, 156 frames), 0x32 (idle, 116), 0x37
// (active, 136) and 0x3B (recent interaction, 149) — i.e. the table still
// describes 2026 devices. Deliberately NOT decoded: lid open/closed. macOS
// simply stops advertising when the lid shuts, which is indistinguishable from
// powered off, asleep or out of range, so reporting it would be a guess.
static String appleRole(SWEEP_ADV* dev) {
    if (!dev->haveManufacturerData()) return String();
    std::string mfg = dev->getManufacturerData();
    if (mfg.length() < 3) return String();
    uint16_t company = static_cast<uint8_t>(mfg[0]) | (static_cast<uint8_t>(mfg[1]) << 8);
    if (company != 0x004C) return String();
    switch (static_cast<uint8_t>(mfg[2])) {
        case 0x10: {
            if (mfg.length() < 5) return "Apple: iPhone/iPad/Mac";
            switch (static_cast<uint8_t>(mfg[4]) & 0x0F) {
                case 0x01: return "Apple: iPhone/iPad/Mac (reporting off)";
                case 0x03: return "Apple: iPhone/iPad/Mac (idle)";
                case 0x05: return "Apple: iPhone/iPad/Mac (audio, screen locked)";
                case 0x07: return "Apple: iPhone/iPad/Mac (active, screen on)";
                case 0x09: return "Apple: iPhone/iPad/Mac (video playing)";
                case 0x0A: return "Apple: Watch (on wrist, unlocked)";
                case 0x0B: return "Apple: iPhone/iPad/Mac (just used)";
                case 0x0D: return "Apple: iPhone (driving)";
                case 0x0E: return "Apple: iPhone (on a call)";
                default:   return "Apple: iPhone/iPad/Mac";
            }
        }
        case 0x12: return "Apple: Find My (with owner)";  // short form; the 0x19 form is the tracker
        case 0x02: return "Apple: iBeacon app";
        case 0x03: return "Apple: AirPrint (printer)";
        case 0x05: return "Apple: AirDrop";
        case 0x06: return "Apple: HomeKit accessory";
        case 0x07: return "Apple: AirPods pairing";       // Proximity Pairing, confirmed 0x07
        case 0x08: return "Apple: Hey Siri";
        case 0x09: return "Apple: AirPlay target (TV/HomePod/Mac)";  // confirmed 0x09
        case 0x0A: return "Apple: AirPlay source";
        case 0x0B: return "Apple: Watch (Magic Switch)";
        case 0x0C: return "Apple: Handoff";
        case 0x0D: return "Apple: tethering target";
        case 0x0E: return "Apple: tethering source (hotspot)";
        case 0x0F: return "Apple: Nearby Action";
        // 0x01, 0x13 and 0x16 are live in our captures (120, 11 and 196 distinct
        // MACs) but are not in any published table, so they stay unnamed rather
        // than guessed at.
        default:   return "Apple device";
    }
}

// Bluetooth SIG company ID from the manufacturer data, or -1 if this advert
// carries none. The app names the vendor from it -- the one vendor hint that
// survives a randomized address, which is most of BLE.
static int32_t bleCompanyId(SWEEP_ADV* dev) {
    if (!dev->haveManufacturerData()) return -1;
    std::string mfg = dev->getManufacturerData();
    if (mfg.length() < 2) return -1;
    return static_cast<uint8_t>(mfg[0]) | (static_cast<uint8_t>(mfg[1]) << 8);
}

// Forward declaration: upsertAttackTarget is defined later in this file (used
// today only from the WiFi promiscuous callback, below its own definition),
// but the BLE-spam detector inside WatchersScanCallbacks::onResult needs it
// too, and that class is defined earlier in the file.
static void upsertAttackTarget(const String& mac, int rssi, const char* proto,
                                const String& title, uint8_t ch = 0,
                                const char* category = HACKING_GEAR_CATEGORY);

// BLE popup-spam state: distinct RANDOM MACs blasting Apple Proximity Pairing
// (0x07) / Nearby Action (0x0F) adverts. BLE scan callback only, no lock. A
// room of real AirPods (public/static addresses) must never trip this -- only
// rapidly-rotating random MACs do, which is why the gate is `!pubAddr`.
static BleSpamState bleSpamState;

// Tag-flood state, one per tracker type. BLE scan callback only, no lock.
static TagFloodState tagFloodState[TAGFLOOD_TYPES];
static const char* const TAGFLOOD_NAMES[TAGFLOOD_TYPES] = { "Apple Find My", "Google Find My", "Samsung SmartTag", "Tile" };
static int tagFloodType(SWEEP_ADV* dev) {
    if (bleIsAirtag(dev)) return 0;
    String n = bleTrackerNetwork(dev);
    if (n.startsWith("Google")) return 1;
    if (n.startsWith("Samsung")) return 2;
    if (n.startsWith("Tile")) return 3;
    return -1;
}

/**
 * @brief NimBLE Scan Callbacks for Watcher's Watch
 */
#if CONFIG_IDF_TARGET_ESP32C5
class WatchersScanCallbacks : public NimBLEScanCallbacks {
    void onResult(const NimBLEAdvertisedDevice* advertisedDevice) override {
#else
class WatchersScanCallbacks : public NimBLEAdvertisedDeviceCallbacks {
    void onResult(NimBLEAdvertisedDevice* advertisedDevice) override {
#endif
        if (!watchersRunning) return;

        if (watchersMutex == NULL) return;

        String mac = String(advertisedDevice->getAddress().toString().c_str());
        mac.toUpperCase();
        int rssi = advertisedDevice->getRSSI();
        uint32_t now = millis();
        String devName = advertisedDevice->haveName() ? String(advertisedDevice->getName().c_str()) : "";
        bool pubAddr = advertisedDevice->getAddress().getType() == BLE_ADDR_PUBLIC;
        int32_t company = bleCompanyId(advertisedDevice);
        // ponytail: advertised UUIDs only; a tag that hides 0x1802 in GATT gets no Ring button.
        bool ringable = advertisedDevice->isAdvertisingService(NimBLEUUID((uint16_t)0x1802)) ||
                        advertisedDevice->isAdvertisingService(NimBLEUUID((uint16_t)0x1803));

        // BLE popup spam (Flipper "BLE spam" and friends): floods of Apple
        // Proximity-Pairing / Nearby-Action adverts from rotating random MACs
        // that make nearby iPhones throw pairing popups. Count DISTINCT random
        // MACs sending 0x07/0x0F in the window; public/static Apple gear is
        // real traffic and excluded by !pubAddr. Attack toggle only. Keys on
        // a hash of the MAC STRING (not raw address bytes) -- the distinct-set
        // only needs a stable per-MAC key, same technique karma uses for
        // SSIDs, and it sidesteps any NimBLE 1.4-vs-2.x address-byte-order
        // difference between the S3 and C5 cores. No mutex here (matches
        // deauth/karma); upsertAttackTarget takes watchersMutex itself.
        if (attackDetect && !pubAddr && advertisedDevice->haveManufacturerData()) {
            std::string mfgd = advertisedDevice->getManufacturerData();
            if (mfgd.length() >= 3 &&
                (uint8_t)mfgd[0] == 0x4C && (uint8_t)mfgd[1] == 0x00 &&
                ((uint8_t)mfgd[2] == 0x07 || (uint8_t)mfgd[2] == 0x0F)) {
                uint64_t key = attackHash((const uint8_t*)mac.c_str(), mac.length());
                uint32_t nMacs = bleSpamNote(&bleSpamState, key, rssi, now);
                if (nMacs >= ATTACK_BLESPAM_THRESHOLD) {
                    char title[40];
                    snprintf(title, sizeof(title), "%s \xC2\xB7 %u MACs",
                             ATTACK_TITLE_BLESPAM, (unsigned)nMacs);
                    upsertAttackTarget(String(ATTACK_TITLE_BLESPAM), rssi, "BLE", String(title), 0);
                }
            }
        }

        // Tag flood (always on): a spammer's fake trackers each live for an
        // advert or two, and one Tracker row names the flood. It no longer
        // mutes trackers (2026-10-14): driving past real AirTags trips it too,
        // and a muted real tracker is worse than a noisy fake one.
        int ft = tagFloodType(advertisedDevice);
        if (ft >= 0) {
            TagFloodState* fs = &tagFloodState[ft];
            tagFloodNote(fs, attackHash((const uint8_t*)mac.c_str(), mac.length()), rssi, now);
            if (tagFloodActive(fs, now)) {
                char title[80];
                snprintf(title, sizeof(title), "%s \xC2\xB7 %s \xC2\xB7 %u fake",
                         TAGFLOOD_TITLE, TAGFLOOD_NAMES[ft], (unsigned)fs->total);
                upsertAttackTarget(String(TAGFLOOD_TITLE ": ") + TAGFLOOD_NAMES[ft], rssi, "BLE", String(title), 0, "Tracker");
            }
        }

        // Hunting: every advert from the target refreshes the click rate. Done
        // before the mutex so a busy detector never delays the feedback you are
        // physically walking on.
        if (huntMac.length() > 0 && huntMac.equalsIgnoreCase(mac)) {
            updateGeigerRssi(rssi);
            huntLastRssi = rssi;
            huntLastRssiMs = now;
        }

        if (xSemaphoreTake(watchersMutex, pdMS_TO_TICKS(100)) == pdTRUE) {
            // Accumulate confidence across every rule this device matches, so
            // corroborating signals (e.g. OUI + service UUID) add up. Keep the
            // rule/category from the single strongest match for display.
            int confidence = 0;
            int bestWeight = 0;
            String matchedRule = "";
            String matchedCategory = "";

            for (const auto& sig : loadedSignatures) {
                String r = "", c = "";
                int w = matchDeviceAgainstRule(advertisedDevice, sig, r, c);
                if (w > 0) {
                    confidence += w;
                    if (w > bestWeight) {
                        bestWeight = w;
                        matchedRule = r;
                        matchedCategory = c;
                    }
                }
            }

            // Protocol detectors (not signature rules): presence alone is a
            // strong, unambiguous match, so they set the category directly.
            String trackerNet = bleTrackerNetwork(advertisedDevice);
            bool droneDecoded = false;
            AxonSignalKind axonSig = AXON_SIG_NONE;
            if (bleDecodeRemoteId(advertisedDevice, bleUas)) {
                droneDecoded = odidUseful(bleUas);
                confidence += W_DRONE;
                if (W_DRONE > bestWeight) {
                    bestWeight = W_DRONE;
                    matchedRule = "Remote ID Drone";
                    matchedCategory = "Drone";
                }
            } else if (bleIsAirtag(advertisedDevice)) {
                confidence += W_TRACKER;
                if (W_TRACKER > bestWeight) {
                    bestWeight = W_TRACKER;
                    matchedRule = "Apple Find My Tracker";
                    matchedCategory = "Tracker";
                }
            } else if (trackerNet.length() > 0) {
                confidence += W_TRACKER;
                if (W_TRACKER > bestWeight) {
                    bestWeight = W_TRACKER;
                    matchedRule = trackerNet;
                    matchedCategory = "Tracker";
                }
            } else if (blePenguin(advertisedDevice)) {
                confidence += W_PENGUIN;
                if (W_PENGUIN > bestWeight) {
                    bestWeight = W_PENGUIN;
                    matchedRule = "Flock Battery (Penguin)";
                    matchedCategory = "Flock Safety";
                }
            } else if (bleAxonBwc(advertisedDevice)) {
                confidence += W_AXON_BWC;
                if (W_AXON_BWC > bestWeight) {
                    bestWeight = W_AXON_BWC;
                    matchedRule = "Axon body cam (BWCDEVICE)";
                    matchedCategory = "Axon";
                }
            } else if ((axonSig = bleAxonSignal(advertisedDevice)) == AXON_SIG_SERIAL) {
                confidence += W_AXON_SIGNAL;
                if (W_AXON_SIGNAL > bestWeight) {
                    bestWeight = W_AXON_SIGNAL;
                    matchedRule = "Axon Signal trigger (fe6c serial)";
                    matchedCategory = "Axon";
                }
            } else if (axonSig == AXON_SIG_CADABRA && attackDetect) {
                confidence += W_AXONCADABRA;
                if (W_AXONCADABRA > bestWeight) {
                    bestWeight = W_AXONCADABRA;
                    matchedRule = "AxonCadabra (replayed Axon Signal)";
                    matchedCategory = HACKING_GEAR_CATEGORY;
                }
            } else if (bleFlockFsName(advertisedDevice)) {
                confidence += W_FLOCK_FS;
                if (W_FLOCK_FS > bestWeight) {
                    bestWeight = W_FLOCK_FS;
                    matchedRule = "Flock accessory name (FS-)";
                    matchedCategory = "Flock Safety";
                }
            } else if (matchedRule.length() == 0) {
                // Label only. No confidence, no category, so it cannot beep, is
                // not listed while the filter is on, and counts under Everything
                // alone. A real signature rule always wins the name.
                String role = appleRole(advertisedDevice);
                if (role.length() > 0) matchedRule = role;
            }

            if (confidence > 100) confidence = 100;

            // The confidence score is an annotation, not a gate: the phone
            // classifies on geospatial persistence (a radio pinned to one place
            // across repeat visits is infrastructure), which only works if it
            // sees everything the radio hears — including vendors not on any
            // list. CONF_LIST_MIN now only decides whether the buzzer fires.
            {
                bool found = false;
                for (auto& target : trackedTargets) {
                    if (target.mac.equalsIgnoreCase(mac)) {
                        target.rssi = rssi;
                        target.lastSeenMs = now;
                        target.count++;
                        // Corroboration: this MAC was previously seen over WiFi.
                        int merged = confidence;
                        if (target.protocol == "WiFi" || target.protocol == "BLE+WiFi") {
                            merged = confidence + W_CORROBORATION;
                            target.protocol = "BLE+WiFi";
                        } else {
                            target.protocol = "BLE";
                        }
                        if (merged > 100) merged = 100;
                        if (merged > target.confidence) target.confidence = merged;
                        target.tier = tierForConfidence(target.confidence);
                        if (devName.length() > 0) target.name = devName;
                        target.blePublic = pubAddr;
                        // A scan response often has no manufacturer data; don't
                        // let it erase the company the advert already gave.
                        if (company >= 0) target.bleCompany = company;
                        if (ringable) target.bleRing = true;
                        // Don't let a later non-matching advert wipe a category
                        // an earlier rule match established.
                        if (matchedCategory.length() > 0) {
                            target.type = matchedCategory;
                            target.matchedRule = matchedRule;
                        }
                        if (droneDecoded) applyDroneData(target, bleUas);
                        noteAlertForTarget(target, bestWeight, matchedCategory);
                        found = true;
                        break;
                    }
                }

                if (!found) {
                    WatcherTargetInfo newTarget;
                    newTarget.mac = mac;
                    newTarget.name = devName;
                    newTarget.type = matchedCategory;
                    newTarget.matchedRule = matchedRule;
                    newTarget.rssi = rssi;
                    newTarget.firstSeenMs = now;
                    newTarget.lastSeenMs = now;
                    newTarget.count = 1;
                    newTarget.protocol = "BLE";
                    newTarget.blePublic = pubAddr;
                    newTarget.bleCompany = company;
                    newTarget.bleRing = ringable;
                    newTarget.confidence = confidence;
                    newTarget.tier = tierForConfidence(confidence);
                    newTarget.lastReportedMs = 0;
                    if (droneDecoded) applyDroneData(newTarget, bleUas);
                    makeRoomLocked();
                    trackedTargets.push_back(newTarget);

                    // Log only on a signature hit; everything else is tracked
                    // silently. The buzzer decision is noteAlertForTarget's,
                    // and it tests the strongest single signal, not the sum.
                    if (confidence >= CONF_LIST_MIN) {
                        ESP_LOGI(TAG, "[SURVEILLANCE] MAC: %s, Rule: %s, Cat: %s, Conf: %d (%s), RSSI: %d",
                                 mac.c_str(), matchedRule.c_str(), matchedCategory.c_str(),
                                 confidence, newTarget.tier.c_str(), rssi);
                    }
                    noteAlertForTarget(trackedTargets.back(), bestWeight, matchedCategory);
                }
            }
            xSemaphoreGive(watchersMutex);
        }
    }
};

static WatchersScanCallbacks watchersScanCallbacks;

/**
 * @brief Periodic Task to push targets JSON once per second over BLE Serial & WebSerial
 */

static TaskHandle_t watchersWifiHopTaskHandle = NULL;

static void watchersWifiChannelHopperTask(void *pvParameters) {
    (void)pvParameters;
#if CONFIG_IDF_TARGET_ESP32C5
    // Dual-band: the measured schedule for the selected band (c5_radio.h),
    // rebuilt whenever the band setting changes.
    uint8_t channels[20];
    size_t chCount = 0;
    uint8_t hopBand = 0xFF;
    // Per detector run, not per boot: a detector restart (e.g. after a Site
    // Survey capture) warns again if 5 GHz is still rejected.
    bool warned5GhzRejected = false;
#else
    // Hop all US 2.4 GHz channels so a Flock node beaconing off 1/6/11 isn't
    // missed. (ESP32-S3 is 2.4 GHz only.)
    const uint8_t channels[] = {1, 2, 3, 4, 5, 6, 7, 8, 9, 10, 11};
#endif
    int chIndex = 0;
    bool extended = false;
    while (watchersRunning) {
#if CONFIG_IDF_TARGET_ESP32C5
        vTaskDelay(pdMS_TO_TICKS(C5_HOP_DWELL_MS));
        if (hopBand != sweepBand) {
            hopBand = sweepBand;
            chCount = c5BuildHop(hopBand, channels, sizeof(channels));
            chIndex = 0;
        }
#else
        vTaskDelay(pdMS_TO_TICKS(150));
#endif
        if (!watchersRunning) break;
        // A drone beacons on one fixed channel, so a channel that just carried
        // Remote ID earns one extra dwell before moving on -- never two in a
        // row, or a drone overhead would park the hopper and blind the rest.
        bool heard = odidHeard;
        odidHeard = false;
        if (heard && !extended && huntMac.length() == 0) { extended = true; continue; }
        extended = false;
        // Parked while hunting a Wi-Fi device. Sweeping thirteen channels means
        // hearing a given access point about one dwell in thirteen, which is
        // fine for finding things and useless for walking one down: the clicker
        // would go quiet every time the hopper moved on. Detection of everything
        // else pauses for the duration, which is the deal you accept when you
        // lock onto one target.
        int parked = huntChannel;
#if CONFIG_IDF_TARGET_ESP32C5
        if (huntMac.length() > 0 && parked >= 1 && parked <= 177) {   // 5 GHz targets park too
            esp_err_t chErr = esp_wifi_set_channel(parked, WIFI_SECOND_CHAN_NONE);
            if (chErr != ESP_OK && parked > 14 && !warned5GhzRejected) {
                warned5GhzRejected = true;
                // ESP_LOGW is compiled out at CORE_DEBUG_LEVEL=0 (see the
                // alert print above), so this is a plain print -- otherwise a
                // rejected 5 GHz channel is silent on a headless board.
                if (Serial) Serial.printf("[C5] esp_wifi_set_channel rejected 5 GHz channel %d: %s -- band mode may not have applied\n",
                          parked, esp_err_to_name(chErr));
            }
        } else {
            uint8_t ch = channels[chIndex];
            esp_err_t chErr = esp_wifi_set_channel(ch, WIFI_SECOND_CHAN_NONE);
            if (chErr != ESP_OK && ch > 14 && !warned5GhzRejected) {
                warned5GhzRejected = true;
                // ESP_LOGW is compiled out at CORE_DEBUG_LEVEL=0 (see the
                // alert print above), so this is a plain print -- otherwise a
                // rejected 5 GHz channel is silent on a headless board.
                if (Serial) Serial.printf("[C5] esp_wifi_set_channel rejected 5 GHz channel %d: %s -- band mode may not have applied\n",
                          ch, esp_err_to_name(chErr));
            }
            chIndex = (chIndex + 1) % (int)chCount;
        }
#else
        if (huntMac.length() > 0 && parked >= 1 && parked <= 14) {
            esp_wifi_set_channel(parked, WIFI_SECOND_CHAN_NONE);
        } else {
            esp_wifi_set_channel(channels[chIndex], WIFI_SECOND_CHAN_NONE);
            chIndex = (chIndex + 1) % (int)(sizeof(channels) / sizeof(channels[0]));
        }
#endif
    }
    watchersWifiHopTaskHandle = NULL;
    vTaskDelete(NULL);
}

// Insert/update a target known only from a Remote ID decode. Used by the Wi-Fi
// NAN action-frame path, which carries no SSID, no vendor IE and no OUI worth
// scoring — the decode itself is the whole identification.
static void upsertDroneTarget(const String& mac, int rssi, const char* proto,
                              const ODID_UAS_Data& d, uint8_t ch = 0) {
    if (watchersMutex == NULL) return;
    if (xSemaphoreTake(watchersMutex, pdMS_TO_TICKS(10)) != pdTRUE) return;
    uint32_t now = millis();
    bool found = false;
    for (auto& t : trackedTargets) {
        if (t.mac.equalsIgnoreCase(mac)) {
            t.rssi = rssi;
            t.lastSeenMs = now;
            t.count++;
            if (W_DRONE > t.confidence) t.confidence = W_DRONE;
            t.tier = tierForConfidence(t.confidence);
            t.type = "Drone";
            t.matchedRule = "Remote ID Drone";
            if (ch > 0) t.wifiCh = ch;
            applyDroneData(t, d);
            noteAlertForTarget(t, W_DRONE, "Drone");
            found = true;
            break;
        }
    }
    if (!found) {
        WatcherTargetInfo t;
        t.mac = mac;
        t.type = "Drone";
        t.matchedRule = "Remote ID Drone";
        t.rssi = rssi;
        t.firstSeenMs = now;
        t.lastSeenMs = now;
        t.count = 1;
        t.protocol = proto;
        t.confidence = W_DRONE;
        t.tier = tierForConfidence(W_DRONE);
        t.lastReportedMs = 0;
        if (ch > 0) t.wifiCh = ch;
        applyDroneData(t, d);
        makeRoomLocked();
        trackedTargets.push_back(t);
        ESP_LOGI(TAG, "[DRONE - %s] MAC: %s, UAS: %s, RSSI: %d",
                 proto, mac.c_str(), t.uasId.c_str(), rssi);
        noteAlertForTarget(trackedTargets.back(), W_DRONE, "Drone");
    }
    xSemaphoreGive(watchersMutex);
}

// Surface a rate-detector hit (deauth/karma/BLE-spam) as an ordinary "Hacking
// gear" row. Same shape as upsertDroneTarget: keyed by mac, takes watchersMutex
// briefly (bail on miss -- never block a radio callback), leaves the once-per-
// appearance beep to noteAlertForTarget. `mac` may be a sentinel string for a
// detector with no single transmitter (BLE popup spam).
static void upsertAttackTarget(const String& mac, int rssi, const char* proto,
                               const String& title, uint8_t ch, const char* category) {
    if (watchersMutex == NULL) return;
    if (xSemaphoreTake(watchersMutex, pdMS_TO_TICKS(10)) != pdTRUE) return;
    uint32_t now = millis();
    bool found = false;
    for (auto& t : trackedTargets) {
        if (t.mac.equalsIgnoreCase(mac)) {
            t.rssi = rssi; t.lastSeenMs = now; t.count++;
            if (W_ATTACK > t.confidence) t.confidence = W_ATTACK;
            t.tier = tierForConfidence(t.confidence);
            t.type = category;
            t.matchedRule = title;
            if (ch > 0) t.wifiCh = ch;
            noteAlertForTarget(t, W_ATTACK, category);
            found = true; break;
        }
    }
    if (!found) {
        WatcherTargetInfo t;
        t.mac = mac; t.type = category; t.matchedRule = title;
        t.rssi = rssi; t.firstSeenMs = now; t.lastSeenMs = now; t.count = 1;
        t.protocol = proto; t.confidence = W_ATTACK; t.tier = tierForConfidence(W_ATTACK);
        t.lastReportedMs = 0; if (ch > 0) t.wifiCh = ch;
        makeRoomLocked();
        trackedTargets.push_back(t);
        noteAlertForTarget(trackedTargets.back(), W_ATTACK, category);
    }
    xSemaphoreGive(watchersMutex);
}

// Deauth-burst state: touched ONLY from the single-threaded Wi-Fi promiscuous
// callback, so it needs no lock (same rule as wifiUas/pwngridBuf).
static DeauthState deauthState;

// Karma/PineAP state: one BSSID answering probes for many SSIDs. Promiscuous
// callback only, no lock.
static KarmaState karmaState;
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
