B0z0dcl0wn/SignalSweep/firmware/src/mode_watchers_watch.h

// SPDX-License-Identifier: GPL-3.0-or-later
// Copyright (C) 2026 B0z0dcl0wn and the SignalSweep contributors

#ifndef MODE_WATCHERS_WATCH_H
#define MODE_WATCHERS_WATCH_H

#include <Arduino.h>
#include <vector>
#include <ArduinoJson.h>

/**
 * @brief Information about a signature rule for surveillance device detection
 */
struct WatcherSignature {
    String name;
    String category;
    String oui;
    String mfgId;
    String deviceName;
    String serviceUuid;
    // Optional. 0 = use the per-condition weights (W_OUI, W_UUID...). Set on
    // rules whose OUI the IEEE registers to the product's own maker, so they
    // list (60) without beeping on the OUI alone.
    int weight = 0;
    // Optional. Case-sensitive SSID prefix, matched on beacons and probe
    // responses only. A rule with one is Wi-Fi-only.
    String ssidPrefix;
};

/**
 * @brief Information about a detected surveillance target
 */
struct WatcherTargetInfo {
    String mac;
    String name;
    String type;
    String matchedRule;
    String protocol;
    // The network name a Wi-Fi device is announcing. Far more identifying to a
    // human than a MAC -- "Nest_ABC" tells you what a row is at a glance, where
    // a vendor prefix does not. Beacons and probe responses only: a probe
    // REQUEST carries the network the client is looking for, not its own.
    String ssid;
    int rssi;
    uint32_t firstSeenMs;
    uint32_t lastSeenMs;
    uint32_t count;
    int confidence;   // 0-100, accumulated across matching signals
    String tier;      // "Confirmed" | "Likely" | "Possible"
    uint32_t lastReportedMs;  // round-robin cursor: oldest reported goes first
    // Has this device already sounded the buzzer since it appeared? The alert
    // belongs to the device, not to the moment it was first heard -- see the
    // comment on noteAlertForTarget() in the .cpp.
    bool alerted = false;
    // Set alongside `alerted` when an alert really sounded, cleared by the 1 Hz
    // task once the record is on flash. The target IS the log queue: it already
    // holds the mac, category, rule and rssi a record needs, it is bounded so
    // nothing can overflow, and it means no second ring and no lock shared
    // between the two radio callbacks. A LittleFS write must never happen on
    // those callbacks -- see the drain in watchersPeriodicTask().
    bool logPending = false;

    // Who made it, and which side of a Wi-Fi link it is. The app turns these
    // into a vendor name and an AP/client badge; the lookups live on the phone.
    // wifiRole: 0 unknown, 1 client (probe request), 2 AP (beacon / probe
    // response). AP is sticky -- a device that beacons is infrastructure even
    // if it also probes. bleCompany is the manufacturer-data company ID, -1
    // when none has been heard (0x0000 is a real company).
    uint8_t wifiRole   = 0;
    bool    blePublic  = false;
    int32_t bleCompany = -1;
    // Advertises Immediate Alert (0x1802) or Link Loss (0x1803): the Find Me /
    // Proximity keyfobs Ring can actually reach. Sticky, like AP.
    bool    bleRing    = false;

    // Last Wi-Fi channel this target was heard on, 0 = unknown / BLE only. The
    // app turns it into a 2.4G / 5G badge; last heard wins.
    uint8_t wifiCh     = 0;

    // Decoded ASTM F3411 Remote ID, populated only for drones (hasDrone).
    // Everything else leaves this zeroed and it never reaches the wire — the
    // 1 Hz push is the tightest budget on the board, so these fields are
    // emitted per-target only when hasDrone is set.
    // Defaults matter: the struct is filled field-by-field at both call sites
    // and has no constructor, so anything not assigned there would otherwise be
    // stack garbage — and garbage in hasDrone puts junk coordinates on the wire.
    bool   hasDrone = false;
    String uasId;                    // Basic ID / serial
    uint8_t uasIdType = 0;           // ODID_idtype_t of uasId, 0 == none yet
    String operatorId;               // Operator ID (registration)
    String selfId;                   // free-text description the operator chose
    double droneLat = 0, droneLng = 0;  // 0/0 == no value (ODID's own "unknown")
    float  altMsl    = -1000;        // m WGS84-HAE, -1000 == unknown
    float  heightAgl = -1000;        // m above heightRef, -1000 == unknown
    int8_t heightRef = -1;           // ODID_Height_reference_t: 0 take-off, 1 ground, -1 unknown
    float  speed     = 0;            // m/s horizontal
    float  vSpeed    = 63;           // m/s vertical, 63 == unknown (ODID's own)
    float  heading   = 361;          // degrees true, 361 == unknown
    uint8_t uaType   = 0;            // ODID_uatype_t, 0 == none declared
    uint8_t ridStatus = 0;           // ODID_status_t, 0 == undeclared
    double opLat = 0, opLng = 0;     // pilot/operator position, 0/0 == no value
    int8_t opLocType = -1;           // ODID_operator_location_type_t, -1 unknown
    uint8_t euCat = 0, euClass = 0;  // ODID EU category/class, 0 == undeclared
};

/**
 * @brief Start Watcher's Watch mode (loads signatures, starts continuous BLE scan & target tracking)
 */
void startWatchersWatch();

/**
 * @brief Stop Watcher's Watch mode cleanly (stops BLE scan)
 */
void stopWatchersWatch();

/**
 * @brief Check if Watcher's Watch mode is currently active
 * @return true if running, false otherwise
 */
bool isWatchersWatchActive();

/**
 * @brief Get JSON representation of all tracked surveillance targets
 * @return JSON string sent to the app over BLE NUS via sendBleSerial()
 */
String getWatchersTargetsJson();

/**
 * @brief Get JSON representation of all signature rules from LittleFS
 * @return JSON string sent to the app over BLE NUS via sendBleSerial()
 */
String getWatchersSignaturesJson();

/**
 * @brief Update signature database in LittleFS and reload rules in memory
 * @param jsonContent New signature JSON string or object
 * @return true if updated and reloaded successfully, false otherwise
 */
/**
 * @brief Reset the signature rules to the built-in defaults
 */
void resetWatchersSignaturesToDefaults();

bool updateWatchersSignaturesJson(const String& jsonContent);

/**
 * @brief Load signature rules from LittleFS (/data/signatures.json)
 */
void loadWatchersSignatures();

/**
 * @brief Hunt a MAC: its RSSI drives the Geiger clicker so a planted tracker
 * can be walked down by ear. Empty string clears. Detection never stops.
 */
void setHuntTarget(const String& mac);

/**
 * @brief The MAC currently being hunted, or "" if none.
 */
String getHuntTarget();

/**
 * @brief Report every tracked device rather than only signature matches, for
 * foxhunting an unlisted device. Persisted. Does NOT affect the buzzer —
 * CONF_ALERT_MIN still gates every alert.
 */
void setScanAll(bool enabled);

/**
 * @brief Reload the hunt target and report filter from NVS. Called by
 * startWatchersWatch() so the board resumes exactly what it was doing before
 * it lost power.
 */
void restoreWatchersState();

/** @brief True while the report filter is off. */
bool getScanAll();
void setAttackDetect(bool enabled);
bool getAttackDetect();

// Per-category buzzer mute. One bit per AlertCategory (hardware_manager.h), so
// bit 0 = ALERT_ALPR ... bit 4 = ALERT_GENERIC. The app mirrors this bit order
// in BEEP_BITS (app/public/app.js) — keep the two in step.
#define BEEP_MASK_ALL 0x1F
// Fresh board: everything but trackers (bit 3). In a crowd every passing AirTag
// beeps, so trackers are an opt-in, like hacking gear. Still detected and listed.
#define BEEP_MASK_DEFAULT 0x17

/**
 * @brief Choose which device categories are allowed to sound the buzzer.
 * Persisted, like the hunt target: the board is headless and loses power every
 * time the engine stops. A muted category is fully silent (no beep, no flash,
 * not counted by getAlertCount()) but is still tracked and still reported.
 */
void setBeepMask(uint8_t mask);

/** @brief Categories currently allowed to beep (bitmask, see BEEP_MASK_ALL). */
uint8_t getBeepMask();

/**
 * @brief Record every alert the buzzer sounds to the board's own flash.
 * On by default and persisted (sweep-st/log), like every other operator
 * setting: a detector wired into a car must keep logging across the engine
 * stopping, or the feature only works while tethered to the phone you were
 * trying to walk away from. Follows the buzzer exactly — a muted beep_mask
 * category and an active hunt both write nothing, so the log is a faithful
 * record of what you actually heard. See alert_log.h.
 */
void setAlertLogEnabled(bool enabled);

/** @brief True while alerts are being written to flash. */
bool getAlertLogEnabled();

/**
 * @brief Wi-Fi channel the hunted target was last heard on, or 0 if unknown.
 * The channel hopper parks here while hunting -- see the comment in
 * watchersWifiChannelHopperTask().
 */
int getHuntChannel();

/**
 * @brief How many times the buzzer has sounded a category alert since boot.
 * The headless path has no other witness: with no phone attached the only
 * evidence is a noise in another room, and a serial print made seconds after
 * boot is lost while the USB CDC port re-enumerates.
 */
uint32_t getAlertCount();

/**
 * @brief Queue a "ring the tracker" for this MAC. Performed on the 1 Hz task,
 * not on the caller's stack. MAC is the only parameter by design — see
 * performRing().
 */
void requestRing(const String& mac);

#if CONFIG_IDF_TARGET_ESP32C5
/** @brief C5 only: Wi-Fi band the hopper covers (0 both, 1 2.4 GHz, 2 5 GHz). */
uint8_t getBand();
/** @brief C5 only: set and persist the band (sweep-st/band); out of range means both. */
void setBand(uint8_t band);
#endif

// Per-device Ignore: your own doorbell, dashcam or tag. Still detected, listed
// and reported; never beeps, flashes, counts or logs. Persisted (sweep-st/ignore).
#define IGNORE_MAX 16
// 0 added, 1 already there, -1 full (list at IGNORE_MAX), -2 not a MAC,
// -3 couldn't lock (mutex busy or not yet created -- distinct from -1 so a
// momentarily busy detector doesn't toast "list full").
int  addIgnore(const String& mac);
bool removeIgnore(const String& mac);
// Adds an "ignore" JsonArray to doc, but ONLY if the lock was obtained; on a
// timeout the key is left absent rather than emitting an authoritative empty
// list (an absent CMD:CFG field means "unknown", not "no ignored devices").
// [["AA:BB:..", <AlertCategory>], ...]. Returns false on timeout.
bool getIgnoreJson(JsonDocument& doc);

#endif // MODE_WATCHERS_WATCH_H
