B0z0dcl0wn/SignalSweep/firmware/src/sd_store.h

// SPDX-License-Identifier: GPL-3.0-or-later
// Copyright (C) 2026 B0z0dcl0wn and the SignalSweep contributors

#ifndef SD_STORE_H
#define SD_STORE_H

#include <Arduino.h>

// Optional microSD card (bare 3.3 V reader on SPI: CS D3, SCK D8, MISO D9,
// MOSI D10). Probed like every other accessory: absent means SD_NONE and
// nothing else changes. Everything lives in /SIGSWEEP/ under 8.3 upper-case
// names -- a long name silently failed on the first card we tried.
//
// Threading: every call takes one recursive mutex, so the capture drain task,
// the detector's 1 Hz task and loop() can share the card. NEVER call from the
// NimBLE host task (processIncomingCommand) or a radio callback: card I/O is
// tens of ms and the host task's stack is small. Exceptions: sdState() and
// sdFreeMB() are deliberately lock-free -- they read single aligned words, and
// CMD:CFG reads them on the NimBLE host task, where waiting behind a slow card
// write must never happen. Do not add a lock to either.
//
// A failed write marks the card SD_ERROR (or SD_FULL), unmounts it, and every
// later call returns false until sdProbe() succeeds again. No retry loop, no
// formatting, no deleting on its own.

enum SdState : uint8_t { SD_NONE = 0, SD_OK = 1, SD_ERROR = 2, SD_FULL = 3 };

/** @brief (Re)mount the card and create /SIGSWEEP. True if usable. */
bool sdProbe();
uint8_t sdState();
/** @brief Free space in MB, cached at the last probe or write failure. */
uint32_t sdFreeMB();

/** @brief 8.3 upper-case A-Z0-9 only, e.g. "LOG00031.CSV". No paths. */
bool sdValidName(const char* name);

/** @brief Open for append, write, close. The line is on the card when this returns true. */
bool sdAppend(const char* name, const uint8_t* data, size_t len);
bool sdExists(const char* name);

struct SdEntry { char name[13]; uint32_t size; };
/**
 * @brief Regular files in /SIGSWEEP with valid names, up to max.
 *
 * A card can hold far more log/capture rotations than any one listing should
 * carry over BLE, so this keeps the newest 64 LOG*.CSV and newest 64
 * CAP*.SSC entries (by name -- the numbers are zero-padded, so string order
 * is numeric order) rather than truncating in on-disk FAT order, which used
 * to silently hide exactly the files you'd want to read back. Any other
 * valid name fills whatever room is left. `totalOut`, if non-NULL, receives
 * the true count of valid files on the card, so a caller can tell "the
 * listing is capped" from "that's everything".
 */
size_t sdList(SdEntry* out, size_t max, size_t* totalOut);

/** @brief Read up to n bytes at off. Returns bytes read (0 at EOF), -1 if missing/invalid. */
int32_t sdRead(const char* name, uint32_t off, uint8_t* buf, size_t n, uint32_t* sizeOut);
bool sdRemove(const char* name);
/** @brief True if `name` is the capture stream being written right now. */
bool sdIsOpen(const char* name);

/** @brief One past the highest <pre>nnnnn.<ext> on the card (CAP/SSC, LOG/CSV). */
bool sdNextName(const char* pre, const char* ext, char out[13]);

/** @brief One long-lived write stream (captures). Only one open at a time. */
bool sdStreamOpen(const char* name);
bool sdStreamWrite(const uint8_t* data, size_t len);
/**
 * @brief Commit the stream's size to the directory entry. FatFs only writes
 * that on sync/close, so without this a power cut or a pulled card leaves a
 * 0-byte capture however much was written. Call about once a second.
 */
bool sdStreamSync();
void sdStreamClose();

#endif // SD_STORE_H
