B0z0dcl0wn/SignalSweep/test_distribution.py

#!/usr/bin/env python3
# SPDX-License-Identifier: GPL-3.0-or-later
"""Distribution contract: the flasher manifest, partitions.csv, install.py and
the flasher page must agree. A wrong offset here bricks a board until it is
reflashed, and nothing else would notice before a user does.

  python test_distribution.py
"""
import csv
import json
import re
from pathlib import Path

import install

ROOT = Path(__file__).resolve().parent
MANIFEST = json.loads((ROOT / "site/manifest.json").read_text())
CHIP_FAMILY = {"s3": "ESP32-S3", "c5": "ESP32-C5"}
BOOTLOADER = {"s3": 0x0, "c5": 0x2000}


def partition_offset(name):
    for row in csv.reader((ROOT / "firmware/partitions.csv").read_text().splitlines()):
        if row and not row[0].startswith("#") and row[0].strip() == name:
            return int(row[3].strip(), 16)
    raise AssertionError(f"partitions.csv has no {name} row")


def test_coredump_partition():
    """Both frameworks build with CONFIG_ESP_COREDUMP_ENABLE_TO_FLASH; without this
    row every panic's dump is thrown away. LittleFS must not move, or the
    update reformats it and wipes the signatures and the alert log."""
    rows = {r[0].strip(): r for r in csv.reader((ROOT / "firmware/partitions.csv").read_text().splitlines())
            if r and not r[0].startswith("#")}
    assert "coredump" in rows, "no coredump partition"
    assert int(rows["coredump"][3], 16) == 0x600000 and int(rows["coredump"][4], 16) >= 0x10000
    assert int(rows["spiffs"][3], 16) == 0x610000 and int(rows["spiffs"][4], 16) == 0x1F0000
    assert int(rows["app0"][3], 16) + int(rows["app0"][4], 16) <= 0x600000


def main():
    builds = {b["chipFamily"]: b for b in MANIFEST["builds"]}
    assert set(install.BOARDS) == {"s3", "c5"}, sorted(install.BOARDS)
    for board, fam in CHIP_FAMILY.items():
        assert fam in builds, f"manifest has no {fam} build"
        manifest_parts = [(Path(p["path"]).name, p["offset"]) for p in builds[fam]["parts"]]
        assert manifest_parts == install.BOARDS[board]["parts"], \
            f"{board}: manifest {manifest_parts} != install.py {install.BOARDS[board]['parts']}"
        offsets = dict((n.removeprefix("c5-"), o) for n, o in manifest_parts)
        assert offsets["bootloader.bin"] == BOOTLOADER[board], f"{board} bootloader at {offsets['bootloader.bin']:#x}"
        assert offsets["partitions.bin"] == 0x8000
        assert offsets["boot_app0.bin"] == partition_offset("otadata"), f"{board} boot_app0"
        assert offsets["signalsweep.bin"] == partition_offset("app0"), f"{board} app"
        prefix = "" if board == "s3" else "c5-"
        assert all(n.startswith(prefix) for n, _ in manifest_parts), f"{board} asset names"
        if board == "s3":
            assert not any(n.startswith("c5-") for n, _ in manifest_parts), \
                "s3 asset names must not carry the c5- prefix"

    html = (ROOT / "site/index.html").read_text(encoding="utf-8")
    assert re.search(r"esp-web-tools@\d+\.\d+\.\d+/", html), "flasher script is not pinned to an exact version"

    # The data-pull page promises it cannot phone home; the browser enforces
    # that only while this policy is in place and nothing loads from elsewhere.
    pull = (ROOT / "site/pull.html").read_text(encoding="utf-8")
    assert "connect-src 'none'" in pull and "default-src 'none'" in pull, "pull.html lost its no-network CSP"
    assert not re.search(r"<script[^>]+src=|<link[^>]+href=\"?https?:", pull), "pull.html must load nothing external"
    assert "pull.html" in html, "flasher page no longer links the data pull"
    # One report.html, whichever tool made it: the page carries pull.py's template verbatim.
    tpl = re.search(r"const REPORT_HTML = `(.*?)`;", pull, re.S)
    py = re.search(r'REPORT_HTML = r"""(.*?)"""', (ROOT / "pull.py").read_text(encoding="utf-8"), re.S)
    assert tpl and py and tpl.group(1).replace("<\\/", "</") == py.group(1), \
        "pull.html's REPORT_HTML drifted from pull.py's (re-embed it)"
    assert "default-src 'none'" in py.group(1), "report.html lost its no-network CSP"
    assert "pull.html" in (ROOT / "site/assemble.sh").read_text() and "pull.py" in (ROOT / "site/assemble.sh").read_text()

    # One set of brand colours. The app and the flasher link signalsweep.css; pull.html
    # and report.html load nothing, so they inline it verbatim, and no copy may drift.
    def norm(t):
        return t.replace("\r\n", "\n").strip()
    tokens = norm((ROOT / "site/signalsweep.css").read_text(encoding="utf-8"))
    assert norm((ROOT / "app/public/signalsweep.css").read_text(encoding="utf-8")) == tokens, \
        "app/public/signalsweep.css and site/signalsweep.css differ"
    assert tokens in norm(pull) and tokens in norm(py.group(1)), \
        "pull.html / report.html no longer inline signalsweep.css verbatim"
    assemble = (ROOT / "site/assemble.sh").read_text()
    assert "site/signalsweep.css" in assemble and "site/favicon-32.png" in assemble, "assemble.sh dropped a brand file"
    # No raw hex colours in the app outside the token file. The LED theme swatches
    # (the bar's own colours) and the easter egg's phosphor terminal are deliberate.
    app_src = (ROOT / "app/index.html").read_text(encoding="utf-8") + (ROOT / "app/public/app.js").read_text(encoding="utf-8")
    app_src = re.sub(r"\.sw-[a-z]+ *\{[^}]*\}|\.egg-term[^{]*\{[^}]*\}|&#\d+;|href=\"#[^\"]*\"", "", app_src)
    stray = sorted(set(re.findall(r"(?<![\w&])#(?:[0-9a-fA-F]{6}|[0-9a-fA-F]{3})(?![\w-])", app_src)))
    assert not stray, f"raw hex colours in the app (use a --ss-* token): {stray}"

    parse = install.board_from_chip_output
    assert parse("Chip type:          ESP32-C5 (QFN32) (revision v1.0)") == "c5"   # esptool 5
    assert parse("Chip is ESP32-S3 (QFN56) (revision v0.2)") == "s3"              # esptool 4
    assert parse("Chip type:          ESP32-C5HR8 (revision v1.0)") == "c5"     # issue #1
    assert parse("Chip type:          ESP32-S31 (QFN56)") is None
    assert parse("Chip type:          ESP32-C3 (QFN32)") is None
    assert parse("A fatal error occurred: Failed to connect") is None

    test_coredump_partition()
    print("PASS")


if __name__ == "__main__":
    main()
