B0z0dcl0wn/SignalSweep/(commit log)

2026-08-30 Initial commit: SignalSweep baseline before cleanup refactor
    Snapshot of the project as-is prior to the planned cleanup (dead-file
    deletion, doc fixes, firmware parser trim, and splitting the ~1000-line
    inline script in app/index.html into modules). Committed so every phase
    of that work is independently revertible.
    Includes ESP32-S3 firmware (PlatformIO/NimBLE), the Capacitor web/Android
    control app, and the design notes/GEMINI.md docs. Build artifacts (node_modules,
    .pio, android build outputs, APKs, logs) excluded via .gitignore.
    Claude-Session: https://claude.ai/code/session_012PNbKpqBTjufzhXfpE38op
    [partitions.csv]
2026-08-30 Phase 2: fix documentation fictions
    - Firmware headers: the getXxxTargetsJson() doc comments claimed the JSON
    is served over "GET /api/..." REST endpoints. No HTTP server exists;
    the JSON is pushed to the app over BLE NUS. Reworded to say so
    (comment-only, no code change).
    - GEMINI.md: described the app as React + functional components/Hooks.
    It's a single plain-HTML/JS index.html. Corrected the overview and
    agent guidance.
    - the design notes: dropped the now-stale note warning that GEMINI.md was wrong.
    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
    [mode_watchers_watch.h]
2026-08-30 Phase 3: trim firmware command parser
    processIncomingCommand() in ble_serial.cpp:
    - Remove the "lock_mac" and "target" target-lock aliases. The app only
    ever sends {"lock": "..."} (and legacy {"mac": ...}); those two keys
    had no client. Kept "lock" and "mac".
    - Remove the JSON string-mode branch ({"mode": "1"}); it duplicated the
    int branch, and manual serial typing still hits the raw-text fallback.
    - Add a ponytail note documenting that the "mac" key doubles as the
    ble_write target, so a ble_write spuriously re-locks — flagged as a
    separate correctness fix, intentionally out of scope for this cleanup.
    No behavior change for any command the app sends. Not compile-verified
    here (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
    [ble_serial.cpp]
2026-08-30 Phase 4: extract inline dashboard script from index.html
    Moved the ~1000-line inline <script> out of app/index.html into
    app/public/app.js, referenced via <script defer src="/app.js">. Vite
    copies public/ to the dist root verbatim; the defer + document order
    (after the main.js module) preserves the original load timing, so
    window.L / window.Capacitor / window.BleClient are set before app.js runs.
    Kept it as one verbatim classic script rather than the 3-module split
    from the plan: reading the code showed the functions share one mutable
    scope (currentActiveMode, connectionType, map, gattProfileCache,
    detectedDevices, ...) and call across would-be module boundaries.
    Splitting would mean untang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
2026-08-30 Fix ble_write spuriously re-locking the target
    In processIncomingCommand(), the section-2 target-lock check fired
    whenever a "mac" key was present. But "mac" also carries the target for
    {"action":"ble_write", "mac":..., ...}, so every ble_write command also
    called setBanditLockTarget() on that MAC as a side effect.
    Gate the mac-as-lock branch on there being no "action" key. Bare
    {"mac":...} and {"lock":...} still lock; a ble_write (or ble_spoof) no
    longer does. Verified with `pio run` (SUCCESS).
    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
    [ble_serial.cpp]
2026-08-30 Fix bare-digit mode commands ("0".."3") being ignored
    Found while testing on hardware: sending a bare "0"/"1"/"2"/"3" over
    serial/BLE did nothing, while {"mode":N} worked. Cause: a bare digit is
    valid JSON (a number), so deserializeJson() succeeds and control enters
    the !error branch, where doc["mode"] is null (the root is a number, not
    an object) -- so no mode change fired. The raw-text digit fallback that
    was meant to handle this was unreachable dead code.
    Handle a bare-int JSON root in section 1 (doc.is<int>()), and drop the
    dead raw-digit branch. Pre-existing bug, not from the earlier parser
    trim. Verified on device: bare 0/1/2/3, {"mode":N}, and "mode 1" all
    switch correctly.
    Co-Autho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
    [ble_serial.cpp]
2026-08-30 Tiered build system: one codebase, one env per hardware tier
    Restructure the firmware around the 3-tier hardware roadmap without forking
    the code:
    - platformio.ini: [common] base + [env:tier1|tier2|tier3]. tier1 ships today
    (cheap XIAO ESP32-S3 + external U.FL antenna, phone UI). tier2/tier3 add
    HAS_SECOND_RADIO/HAS_SCREEN/HAS_BATTERY, then HAS_GPS/HAS_BUTTONS. TinyGPSPlus
    (previously an unused dep in every build) now links only under tier3.
    - capabilities.h: central HAS_* seam + getCapabilities()/getTier(); compile-time
    flags decide what links, runtime probes (added as hardware lands) decide what's
    present.
    - mode_manager.cpp: persist compiled tier to NVS (ouispy-hw/tier) and emit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
2026-08-30 Cut ble_spoof; reframe ble_write as defensive Ring/Find
    The offensive BLE advertisement-blasting (ble_spoof) was a novelty with real
    legal exposure and no counter-surveillance value, so remove it entirely:
    - firmware: drop executeBleSpoof + spoofTask/statics (mode_beacon_bandit) and the
    "ble_spoof" action branch (ble_serial). Sending ble_spoof now no-ops safely.
    - app: remove triggerSpoof(), the Spoofing Engine UI block, its mode-1 toggle,
    and the help text.
    Keep the genuinely useful active feature, reframed defensively: ble_write now
    backs "Ring / Find", which writes the Immediate Alert Service (0x1802/0x2A06) to
    make a suspected tracker chirp so it can be physically located and remove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
2026-08-30 Fix app/BLE state desync after backgrounding
    On Android the native BLE link survives the app being backgrounded (no
    disconnect, notifications keep flowing, device plays no disconnect tone),
    but the app registered no resume/appStateChange listener, so its JS/UI
    connection state could drift out of sync and show "disconnected" while
    still connected. Recovery was then impossible: the connected ESP32 stops
    advertising, so a rescan returns "No device found" -- a dead end.
    Fix (app/public/app.js, native BLE path):
    - reconcileConnection(): on appStateChange(isActive) and visibilitychange,
    query BleClient.getConnectedDevices([NUS]); if the link is live but the UI
    says disconnected, re-subscribe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
2026-08-30 Beacon Bandit: pin locked-on target to top of the list
    Previously the target list rendered in firmware order (by RSSI), so a
    locked-on tracker could scroll down as its signal changed. Stable-sort the
    mode-1 list so is_locked targets come first regardless of strength; all
    other targets keep their existing order.
    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
2026-08-30 Watcher's Watch: weighted confidence scoring
    Replace the binary isFlock match with an accumulated 0-100 confidence and a
    Confirmed/Likely/Possible tier, so weak and strong signals are weighted
    honestly instead of a bare OUI hit asserting "Flock Safety" at full certainty.
    - matchDeviceAgainstRule() returns a weight (OUI 30, mfg 45, name/UUID 70)
    instead of bool; the BLE callback accumulates across all matching rules.
    - WiFi callback accumulates too, and scans the Lite-On vendor IE + SSID
    unconditionally so they add to (not replace) the OUI weight; fixes the old
    double protocol= assignment; +15 corroboration + protocol "BLE+WiFi" when a
    MAC is seen on both transports.
    - Only list targ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
    [mode_watchers_watch.cpp, mode_watchers_watch.h]
2026-08-30 Sky Sweeper: hop all 2.4 GHz channels
    Widen the WiFi channel hopper from {1,6,11} to {1..11} so a drone's Remote ID
    WiFi (which rides its operating channel) isn't missed, and fix the hop index to
    wrap on the array length instead of a hardcoded % 3 (which would have ignored
    the new channels). Note in-code that 5 GHz Remote ID is out of reach — the
    ESP32-S3 is 2.4 GHz only (hardware limit). Same channel-list fix applied to the
    Watcher's Watch hopper in its commit.
    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
2026-08-30 App: confidence/stalking badges + render Watcher's & Sky Sweeper lists
    - renderTargets(): confidence badge (Watcher's Watch, mode 2) colored by tier
    (Confirmed red / Likely amber / Possible muted), and a "STALKING" risk badge
    (Beacon Bandit, mode 1) when separated or score >= 40. Mode-1 sort now orders
    locked-first, then by stalking score.
    - Fix a pre-existing gap in processIncomingData: only mode 1 rendered a target
    list; mode 2 was a stub and mode 3 unhandled, so Watcher's Watch and Sky
    Sweeper never populated their lists. Wire both to renderTargets.
    Verified on device: Watcher's Watch list now populates with "POSSIBLE 30%"
    badges on ambient Lite-On devices (honest, not false "C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
2026-08-30 Watcher's Watch: raise listing floor to cut false positives
    A single weak, non-Flock-specific signal (a broad OUI prefix, or the Lite-On
    vendor IE that appears in countless consumer WiFi chips) was enough to list a
    device at "Possible 30%". In an area with zero Flock hardware that produced a
    list full of "Unknown Flock Node" noise.
    Raise CONF_LIST_MIN 30 -> 60: a device now lists only with one genuinely
    Flock/Axon-specific signal (SSID keyword / service UUID / device name, 70-80) or
    two corroborating weak signals (OUI + IE, or +15 cross-protocol). Verified on
    the bench in a no-Flock environment: watchers target count drops to 0.
    Claud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
    [mode_watchers_watch.cpp]
2026-08-31 Add Shadow mode: tail / pursuit detection
    A fifth mode (MODE_SHADOW = 4) that answers "is someone following me?" — the
    one question the other modes don't. The firmware harvests every BLE + WiFi
    device MAC it can hear; the phone (which has the GPS) correlates them against
    location and flags any device that reappears near you across multiple distinct
    places.
    Firmware (mode_shadow.cpp/.h):
    - Continuous BLE scan (wantDuplicates=true so a persistent device's count
    climbs) + WiFi promiscuous with an all-2.4GHz channel hopper. BLE window is
    50% so the shared radio has airtime for WiFi. Reports the strongest ~40
    sightings (count>=2 to drop one-off blips) as JSON at 1 Hz, pruning devices
    u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
2026-08-31 Shadow: whitelist your own gear ("mark as mine")
    Your own car AP, phone, and earbuds travel every place you do, so they always
    score as tails — burying the signal. Add a per-viewer whitelist so you tap them
    away once and Shadow ignores them for good; what's left is genuinely foreign.
    - Split renderShadow into shadowIngest (fold sightings, skipping whitelisted)
    and shadowRenderList (render current store, filtering whitelisted), so a
    whitelist change re-renders instantly without a new firmware push.
    - Tap any tail row -> shadowWhitelistAdd(mac): adds the MAC, drops its history
    so it stops scoring, persists to localStorage, re-renders. Row shows a
    "tap if this is yours -> hide it" hi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
2026-08-31 Add CHANGELOG
    First changelog for the project, covering the work to date: Shadow mode +
    whitelist, Watcher's Watch confidence scoring, Beacon Bandit stalking
    detection, the tiered build system, the Ring/Find reframe, false-positive
    tightening, and the backgrounding/lock/bare-digit fixes.
    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
2026-08-31 Drop duplicate radar, add Clear Target + BOOT-hold factory reset
    Three fixes, app and firmware:
    Single radar. Sky Sweeper already draws a proper radar (sweep animation,
    true bearing from the phone's GPS when the drone reports a position). The
    generic "Radar View" toggle at the bottom of the target list drew a second
    one on a canvas with blips at random angles — decoration, and confusing
    next to the real thing. Removed the List/Radar buttons, the #radarCanvas
    element, and toggleViewMode/drawRadar/currentViewMode (~60 lines). The
    Sky Sweeper radar and the AI Debrief export are untouched; radarAngles and
    detectedDevices stay because both still use them.
    Clear Target. Beacon Bandit's lock co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
    [main.cpp]
2026-08-31 Fix dead Help/Settings buttons in the app
    Two independent bugs kept the header's gear and question-mark buttons
    from doing anything:
    - The open/close handlers set style.display, but .modal-overlay is
    already display:flex and its visibility is gated on the .active class
    (opacity + pointer-events). Switched all four handlers to
    classList.add/remove('active').
    - Even once open, the Settings BLE/WiFi scan toggles were no-ops:
    sendCommand({raw:'CMD:BLE_SCAN:ON'}) transmitted {"raw":"CMD:..."},
    which the firmware deserializes as valid JSON and therefore never
    reaches the raw-text fallback where the CMD: handlers live
    (firmware/src/ble_serial.cpp:122). sendCommand now sends cmdObj.ra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
2026-09-01 Detect surveillance by geography, not by vendor list
    Watcher's Watch could only ever find vendors already on a list, and the list
    was not trustworthy. Detection was 100% vendor fingerprinting, gated in
    firmware at CONF_LIST_MIN 60, so an ALPR whose OUI wasn't known never even
    reached the phone. Meanwhile the 40 crowd-sourced "Flock" OUIs included
    a4:cf:12 and 3c:71:bf (Espressif -- this board's own vendor block), cc:cc:cc
    (not an assigned OUI), and 82:6b:f2 (locally-administered bit set, i.e. a
    randomized-MAC prefix that matches phones), and every Wi-Fi hit was stamped
    "Flock Safety" regardless of which rule fired.
    Replace the question. Instead of "is this device made by a surveillance
    vend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
    [ble_serial.cpp, ble_serial.h, mode_watchers_watch.cpp, mode_watchers_watch.h]
2026-09-01 Record the render-density ceiling and its upgrade path
    Removing the confidence gate changed the shape of the render load: Watcher's
    Watch used to show 0-3 rows because almost everything was filtered out in
    firmware, and now shows up to WATCHERS_MAX_REPORT (40) at 1 Hz. Every list
    still rebuilds with `list.innerHTML = html` on every push, so that is now a
    full teardown and recreation of forty rows per second.
    Nothing is measured to be wrong, so this changes no behaviour -- it only writes
    down the shortcut that was taken deliberately, in the project's `ponytail:`
    form so /ponytail-debt harvests it. The note carries three things:
    - The ceiling, and an explicit statement that it is not a known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
2026-09-01 Headless buzzer on both radios; mount LittleFS so signatures actually load
    Wiring the buzzer into the Wi-Fi path turned up something much larger.
    The buzzer. With no phone connected the buzzer is the entire user interface,
    but the only triggerAlarm()/triggerWarning() calls lived in the BLE callback.
    That meant the strongest Flock signal in the whole system -- an SSID match,
    weight 80, well past the alarm threshold -- made no sound at all, because SSIDs
    only exist on the Wi-Fi side. Both paths now record the hit through noteAlert()
    and the 1 Hz task sounds it (>=75 alarm, 60-74 warning, below 60 silent).
    Routing it through the task keeps the promiscuous callback non-blocking, since
    the trigg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
    [ble_serial.cpp, main.cpp, mode_watchers_watch.cpp, mode_watchers_watch.h]
2026-09-01 Cut telemetry cost: 1 Hz push restored, payload halved
    A 60 s soak showed the "1 Hz" telemetry actually running at 0.77 Hz -- 46
    pushes in 60 s, 5.5 KB each, at ~33 devices. Removing the confidence gate took
    Watcher's Watch from 0-3 reported devices to as many as 40, which quietly made
    the telemetry path the dominant cost in the loop. Same soak after these
    changes: 59 pushes in 60 s at ~2.8 KB.
    The fix that actually mattered was not one of the three I set out to make.
    sendBleSerial() chunked and slept through the entire payload even with no BLE
    client connected -- and with no peer there is no negotiated MTU either, so a
    3 KB push fragmented into ~146 twenty-byte notifications with a yield b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
    [ble_serial.cpp, mode_watchers_watch.cpp]
2026-09-01 Stop the sight store from deleting confirmed detections
    Confirming a fixed installation takes repeat visits across days, so weeks of
    history IS the detector. Two storage rules were throwing it away.
    Quota eviction sorted by `count` and dropped the weakest half. `count` measures
    how talkative a radio is, not how interesting: a slow-beaconing ALPR caught on
    two drive-bys sits at ~6 sightings while a neighbour's smart TV sits at 4000, so
    the eviction kept the TV and binned the camera — the same mistake the firmware's
    report cap is already forbidden from making with RSSI, one layer up. Eviction
    now orders by classify(): candidates first, stalest first, findings last, and
    says so if a finding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
2026-09-01 Check confirmed detections against OSM's mapped ALPRs
    The geospatial classifier had no independent check. OpenStreetMap already
    carries crowd-mapped ALPRs (man_made=surveillance + surveillance:type=ALPR) —
    the dataset DeFlock renders — so the map now pairs the two and shows three
    outcomes: corroborated, mapped-only, and unmapped. The third is the point of the
    project: a fixed installation you confirmed that nobody has put on a map.
    Corroboration is a label and never feeds classify(). Letting OSM promote or
    demote a detection would re-introduce the list-shaped blindness that detecting
    by geography exists to avoid — the same rule that already governs signature
    matches.
    The query runs o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
2026-09-01 Show GPS accuracy in the header
    A fix vaguer than SIGHT_ACCURACY_MAX_M (50 m) is discarded by sightRecord — no
    cluster, no visit, no confirmation — and that failure was completely invisible:
    the map still tracks, the device list still fills, and the drive records nothing
    while looking healthy. Without mobile data there is no A-GPS to warm-start the
    fix, which is exactly when a cold lock sits above the gate longest.
    Green metres = recording. Red "TOO VAGUE" = everything is being thrown away.
    Claude-Session: https://claude.ai/code/session_01YGXCwHkvEwKd4vn18vcN8G
2026-09-01 Reconnect the link, and alert on evidence instead of noise
    Two faults from one field session. A 2 h 17 m drive recorded 8.1 seconds: 37
    devices, all candidate, all in the driveway.
    The link dropping was terminal. onDeviceDisconnected() painted a banner and
    stopped; nothing in the app ever reconnected. On the phone: localStorage last
    written 12:44:26, GATT client still registered until 15:01:54, nothing in
    between. The link died 25 s in and the banner went unread because the phone was
    mounted on a dashboard. Now a capped-backoff loop (2 s doubling to 30 s,
    forever) reconnects off a persisted deviceId — a requestDevice() chooser is
    useless to a driver, a remembered id is silent. A deliberat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
    [ble_serial.cpp, mode_watchers_watch.cpp, mode_watchers_watch.h]
2026-09-02 Peel back to a simple beeper: one detector, no trail, encrypted pins
    A deliberate reversal of the geospatial direction, on two grounds the user
    raised: opsec (the passive sightStore logged everywhere the device had been —
    a liability if the phone were found) and simplicity (five modes were one
    behaviour, "match a known signature and beep", wearing different filters).
    Firmware — one always-on detector:
    - mode_watchers_watch.cpp is now the whole engine: BLE scan + WiFi promiscuous
    concurrently, matching signatures plus presence detectors for drone Remote ID
    (BLE 0xFFFA / WiFi vendor IE) and Apple Find My / Tile / SmartTag trackers.
    - Each match carries a category; hardware_manager sou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
    [ble_serial.cpp, hardware_manager.cpp, hardware_manager.h, main.cpp, mode_manager.cpp, mode_manager.h, mode_watchers_watch.cpp, mode_watchers_watch.h]
2026-09-02 docs(firmware): add wiring guide + schematic diagram
    Wiring reference for the XIAO ESP32-S3 + passive buzzer + 8-LED NeoPixel bar:
    - WIRING.md: parts, pin map, steps, power budget, gotchas, ASCII diagram.
    - wiring-diagram.html: labeled schematic (also published as an artifact),
    theme-aware, using real wire-colour convention (red 5V, grey GND, amber
    data, green signal).
    Reflects the real board: pads are D0-D10 (D1=GPIO2 NeoPixel, D2=GPIO3 buzzer),
    power pad is VUSB=5V, data pins on the left edge / power group top-right by the
    USB. NeoPixel bar broken out as GND/IN/VCC/GND (IN=DIN; the two GNDs are one
    net). Pins match hardware_manager.h (NEOPIXEL_PIN 2, BUZZER_PIN 3).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
2026-09-02 Add a paired two-board antenna comparison bench test
    test_antenna.py reads the 1 Hz USB-serial telemetry mirror from two boards
    at once and compares what each one HEARS. The headline number is the paired
    median: for every MAC both boards saw, the per-MAC RSSI difference. Pairing
    cancels the environment out, so the result survives a noisy room in a way
    that comparing raw per-board averages does not.
    Comparing the boards' own adverts from the host would have been simpler and
    needed no firmware change, but this machine has no Bluetooth adapter at all.
    Reading the serial mirror needs the report gate open, so CONF_LIST_MIN is now
    #ifndef-guarded: default behaviour is unchanged, and a bench build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
2026-09-03 Put back the map, the tabs and real Remote ID — not the false positives
    The "simple beeper" pass was right about the two things that hurt (a passive
    location trail on a seizable phone, and a signature list that cried wolf) and
    wrong about how much it had to delete to fix them. This restores what was
    missed without restoring what was broken.
    Full ASTM F3411 Remote ID decode. The drone check was presence-only; it now
    decodes UAS serial, operator ID, self-ID, the aircraft's own position /
    altitude / AGL / speed / heading, and the operator's position. Three paths:
    BLE service data 0xFFFA, Wi-Fi beacon vendor IE (90:3A:E6 / FA:0B:BC), and
    Wi-Fi NAN action frames. The upstream opendroneid sourc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
    [ble_serial.cpp, mode_watchers_watch.cpp, mode_watchers_watch.h, odid_wifi.h]
2026-09-03 Settings: rename the device, and optionally randomize its address each boot
    Two boards on the bench are both called "SignalSweep" in the connect dialog,
    which is unworkable. The settings page can now set the advertised BLE name, and
    optionally have the device pick a fresh random address every power cycle.
    Discovery is unaffected by a rename: the app filters on the NUS service UUID,
    with the name only as a fallback prefix, so renaming cannot make a device
    unfindable. The name is capped at 20 characters and stripped to printable ASCII
    before it is stored, since it goes straight into an advertisement and then into
    the phone's device picker.
    Randomization uses a random *static* address rather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
2026-09-03 Foxhunting, a location readout, and an interface that looks like an instrument
    Three things: the filter switch and foxhunt flow from the old Beacon Bandit,
    the GPS status badge that went missing with the geospatial era, and a pass over
    the band tabs, which were four words in a row and read like placeholder.
    Foxhunting. {"scan_all":bool} reports every tracked device instead of only
    signature matches — turn the filter off, find something interesting, lock it,
    walk it down. It lifts the listing gate ONLY; CONF_ALERT_MIN still governs the
    buzzer, so the filter can be off in a crowded room without a single beep.
    Measured on the bench: 39-44 devices listed, none at or above the alert
    threshold,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
    [ble_serial.cpp, mode_watchers_watch.cpp, mode_watchers_watch.h]
2026-09-03 Persist what the operator sets, and stop losing detections that never beeped
    You were right to check. One of the two headless scenarios was broken.
    The vehicle case was fine: the detector auto-starts, signature rules live on
    LittleFS, and the buzzer preference is already in NVS, so power returning means
    it beeps again with no phone involved.
    The battery foxhunt case was broken. huntMac and scanAll were plain statics —
    scanAll deliberately so, on the grounds that a board left with the filter off
    floods the telemetry budget. That argument protected a budget that is not being
    spent: sendBleSerial() returns early with no client subscribed, so the cost of
    reporting everything is zero precisel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
    [ble_serial.cpp, mode_watchers_watch.cpp, mode_watchers_watch.h]
2026-09-03 Fix dead band tabs, and filter-off pushes too big to survive BLE
    Two separate faults behind one report.
    The band tabs did nothing. The delegated click listener still matched
    '#lens-row .lens-tab' after the tabs were rebuilt as '#bands .band' in the
    interface pass. Nothing threw and nothing logged — the selector simply never
    matched, so the list stayed on Everything for ever. This is the worst shape of
    bug to leave lying around, since the only symptom is absence, so the self-test
    now cross-checks every id-anchored selector in app.js against the ids present in
    index.html before it runs anything else. Verified by reintroducing the old
    selector: the check fails on it and passes once restored.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
    [mode_watchers_watch.cpp]
2026-09-03 SSIDs on Wi-Fi rows, a radio filter, Wi-Fi foxhunting, and the Lite-On misread
    Wi-Fi rows now carry the SSID the device announces and are titled by it when
    they have nothing better. A network name is the one field that lets someone
    recognise their own hardware, where a vendor prefix does not. Captured from
    beacons and probe responses only: a probe request names the network a client is
    looking for, which says nothing about the device sending it.
    Added a Both radios / Bluetooth / Wi-Fi filter, shown only while the report
    filter is off, where most of the list is access points and choosing one radio
    actually helps. A device heard on both counts as either.
    Foxhunting now works over Wi-Fi. Two t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
2026-09-03 Receive-only: stop the detector announcing itself
    A counter-surveillance tool that advertises "SignalSweep" on the air
    announces its presence to anyone else running a scanner — including the
    hardware it exists to find. Receive-only stops advertising and drops the
    GATT link; the BLE radio then does nothing but listen.
    The driver is emissions, not airtime. The scanner already runs a 50% duty
    cycle and the real contention is Wi-Fi promiscuous against the BLE scan on
    one shared radio, so killing the GATT server buys very little there. It
    buys everything on the "does this thing broadcast?" question.
    Not silent, and not deaf. "Silent" already means the buzzer mute
    ({"buzzer":false}) and that i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
    [ble_serial.cpp, ble_serial.h, hardware_manager.cpp, hardware_manager.h, main.cpp]
2026-09-03 Document receive-only, and un-mangle the README
    The README had been written through a shell that ate backslash escapes, so
    every path in it read as "irmware/" and "pp/" and every fenced block opened
    with `ash. It also still described the app as React, which it has not been
    since the interface was rewritten as hand-written HTML.
    Rewritten around what the device actually is — a headless beeper whose
    patterns are the identification — rather than opening on the directory
    layout. Adds an operator section that was missing entirely: what the BOOT
    button does (tap re-advertises for two minutes out of receive-only, hold
    five seconds is the factory reset), what receive-only is and is not, the
    ser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
2026-09-03 Stop offering USB on Android, where WebSerial does not exist
    Tapping "Connect via WebSerial (USB)" on the phone did the only thing it
    could: pop an alert telling you to use Chrome, Edge or Opera. Android has
    no WebSerial implementation at all — not a flag, not a permission prompt,
    the API is simply absent from the platform, and the Capacitor build IS
    Android. The connect modal was offering a button whose sole outcome was an
    error message.
    checkApiSupport() already tested `'serial' in navigator` to colour the
    badge; it now hides the button on the same test. That covers Android and
    equally covers Firefox or Safari on the desktop, where the situation is the
    same. The badge row stays, so the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
2026-09-03 Drive the device from the phone over USB, with the radio off
    Receive-only had a hole in it: silencing the device from the phone severed
    the only link the phone had. The cable looked closed off, because Android
    has no WebSerial — the API is absent from the platform, not gated behind a
    flag — so the USB option on a phone did nothing but raise an alert.
    That was the wrong conclusion. The browser API is missing; the capability
    is not. Android has USB host, the board is a CDC/ACM device
    (ARDUINO_USB_CDC_ON_BOOT=1, Espressif VID 0x303A), and
    usb-serial-for-android has driven that class for years. The app now reaches
    it through @leeskies/capacitor-usb-serial, which wraps that library for
    Capac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
2026-09-03 A Settings page you can reach the bottom of, and radios that report themselves
    The settings modal could not be scrolled to the bottom. `.modal-overlay` is a
    fixed 100vh flexbox and `.modal-card` had no max-height and no overflow, so any
    modal taller than the screen spilled off both ends with nothing to scroll.
    Settings is the tallest so it showed first, but Help and Signature Rules had the
    same bug on a phone.
    The overlay is now the scroller rather than the card: the close button is
    absolutely positioned inside the card, so scrolling the card would have pinned
    the x over the content. `align-items:flex-start` plus `margin:auto 0` keeps a
    short modal centred and lets a tall one scroll, with s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
    [ble_serial.cpp]
2026-09-03 Always show the BLE picker, so you can reach the second board
    Connecting from the phone silently re-attached to whichever board you used
    last. There was no picker and no way to choose a different device short of
    clearing the app's data.
    It was never the BLE name. requestDevice() filters on the NUS service UUID,
    not the name, so a renamed board would have shown up fine -- the picker just
    never opened. connectNativeBluetooth() called getConnectedDevices() first and
    adopted whatever came back, and Android keeps the GATT link alive across app
    backgrounding and restarts, so the link to board A was still there and always
    won.
    An explicit Connect tap now always means "let me choose": the shortcut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
2026-09-03 Tell a Bluetooth row from a Wi-Fi one at a glance
    With the report filter off the live list is a wall of rows, and the only
    clue which radio heard a device was the word "BLE"/"WiFi" buried in the
    grey sub-line between the MAC and the SSID. Unreadable at speed, which
    is the only speed you read this list at.
    Every row now leads with a small chip: blue BLE, green Wi-Fi, both for a
    target seen on both radios. They sit at the head of the title so they
    line up in a column you can scan down. The colours are deliberately not
    category colours -- the radio is orthogonal to what the thing is, and
    the row's left border and signal bars already carry the category.
    The protocol word leaves the sub-line, w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
2026-09-03 Pick which categories the buzzer speaks, and verify it on hardware
    Driving with the detector on, every AirTag in traffic earned the tracker
    pattern -- correct, and useless to listen to. Settings now has a "What
    beeps" section: five checkboxes over the existing AlertCategory enum, sent
    as a one-byte {"beep_mask":N} and echoed by CMD:CFG. A muted category is
    fully silent -- no beep, no LED flash, no getAlertCount() increment -- but
    is still tracked, still listed and still reported; the mask is about the
    noise, never about what the detector watches for. It persists in
    ouispy-st/beepmask next to the hunt target and report filter, because the
    device is headless and loses power every ignition cycl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
    [ble_serial.cpp, mode_watchers_watch.cpp, mode_watchers_watch.h]
2026-09-04 Let the device answer for itself, instead of the app guessing
    The app never pushed its own settings on connect -- every command it sends is
    a button press, and the only automatic traffic is a CMD:CFG read. The problem
    was the other direction: state the device owned but did not report, did not
    keep, or could not be asked about.
    The buzzer mute was all three. hardware_manager.cpp read ouispy-bz/on at boot
    and nothing anywhere wrote it, so a detector muted in the field came back
    beeping at the next ignition cycle. It was absent from CMD:CFG, so app.js
    shipped `let buzzerOn = true` and a hardcoded "Buzzer: ON" -- connect to the
    second board on the bench and the app confidently showed the first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
    [ble_serial.cpp, hardware_manager.cpp]
2026-09-04 Walk a target down without fighting the list to do it
    Three things made the foxhunt worse than the buzzer it is meant to support.
    The list danced. liveRows() sorted on raw RSSI every push, so a couple of dB
    of multipath swapped two rows and the Hunt button you were reaching for moved
    out from under your thumb -- on a 24 px target, in a list that redraws once a
    second. Ordering is now bucketed to 5 dB with the MAC as tiebreak (strongest
    first still holds; the jitter moves nothing) and the row actions are 44 px.
    The meter was pegged to the top of the list. You find something interesting
    halfway down, lock it, and the instrument describing it is off screen. The
    hunted row is now pinned to ind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
    [mode_watchers_watch.cpp]
2026-09-04 Prepare for public release: credit, license, and a way in
    The repo goes public for the first time. Three things had to be true before
    that: the people whose work this was built on are named, nothing embarrassing
    or personal ships, and a stranger with a $15 board can use it without a
    toolchain.
    Attribution
    CREDITS.md names Colonel Panic (OUI Spy, the project this one came from),
    OrdoOuroborous / @NitekryDPaul (the Flock Safety OUI research), Will
    Greenberg, DeFlock, the opendroneid-core-c authors and every library.
    The firmware is an independent implementation, not a fork, and that was
    measured rather than assumed: normalising the 1,353 unique non-comment lines
    of the detector a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
2026-09-06 Publish the site by pushing gh-pages, not through the Pages environment
    The first CI run built cleanly (1m44s, valid 773 KB artifact) but the deploy
    job failed in 1 second:
    Branch "main" is not allowed to deploy to github-pages due to environment
    protection rules.
    actions/deploy-pages only works when the Pages source is "GitHub Actions",
    and selecting that pins the github-pages environment to one branch, which then
    rejects deployments from main. Pages is serving the gh-pages branch and that
    works, so the workflow now force-pushes the assembled tree to gh-pages
    directly. No environment, no protection rules, no OIDC -- and CI now performs
    exactly the same publish that was done by hand.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
2026-09-06 Make the buzzer controls findable, sticky, and honest about the device
    The per-category toggles were three taps deep in Settings, and using them
    desynced the app from the board: BLE write errors on screen, checkboxes showing
    a mask the ESP never received, and no way back but a five-second factory reset
    plus a force stop of the app. Five separate defects, all confirmed on the
    two-board rig rather than inferred.
    Overlapping BLE writes silently dropped commands. GATT permits one write in
    flight; a second is rejected with InvalidStateError, and since nothing awaits
    sendCommand() the command was simply lost behind a transmit-error toast.
    Ordinary use reached this -- five checkboxes each fired th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
    [hardware_manager.cpp, mode_watchers_watch.cpp]
2026-09-06 Trim the repository to what ships
    Working notes -- bench measurements, reversed decisions, write-ups
    addressed to whoever is at the keyboard -- are not documentation for
    anyone cloning this. They stay on disk and are gitignored. CHANGELOG.md
    is the design record for readers and CONTRIBUTING.md carries the rules;
    both keep every point that mattered.
    Also drops the two Capacitor scaffold tests. They assert 2+2 and a
    package name under com.getcapacitor.myapp, which is not this app's
    package, and nothing runs them.
    node app/selftest.js: PASS
    Claude-Session: https://claude.ai/code/session_01RQ1YawMfMjFE3FLissUP1f
2026-09-06 Publish a signed APK, and an installer that will not wipe the wrong device
    The Android app had no distribution path: no signing config, so a release
    build produced an unsigned APK that Android refuses to install. There is no
    Play Store listing and there will not be one -- sideloading is the channel --
    so the release asset has to be a properly signed APK, and there has to be
    something friendlier than four esptool offsets typed by hand.
    Signing. build.gradle gains a release signingConfig fed by four env vars,
    applied only when ANDROID_KEYSTORE_PATH points at a file that exists. Local
    and fork builds are unaffected and simply produce an unsigned APK rather than
    a debug-signed one, which is del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
    [install.py]
2026-09-06 Give CI a Node the Capacitor CLI will run on
    The release job pinned node-version 20; the Capacitor 8 CLI requires >=22 and
    refuses outright:
    [fatal] The Capacitor CLI requires NodeJS >=22.0.0
    Vite builds fine on 20, so the pin was invisible until cap sync joined the job
    to produce the APK. Both now share Node 22 rather than the build and the sync
    disagreeing about which runtime they need.
    Found via the step's own ::error:: annotation -- the logs are not readable
    without a token, so that channel is the only way this was diagnosable.
    Claude-Session: https://claude.ai/code/session_01T6cMEmm295xPcdPKB3tUaZ
2026-09-06 Clamp versionCode to a positive integer
    The CI APK build failed configuring the project:
    android.defaultConfig.versionCode is set to 0, but it should be a positive
    integer.
    Branch pushes are not releases, so the workflow feeds the build 0.0.0 as a
    marker -- which derives to versionCode 0, exactly the value Android rejects.
    Clamping in build.gradle fixes it for any input rather than making every caller
    responsible for picking a version that happens to derive above zero.
    Verified locally against both cases: 0.0.0 -> versionCode 1, 0.1.1 -> 101.
    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
2026-09-06 Stop adb from eating the installer's confirmation prompt
    install.py's adb subprocesses inherited stdin and consumed it, so the
    "type the serial to confirm" prompt read EOF and the script died with a
    traceback instead of asking. Every adb call now gets stdin=DEVNULL: a helper
    process has no business reading the installer's input, and the prompt is the
    one thing standing between a stray command and the wrong device.
    Found running install.py against the real v0.1.1 release.
    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
    [install.py]
2026-09-06 Put a short README out front, move the tech doc to docs/
    The README was 304 lines of reference material -- threat model, serial
    protocol, build instructions -- which on GitHub is a wall nobody reads. It
    is now docs/README-full.md, unchanged except for its relative links, which
    had to gain a ../ once it moved down a level.
    The new front page is the short sheet, with three screenshots from the
    two-board bench rig (detector on COM3, emitter on COM4, phone over BLE):
    the live scope with all four categories matched and the drone's decoded
    ASTM block, a foxhunt with the meter pinned to the top of the list, and a
    drone drawn at its own broadcast coordinate.
    Three claims from the draft did not sur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
2026-09-08 Measure antenna orientation without reflashing both boards
    test_antenna.py wanted a -D CONF_LIST_MIN=0 build on both boards to open
    the report gate, which meant a rebuild and two flashes before every
    comparison. {"scan_all":true} does the same thing at runtime over the USB
    serial mirror, so the script now sends it on open. The build-flag route
    still works; it is just no longer required. Note scan_all persists in NVS
    (sweep-st/scanall), so send {"scan_all":false} when you are done or the
    board comes back unfiltered on its next power cycle.
    Also report transmit, not just receive. Each board advertises "SignalSweep"
    while the other is scanning, so the peer already appears in the target list
    as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
    [test_antenna.py]
2026-09-09 Don't rebuild and republish the site for docs and bench scripts
    Every push to main runs this job, which builds tier1, builds the app,
    builds and signs the APK, and force-pushes _site to gh-pages -- republishing
    the live web flasher. For a change that cannot affect any of those outputs
    that is minutes of CI to redeploy a byte-identical site. A 57-line edit to
    firmware/test_antenna.py, a host-side bench tool the workflow never reads,
    triggered exactly that.
    The second-order cost is worse than the wasted minutes: when a push means a
    deploy, pushing feels expensive, so commits sit on one laptop unbacked-up.
    A push should be free.
    paths-ignore is the native filter for this -- no script, no new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
2026-09-10 Give each detection its own LED animation, and quiet the idle blink
    Every indicator filled the whole 8-LED bar with one colour, a holdover from a
    single status pixel, so idle was all eight LEDs blinking every 0.8 s -- on a
    counter-surveillance device in a parked car, a beacon. Idle is now one dim
    pixel glowing once every 4 s (green, or blue in receive-only).
    The full bar is reserved for detections, and each category animates
    differently, because like the buzzer pattern the shape is the ID and has to
    read with the buzzer muted: ALPR a red comet sweep, body cam three camera-flash
    pops in the long-short-short rhythm, drone a rising fill then chasing rotor
    blades, tracker alternating ticks then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
    [hardware_manager.cpp]
2026-09-10 Make the hunt meter steady and read it like signal bars
    The meter flared to full brightness on every Geiger click, which at 2-3 clicks
    a second was hard to look at -- the ear already has the clicks. It also hopped
    a whole LED on every advert, because RSSI jitters several dB packet to packet
    (measured -32 to -67 dBm on a stationary target). The level is now smoothed
    over about a second and the top LED lit in proportion, so the bar glides.
    It was also coloured by position like a heat gauge, green first and red last,
    which painted a weak -76 dBm lock as four green bars: "good signal". Now the
    count is the strength and the whole meter is one colour, like a phone's bars:
    red below ~-71 dBm, yell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
    [hardware_manager.cpp]
2026-09-11 Tell Wi-Fi APs from clients, and name who made each device
    The detector always listed both access points (beacons, probe responses)
    and clients (probe requests), but the app drew both as the same Wi-Fi
    chip. The push now carries "ap":1|0 and the chip reads AP or Client.
    The Wi-Fi tab gains an All / APs / Clients strip that filters only while
    Wi-Fi is selected, so a leftover choice cannot hide rows elsewhere.
    Rows also name their maker, looked up offline from lists bundled with the
    app (IEEE OUI registry, Bluetooth SIG company IDs), refreshed by
    app/tools/fetch-vendors.mjs. Never an online lookup: that would send every
    MAC the device hears to a third party. The OUI is used only for public
    ad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
2026-09-11 Chirp on cable connect and disconnect, like the Bluetooth link
    Connecting over USB serial (Android USB host or desktop WebSerial) now
    plays the same rising/falling chirps as a BLE connect; plugging in a cable
    does not. The board cannot tell those apart itself -- USB-Serial-JTAG's
    "connected" only means a host is sending frames, and opening the port
    resets the board -- so the app announces itself: CMD:HOST every 2 s while
    it holds the port, CMD:HOST:BYE on a deliberate disconnect. loop() chirps
    on the first CMD:HOST, on BYE, and after 6 s of silence (cable yanked, app
    killed). Other serial traffic never chirps. Chirps respect the mute.
    The session is a bool plus a timestamp, not a "0 = none"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
    [main.cpp]
2026-09-11 Add LED modes, and turn the Sounds sheet into Alerts
    {"led":0..3} picks off / one LED / dim / full. It is applied to the
    finished frame in HardwareManagerTask -- brightness before clear(), then
    Off clears the frame and One moves the brightest pixel onto LED 0 -- so
    every animation, the hunt meter and the heartbeat obey it without knowing
    it exists. Persisted in sweep-bz/led, reported in CMD:CFG and the 1 Hz
    push like the buzzer mute, and painted in the app only from the device.
    The toolbar's Sounds sheet becomes Alerts: How (Sound on/off, Lights) and
    What (the five categories, one compact list). Not "Notifications", which
    on Android means the notification shade. The old Buzzer row claimed t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
    [ble_serial.cpp, hardware_manager.cpp, hardware_manager.h, mode_watchers_watch.cpp]
2026-09-11 Clean up the top of the app: board name, stats, two-button toolbar
    The header now names the connected board and link ("SignalSweep666 ·
    Bluetooth") from CMD:CFG's ble_name, so a cable connection no longer shows
    only a port. A connection bar inside the header card carries a labelled
    Connect / Disconnect button; the lone Disconnect row and the amber
    disconnected banner (a second Connect button) are gone.
    The status strip shows Uptime and Alerts since boot next to Location.
    Uptime is a new `uptime` field in CMD:CFG, read once and counted on by the
    app. `alerts` now rides the 1 Hz push so it ticks live: idle push 132 B,
    60/60 pushes in a 60 s soak. CPU, heap and chip temperature were left out: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
    [ble_serial.cpp, mode_watchers_watch.cpp]
2026-09-11 Show the filter as unknown while nothing is connected
    With no board connected the app cannot know its filter setting, so the
    button read a confident "Filter: On" for a board it could not see. It now
    reads "Filter: —", unlit, like Alerts, and tapping it says to connect first
    instead of flipping a setting no board would receive. paintFilter() runs from
    renderStatusStrip() so a reconnect repaints it even when scan_all matches the
    old value.
    Claude-Session: https://claude.ai/code/session_01MbGZbNgntdy227V6HS3Bkk
2026-09-11 Let a band tab pick which category alerts, and which asks to be pinned
    Tapping Cameras, Trackers or Drones now sets a preset beep_mask on the
    device, so it beeps and flashes for that category only; Everything (or
    tapping the selected tab again) turns them all back on. It is the same
    persisted mask the Alerts sheet edits, so the choice survives a power
    cycle and the board keeps it headless. Detection and listing are
    untouched: every band still counts what it hears.
    The app adopts the tab from the device's mask on connect and on every
    push, so a board set headless opens on its tab. A custom mix from the
    Alerts sheet leaves the tab alone. The toolbar names a single category
    ("Alerts: trackers"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
2026-09-11 Release 0.2.0: refreshed screenshots and docs
    New scope and foxhunt screenshots from the two-board bench (emitter on the
    spare board), showing the new header, stats strip and two-button toolbar.
    README covers the tab-driven alerts, LED modes and offline vendor names;
    the full doc's serial section gains led, uptime, beep_mask and CMD:HOST.
    Claude-Session: https://claude.ai/code/session_01QeULQde3kW9gUjC49HAtHQ
2026-09-11 Call the hunt signal beeps, and let the README sound like a person
    The hunt panel's "the device is clicking now" hint is gone -- it is obvious
    what the device is doing -- and the lock-on toast says "follow the beeps".
    README screenshot captions rewritten in a terser, terminal-flavoured voice.
    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
2026-09-11 Rewrite the README in a voice that sounds like someone who uses it
    Same facts, fewer words: shorter bullets, plain verbs, and a couple of
    nods to the films and scene the project grew out of.
    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
2026-09-13 Catch the modern Flock camera on any MAC by its Lite-On IE fingerprint
    A current camera is a randomized-MAC WiFi client, so the OUI-gated
    wildcard-probe path never fired on it. The exact 7-byte vendor IE
    50:6f:9a:16:03:01:03 now alerts on its own. Field-proven at three
    cameras, absent from two home captures. Also syncs the OUI list
    (SIG_SCHEMA_VERSION 6) and credits DeFlockJoplin.
    Claude-Session: https://claude.ai/code/session_01WuYXhYmtKhnGXdnc8w8xeA
2026-09-13 Add a stationary packet capture for finding unknown signatures
    CMD:CAP:START:<secs> pauses the detector and streams every WiFi frame
    and BLE advert over USB from lock-free PSRAM rings, with a drop counter.
    analyze-capture.py groups random MACs by IE fingerprint on a PC.
    BLE scan window is 40% so it doesn't starve WiFi on the shared radio.
    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
    [analyze-capture.py, ble_serial.cpp, main.cpp, mode_capture.cpp, mode_capture.h]
2026-09-13 Add the Device Finder page: capture, analyze, log, export
    Full-screen page off the header: run a capture, analyze it on the phone,
    log the device (photo + signature + capture) to an encrypted finds DB,
    export an evidence bundle for DeFlock. Photo is saved before GPS so a
    slow fix can't lose it. USB stream is queued and drained per frame,
    which fixes the WebView OOM crash mid-capture.
    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
2026-09-13 Site Survey: fingerprint the Flock IE, then break it
    The 50:6f:9a:16:03:01:03 IE that looked like the modern Flock tell does
    not survive contact with our own captures, so it goes back to being a
    tightener on the listed-Flock-OUI wildcard probe (rule "Flock probe +
    IE"), the way upstream uses it. selftest.js fails if a standalone
    liteonSig gate returns.
    What the captures showed:
    - 9 of the 10 strongest lot devices matched the survey OnePlus's own
    14-tag probe fingerprint; disconnected on the bench it rotated through
    13 random MACs in two minutes.
    - The exact 7-byte IE also rides AzureWave, China Dragon and Shiyuan
    WiFi modules, one of which a bench survey flagged as a camera.
    So Site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
    [analyze-capture.py, mode_watchers_watch.cpp]
2026-09-13 Site Survey: ask for Bluetooth off too before a capture
    The survey phones' own BLE adverts (Google FEF3/FCF1 service data) show
    up in every capture, home and lot alike, at arm's-length strength. So
    the pre-capture prompt now asks for Bluetooth off on every phone every
    time, and for WiFi as well unless the phone is connected to WiFi. The
    board is on the cable, so it doesn't need Bluetooth.
    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
2026-09-13 Save logged photos, and list every survey in the Survey log
    b64() spread the whole encrypted photo into String.fromCharCode(...),
    which overflows the call stack from about 0.5 MB up, so a real camera
    photo could fail to save behind a brief toast. It now converts in 32 KB
    chunks, and photoRoundTrip round-trips 3 MB so a regression fails the
    self-test. Export used the same helper.
    Verified on the phone: Log this device wrote the encrypted photo and
    its log entry with GPS, and Export produced a valid JPEG, cameras.csv,
    cameras.osm and the linked capture.
    The Survey log now lists every .sscap on the phone, newest first, read
    straight from the files (no PIN to view, nothing new stored). Tapping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
2026-09-13 Ask what a logged device is, and never call Flock on the IE alone
    Log this device is now three buttons: Flock / ALPR camera, Other
    camera, Not sure. Only a confirmed camera with a GPS fix becomes a node
    in cameras.osm (surveillance:type=ALPR or camera); Not sure stays in
    the CSV and the log, so a guess never lands on OpenStreetMap. The
    choice survives the camera-restart path and falls back to Not sure.
    categoryOf() now tests ALPR before body cam, like the firmware, so
    "ALPR / Camera" finds no longer paint as body cams.
    The on-phone analyzer used to flag any device carrying the
    50:6f:9a:16:03:01:03 IE, and a China Dragon Technology module at the
    bench (public MAC, -77 dBm, wildcard probes) s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
2026-09-13 Decode Bluetooth Remote ID from the right byte, and prove all three paths
    A real BT4 Remote ID advert is UUID 0xFFFA, app code 0x0D, a 1-byte message
    counter, then the 25-byte message. The detector skipped the app code but decoded
    from the counter, so every field of a real drone came out a byte off. Presence
    still alerted, so the beep looked healthy, and the bench emitter sent a bare
    message with no app code or counter, which hid it. Decode now starts at
    offset + 6, and selftest pins it.
    The channel hopper also gives a channel that just carried Remote ID one extra
    dwell, never two in a row.
    Bench-verified with an emitter using real BT4 framing plus new Wi-Fi beacon and
    NAN personas built b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
    [mode_watchers_watch.cpp]
2026-09-13 Theme setting: persisted on the board, picked from the Alerts sheet
    Claude-Session: https://claude.ai/code/session_015h1F5TCSxsLbap8hnjLh6v
2026-09-13 Themes recolour the finished LED frame; Party drifts, Night Ops dims
    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
    [hardware_manager.cpp]
2026-09-13 Themes scale buzzer pitch, Party gets its own jingles, a new theme previews
    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
    [hardware_manager.cpp]
2026-09-13 Themes: One LED and flashes stay Classic, honest Party note
    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
2026-09-13 Rename two themes: Phosphor -> Terminal, Ice -> Glacier
    "Ice" reads as ICE, which this project does not want to be associated with
    in any way, so the word is gone from the labels, the ThemeId enum, the app's
    THEMES array and the swatch classes. Ids are unchanged (2 and 3), and the
    board stores the number, so a board already set to either theme keeps it.
    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
2026-09-13 Changelog: LED + sound themes
    Records the themes feature as the public design record: what each theme
    does, why the recolour runs on the finished frame and pitch lives in
    buzzerTone(), the One LED / flash / Classic exemptions and the review
    finding behind them, and the known edges we accepted.
    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
2026-09-14 C5 capture experiment: env:c5 builds the packet capture for the XIAO ESP32-C5
    A cheap experiment before any full port: only Site Survey's capture runs on
    the C5, speaking the same CMD:CAP:* USB protocol, so the app is unchanged.
    - env:c5 / env:c5_24 (2.4 GHz only, for the side-by-side with the S3) on the
    Seeed platform, Arduino core 3.3.7, NimBLE-Arduino 2.x. c5_capture_main.cpp
    is its own main(), excluded from every S3 tier.
    - mode_capture.cpp: C5-only guards for the NimBLE 2.x scan callback, no core
    pinning (single core), a 2.4 + 5 GHz hop list, country code + band mode.
    S3 preprocessed source is token-identical to main; the tier1 image differs
    only in the embedded ELF sha256 an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
2026-09-15 C5 capture: drop frames the driver reports as failed (rx_state != 0)
    The C5's promiscuous callback delivers frames that failed reception; the S3
    never did. On the bench they were random bytes -- every type/subtype including
    reserved type 3, and ~3300 "unique" WiFi transmitters in a home where the S3
    beside it saw 37. Filtering on rx_state removed 3746 frames in a 5-minute
    capture, after which the frame-type mix matches the S3's.
    Rejected frames are counted and reported as "bad" in the C5's capture stat
    line. S3 path unchanged: tier1 differs from the baseline image only in the
    embedded ELF sha256 and the image trailer.
    Claude-Session: ht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
    [mode_capture.cpp]
2026-09-15 C5: detector builds on the XIAO ESP32-C5 (NimBLE 2.x, pins, single core); S3 unchanged
2026-09-15 C5 detector: measured dual-band hop, BLE 25/50, failed-frame drop, 5 GHz hunt parking
    [c5_radio.h, mode_watchers_watch.cpp, mode_watchers_watch.h]
2026-09-15 C5: persisted Wi-Fi band select ({"band":N}) with an app control painted from the device
2026-09-15 C5 capture: fix two misleading comments (S3 scan-window rationale, dangling report pointer)
    [mode_capture.cpp]
2026-09-16 Changelog: XIAO ESP32-C5 dual-band detector and band select
2026-09-16 C5: warn when 5 GHz enable fails, tighten the selftest guards, honest changelog provenance
    [mode_capture.cpp, mode_watchers_watch.cpp]
2026-09-16 C5: make the 5 GHz-enable warnings actually print (CORE_DEBUG_LEVEL=0 compiles ESP_LOGW out)
2026-09-16 README: two supported boards, C5 tagline, honest install paths
2026-09-16 App: connecting and capturing recover on their own
    - USB: the plugin's requestPermission reports granted:false on Android 12+
    (FLAG_IMMUTABLE strips the extra), so OK read as "denied" and connect
    stopped. Ask UsbSerial.hasPermission instead.
    - Back minimizes instead of exitApp(): finishing the Activity left the BLE
    link and USB port alive under a page that showed "disconnected", with the
    board no longer advertising and nothing to pick.
    - reconcileConnection initializes BLE before querying, then reconnects and
    resubscribes to a link the OS still holds.
    - Capture start watchdog: resend CMD:CAP:START once after 5 s of silence,
    then stop and delete the header-only file.
    - A USB strea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
2026-09-16 App: drain USB with the screen off, drop stale chunks on disconnect
    rAF never fires on a hidden page, so a phone on the cable with the screen
    off queued every chunk unread and decoded the backlog in one frame on wake.
    A hidden page now drains on a timer. teardownUsb empties the queue so a
    late drain cannot repaint the disconnected strip with the old board's
    alert count. The Site Survey miss text now says which board hears 5 GHz.
2026-09-16 Flasher and install.py: ship the XIAO ESP32-C5
    The manifest gains an ESP32-C5 build (bootloader at 0x2000) so the one
    Install button flashes either board. install.py asks the chip which board
    it is, --board overrides and a mismatch aborts, and --from-dir installs a
    local build. test_distribution.py pins manifest, partitions.csv, install.py
    and the flasher version to each other.
2026-09-16 flash.py: --board c5 builds with its own PlatformIO core dir
2026-09-16 C5: pin platform-seeedboards to the bench-proven commit
2026-09-16 CI: build and publish the C5 image beside the S3
    Site assembly moves into site/assemble.sh so CI and the bench build the same
    tree. The C5 builds in its own PlatformIO core dir after the S3 images are
    staged (switching core dirs wipes .pio/build). The distribution contract runs
    first, and every run uploads the assembled site as an artifact.
2026-09-16 Docs: the C5 is installable; wiring for both boards
2026-09-16 install.py: honest errors for missing esptool, missing files and artifact installs
    [install.py, test_distribution.py]
2026-09-16 Install tidy-ups: esptool 5 command names, local build title, pipefail-safe find
    install.py uses chip-id/write-flash on esptool 5 (old names on 4), so no
    deprecation warning. --from-dir finds the site manifest one level up.
    assemble.sh uses find -print -quit instead of | head -1 under pipefail.
2026-09-16 Misc: honest lost-updates badge, favicon, per-run 5 GHz warning, analyzer MAC counts
    - app: boot-banner lines no longer count as dropped telemetry, counters reset
    per link; link the favicon (cold start 404'd on favicon.ico)
    - C5: the 5 GHz-rejected warning latch is per detector run, not per boot
    - analyze-capture.py: per-band MACs from mgmt/data frames, no multicast,
    channels in range (torn payloads were inflating counts)
    - install.py: missing-APK error names the folder
    [analyze-capture.py, install.py, mode_watchers_watch.cpp]
2026-09-16 App: band and channel chip on Wi-Fi rows
    Ingests the firmware's per-target Wi-Fi channel ("ch") and shows a
    2.4G/5G · ch N chip next to the radio badge. A push that omits the
    channel (older firmware, a BLE sighting of a dual-radio device) keeps
    the last known value instead of blanking the badge.
2026-09-16 App: real DOM test for grouped rows, hunted-outline on non-lead, fixed band-chip order
    - groupRendersOnce/groupExpands now capture real rendered HTML (a
    temporary getElementById swap for 'targets-list' only) instead of
    being a no-op under selftest.js's null-DOM stub; adds
    groupHuntedOutline and groupHuntNoToggle.
    - rowHtml gains a forceHunted param so a group row gets .hunted when
    the hunted MAC is a non-lead member, not just when it happens to be
    the lead.
    - The expand/collapse toggle button is not rendered while a hunt holds
    the group open (the toggle would do nothing while hunted forces it
    open).
    - Extra band chips are always 2.4-then-5 (Object.keys order on the
    byBand map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
2026-09-16 Wiring diagram for the XIAO ESP32-C5
    Same harness as the S3 page with the C5's GPIOs (D1 = GPIO0, D2 = GPIO25, BOOT = GPIO28), a dual-band antenna step, and a first-power-up check for GPIO25 as a likely strapping pin.
2026-09-16 Firmware: band chip channel from the AP's DS Parameter Set
    rx_ctrl.channel is the hopper's tuned channel, not the transmitter's --
    2.4 GHz adjacent-channel leakage means an AP on 6 is routinely heard
    while tuned to 4-8, so the band/channel chip lied. Capture the DS
    Parameter Set IE (id 3, elen 1) in the existing IE walk and prefer it
    for wifiCh; probe requests carry no DS element and keep
    rx_ctrl.channel (band is still right). Add a selftest regex pinning
    the DS Parameter Set read.
    [mode_watchers_watch.cpp]
2026-09-16 App: chip classes chan/nradios, not band/radios
    The band tabs (.band, display:flex) and the radio tab strip (.radios, display:grid) already own those class names, so the new chips stretched full width on the phone. Selftests pin the new names.
2026-09-17 C5 wiring page: the buzzer on D2 does not block boot (bench-checked)
2026-09-17 Mirror the hunt frame to USB
    The 3/s hunt frame went out over BLE only, so a cable host saw hunt RSSI at the 1 Hz push rate. Bench: 0 frames over USB before; 2.1/s S3, 1.3/s C5 after. Selftest pins the mirror.
2026-09-17 Offer Ring only on devices that advertise Immediate Alert
    Ring writes the standard Alert Level characteristic, which only Find Me /
    Proximity keyfobs have. The button sat on every Bluetooth row, so on
    AirTags, Tiles and phones it could never work. The detector now flags
    devices advertising 0x1802 or 0x1803 and sends "ring":1 on those rows;
    the app shows the button only there.
    performRing() hardcoded a random address type, so public-address keyfobs
    failed before the write. It now uses the type it heard, and reports
    {"ring":"<mac>","ok":bool} so the app's toast says what happened instead
    of an unconditional "Ring sent".
    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
    [mode_watchers_watch.cpp, mode_watchers_watch.h]
2026-09-18 Stop the C5 leaking heap for every scan result it sees
    NimBLE 2.x keeps every scan result by default (0xFF) and only clears
    them when a scan completes. The detector's scan runs continuously, so
    it never completes, and every rotating random MAC added an entry that
    was never freed.
    Measured over a 5 h 20 min soak sampling MALLOC_CAP_INTERNAL once a
    minute: 96.0 KB -> 71.0 KB free, still falling linearly, with the
    tracked-target count steady at 57-88 the whole time. With
    setMaxResults(0): 94.1 KB at 18 min against 91.2 KB for the old build
    at the same point. Scan responses still merge, so name matching is
    unaffected.
    Note esp_get_free_heap_size() includes 8 MB of PSRAM and hides this
    entirely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
    [mode_watchers_watch.cpp]
2026-09-18 Apply the scan-result cap to the S3 as well
    setMaxResults(0) landed inside the CONFIG_IDF_TARGET_ESP32C5 branch, so
    the board that actually ships never got it. NimBLE 1.4 has the same
    0xFF default and only clears scan results when a scan completes, which
    a continuous detector scan never does.
    A 17 h 35 min S3 soak: internal heap 187.6 KB -> 78.1 KB, -6.25 KB/h,
    linear, with the tracked-target count flat at 41-44 throughout - so not
    target churn. That is roughly 29 hours to exhaustion in a vehicle. The
    board never crashed during the run, which is what makes a leak this
    steady dangerous: it fails late and silently.
    The same harness measured the fixed C5 at +0.02 KB/h over 11 h 46.
    The C5's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
    [mode_watchers_watch.cpp]
2026-09-18 Keep the screen on for the whole cable connection
    The wake lock was only taken for a capture, and after one screen-off it was
    never re-taken: Android releases it on hide without telling the page, and the
    stale object blocked the re-request. Now it is held from USB/serial connect to
    disconnect, and forgotten on hide so it is re-requested on wake. Bench: 180 s
    capture untouched against a 60 s timeout and a 90 s capture with the screen
    forced off mid-way, both zero sequence gaps.
2026-09-19 Only call it a tracker when Find My says separated
    Apple message type 0x12 comes in two shapes: a 2-byte status ping that
    every iPhone, iPad and Mac emits constantly, and the 25-byte
    offline-finding payload carrying the rotating public key - an item
    findable while separated from its owner. Matching the type byte alone
    called both a tracker, so a rural convenience store reported 22 AirTags
    that were the customers' phones.
    Across 18 bench and field captures: 1095 distinct MACs sent the short
    form, 64 sent the long one. Requiring the 0x19 length keeps the 64.
    The tradeoff is that an AirTag beside its owner sends the short form and
    is not flagged, which is the case where the owner is standing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
    [mode_watchers_watch.cpp]
2026-09-19 Detect Tile, Samsung SmartTag and Google Find My trackers
    Apple was the only finding network the detector knew, so a stalker
    using a Tile was invisible to a device whose whole purpose is finding
    planted trackers.
    These three need no length discriminator like Apple's, because no phone
    advertises them: Tile 0xFEED, Samsung 0xFD5A (registered in offline
    finding) and 0xFD59 (setup). Google FMDN is 0xFEAA service data with
    frame byte 0x40, or 0x41 when the tracker has entered
    unwanted-tracking-protection mode - it is telling us it may be
    following someone, which is the strongest tracker signal we can read.
    Eddystone shares 0xFEAA with frame types 0x00/0x10/0x20/0x30, so the
    frame byte keeps shop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
2026-09-19 Record the measured soak result for the S3 leak fix
    The entry claimed the fix without proof on the S3. A 10 h 35 min soak
    of both boards measured +0.04 KB/h on the C5 (flat) and -0.78 KB/h on
    the S3, an 8x improvement over -6.25, with zero restarts on either.
    The S3's residual drift is real but small: roughly nine days to
    exhaustion instead of 29 hours. Tracked as a follow-up rather than
    presented as fully solved.
    Claude-Session: https://claude.ai/code/session_016ssvBuyCV6chvmsVn2j6eh
2026-09-19 Ask to turn on Bluetooth before opening the picker
    With the radio off, Connect on Android opened an empty device list and
    never said why. Check BleClient.isEnabled() first: raise Android's
    enable dialog, and if that is declined open Bluetooth settings instead
    of scanning a dead radio.
2026-09-19 Point location-off, a refused permission and a cancel at the right fix
    - getFix() checks the system location switch before asking for a fix:
    "Location is off" in the status strip and the settings page opens,
    instead of "Locating..." then "No fix".
    - A "Permission denied" from BLE init opens App info with a toast naming
    Nearby devices; after one refusal Android never asks again.
    - Closing the device picker resets the connect dot quietly instead of
    raising "Native BLE Connect Failed: requestDevice cancelled."
2026-09-19 Say why a board can be missing from the picker
    A board in receive-only, or still connected to another phone, does not
    advertise, so it is simply absent from the list, and the Android picker
    cannot report an empty scan. A standing line under the Bluetooth button
    points at the BOOT tap and the other-phone case.
2026-09-20 Make the camera tab strictly ALPR and mass surveillance
    The Surveillance/camera tab folded in every unrecognised category (the
    `other` bucket) via inLens(), and LENS_MASK.alpr even carried the generic
    beep bit -- so a police-car router or any unlabelled match was listed under
    Cameras and could beep while that tab was selected. The tab is now exactly
    alpr + bodycam; everything else lives under All only, in the list and the
    tab's beep preset.
    SoundThinking/ShotSpotter is named explicitly in both categoryOf() (app) and
    alertCategoryFromName() (firmware) so it routes to the ALPR category rather
    than the catch-all it no longer has. A new selftest check fails if the two
    keyword lists drift, since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
    [hardware_manager.cpp]
2026-09-20 Add Pwnagotchi detection (attack-gear toggle, gzip pwngrid decode)
    Detect a nearby pwnagotchi from its pwngrid advertisement: beacons from
    de:ad:be:ef:de:ad carrying name/pwned-count/grid-version. Rows list under All
    as "Hacking gear" titled "Pwnagotchi '<name>' - <N> pwned" and sound the
    generic alert -- never a camera or tracker tab.
    New persisted toggle {"attack":bool} / CMD:ATTACK:ON|OFF (sweep-st), echoed in
    CMD:CFG and the 1 Hz push, adopted by the app (Settings -> Detection). Off by
    default: attack detection is attack-adjacent and its future rate-based
    detectors (deauth, karma) trip in busy places.
    The pwngrid advertisement is gzip-compressed (confirmed from pwngrid v1.10.3
    source: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
2026-09-20 Add an on-board alert log, read back by the phone
    The detector is headless and often unattended: wired into a car it runs with
    no phone present, and driving you cannot watch the screen, so an alert leaves
    no trace but the alert counter ticking up. The board now records what its
    buzzer sounds to its own LittleFS, and the app reads it back.
    Off by default ({"log":bool} / CMD:LOG:*, persisted in sweep-st, echoed in
    CMD:CFG and the 1 Hz push). Records are fixed 16-byte entries -- time since
    boot, MAC, category, rule index, RSSI -- in a wrapping ring, with a per-log
    rule-name table so editing the signature list later cannot mislabel an old
    log. No position is recorded, by design.
    It had to be t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
    [alert_log.cpp, alert_log.h, ble_serial.cpp, main.cpp, mode_watchers_watch.cpp, mode_watchers_watch.h, read-log.py]
2026-09-20 Fix NimBLE host-task stack overflow on the command handler
    A phone connecting to the board could boot-loop it. The BLE write callback
    (onWrite -> processIncomingCommand) runs on the NimBLE host task, whose stack
    defaults to 4096, and the CMD:CFG reply builds JSON while doing several NVS
    flash reads -- already near the limit. The alert-log command parsing enlarged
    the handler's stack frame (the compiler reserves space for every branch's
    locals, even on the CMD:CFG path that uses none), tipping past the canary:
    connect -> panic (Stack canary watchpoint triggered, nimble_host) -> reboot ->
    reconnect -> loop. It was invisible because the board is normally driven over
    USB, where commands run on l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
    [ble_serial.cpp]
2026-09-20 Replace the header icons with a three-tab bottom nav
    Features outgrew the navigation: the main screen stacked six bands of
    chrome before a single result row, the header carried four icons, and
    ten overlays sat on top of it. The fix is information architecture, not
    a framework -- app.js is behaviour (three transports, the AES-GCM store,
    the capture analyser, the hunt fast path), and selftest.js cross-checks
    every id-anchored selector against index.html, which a rewrite throws
    away.
    Three panels under one shared header, switched by a fixed bottom bar:
    Sweep (live, moving), Survey (standing still, saving) and Settings
    (what you set before you go). Every screen is now one thumb-tap from
    every o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
2026-09-20 Move Alerts into Settings and retire the toolbar
    Sound, lights, theme and the five category rows are things you set once
    before a hunt so you are not fiddling with them in the field -- which
    makes them settings, not a field sheet. CLAUDE.md argued the opposite,
    but that argument assumed Settings was a gear-icon modal three taps
    deep; with a bottom nav it is one tap.
    The markup moves verbatim into a Settings "Alerts" section, so the ids
    (beep-*, sound-modes, led-modes, theme-modes) and their painting are
    untouched: every control still paints solely from device frames via
    paintAlertRows(), and they are still <button>s, not checkboxes, which
    selftest enforces.
    setSoundsSummary() survives and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
2026-09-20 Make recording one act: one Record button on Sweep
    There were two record mechanisms with two switches in one sheet, so
    "am I recording?" had two answers and you could easily be half on --
    board logging with no pin prompts, or the reverse. Both were several
    taps behind a pin icon, inside a scrolling overlay whose only exit was
    a small x.
    Record on the Sweep screen now brackets an outing. Start turns the
    board's alert log on and arms the pin prompt; Stop reads the log back,
    writes the .txt, shows "what you passed", and disarms the prompt again
    -- unless it was already on before the session, which the session
    remembers (wasRecording) so Stop does not switch off something the user
    set themselve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
2026-09-20 Move saved pins into Survey; delete the Pins sheet and header icons
    Pins and logged finds are the same kind of thing -- an encrypted,
    geolocated record of surveillance hardware you chose to keep, behind the
    same PIN -- and the only difference is that one came from driving past
    and the other from standing at the pole with a camera. That is not a
    reason to keep them in two places with two unlocks, which is what made
    the line between the pin sheet and Site Survey impossible to draw.
    Survey now reads top to bottom as one job: Investigate (capture,
    analyse, photograph) -> Survey log -> Saved pins -> Erase. renderPins()
    grew the locked state that openPins() used to paint, so both lists use
    one "U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
2026-09-20 Bookmark the board's live clock when a recording starts
    log_boot/log_secs arrive only in the CMD:CFG reply. The push carries
    just `log` (a bool), and requestConfig() asks exactly once per
    connection -- so logSecsNow was frozen at connect time. Starting a
    recording an hour into a drive bookmarked an hour ago, and Stop read
    back every alert since then, including everything from before the tap.
    It was survivable while Start was a button buried in a sheet; it is not
    now that Record is the primary control on the Sweep screen.
    log_secs is seconds since boot, which is exactly what bootAt (from
    cfg.uptime) already tracks, so the bookmark is recomputed at Start with
    no extra round trip and no new f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
2026-09-20 Record the UI restructure in the changelog
    The public design record for the three-tab rebuild, the unified Record
    button, the Alerts move into Settings, the pins/Survey merge, and the
    two bugs found on the way: a session bookmarking the board's clock as of
    connect rather than as of Start, and "Connecting..." being written to an
    element that was markup-level hidden.
    Also points the empty pins list at Record rather than the deleted
    "Ask to pin matches" toggle it used to name.
    Claude-Session: https://claude.ai/code/session_01WLvmMJkPmai9UU9YJ3c1YM
2026-09-20 Truncate the board name, not the alert count
    On the OnePlus with the default 19-character board name
    ("OUI-SPY-SIGNALSWEEP") the connection line read
    "OUI-SPY-SIGNALSWEE... 51s - 1 ale": both the name and the numbers were
    allowed to shrink, so the alert count was cut mid-word. The count is the
    one item on that line you cannot guess the rest of, so it is flex:none
    and the name takes the ellipsis.
    Verified on hardware: "OUI-SPY-SIGNALSW... - 26s - 1 alert".
    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
2026-09-20 Line the tab bar up with the content column on desktop
    The bar spans the window so it is always thumb-reachable on a phone,
    but at 1440px its three targets were flung to the corners while the
    content sat in a centred 1100px column -- the one thing that read as a
    phone UI bolted onto a desktop. The grid is now capped to the same
    1100px and centred; nothing changes below that width.
    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
2026-09-20 Hide AP/Client until Wi-Fi, split Settings into pages, pair the connect buttons
    Three corrections after looking at the built app on both screens.
    AP and Client are hidden until Wi-Fi is the chosen radio. Five chips at
    rest was too many to read, and the split is meaningless under All or
    BLE. They appear IN the same row rather than a second one, so this is
    not a return to the old sub-row that appeared and vanished with the
    Wi-Fi tab and moved every result below it: the row's height is pinned
    (#radios .radio-tab min-height) and the switch measures 0px of movement
    in the list. The pin is needed because the five-up chips take a smaller
    face to fit 412px, and a smaller face is a shorter line box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
2026-09-20 Fold the UI corrections into the changelog
    Three revisions after seeing the built app on both screens: AP/Client
    hidden until Wi-Fi is picked (with the strip height pinned so nothing
    moves), Settings as an index of seven short pages, and the two connect
    buttons made adjacent.
    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
2026-09-20 Answer the pin prompt for a whole category, and show what the board detects
    Two things the field asks for that the UI made you leave the moment to
    get.
    The consent prompt gains a third answer: "No -- and stop asking about
    trackers". The moment you know you do not care about a category is that
    prompt, and making it a dead end sent you to Settings to say what you
    had already decided. pinMute composes with pinLens rather than replacing
    it: the band tab picks ONE category to ask about, this subtracts
    categories from Everything. Muting drops every queued device of that
    kind too, or you tap through the backlog you just refused. The button
    names the category from a fixed per-key table, never cat.l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
2026-09-20 Record the category pin-mute and the Signatures page in the changelog
    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
2026-09-20 Back walks the UI out before it backgrounds the app
    Back minimized from anywhere, so backing out of Settings > Recording put
    you on the home screen -- the app had one screen as far as the hardware
    button was concerned, and the tabs and sub-pages it grew were invisible
    to it.
    handleBack() answers in the order a person means it: dismiss what is on
    top, then leave the sub-page, then leave the tab, and only then return
    false so the caller may background. The consent prompt is handled by
    name rather than as a generic overlay because it owns a queue -- hiding
    its card without shifting would strand every device behind it. Escape on
    the desktop runs the same chain, so the two agree.
    It still never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
2026-09-20 Add transient LED scene state, and balance the greens
    Every other piece of operator state on this device must survive a power
    cycle -- it is headless, and a board wired into a car loses power at
    every engine stop. This adds the first piece that must do the opposite.
    {"egg":N} takes over the LED bar while it is set, and is deliberately
    built inside out from the rest: it writes no NVS, is absent from CMD:CFG
    and from the 1 Hz push, and expires itself after five minutes while the
    app refreshes it in use. A board that came back from an engine stop still
    in this state would be the headless rule exactly inverted, so the
    firmware's own timeout -- not the app -- is what makes that impossible.
    That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
    [ble_serial.cpp, hardware_manager.cpp, hardware_manager.h, mode_watchers_watch.cpp]
2026-09-20 Answer bulk BLE replies from loop(), not the command router
    The Signatures page loaded nothing over Bluetooth on both the phone and the
    hosted web app, while working perfectly over USB. processIncomingCommand()
    runs on the NimBLE host task via the onWrite callback, and that task cannot
    drain its own notification queue while it is blocked inside our callback: a
    short reply like CMD:CFG slips through in a notification or two, but the
    multi-KB CMD:SIGS readback is ~20 chunks, so the mbuf pool ran dry partway
    and the remainder was dropped with no error on either side. It hid for the
    life of the feature because over USB the same command runs on loop(), which
    is the transport the bench uses.
    CMD: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
    [ble_serial.cpp]
2026-09-20 Release 0.5.0: three tabs, an on-board alert log, transient LED scenes
    The APK only ships on a v* tag, so main had been 41 commits ahead of the
    last Release and install.py --apk-only was still serving v0.4.0.
    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
2026-09-22 Detect Flock's battery, tighten Flock matching, add label-only competitor hints
    A published Falcon firmware dump showed a deployed camera sends nothing we can
    hear; its solar battery ("Penguin") is the only radio on the pole. Detect it in
    code with two facts (full Penguin-<serial> name, or mfg 0x09C8 plus a serial),
    never 0x09C8 or a bare 10-digit name alone (Apple sends "0102000000").
    Drop the standalone 0x09C8 rule (schema v7) and match Flock SSIDs on the
    "flock-" prefix: a substring beeped for a home router named FlockNation.
    Add Genetec (AutoVu/Sharp ALPR) and Ubicquia (streetlight nodes) as OUI-only
    hints (schema v8). OUI alone scores 30, under both the list and beep gates, and
    the ca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
    [mode_watchers_watch.cpp]
2026-09-22 Report the last reset reason in CMD:CFG
    A board that restarts unattended leaves no witness: the boot banner is lost
    while USB re-enumerates, and a backtrace exists only if something was logging.
    CMD:CFG now carries esp_reset_reason() as "reset", and the app toasts once per
    boot when a board's last restart was a panic, watchdog or brownout.
    It paid for itself immediately: a C5 "crash" read reset=11 (USB), caused by a
    killed bench logger dropping DTR/RTS, not the known BT controller panic.
    [ble_serial.cpp]
2026-09-23 Rewrite the wiring guide: optional parts, one wire per pad, chained power
2026-09-23 Push the host clock on connect and date log readback from board anchors
2026-09-23 Redraw both wiring pages: optional parts, RTC, reserved SD, chained power
2026-09-24 Fix RTC-sync review findings: per-board log anchors, resync pairing hole, torn anchor read, 2038 epoch cap
    - app.js: keep board-supplied log-read anchors (o.epochs) in a per-read map
    instead of the global cross-board logBootEpochs, so reading two boards in
    one session can't date one board's records with the other's anchors.
    logWallClock checks the current read's map first, falls back to the
    phone's own per-boot guesses.
    - app.js: close the {time}/CMD:CFG pairing hole -- if a USB-open reset eats
    only the queued time push, the CFG reply still lands and stops the retry
    loop with the board's epoch never set. Resend {time} once per connection
    when the reply reports epoch 0 or clearl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
    [alert_log.cpp, rtc_clock.h]
2026-09-24 Wiring docs: draw the 5-pin DS3231 For Pi module, chain ends at the RTC
2026-09-25 Release the COM port on Web Serial Disconnect
    Disconnect on the desktop Serial transport left the port open until the
    tab closed, so nothing else could open the board. port.close() ran while
    the two pipeTo() pipes still locked the port's streams and threw into an
    empty catch, and the read loop's finally could null serialPort first.
    Take local references, cancel the reader, close the writer, await both
    pipes, then close the port.
2026-09-26 Tighten the Flock SSID rule to Flock- + 6 chars
    fs_ and pigvision were BLE name patterns matched as SSID substrings;
    'Chiefs_Guest' contains fs_, and a Ubiquiti AP logged as an ALPR on a drive.
    [mode_watchers_watch.cpp]
2026-09-26 Wiring pages: add the 3.3 V microSD reader, park the clock
    The SD reader is a bare 3.3 V board (no regulator), pins 3v3/CS/MOSI/CLK/MISO/GND:
    3V3 on its own wire, CS D3, MOSI D10, CLK D8, MISO D9, ground off the LED bar's
    2nd GND pad. The DS3231 is off the drawing; D4/D5 stay reserved for it.
    Claude-Session: https://claude.ai/code/session_019w8UD2GrCYUAZ3iBcUqNWm
2026-09-26 Probe the SD card at boot, report it in CMD:CFG, add CMD:SD:LS/GET/RM
    Card commands only set flags in the router and are answered from
    bleSerialTick(). Selftest's "no startCapture in the router" check is red
    until the next commit defers capture start.
    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
2026-09-26 Fix round 1 for SD commands: separate GET/RM buffers, cap the listing sanely
    - GET and RM had shared one name buffer, read again mid-send by
    bleSerialTick(); a pipelined RM then GET could delete the wrong file, and a
    second GET arriving before the first's send loop finished could switch
    files, or tear a name mid-strncpy. Split into sdGetName/sdGetOff and
    sdRmName, marked volatile like logRead*'s args, and bleSerialTick() now
    copies each into a local buffer before clearing its flag and calling.
    - sendSdList() re-probed unconditionally, which would tear down an
    in-progress capture stream (sdStreamOpen/Write, Task 4) out from under it.
    It now only re-probes when not already SD_OK;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
    [ble_serial.cpp, sd_store.cpp, sd_store.h]
2026-09-26 Fix round 1 for SD captures: sequence the restart before a queued start, reject a busy capture, distinguish card errors, and lock the open capture file
    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
    [mode_capture.cpp, sd_store.cpp]
2026-09-26 App: list, download and delete files on the board's SD card
    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
2026-09-26 Fix round 1 for SD file list: guard the disconnect/timer race, surface RM errors, and cover two UI gaps
    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
2026-09-26 Survey: capture to the board's SD card, over Bluetooth or by choice on USB
    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
2026-09-26 Fix round 1 for Task 6: pin the handleCapStat watchdog-disarm selftest regex
    The [\s\S]{0,400}? loosening would pass with arbitrary code between the
    brace and clearTimeout(capAckTimer). Pin the exact allowed shape: the brace,
    optional comment lines, then the if (!capturing) return; guard.
    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
2026-09-26 Firmware: sync card captures, tell a pulled card from a full one, answer RM on sdrm
    - fail(): SD_FULL only if the card still reports a real size with no free
    MB; a pulled card (total 0) is SD_ERROR and sd_free keeps the last value.
    - The capture drain task flushes and calls the new sdStreamSync() once a
    second, so a pull or power cut leaves the partial file, not 0 bytes.
    - CMD:SD:RM failures reply {"sdrm":{"err":...}} (bad name, busy, no such
    file, card error); success still replies with a fresh sdls.
    - CMD:SD:GET of the capture being written replies err busy (sdIsOpen()).
    - sdNextCaptureName(): one directory pass, max CAPnnnnn + 1.
    - stopCapture() also cancels a queued START; captureT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
    [ble_serial.cpp, mode_capture.cpp, sd_log.cpp, sd_store.cpp, sd_store.h]
2026-09-26 App: check every card download page, honest link-lost and card-status text
    - handleSdGet() counts the bytes that decoded per page (undecodable SDF:
    lines counted too) and re-requests a page whose total doesn't equal
    next - offset, up to 3 times; the file is saved only if the total equals
    the reported size.
    - A link lost during a card capture says the board keeps capturing.
    - No card / card error status suggests a power cycle for a hot-inserted card.
    - Handles {"sdrm":{"err"}} with a "Delete failed" toast.
    - Downloaded logs keep the card's boot number in the file name.
    - sdDownload only repaints the card status while still connected.
    - selftest: sdrm wired both sides, the drain loop syn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
2026-09-26 Firmware: pace bulk card/log replies per line, lock the USB mirror
    A 3.6 KB CMD:SD:GET over BLE lost its last two lines and the done frame:
    ~3 notifications per base64 line, back to back beside the 1 Hz push,
    overflow NimBLE's notify buffers even from loop(). sendSdFile and
    sendAlertLog now pause BULK_LINE_PACE_MS (25 ms) after each line, and a
    card page is 6 KB (8 lines).
    The slower loop exposed a USB race: Serial.println of a 1 KB SDF: line is
    not atomic across tasks, and the push landed inside one (a USB download
    came back 72 bytes long). Replies, the push and the hunt frame now write
    USB through sendUsbLine(), one mutex.
    Claude-Se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
2026-09-26 App: retry lost download pages, resync torn BLE messages, SD UI fixes
    - A card download page whose done frame never arrives is re-asked after
    5 s like a short page (same 3-try cap), instead of failing.
    - BLE reassembler: a notification that opens a known message drops the
    stale partial line first, so a torn push no longer glues onto the next
    reply. BLE only; selftest pins it.
    - Survey intro: captures need the USB cable or an SD card.
    - A card capture started over BLE no longer asks for Bluetooth off (that
    is the link); it says to turn it off after starting, or walk away.
    - A finished card capture hides "Log this device" and the adb pull hint.
    - SD file rows: one-line label, two small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
2026-09-26 Firmware: BLE send backpressure, one-notification bulk lines, honest pulled card
    Root cause of BLE message loss: NimBLE-Arduino's notify() drops a
    notification silently when the host mbuf pool is empty (1.4.3 ignores
    both the NULL mbuf and the notify rc; the S3 pool is 12 blocks).
    sendBleSerial() now sends each chunk via ble_hs_mbuf_from_flat +
    ble_gattc_notify_custom and, on ENOMEM/EBUSY, waits 5 ms and resends the
    same chunk for up to 300 ms, then drops the rest of that message.
    - Over BLE an SDF:/LOG: line fits one notification ((MTU-8)/4*3 raw,
    clamped 48..768; LOG in whole 16 B records); USB keeps 768. A card page
    is SD_GET_LINES (8) lines. BULK_LINE_PACE_MS is now a 5 ms yield.
    -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
2026-09-26 App: ignore stale card-download frames; selftest pins BLE backpressure
    The sdget header resets its page and the done frame is accepted only for
    the current request's offset after this attempt's header, so a straggler
    from a replaced request can't pass or fail a page. Selftest pins the
    notifyChunk retry path, the one-notification line sizing, the "off" echo
    and its app check, the USB-capture busy refusal, the USB line mutex on
    CAP:/capReply/[ALERT], and the pulled-card re-probe.
    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
2026-09-26 Firmware: cap BLE bulk-line size at the 512-byte attribute maximum
    bulkLineBytes() sized SDF:/LOG: lines from MTU-3-5 alone, which at MTU 517
    produced a 513-byte line (4 "SDF:" + 508 base64) -- one byte over what any
    BLE notification can ever carry regardless of MTU headroom. The trailing
    "\n" went out as its own bare notification, and a push landing in that gap
    tore the page (measured on the phone: a clean 2-page CSV alongside a
    capture page that failed 3 retries in a row). Clamp the attribute length
    to a named 512-byte constant before deriving the base64 length from it,
    in both bulkLineBytes() and sendBleSerial()'s own chunk cap. Also updates
    SD_BLE_BYTES_PER_SEC to the measured BLE rate (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
    [ble_serial.cpp]
2026-09-26 Wi-Fi: rule weight on the OUI path, and SSID-prefix rules on beacons and probe responses
    Claude-Session: https://claude.ai/code/session_017wgfyHcKKGpy1sNHfnBUot
2026-09-26 Signatures v9: registry-checked defaults, Axon pairing SSIDs, smart glasses as body cam, Sierra blocks fixed
    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
    [hardware_manager.cpp, mode_watchers_watch.cpp]
2026-09-26 Signatures page shows SSID prefix and rule strength; credit SquachWatch-CYD
    renderSigList() now shows "SSID starts <prefix>" in place of the old
    exact-SSID line, and appends "strength N (beeps)" / "strength N (listed,
    no beep)" per rule so the v9 60-vs-80 weight split reads on the phone
    without opening the JSON box. CREDITS.md and CHANGELOG.md document the
    v9 signature work from this branch (per-rule weight, ssid_prefix, exact
    UUID matching, the Sierra Wireless mislabel fix, the registry pin) and
    credit SquachWatch-CYD for the grading idea, the Axon pairing SSIDs and
    the smart-glasses company IDs. CLAUDE.md (gitignored) got the matching
    Conventions bullet, not staged.
    node app/selftest.js: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
2026-09-26 Signatures: a Wi-Fi partial match never earns a rule's own weight; strength shown for every rule
    A rule's conditions are an AND, but the Wi-Fi OUI loop and SSID-prefix pass
    could only ever check the OUI (or SSID prefix) -- a rule that also stated
    mfg_id/device_name/service_uuid had those BLE-only conditions silently
    skipped, and still got the rule's full `weight` as if every condition had
    matched. Both paths now only apply a rule's own weight when it has no
    BLE-only conditions (falling back to the generic W_WIFI_OUI/W_WIFI_SSID
    otherwise), and the SSID-prefix pass now also requires a stated OUI to match
    the frame's source MAC, not just the SSID.
    Also: moved uuidMatches() (and its comment) a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
    [mode_watchers_watch.cpp]
2026-09-26 Smart glasses: Ray-Ban/Oakley Meta needs Luxottica AND fd5f together
    Two default rules each beeped on a single signal an upstream detector
    found to be a false-positive magnet (Meta's fd5f service UUID is
    plausibly on Meta's own Quest headsets too; the Luxottica company ID
    alone is weak). Replaced with one rule that requires both. Snap
    Spectacles is unchanged.
    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
    [mode_watchers_watch.cpp]
2026-09-27 BLE: wait up to 2 s for mbufs off the host task; bulk replies no longer cut at 12 x 512 B
    The S3 on a phone link frees about one 512-byte notification per ~300 ms
    (bench: single waits up to 493 ms), so notifyChunk()'s 300 ms give-up fired
    on every bulk reply once the 12-block pool filled. CMD:SIGS arrived as
    exactly its first 6,146 bytes and the app discarded it as torn: Settings >
    Signatures never loaded over Bluetooth on the S3.
    The 300 ms bound stays on the NimBLE host task, where the wait cannot be
    satisfied (that task frees the pool); onWrite records the host task handle.
    Elsewhere the bound is 2 s.
    Bench: S3 3/3 and C5 3/3 rule-list loads over BLE complete (73 rules);
    push soak with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
    [ble_serial.cpp]
2026-09-27 Per-device Ignore on the board: persisted, gated before noteAlert, reported in CMD:CFG
    Adds a 16-entry MAC+category Ignore list (sweep-st/ignore, 7 bytes/entry):
    addIgnore/removeIgnore/getIgnoreJson in mode_watchers_watch, a gate in
    noteAlertForTarget() that sits before noteAlert() and never touches
    `alerted` (un-ignoring a still-present device must sound immediately, not
    wait for it to go stale), and the {"ignore"/"unignore"} commands + CMD:CFG
    `ignore`/`ignore_full` fields in ble_serial.cpp. Restore rejects a blob
    whose length isn't a whole number of IgnoreEntry to avoid reading garbage
    MACs after a format change.
    node app/selftest.js still fails on two known items, both owed to Task 7
    (t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
    [ble_serial.cpp, mode_watchers_watch.cpp, mode_watchers_watch.h]
2026-09-27 Ignore list fix round 1: no timed-out empty list, distinct lock-busy code, locked restore
    Fixes from review of the initial Ignore-list commit:
    - getIgnoreJson() now takes JsonDocument& and adds the "ignore" key itself,
    only after the lock is obtained; on a mutex timeout the key is left absent
    (CMD:CFG must never carry an authoritative empty list it didn't actually
    read -- the same trap as buzzerEnabled/hwMutex).
    - addIgnore()/removeIgnore()/getIgnoreJson() guard watchersMutex == NULL like
    the existing public getters, and addIgnore() returns a distinct -3 for
    "couldn't lock" so a momentarily busy detector doesn't toast "list full"
    (ignoreFullOnce is set only on -1).
    - restoreWatch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
    [ble_serial.cpp, mode_watchers_watch.cpp, mode_watchers_watch.h]
2026-09-27 Changelog: per-device Ignore
    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
2026-09-27 Ignore list: stdio-free MAC parse, race-free persist, docs fixes
    sscanf() was on both radio callback stacks via isIgnoredLocked() ->
    parseMacBytes() every time an ignored device cleared the alert-weight
    threshold. Replaced with alert_log.cpp's existing stdio-free
    alertLogParseMac(), added isIgnoredBytesLocked() so addIgnore() no
    longer parses the same MAC twice, and removed parseMacBytes() entirely.
    selftest now fails if sscanf reappears in mode_watchers_watch.cpp.
    persistIgnore() read ignoreList/ignoreCount without the mutex, racing a
    USB command in loop() against a BLE command on the NimBLE host task.
    addIgnore()/removeIgnore() now snapshot the list under watchersMutex at
    the point of mut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
    [mode_watchers_watch.cpp]
2026-09-27 Partitions: a 64 KB coredump slot carved from the end of app0; LittleFS untouched
    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
    [partitions.csv]
2026-09-27 Crash report: no-init breadcrumb plus core dump summary, printed once at boot
    crash_report.{h,cpp}: a 16-byte breadcrumb (uptime, internal heap, target
    count) in __NOINIT_ATTR RAM, ticked from the detector's 1 Hz body, plus the
    ESP-IDF core dump summary, read in setup() right after the banner. Believed
    only after ESP_RST_PANIC / INT_WDT / TASK_WDT / WDT and only with a valid
    magic and plausible values; printed once as a [CRASH] line on USB.
    Differences from the plan, from the headers on each toolchain:
    - .noinit is NOLOAD internal SRAM on both chips (verified in both
    sections.ld and in both ELFs), so __NOINIT_ATTR is portable as planned.
    - The summary is static, not a stack local: 220 B o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
    [crash_report.cpp, crash_report.h, main.cpp, mode_watchers_watch.cpp]
2026-09-27 Crash report: no stale dump on RTC WDT, image check, honest breadcrumb
    Review fixes for the crash report:
    - ESP_RST_WDT is still a crash, but the core dump summary is not read for
    it: an RTC-watchdog reset writes no dump, so the partition holds an older
    crash's. dump=0, task ?, pc 0.
    - esp_core_dump_image_check() (declared on both toolchains) gates the
    summary; anything but ESP_OK is "no dump". Known gap, in a comment: a
    panic whose dump write failed leaves the previous valid image.
    - The breadcrumb magic is cleared at init and set by the tick after the
    fields, so a crash before the first tick reports up=? instead of up=0 as
    measured; crashReportToJson() omits up/heap/tgt then. t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
    [crash_report.cpp, crash_report.h, mode_watchers_watch.cpp]
2026-09-27 Report the last crash in CMD:CFG and on the Device page, with a copy button
    Claude-Session: https://claude.ai/code/session_01M2wYV1jkbhK4pCrdTUQn7h
    [ble_serial.cpp]
2026-09-27 Crash report: reset-reason line, torn-write clamp, barrier, unknown SHA
    App: crashText() now leads with the reset reason (panic/interrupt
    watchdog/task watchdog/RTC watchdog) alongside the existing task/uptime/
    heap detail, reads "<1 min" for a sub-minute uptime, and "no details"
    when both the task and the breadcrumb are missing. lastCrash carries
    cfg.reset alongside cfg.crash so the line and the Copy JSON both have it.
    Firmware: crashBreadcrumbTick() now clamps tgt to 9999 on write (not
    just on the read-side sanity check), so a torn unlocked read of the
    non-volatile breadcrumb can't push tgt past the check and discard a
    good up/heap along with it. A compiler barrier goes in immediately
    bef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
    [crash_report.cpp]
2026-09-27 Bench crash hook: __builtin_trap(), not a store to NULL
    The C5 accepts a store to address 0 silently (nothing guards it), so
    CMD:CRASH never crashed the C5 -- found on the bench. An illegal
    instruction panics on both chips with the PC inside sweepCrashTest().
    Bench-only, behind SWEEP_CRASH_TEST.
    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
    [main.cpp]
2026-09-27 Changelog: crash report and the coredump partition
    Document the new 64 KB coredump partition, the no-init breadcrumb plus
    core dump summary in crash_report.cpp, the CMD:CFG/app Device-page
    surface, and the C5 NULL-store bench trap; credit SquachWatch-CYD for
    the idea alongside the existing per-device ignore entry.
    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
2026-09-27 Crash report: the C5 names the panic (assert/abort message) as `reason`
    On an abort() or failed assert -- the C5's bt.c:562 Bluetooth panic is one --
    the saved PC and ra both land in IDF's panic_abort, so the C5 report could not
    say which assert fired. IDF 5 keeps the panic message in the dump; read it with
    esp_core_dump_get_panic_reason() into a static 96-byte field, print it on the
    [CRASH] line, and send it as `reason` in CMD:CFG (absent on the S3, whose IDF 4
    has no such call). The Device page appends it to the Last crash line.
    Bench (C5): bench-only CMD:ABORT -> reason "abort() was called at PC
    0x4200884d on core 0"; that address decodes to the calling line in loop(),
    the saved PC to pa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
    [crash_report.cpp, main.cpp]
2026-09-27 Attack toggle gates every "Hacking gear" rule on BLE, Wi-Fi OUI and SSID paths
    ruleGatedOff() skips a rule whose category is HACKING_GEAR_CATEGORY while
    Attack is off, read live on every advert/frame. The pwnagotchi detector now
    uses the same constant. Selftest pins all three rule paths and that the
    category contains no routing keyword.
    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
    [mode_watchers_watch.cpp]
2026-09-27 Signatures v10: Flipper Zero and Pineapple/deauther rules under Hacking gear; company-ID registry pin
    Flipper Zero service UUIDs 3081/3082/3083 (80), Flipper Devices company ID
    0x0E29 and OUI 0c:fa:22 (70, registry-checked), a "flipper" name (60, listed
    only), Pineapple_ management AP (70) and the ESP deauther's "pwned" SSID (60,
    listed only), all matched only while Attack is on. Selftest now pins every
    default company-ID rule to bt-company.txt (Flipper, Luxottica, Snap) and
    refuses the bogus 0x0FBA / 80:E1:26-27 "Flipper" values.
    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
    [mode_watchers_watch.cpp]
2026-09-27 Attack gear: Detection page text, changelog and credits
    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
2026-09-27 Attack gear: honest Flipper address wording; Signatures page says the rules need Attack on
    Final-review fixes. 80:E1:26/27 is ST's STM32WB address derivation --
    reportedly what a real Flipper Zero uses, shared with other STM32WB hardware
    -- not an "unregistered" value; 0c:fa:22 is an unproven registry hint on a
    Zero. The Signatures page note for "Hacking gear" rules now says they apply
    only while Attack-gear detection is on (ruleStrengthNote, self-tested), and
    the changelog says toggling stops new matches (listed rows go stale as usual).
    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
    [mode_watchers_watch.cpp]
2026-09-27 STM32WB address 80:e1:26/27 lists as a Flipper-like hint (60, Attack only)
    A Flipper Zero reportedly builds its BLE address from ST's STM32WB
    derivation (80:E1:26/27...), which other STM32WB hardware shares. Listed at
    60 (no beep), gated by Attack like every Hacking gear rule, and named for
    what the signal proves -- "STM32WB address (Flipper Zero uses this)", never
    "Flipper". In no IEEE registry: selftest allowlists exactly these two, with
    the reason, and fails if either is renamed Flipper or raised to beep.
    Folded into v10 (unreleased). User decision 2026-09-27.
    Claude-Session: https://claude.ai/code/session_01M2wYV1jkbhK4pCrdTUQn7h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
    [mode_watchers_watch.cpp]
2026-09-27 Attack detectors: pure window/LRU logic + host C++ tests wired into selftest
    DeauthState's LRU eviction picks the slot with the smallest raw lastSeen
    rather than the largest (now - lastSeen): that subtraction assumes now
    never precedes a stored lastSeen, which breaks across independent
    transmitters and evicted the genuinely active burster in
    test_deauth_lru_keeps_active_burster.
    selftest.js shells out to firmware/test/run.sh through WSL on Windows
    (no g++ on the native PATH here) and plain bash elsewhere; missing
    compiler warns and skips rather than failing silently.
    Claude-Session: https://claude.ai/code/session_01M2wYV1jkbhK4pCrdTUQ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
    [attack_detectors.h]
2026-09-27 Attack detectors: revert deauth LRU to wrap-safe age, fix backward-time test
    Review round 1: `now` is the firmware's monotonic millis(), so the
    brief's (uint32_t)(now - lastSeen) eviction age was correct all along
    and IS the wrap-safe form (matches karmaNote's eviction). My prior
    raw-lastSeen compare was a wrap regression -- right after a millis()
    wrap it would evict the just-updated slot instead of the stale one.
    The real defect was in test_deauth_lru_keeps_active_burster, which drove
    time backward across transmitters (an input millis() never produces).
    Rewritten to a strictly monotonic timeline that still proves an active
    burster survives eviction.
    Also fixed the same raw-compare antipat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
    [attack_detectors.h]
2026-09-27 Karma/PineAP detector: one BSSID answering probe responses for >=4 distinct SSIDs, Attack toggle only
    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
2026-09-27 BLE popup-spam detector (distinct random MACs sending 0x07/0x0F)
    WatchersScanCallbacks::onResult now counts distinct random-address MACs
    sending Apple Proximity Pairing (0x07) / Nearby Action (0x0F) manufacturer
    data within a 5 s window (bleSpamNote from attack_detectors.h) and, at
    >= ATTACK_BLESPAM_THRESHOLD, surfaces a sentinel "BLE popup spam" row via
    upsertAttackTarget. Gated on !pubAddr so real, address-stable Apple gear
    (AirPods etc.) never trips it, and on attackDetect (Attack toggle only).
    Keys on a hash of the MAC string (attackHash on the already-uppercased
    String), not raw NimBLE address bytes, to sidestep the 1.4-vs-2.x address-
    accessor/byte-order difference between the S3 and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
2026-09-28 C5 pwnagotchi gzip: vendor MIT tinfl (inflate only), C5-gated; S3 keeps ROM tinfl
    The C5's IDF-5.x ROM dropped miniz, so mode_watchers_watch.cpp's gzip path
    (pwngrid IE 222 decode) only worked on the S3, which still gets
    tinfl_decompress for free from esp32s3.rom.ld. Vendor just the tinfl_*
    inflate half of miniz (MIT, richgel999/miniz) into
    firmware/src/vendor/miniz_tinfl.{h,c} -- no deflate/compress, no
    zip-archive code -- self-contained (inlines the small mz_uint8/MZ_* types
    and platform-endian config the split upstream source needs, so there is
    no third vendor file and no dependency on miniz_export.h, which upstream
    generates via CMake). The .c body is wrapped in
    `#if defined(CONFIG_IDF_T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
2026-09-28 Docs: attack detectors (deauth/karma/BLE-spam) + C5 pwnagotchi gzip
    Update the Detection settings note in app/index.html to reflect that
    deauth bursts, karma/PineAP and BLE popup-spam detection ship now
    (previously said "later"). Add a CHANGELOG entry covering the three
    rate detectors, their thresholds and rationale, the shared pure
    attack_detectors.h header + host C++ tests, the callback-thread
    ownership rule, why evil twin was not shipped, and the C5 vendored
    MIT tinfl for real pwnagotchi gzip decoding.
    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
2026-09-28 Deauth threshold 10 -> 30 after the store false-positive soak
    A grocery-store soak (2026-09-28) logged 11 deauth false alarms from
    ordinary access points at 11-24 frames per 5 s; karma and BLE spam were
    clean. 30 sits above that peak and far below a real flood. The ring grew
    24 -> 64 with a static_assert that it exceeds the threshold (at 30 the
    old ring could never count high enough). Test times now follow the
    threshold so the clock never steps back, and the wrap test really
    crosses the wrap. Bench: synthetic burst still fires on S3 (39) and C5 (31).
    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
2026-09-28 Release 0.6.0: attack-gear detection, SD card, clock, crash report
    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
2026-09-28 Signatures v11: Flock battery GATT services as exact 128-bit UUIDs
    From the SquachWatch completeness pass. The Flock solar battery hosts
    auth e8ccbb38-... and safety 20c944c1-...; Flock's own 128-bit UUIDs, so
    they beep at 80. Only a battery whose link to the camera dropped shows
    them (0 in 173 captures). First 128-bit defaults, so the full-UUID path
    was bench-proven first: a temporary Nordic UART UUID rule matched the
    other board on the S3 (NimBLE 1.4) and the C5 (NimBLE 2.x), conf 80.
    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
2026-09-28 Tag flood: wire per-type flood gate into the BLE callback
    Always on, category Tracker. A flooded type's targets stay listed but skip
    noteAlertForTarget; one sentinel row alerts instead. Sentinel rows get no
    Hunt/Ring/Ignore buttons in the app.
    [mode_watchers_watch.cpp]
2026-09-28 Tag flood: review fixes -- stale ring, repeat keys, log, pin prompts
    - Evidence is dated when an address went quiet (last + 30 s), not when the
    lazy sweep noticed; fakes left in the ring after a flood re-tripped the
    gate hours later and muted the first real tag (seen on the bench: the
    real Tile kept the Tile flood alive).
    - One address counts once per 5-min window, or a weak real tag heard every
    ~40 s counted on every gap and tripped a false flood.
    - Sentinel rows (Tag flood, BLE popup spam) now reach the flash log and card
    under 02:00:00:00:00:00, named by the row.
    - The app offers no pin for sentinel rows, nor for trackers while a flood
    row is live.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
    [attack_detectors.h, mode_watchers_watch.cpp]
2026-09-29 Buzzer volume: Low / Med / High as LEDC duty, persisted
    {"vol":0..2} sets the duty every sound plays at (High = the old 50 %
    tone() sound, the default). Saved in sweep-bz/vol, echoed in CMD:CFG and
    the 1 Hz push, painted by a device-authoritative picker in Settings >
    Alerts. buzzerTone()/buzzerOff() now drive LEDC directly: tone() queues
    each note to a task that always writes 50 %, so it cannot carry a volume,
    and owning the channel from boot retires the lazy-attach noTone() trap.
    ledcWriteTone() writes 50 % itself, so the duty write follows it;
    selftest pins that and bans tone()/noTone() in hardware_manager.cpp.
    Bench: both boards, levels confirmed by ear, zero LEDC errors muted,
    level sur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
    [ble_serial.cpp, hardware_manager.cpp, hardware_manager.h, mode_watchers_watch.cpp]
2026-09-29 Release 0.7.0: tag-flood collapse, buzzer volume, Flock battery UUIDs
2026-10-01 Release 0.7.1: every toggle is a sliding switch that shows its state
    The on/off controls each used different wording: the Sweep filter read
    "Matches only"/"All devices", the radios "Scanning"/"Paused", and
    Receive-only showed the action ("Go quiet") rather than the state. They
    are now one standard: the row names the thing, and a CSS sliding switch
    on the same device-painted button shows On (green, knob right) or Off
    (grey, knob left). Filter reads "Filter: On" when filtering.
2026-10-01 Simplify the Alerts page: one Sound row, switches for categories
    Sound and Volume were two pickers for one question; they are now one
    row, Off / Low / Med / High (Off / On on firmware that reports no
    volume). Each category is a sliding On/Off switch like the rest of
    Settings, replacing the per-row sound/light chip. One line above the
    list says when Sound and Lights are both off, so rows reading On are
    never misleading. Theme moves below the categories and the prose is
    trimmed. No firmware or wire change.
2026-10-02 Ignore weak adverts in the BLE popup-spam rule (-80 dBm floor)
    A crowd of real AirPods at the edge of range tripped the rule on a drive:
    12 distinct addresses in one 5 s window, nearly all at -90..-97 dBm.
    bleSpamNote() now takes the advert's RSSI and does not count anything
    under ATTACK_BLESPAM_MIN_RSSI. The same capture peaks at 5 with the floor,
    and none of the 164 captures on hand trips it.
    Counting only newly heard addresses was tried against the capture and
    still peaked at 11, so signal strength is the gate. The floor is wrapped
    in #ifndef so a bench build can move it; an S3 built at -20 stayed silent
    against the bench emitter, and both boards trip in under 5 s at -80.
    Co-Authored-By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
2026-10-06 Add data export: pull.html beside the flasher, and pull.py
    Get the board's data off over the USB cable without opening the case.
    pull.html (Web Serial, CSP connect-src 'none', one file) and pull.py
    (pyserial only) both write one folder: alerts.txt and report.html from
    the board's flash alert log, a .pcap per capture for Wireshark, and the
    untouched originals in raw/. The page has a grouped, sortable tick-box
    list, folder or Downloads saving with every failure printed, and a help
    guide. pull.py adds --wipe, --phone and --pcap.
    Card downloads over USB now read a whole 48 KB page in one sdRead():
    a read per 768 B line reopened the file and re-walked the FAT chain
    (~30 ms each), 1.94 s of a 2.6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
    [ble_serial.cpp, pull.py, test_distribution.py]
2026-10-06 Detect OUI-Spy's selector AP by its default SSID (rules v12)
    OUI-Spy Unified Blue boots into a mode selector that raises an AP named
    "oui-spy" on a fresh random MAC every boot, so the SSID is the only
    handle. Add it as a default Hacking-gear rule at 70 (lists and beeps
    with Attack on): plenty of boards keep the default name. Bench-proven
    on the S3 against the real board: 70 / Likely, one alert, filter on.
    Claude-Session: https://claude.ai/code/session_01YC5YAMvswkM3Vu7Sf4PE2d
2026-10-06 Split long BLE commands across writes and reassemble on the board
    One GATT write carries one attribute value (512 B), so saving the rule
    set from Edit as JSON over Bluetooth (~11 KB in one write) failed
    outright while working over USB. The app now sends commands over 180 B
    as several acknowledged writes; onWrite reassembles up to the newline
    and routes lines over 512 B from loop(), off the NimBLE host task.
    Bench: 11 KB pushed in 62 writes over a real link, read back over BLE
    with the new rule present, no reboot.
    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
    [ble_serial.cpp]
2026-10-07 Detect OUI-Spy's mode APs by their default SSIDs (rules v13)
    Adds "snoopuntothem" (Detector), "foxhunter" (Foxhunter) and the
    "ouispy-" prefix (PCAP, BLE Sniff) beside the selector rule, all
    Hacking gear at 70. Flock-You WiFi and Sky Spy put nothing on the air,
    so no rule can catch them.
    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
2026-10-07 Drop RTS then DTR before closing Web Serial so Disconnect stops rebooting the board
    The browser opens the port with DTR and RTS asserted and the OS drops them
    one at a time on close; the RTS-high/DTR-low state in between is the ESP32
    USB-Serial-JTAG reset, so every cable Disconnect rebooted the board
    (reset:11, boot counter +1). Clearing RTS, then DTR, before close() means
    the close changes no lines. Verified on both boards in Chrome and Firefox.
2026-10-08 Fix eight UI warts found shooting marketing screens
    The hunt panel offered Ring on an AirTag (now gated on the ring flag like
    the rows), conf 90 wrapped mid-number, a tag flood's summary row sank under
    its fakes, map markers had no labels and popups closed every push, the map
    attribution painted over the tab bar, the native app reported Web Bluetooth
    as unsupported, the map note wrapped onto the Recenter line, and the Ignored
    devices heading touched the theme chips. Each is pinned by selftest.
2026-10-08 Refresh README screenshots and add a second row
    The old shots showed the header icons and status strip that were removed.
    New ones come from the bench rig (filter on, emitter personas, mock location
    in a public park), so no real address, SSID or position is in any frame.
    Adds the alert settings, a tag-flood time-lapse and the cameras lens.
2026-10-08 README: drop two claims that stopped being true, add three features
    "No logs" was false since the alert log and SD session log shipped; both
    are off by default and never record a location, so it says that now. "Found
    an AirTag? Make it ring" was false always: AirTags have no Immediate Alert
    service, and Ring only appears on tags that advertise one. "Doesn't
    transmit" now names the scan requests and the Ring write. Adds attack-gear
    detection, the tag-flood gate and the alert log to What it does.
2026-10-08 Release 0.8.1: what the camera caught
    Eight UI warts found shooting marketing screens, Disconnect no longer
    reboots a USB board, signature rules save over Bluetooth, OUI-Spy mode-AP
    rules (schema v13), and a README whose screenshots and claims match the
    firmware.
2026-10-08 README: lead with the product, one uniform screenshot strip
    Opens like a hardware product page: tagline and badges, one strip of four
    identical phone frames (no per-shot titles), a Get one table for the
    assembled unit and kit (coming soon) beside build-your-own, the beep
    language as a table, features grouped as Detects / Built for the field /
    Private by design, and a spec table for the full C5 build. The six
    single-shot images are replaced by docs/img/strip.png.
2026-10-08 Docs: recommend a dual-band antenna without knocking the stock one
    README, WIRING.md and the flasher page said the C5's boxed antenna is
    2.4 GHz only. Seeed also ships an A-01 antenna that may be dual-band, and
    it read as a dig at them either way. Now it just says why to use one.
2026-10-09 README: a Getting started section, with the flasher up front
    The flasher link and install.py were buried inside Build your own. Getting
    started now sits right after Get one: a big button for the web flasher,
    then clone + install.py for the board and the Android phone. Build your own
    keeps the shopping list and points back up; Getting your data off is its
    own section since it applies to every unit.
2026-10-09 README: a real photo of the cased unit up top
    Placeholder hero until the reshoot: the C5 in its printed case on a log
    beside a pumpkin, bar lit. The app strip moves to its own section.
    Square cut of an unedited original (crop, tone, sharpen); metadata
    stripped.
2026-10-09 README: move The app up, and lead with the web app
    The section sat below the feature list and read as Android-only. It now
    follows Get one and names both ways in: the hosted web app (Chrome/Edge,
    Bluetooth or cable, nothing to install) and the Android APK.
2026-10-10 Release 0.8.2: the list holds still under your thumb
    Every 1 Hz push rebuilt the device list, so with the filter off a push
    landing between touchdown and click moved the row you were aiming at and
    Hunt hit the wrong device. The list now freezes while touched and for
    3 s after a lift or scroll; counts and the hunt panel keep updating, and
    row buttons clear the hold so their own redraw is immediate.
2026-10-10 Wiring: one diagram for both boards, drawn in real wire colours
    The S3 and C5 share every pad and the whole harness; only the GPIO
    numbers differ. Merge the two pages into wiring-diagram.html with S3/C5
    GPIO columns in the pin map and the C5 boot notes carried over.
    Wires are now drawn in the bench colours (red 5V, black GND, white 3V3,
    yellow/green/blue signals; SD data reuses yellow/green/blue), with an
    edge on black and white so both read in either theme. Also drop the
    stale "SD firmware support coming" text: the card is supported.
2026-10-10 Wiring: outline the ground junction dots for dark mode
    The ground palette moved to real black, and the edge outline that keeps
    black and white wires visible on either theme missed .junction, so the two
    dots joining the LED bar's ground pads vanished on the dark background.
2026-10-11 Ignore hardware/: carrier PCB work stays local
    The KiCad carrier board is an unordered work in progress and not
    something a user needs to install or run, so it stays out of the
    public repo like docs/plans/.
2026-10-12 Remove the DS3231 clock, and the optional resistor and capacitor
    SignalSweep's hardware is the XIAO, a passive buzzer, a WS2812 LED bar
    and a microSD reader. The clock module, the DIN resistor and the bar
    capacitor were never part of the build, so they come out of the wiring
    guide, the illustrated diagram and the README.
    The DS3231 driver goes too. rtc_clock becomes host_time, which keeps
    only the phone's {"time"} push with the same 2026..2038 range guard, so
    the alert log and SD log are dated exactly as before. CMD:CFG drops
    `rtc`; the app's Clock line reads from `epoch` alone. D4/D5 are unused
    rather than reserved, and the "C5 + SD on D3 not bench-checked" warning
    is gone: C5 boards run f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
2026-10-13 Beep on an Axon address alone (signature defaults v14)
    The Axon OUI rule (00:25:df) scored 60: listed, never beeped. On a drive
    past a traffic stop the C5 listed two Axon 5 GHz APs and stayed silent.
    Axon gear is police gear whatever the product, so it now scores 70 and
    sounds the body-cam pattern. Schema bumped so stored rule sets refresh;
    selftest pins the weight.
    Claude-Session: https://claude.ai/code/session_01U8iDKcnSNorm9fvz4nnACd
2026-10-13 Sort registry vendors by "could a consumer own this?" (v16)
    Beep alone (70): Genetec (now routed to the Cameras tab as "Genetec
    ALPR"), and new rules for Neology, WatchGuard Video and Digital Ally.
    List without beeping (60): Motorola Solutions, Verkada, Avigilon Alta,
    Axis, Ubicquia, plus two more registered prefixes each for Motorola
    Solutions and Axis. Fleet routers stay at 30. Selftest pins every
    vendor's weight and the tab its category routes to.
    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
2026-10-14 README: bring the device photo back to the top
    The rebrand moved the product photo down to "The full build", so the
    first screen was all phone screenshots and read like an Android app.
    The photo sits under the tagline again, with a caption naming the three
    parts: hardware you carry, open firmware you flash from a browser, and an
    optional app.
2026-10-15 Survey: end a capture the board stopped answering instead of freezing the timer
    A C5 that asserts in its BT controller mid-capture reboots and goes back
    to detecting; the app waited forever for the next stat frame. Any 6 s gap
    in the 1 Hz {"cap"} frames now ends the capture and says the partial is
    on the card (or kept on the phone).
    Claude-Session: https://claude.ai/code/session_01Ae4v4F86f1QLuhaCvDFJUp
2026-10-15 Survey: don't claim a reboot when the board just went quiet
    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
2026-10-15 C5: put loop() under a 30 s task watchdog
    A C5 hung at the end of a Site Survey capture: no output, USB not read,
    dead until power was pulled. The core's TWDT watches no task of ours, so
    nothing fired. A stuck loop() now panics, dumps where it stuck and
    reboots. Bench-only CMD:HANG (SWEEP_CRASH_TEST) proves it: 30.0 s, reset 6.
    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
2026-10-15 Band tabs only filter the view; a tag flood no longer mutes trackers
    Tabs sent a preset beep_mask and set the pin filter with nothing on screen
    saying so: tapping Everything turned muted trackers back on mid-drive.
    Now Settings > Alerts is the only beep control and the stop-asking chips
    the only pin filter. Bench: six tab taps over BLE sent nothing, the board
    kept beep_mask 23.
    The tag-flood gate muted real trackers whenever driving past AirTags
    tripped it. The flood row stays; trackers beep.
    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
2026-10-15 Survey: show the board's card and refresh it when the tab opens
    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
2026-10-15 A fitted SD card logs every alert, whatever the log switch says
    The card log followed the alert-log switch (off by default), so a drive
    with a card in recorded nothing. Bench: log off, power-on boot wrote
    LOG00128 with the alerts, flash ring stayed at 3.
    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
2026-10-15 Pins: "Yes, always" per category, and the fix is taken at first sighting
    A pin taken when you tap Yes lands where you were by then, a block past
    the camera at driving speed; the one-shot fix is now taken when the
    device is first seen and held with the prompt. A fourth answer pins a
    category without asking (store must be unlocked, Record asks for the PIN
    up front; a vague fix or a locked store falls back to the prompt).
    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
2026-10-15 Tag flood counts only addresses heard at -80 dBm or stronger
    Replaying all 178 field captures through attack_detectors.h tripped the
    Apple Find My flood on 8 drives: real AirTags in passing cars, heard a
    couple of times at -81..-99 dBm. With the floor none trips (-85 still
    trips one). Weak adverts still count as hits, so an edge-of-range real
    tag never looks short-lived. BLE popup spam: 0 of 178, unchanged.
    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
2026-10-15 Release v0.10.0 — Pin it where you saw it
    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
2026-10-15 Hunt re-lock seeds the clicker with the fresh RSSI, not -90
    When a hunted target was heard again after silence, the periodic task
    re-locked the geiger at -90 dBm, overwriting the sample the scan callback
    had just written, so the gauge flashed red before the real level. Seed from
    huntLastRssi when it is inside HUNT_SILENCE_MS. Bench: three re-locks seeded
    -32/-33/-8 dBm, never -90.
    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
2026-10-15 Signatures v17: attack-firmware default SSIDs
    Five factory SSIDs read from each tool's own source: Bruce "BruceNet",
    GhostESP "GhostNet", Marauder's "MarauderOTA" updater, the Rick Roll
    beacon-spam list Marauder and Bruce share, and Bruce's "Yell BRUCE for
    Password" spam line. All 70, Hacking gear, Attack-gated. Evil Portal's
    PORTAL placeholder and the generic joke-SSID lists stay out (false alarms).
    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
2026-10-16 Offer Hunt on any stable address, not just trackers
    A field drive listed an Axon body cam on a public BLE address with Ignore
    and no Hunt: the app offered Hunt only on tracker rows or with the filter
    off. The board hunts any MAC, so gate the button on stableMac() -- the same
    test Ignore uses -- keeping trackers and filter-off as before.
2026-10-17 Fix the S3 Bluetooth heap leak and a scan-pause use-after-free
    NimBLE 1.4 with setMaxResults(0) erases a device only after its callback
    fires, which for a scannable advert waits for the scan response; one that
    never arrives stays in the result vector for ever under a continuous scan.
    The S3 now scans in 30 s rounds restarted from the round-end callback,
    which clears them on the host task. Soak: -1.2..-1.9 KB/h BLE-only before,
    +0.49/-0.54 KB/h after, stored-device count capped near 12.
    stop() with maxResults 0 cleared results on the caller's task while the
    host task could be in onResult: 300 USB scan toggles panicked an S3 ~8
    times, 0 with the fix. All scan starts/stops go through bleScanSt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
2026-10-17 Cap the tracked-device list at 400 so a busy road can't exhaust the heap
    A C5 crashed on a drive ~2 min after power-up: the alert-log fopen could
    not create its lock because internal RAM was full. Every device heard was
    held for 2 min with no limit, ~50 B internal each; a bench flood took a C5
    from 58 KB free to 0.2 KB at 1,939 devices. makeRoomLocked() now runs
    before every insert and evicts the least-recently-heard unmatched device,
    never the hunted target or one with a pending log record. Same flood with
    the cap: 400 devices, 40-43 KB free, low 26.3 KB, a real Tile listed in
    67/67 pushes. selftest fails if an insert skips the cap.
    C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
2026-10-17 Release v0.10.1 — Drives all night
    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
2026-10-17 Ship the v1 case STLs and accept ESP32-C5 module variants
    install.py refused an ESP32-C5-N16R8 board because esptool reports it as
    ESP32-C5HR8 and the chip regex required a word break after "C5". A package
    suffix is the same chip; only a following digit (ESP32-S31) is a different
    one. Fixes #1.
    Publish hardware/case-v1 (base, lid, LED diffuser) for issue #3; the rest of
    hardware/ stays ignored. Mark *.stl binary so autocrlf can't corrupt them.
2026-10-17 CI: move actions to their Node 24 majors, pin the runner
    GitHub is forcing the Node 20 actions onto Node 24 and setup-java v4 is
    end-of-life. Bump every action to its current major. Pin ubuntu-24.04 so the
    2026-10-19 ubuntu-latest -> 26.04 switch can't change a release build
    underneath us; move to 26.04 on purpose after a dry run.
    The gh-pages publish authenticates with an explicit token in a fresh repo,
    so checkout's credential-storage changes don't reach it.
2026-10-19 Signatures v18 from the upstream review; keep a drone's serial ID
    Reviewed SquachWatch-CYD, OUI-Spy AXEOFF, Fieldwatch, PorkChop and
    Marauder; every ID checked against the IEEE and Bluetooth SIG registries.
    Removed Flipper Devices 0x0E29 / 0c:fa:22: they flag the BUSY Bar desk
    sign, and real Zeros send neither. Added Axon 0x034D, fc81, fe6b and a
    BWCDEVICE advert detector; BodyWorn, Wolfcom, Reveal Media and FirstVu
    body-cam names; Flock's "Flock Camera" hotspot, "FS Ext Battery" and
    FS-<hex> names (listed only); Iteris and BLIP roadside Bluetooth sensors;
    Tile fd84, Chipolo, DULT fcb2; Meta 0x01AB with fd5f, feb7/feb8 (listed
    only), Snap fe45, Vuzix 0x060C; the PORKCHOP attack-tool AP.
    UU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
2026-10-19 Signatures v19: police gear from fourteen more upstreams
    Second upstream pass (alpr_detector, all-cameras-are-beacons, FlipDeFlock,
    OVERWATCH, Bruce, GhostESP...), every prefix checked against the IEEE
    MA-L/MA-M/MA-S/IAB files and every UUID against the SIG.
    Removed fe6d (University of Tokyo, not Axon) and the feed/fd5a UUID-list
    tracker rules (Skullcandy; bleTrackerNetwork covers both). Added police
    body cams, plate readers, radar and lightbars (70); traffic-tech makers,
    patrol docks, radios, police drone makers, Motorola Solutions BLE and the
    Axon-attributed private block (60); Raven UUIDs back at 60; glasses names
    and HeyCyan; Bruce and GhostESP defaults (Attack only). Meta feb7/feb8 now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
2026-10-21 Match BLE prefix rules on public addresses only
    A random Bluetooth address can start with any vendor prefix by chance;
    a passing device beeped as an Iteris roadside sensor in a driveway.
    The app's vendor lookup already skipped random addresses; the firmware
    matcher now does too. Selftest pins the gate.
2026-10-21 Drop devices from the live list once you have driven away
    The board reported every tracked device until its 2-minute prune, with
    the last RSSI, and the app stamped each report as fresh. The board now
    stops reporting after 30 s unheard and sends `age`; the app dates rows
    from it, fades them after 8 s and drops them at 30 s.
2026-10-21 Release v0.10.2 — Out of sight, off the list
2026-10-24 Tell the user a card must be FAT32
    An exFAT card (Windows' default over 32 GB) fails the mount exactly like an
    empty slot, because both cores ship FatFs with FF_FS_EXFAT 0, so the app
    reported "No card" for a card that was fitted. The SD status now says the
    card must be FAT32. Real exFAT support is roadmapped.
2026-10-25 Signatures v21: Sensys Traffic and Gatsometer speed cameras
    Two traffic-enforcement camera makers from reviewing RocketGod's
    wardrive-go, both checked against the IEEE registry: Sensys Traffic
    00:22:9f (now Sensys Gatso; not Sensys Networks) and Gatsometer 00:18:29.
    Nothing a consumer owns, so they beep at 70 and file under Cameras like
    Redflex. selftest pins weight, routing and registrant.
2026-10-25 Name the Flipper Zero's case colour from its service UUID
    A Flipper advertises one UUID per case colour (3081 black, 3082 white,
    3083 transparent; Wall of Flippers and wardrive-go agree), so the three
    rules now say which instead of "service UUID". Folded into the unpushed
    signatures v21; weight and Attack gating unchanged.
2026-10-27 Point the README and flasher at the store and the new flasher URL
    README links move from b0z0dcl0wn.github.io/SignalSweep to
    flash.signalsweep.net, and the "Get one" table gets prices and a link to
    the signalsweep.net waitlist. The flasher header says where to buy a board.
    Claude-Session: https://claude.ai/code/session_017Mc4LXvFwuGBpwu289iPTD
2026-10-28 Stamp the flasher's manifest version on every build
    The version was stamped only on tag builds, so each push to main
    republished current firmware under the stale 0.9.1 in site/manifest.json.
    Use git describe on every run; the checkout now fetches tags.
    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
2026-10-28 Release v0.10.3 — New address, same beeps
    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
2026-10-28 README: render of the v3 case in place of the old-case photo
    The pumpkin photo showed the earlier, larger case. Swap in the standing
    render of the production CAD, labelled as a render.
    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
2026-10-29 CHANGELOG: pins in the hosted web app stayed at github.io
    The flash.signalsweep.net entry said old links keep working, which is
    true for links but not for browser storage: localStorage belongs to the
    origin, so pins, pin-prompt choices and the paired device saved in the
    hosted web app stayed behind at the github.io address, which now
    redirects and cannot be opened to export them. The Android app is
    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
2026-10-31 Fresh boards: tracker beeps off, flash alert log on
    In a crowd every passing AirTag beeps, so trackers become opt-in in
    Settings > Alerts (beep_mask default 0x17). They are still detected and
    listed.
    A new board with no SD card and no Record tap recorded nothing, however
    much it beeped, so the flash log now defaults on. It still logs only what
    sounded. Boards with saved settings keep them. selftest pins both defaults.
2026-10-31 Release v0.11.0 — Quiet about trackers
2026-11-02 Signatures v22: Fusus, second Cradlepoint block, Luxottica Tristar
    From the 2026-11-02 upstream review, all checked against the IEEE registry.
    Fusus MA-M blocks beep at 70 and route to the Cameras tab, since no consumer
    owns one. Cradlepoint 00:e0:1c matches the weight of 00:30:44. Luxottica
    Tristar lists at 60: the address proves the maker, not the product.
2026-11-04 Publish the v3 case STLs
    Main body, lid and LED diffuser for the carrier v3 board, next to the v1
    case. Only the three STLs are un-ignored; the parametric source stays local.
    Waitlist signups asked for the files to print cases in their own colours.
2026-11-09 Signatures v23: TASER ID squatters, fe6c serial gate, Parrot Remote ID fix
    Fixes:
    - 0x034D no longer flags IDO / VeryFit smartwatches that repeat their own
    address in the payload (port of RF Sentinel's isTaserIdSquatter, GPL-3.0),
    checked in the matcher so pushed rules are covered too.
    - A bare fe6c UUID lists at 60; only fe6c service data carrying a serial
    beeps (70). AxonCadabra's replayed serial X87002FP4 is excluded and
    reported as Hacking gear while Attack is on (OVERWATCH, BSD-3).
    - 90:3A:E6 is Parrot's MA-L, not ASTM; that Remote ID branch now needs
    vendor type 0x0D.
    Added Raven 3101/3102 (60), cited to an all-cameras-are-beacons capture.
    RF Sentinel's ~110 registry-only p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
2026-11-10 CHANGELOG: v23 bench-proven over the air
    Ten crafted cases from a Kali Pi against the C5, checked against the
    board's alert log: the IDO squatter is silent while the same payload
    without a watch tell beeps, fe6c lists bare and beeps with a serial,
    AxonCadabra is Attack-gated, and Parrot 90:3A:E6 needs type 0x0D.
2026-11-11 feat: make brightness its own setting, separate from Lights
    Lights is now Off / One / Bar, and brightness is a separate Low / Med /
    High setting (8 / 20 / 50 out of 255) that applies to every Lights option.
    Night Ops still caps it at Low, except under One.
    {"bri":0..2} sets brightness only. {"led":2} and {"led":3} keep their old
    meaning as Bar + Low and Bar + High, and {"led":4} selects Bar at the
    current brightness. The reported led stays 0..3 (Bar reports 2 at Low, 3
    otherwise), and bri joins CMD:CFG and the 1 Hz push. Brightness persists
    in NVS as "bri"; a board saved without it loads a stored Dim as Bar + Low.
    The rules live in led_brightness.h with host tests in
    firmware/test/led_brig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
2026-11-11 fix: explain Night Ops brightness and name the old-firmware Lights buttons
    Under Night Ops with Lights on Bar, the note under Theme says the bar is held at Low (at Dim on firmware with no bri). On firmware with no bri, the Lights description names Dim and Full instead of Bar.
2026-11-13 Case v3: one lid per LED stick length (54 and 57), drop the buzzer tube
    Generic WS2812 8-LED sticks change outline from batch to batch. The Nov
    batch is 57.25 x 10.5 at 7 mm pitch, so the lid and diffuser are now
    built per stick and named by its length: case-lid.stl / case-diffuser.stl
    become the -54 pair and a -57 pair is added. case-main.stl is unchanged
    and takes either lid.
    The tube under the lid's buzzer hole made no audible difference and is
    removed from both lids.
2026-11-13 Release v0.12.0 — Dimmer switch
2026-11-13 Case v3 lid 57: diffuser slot flush with the pocket wall
    The 57 stick's LEDs sit 2.75 mm from the board edge, so the full-width
    diffuser slot reached 0.7 mm past the stick pocket's wall: an undercut
    the diffuser could not be inserted past. The slot now stops at the wall
    and the diffuser base is trimmed on that side. The 54 parts are unchanged.
